fl4p/o2-probe/hw/plans/README.md

# PCB plans

- [Rev B 86 mm cable-end compaction](../docs/2026-09-12-revb-86-compaction.md) — implemented;
  3 mm shorter than the accepted 89 mm board, with all components, routing and holes retained.

- [Current Rev B schematic and process adaptation](../docs/archive/2026-09-12-pcb-plans/REVB-AISLER.md) — implemented and archived;
 83-component circuit, 20 × 89 mm outline, user trace/spacing/via overrides.

- [Rev B 89 mm power compaction](../docs/REVB-89-POWER-REVIEW.md) — implemented
  review candidate; LDO block on back, power section shortened by 4 mm.

- [Rev B 93 mm tip trim](../docs/REVB-93-TIP-REVIEW.md) — removes another 2 mm
  from the tip; component/slot locations retained.

- [Rev B 95 mm compaction](../docs/archive/2026-09-12-pcb-plans/REVB-95MM.md) — implemented review candidate;
  mechanical acceptance and physical qualification remain open.

- [Optional Rev C heated ring](REVC-HEATED-RING.md) — **deferred, not approved**.
  J5/F3 design, exact recovery revision and unresolved qualification work.
- [Archived earlier PCB plans](../docs/archive/2026-09-09-pcb-plans/README.md).
