fl4p/o2-probe/hw/fab/o2-probe-rev-b-2959d79e8b31d893/plans/README.md

# PCB plans

- [Optional Rev C heated ring](REVC-HEATED-RING.md) — **deferred, not approved**.
  J5/F3 design, exact recovery revision and unresolved qualification work.
- Earlier PCB plans: `docs/archive/2026-09-09-pcb-plans/README.md` in the source repository.
