fl4p/o2-probe/hw/routing/revb-86/evidence/workflow/README.md

# Export calibration evidence

These are byte-preserved receipts and the diagnostic used under `checks/revb-86-workflow/`. To rerun the diagnostic, copy `calibrate.py` back to that directory and invoke it with KiCad bundled Python from the project root. Its relative-path lookup intentionally matches the original execution location. Temporary mutated boards and lifecycle reports belong under ignored `checks/`, not this archived evidence directory.
