fl4p/o2-probe/hw/routing/revb-current/evidence/3v3-neck/README.md

# 3V3D neck completion

Frozen `adapter.py` SHA-256: `c0f79b11af3c90a8fcb7522718119eedc1f7a36ffe16d515e0ccfcd0e3119bbc`.

The rounded slot cap closes the apparent right-edge routing lane. The top-right back-side guard feed also blocked access to the usable neck corridor. The root authorized removal of that redundant feed after establishing the existing bottom bridge between the two front guard rails.

The exact delta removes only B.Cu guard track `1ed5e83e-bc47-4eac-ab25-4dd23013a437` and via `1f373dc5-9473-45cb-aca9-f01226c9c1eb`. All seven front guard tracks, including the original upper feed stub, remain unchanged. The bottom bridge and both bottom vias retain the right rail's connection to the driven guard.

Seven locked 0.15 mm tracks and one locked 0.4/0.2 mm via connect `/3V3D`: from the REF input branch through its open front body corridor to `(115.5,114.4)`, then on B.Cu through `(115.5,115.7)`, `(112.8,115.7)`, `(111.4,117.1)` and `(111.4,119.3)` to the existing `(111.5,119.3)` endpoint. The existing lower supply track remains unchanged. `/+12V_SW` is assigned the right B.Cu lane by the root and is outside this delta.

Full native refill/save DRC with `--all-track-errors --severity-all`: zero electrical/geometric errors and only the pending `/+12V_SW` connection open. `saved-verification.json` confirms persisted retained net names, unchanged pad net mapping, identical front guard track geometry, and one native copper-contact component containing all 29 remaining guard copper objects. The added via overlaps no SMD land. Private-directory footprint-library configuration errors and unrelated warnings are not claimed cleared. The independent reviewer owns final combined thermal/guard coverage approval.
