fl4p/o2-probe/hw/fab/o2-probe-rev-b-0c6dbe69dcaf3f52/o2-probe-drill-report.txt

Drill report for o2-probe.kicad_pcb
Created on 2026-09-09T17:15:23

Copper Layer Stackup:
    =============================================================
    L1 :  F.Cu                      front
    L2 :  B.Cu                      back

Drill file 'o2-probe-PTH.drl' contains
    plated through holes:
    =============================================================
    T1  0.150mm  0.0059"  (236 holes))
    T2  0.200mm  0.0079"  (5 holes))
    T3  0.250mm  0.0098"  (39 holes))
    T4  0.850mm  0.0335"  (6 holes))
    T5  1.320mm  0.0520"  (3 holes))

    Total plated holes count 289

Drill file 'o2-probe-NPTH.drl' contains
    unplated through holes:
    =============================================================
    T1  0.991mm  0.0390"  (3 holes))
    T2  2.200mm  0.0866"  (4 holes))
    T3  3.000mm  0.1181"  (1 hole)  (with 1 slot)

    Total unplated holes count 8
