fl4p/o2-probe/hw/fab/o2-probe-rev-a-fab/o2-probe-drill-report.txt

Drill report for o2-probe.kicad_pcb
Created on 2026-08-24T13:48:19

Copper Layer Stackup:
    =============================================================
    L1 :  F.Cu                      front
    L2 :  In1.Cu                    in1
    L3 :  In2.Cu                    in2
    L4 :  B.Cu                      back

Drill file 'o2-probe-PTH.drl' contains
    plated through holes:
    =============================================================
    T1  0.150mm  0.0059"  (152 holes))
    T2  0.200mm  0.0079"  (81 holes))
    T3  0.250mm  0.0098"  (4 holes))
    T4  0.850mm  0.0335"  (4 holes))
    T5  0.900mm  0.0354"  (3 holes))
    T6  1.000mm  0.0394"  (2 holes)  (with 2 slots, castellated)

    Total plated holes count 246

Drill file 'o2-probe-NPTH.drl' contains
    unplated through holes:
    =============================================================
    T1  0.991mm  0.0390"  (3 holes))
    T2  2.200mm  0.0866"  (4 holes))
    T3  2.410mm  0.0949"  (2 holes))
    T4  3.000mm  0.1181"  (1 hole)  (with 1 slot)

    Total unplated holes count 10
