fl4p/o2-probe/cad/CODEX-REVIEW-2026-09-05.md

## FINDINGS

1. **(c) The flattened Elegoo profile does not retain pressure advance 0.04.** The current JSON contains the Elegoo ID/vendor but no `enable_pressure_advance` or `pressure_advance`. Consequently the emitted G-code says `enable_pressure_advance = 0`; its displayed `pressure_advance = 0.02` is inactive. Orca’s official Elegoo ASA System preset explicitly supplies enable=`1`, PA=`0.04`. Thus the commit message and prompt’s “KEEPING … pressure advance 0.04” are false, and the vendor/ID guard cannot detect this omission. [filament_asa.json:114](profiles/filament_asa.json:114), [plate_1.gcode:103](print/retainer/plate_1.gcode:103), [print.sh:217](print.sh:217), [official Elegoo ASA System preset](https://github.com/OrcaSlicer/OrcaSlicer/blob/8500fcdccaa10b5099ac20d252af3a7c560046f1/resources/profiles/OrcaFilamentLibrary/filament/Elegoo/Elegoo%20ASA%20%40Syste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)

2. **(c) The guards certify a sibling G-code and later upload an unchecked archive; the wipe guard also has a mute button.** `slice` validates `plate_1.gcode`, exits, and a separate `upload` invocation sends `o2probe-*.gcode.3mf` without rerunning or binding the checks. The current loose and embedded G-code hashes match, but that is only true now; replacement or staleness between commands bypasses both new guards. In addition, `WIPE_TEMP="${WIPE_TEMP:-270}"` lets `WIPE_TEMP=250` redefine failure as success. The awk selects the first numeric `M109` anywhere in the whole block, not specifically the command before the first wipe; an unevaluable target is skipped and the later `M109 S140` is read instead. With the default 270 this still fails closed, but `WIPE_TEMP=140` turns that malformed stream green. Missing fields, ordinary wrong values, and an entirely nonnumeric block otherwise fail closed, and exact equality rejects changes in both directions. The commit records manual known-bad runs, but there is no repeatable negative fixture. [print.sh:124](print.sh:124), [print.sh:210](print.sh:210), [print.sh:229](print.sh:229), [print.sh:242](print.sh:242)

3. **(b) The spool guard assumes the declaration matches the physical spool.** That assumption happens to hold given the supplied context, and the success message honestly says “declared loaded.” But the statement that silently swapping the spool “should fail” is wrong: leaving the defaults at Elegoo/OEASAB00 while physically loading something else passes. The guard catches a wrong emitted profile against a declaration; it cannot authenticate the physical consumable. [print.sh:104](print.sh:104), [print.sh:114](print.sh:114), [print.sh:220](print.sh:220)

4. **(c) The failure explanation is a plausible hypothesis, not a supported root cause, and its provenance is wrong.** Orca’s Elegoo ASA base explicitly sets the bed to 90 °C; 80%/3 s are inherited generic ASA cooling values, while 35%/12 s/100 °C are Bambu ASA material-preset values—not “machine-side” settings selected because the P1P is enclosed. The live [Elegoo ASA specification](https://us.elegoo.com/products/asa-filament-1-75mm-colored-1kg) permits 90–100 °C, so effective 100 °C is valid for Elegoo ASA, but not for the reason recorded. The working JSON actually requests 105 °C for hot/textured plates, above both Elegoo’s range and the documented P1P limit; Orca clamps the emitted P1P stream to 100 °C. Elegoo publishes no ASA-specific maximum fan percentage; its [warping guidance](https://wiki.elegoo.com/en/troubleshooting/fdm-printer/edge-warping) only recommends disabling or reducing model/auxiliary cooling for the first 5–20 layers. Moreover, auxiliary fan speed is zero, so changing `close_additional_fan_first_x_layers` is inert. Fan and bed changes are credible remedies, but the failed prints do not isolate them from nozzle/levelling contamination, plate preparation, glue, chamber temperature, or the earlier wrong-spool-profile failure. Actual glue use and chamber temperature are unverified. [filament_asa.json:5](profiles/filament_asa.json:5), [filament_asa.json:69](profiles/filament_asa.json:69), [filament_asa.json:264](profiles/filament_asa.json:264), [filament_asa.json:338](profiles/filament_asa.json:338), [plate_1.gcode:637](print/retainer/plate_1.gcode:637)

5. **(c) The proposed “two-piece” retainer is geometrically at least three bodies and is not zero-bridge printable as described.** Making the annular groove a through-slot disconnects the Ø15.2–17.6 inner wall from the outer gland ring. Worse, the Ø26.5 membrane-seat cut removes everything under that inner wall for the first 0.24 mm, so the inner ring begins as an unsupported island rather than on the plate. The six screws are outside it and provide no registration. A separate inner ring plus outer ring plus cap might be redesigned and assembled, but that introduces another uncontrolled interface; the documented one-gland-ring/one-cap proposal does not follow from the source geometry. The acknowledged cap-interface gap is therefore not the only new error term. The roof plane itself is correctly 0.24+1.76=2.00 mm, and G-code layer 17 spans 2.00→2.12, but the prompt’s 547 count is wrong: the file has 549 linear bridge extrusions, matching the document. [GLAND-ON-THE-BED.md:90](GLAND-ON-THE-BED.md:90), [GLAND-ON-THE-BED.md:98](GLAND-ON-THE-BED.md:98), [membrane_cartridge_common.scad:645](membrane_cartridge_common.scad:645), [membrane_cartridge_common.scad:648](membrane_cartridge_common.scad:648), [membrane_cartridge_common.scad:655](membrane_cartridge_common.scad:655), [o2_probe_head_end.scad:1777](o2_probe_head_end.scad:1777)

6. **(c) The STL/source mismatch is real, and the moved parameter family is identifiable: the stale exports use the former M2.5 fastener geometry.** Assimp reproduces Ø38.70 committed versus Ø37.70 fresh, with identical face/vertex counts and Ø25.80 spigots. More decisively, rendering the current source with `pt_nominal=2.5`, `pt_pilot_d=2.1`, and `m2_clear=2.8` reproduces the committed retainer’s geometry exactly after facet-order normalization: bolt radius 15.55 and flange Ø38.70. Current M2/1.60/2.40 geometry gives bolt radius 15.25 and Ø37.70. The transition was not retained as a committed source revision—the stale STL was committed after the source had already moved—so provenance cannot reconstruct it. [GLAND-ON-THE-BED.md:151](GLAND-ON-THE-BED.md:151), [membrane_cartridge_common.scad:80](membrane_cartridge_common.scad:80), [o2_probe_head_end.scad:207](o2_probe_head_end.scad:207), [o2_probe_head_end.scad:931](o2_probe_head_end.scad:931), [o2_probe_head_end.scad:950](o2_probe_head_end.scad:950)

7. **(a) The squeeze-band arithmetic uses the wrong fitted cord and reverses the asymmetric allowances.** The model does assert 20–30% face squeeze. But Ø17.6 over Ø17.0 is 3.529% stretch, and the source’s own thinning equation gives `2.5×(1−0.035294/2)=2.45588`, not approximately 2.48. The nominal 10-point travel band is therefore 0.24559 mm. Ignoring other tolerances, nominal gap 1.82 permits about +0.1447 mm deeper or −0.1009 mm shallower—not +0.10/−0.15. With the model’s sorted-cord, ring-ID, and membrane tolerances, the actual requirement is tighter still: +0.09395/−0.05291 mm. The comment at `o2_probe_head_end.scad:2278` also reverses these values. Rejecting support remains defensible—indeed the real window is narrower—but the published derivation is wrong. [GLAND-ON-THE-BED.md:128](GLAND-ON-THE-BED.md:128), [membrane_cartridge_common.scad:432](membrane_cartridge_common.scad:432), [membrane_cartridge_common.scad:535](membrane_cartridge_common.scad:535), [membrane_cartridge_common.scad:610](membrane_cartridge_common.scad:610), [o2_probe_head_end.scad:1306](o2_probe_head_end.scad:1306), [o2_probe_head_end.scad:2278](o2_probe_head_end.scad:2278)

8. **(a) The fan formula and old algebra are correct, but the new-setting inference and S86 explanation are not.** Orca 2.4.2 first calculates slowdown, then supplies the stretched layer time to the fan interpolation. The old equation is algebraically equivalent to the source and gives `t=9.857 s`. After changing the slowdown target to 12 s, however, that old 9.857 s cannot simply be reused: the fan calculation sees post-slowdown time. Orca also rounds to an integer percentage before converting it to PWM. Its writer maps logical 34% to `M106 S86`; logical 35% maps to `S89`. Thus S86 is evidence Orca selected 34%, not quantization of a 35% ceiling. [filament_asa.json:66](profiles/filament_asa.json:66), [filament_asa.json:309](profiles/filament_asa.json:309), [plate_1.gcode:6090](print/retainer/plate_1.gcode:6090), [Orca CoolingBuffer.cpp](https://github.com/OrcaSlicer/OrcaSlicer/blob/8500fcdccaa10b5099ac20d252af3a7c560046f1/src/libslic3r/GCode/CoolingBuffer.cpp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), [Orca GCodeWriter.cpp](https://github.com/OrcaSlicer/OrcaSlicer/blob/8500fcdccaa10b5099ac20d252af3a7c560046f1/src/libslic3r/GCodeWriter.cpp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)

9. **(b) The bridge arithmetic is correct, but calling 532 versus 735 mm independent “agreement” assumes an unquantified anchor allowance.** The exact results are chord 16.4636 mm, annulus 212.882 mm², and ideal area/0.4 path 532.205 mm. Recounting the G-code gives 549 linear bridge extrusions totaling 734.77 mm and maximum move 20.1639 mm. The measured path is 38.1% longer. Anchoring and boundary paths can explain extra length, and the direct `FEATURE: Bridge` plus layer location already proves this is the roof, but 38% is qualitative consistency—not an independent quantitative corroboration until the overlap is calculated. [GLAND-ON-THE-BED.md:34](GLAND-ON-THE-BED.md:34), [GLAND-ON-THE-BED.md:39](GLAND-ON-THE-BED.md:39), [GLAND-ON-THE-BED.md:45](GLAND-ON-THE-BED.md:45), [plate_1.gcode:20784](print/retainer/plate_1.gcode:20784)

## SURVIVED

1. **Target 5:** The carrier mirror, wet-face-on-bed orientation, Ø37.70/Ø25.80 dimensions, and 5.95 mm radial overhang all follow from the source. There is no missed fifth face. Printing unmirrored with support is physically possible, but it gives a top-surface sealing face and requires support under the entire flange—the alternative already acknowledged and outside the stated bed-face constraint. [o2_probe_head_end.scad:1737](o2_probe_head_end.scad:1737), [o2_probe_head_end.scad:2251](o2_probe_head_end.scad:2251)

2. **Target 7, temperature edit itself:** `270−20=250`; obtaining a 270 °C wipe through the stock expression needs a 290 °C initial layer, above the profile’s 280 °C ceiling. The literal replaced the mouth-wipe occurrence, while the earlier shrink/shake occurrence remains formula-driven. The emitted stream contains the literal 270 at the intended point. [WIPE-TEMP.md:12](profiles/WIPE-TEMP.md:12), [WIPE-TEMP.md:40](profiles/WIPE-TEMP.md:40), [filament_asa.json:279](profiles/filament_asa.json:279), [machine_p1p.json:135](profiles/machine_p1p.json:135)

3. **Target 8:** The reported Ø38.70 committed-STL versus Ø37.70 fresh-source mismatch, identical spigot, and identical mesh counts are real. The additional review identifies the stale geometry as the former M2.5 fastener parameter set.
