fl4p/o2-probe/docs/PLAN.md

# O2 Probe PCB — SGX-OX-ROHS-Mini buried compost probe

## Context

`research/COMPOST-O2-SENSORS-BUDGET.md` in the **compostlab** repository (this
repository is a submodule of it) selected the SGX-OX-ROHS-Mini (46,20 €, −40…+60 °C,
biased 3-electrode EC cell) as the DIY scale-out cell, conditional on a heated
port: the buried probe conducts heat outward, so every surface otherwise sits
below the dew point of 100 % RH pore gas, and the cell's *continuous* rating is
only 15–90 % RH. This project builds that probe: cell + potentiostat AFE +
closed-loop ΔT heater + environment channels, as a Modbus RTU slave on the
existing farm RS485 bus. First deployment validates against the heated Apogee
reference per the report's first-experiment plan.

**Decisions locked with Fab:** LMP91000 AFE · probe-side MCU + RS485 Modbus
(4-wire farm convention: brown +12 V, white GND, green A, yellow B) · single
12 V feed (SDI-12-LB supply or PSU; design input 7–15 V) · closed-loop
membrane-ring heater (RH-primary, PWM) · one TMP117 at the warm tip with a
hardware heater-off ALERT path ·
SHT45-AD1F (**polyimide** membrane variant — not PTFE; corrected per Codex
review, matters for the NH₃ question) as a ±3–5 %RH condensation-margin
**health channel**,
not a calibrated hygrometer (datasheet: >80 %RH long-term gives ~+3 %RH
standing offset) · **no SCD41** — pore CO₂ (mean ~17.7 %, up to 75 %) pins its
4 % output cap permanently (compostlab `research/COMPOST-GAS.md:230`); replaced by an **expansion
connector** (12 V, 3.3 V, I2C, spare UART) on the sealed side for a future
SenseAir K33-ICB 0–30 % CO₂ head (51×57 mm module — needs its own housing) ·
DNP barometer footprint (BMP390).

Plan + review log live here (`farming/o2-probe/`). KiCad project target:
**`/Users/fab/dev/ee/hw/o2-probe/`** (the hw repo, beside tmp117-probe);
Phase 2 links/copies this plan there.

### Companion documents

This file is the plan of record. Where a subject grew past a bullet it moved to
its own document, and **each of these carries decisions or retractions that this
file does not repeat**:

| document | subject | why you must read it |
|---|---|---|
| [`MEMBRANE.md`](MEMBRANE.md) | membrane, seals, enclosure material | the sealing stack and the O-ring decisions |
| [`CONDENSATION-MODEL.md`](CONDENSATION-MODEL.md) | dew-margin physics | the reason the heater exists |
| [`PROTOTYPE-RESPONSE.md`](PROTOTYPE-RESPONSE.md) | response time | the gas-volume budget |
| [`HEATED-SPREADER.md`](HEATED-SPREADER.md) | the membrane heater | **§0: J5's ring is orphaned by the end-window head — the two head variants do not admit the same heater** |
| [`POTTING.md`](POTTING.md) | potting compound and process | **§1: the per-board VREF trimmer is dropped — it cannot coexist with a potted board and a swappable cell** |
| [`CONTACT-CORROSION.md`](CONTACT-CORROSION.md) | gas attack on contacts | **§3: the ENIG rationale in this project was wrong and is retracted** |
| [`reviews/`](reviews/) | adversarial reviews | the evidence behind the retractions |

Three claims in the older parts of *this* file are superseded by the documents
above and have not been rewritten in place — the AFE trimmed-VREF option
(`POTTING.md` §1), the heated-ring tip interface (`HEATED-SPREADER.md` §0), and
the sufficiency of ENIG plus selective conformal coat (`CONTACT-CORROSION.md` §3).
Treat the companion document as authoritative where they disagree.

## Architecture

**One elongated 4-layer PCB with potted and gas zones separated by an assembly
potting datum** (silkscreen "POT TO HERE" line), followed by two horizontal
6.75 × 1.5 mm thermal-break slots at absolute y=134 mm and a full-width 2 mm
zone-fill gap on every copper layer.
Two-PCB head/body was rejected: an inter-board
connector adds a leakage path exactly where sub-µA integrity matters and
doubles the sealing problem.

```
[cable]── POTTED ZONE ──────────────────────────────┬─dam─┬── GAS ZONE ─────[tip]
  pads → protection → buck/LDOs → MCU + RS485      │       │ SGX-OX cell (socketed)
  expansion + programming                             │       │ SHT45 + one TMP117
  trimmed VREF → LMP91000 → ADS1119                │       │ 2×2512 + heater FET
  driven guard around CELL_RE                         │       │ heated ring lands [tip]
```

### PCB outline (controlled layout datum)

Working KiCad design:
[`o2-probe.kicad_pcb`](/Users/fab/dev/ee/hw/o2-probe/o2-probe.kicad_pcb)
with [placement notes](/Users/fab/dev/ee/hw/o2-probe/PLACEMENT.md). The board is
schematic-linked and electrically routed; provisional mechanical interfaces are
called out in the notes. The working KiCad board is authoritative for the
bare-board first article. Freeze production geometry only after a paper print
plus a 1:1 dummy-board fit in the
actual 32 mm tube, with the cable termination, expansion connector, cell,
membrane carrier, and potting fixture installed.

Coordinate system: view from the component side, cable end at `y = 0`, probe tip
at `y = 107`, board centreline at `x = 10`. All dimensions below are mm.

```
                20.0
       x=0  ┌──────────────┐  x=20
            │ cable pads   │  y=0
            │ protection   │
            │ power / MCU  │  POTTED: y=0…82
            │ RS485 / AFE  │
            ├- - POT TO - -┤  y=82 datum
            │  dam / neck  │  TRANSITION: y=82…86
            ├──────────────┤
            │ heated tip   │
            │   ┌──────┐   │
            │   │  O2  │   │  cell centre (10,93.5)
            │   │ cell │   │  GAS: y=86…107
            │   └──────┘   │
            │ SHT45 TMP117 │
            │ring edge pads│
            └──────────────┘  y=107
                 tip
```

- **Outer `Edge.Cuts`:** 20.0 × 107.0 with nominal R2 cable-end corners and a
  square gas-side end. FR-4, 4 layers, 1.0 mm thickness; a different thickness
  is allowed only after the tube chord/assembled-height check. The 20 mm width leaves nominal 4 mm
  radial clearance per side in the ≈28 mm tube ID, but this is not a component
  height allowance: verify the complete swept envelope in section and include
  tube-ID tolerance, board bow, solder joints, coating, and potting flash.
- **No PCB mounting holes in Rev A.** The board is located by the end-cap/potting
  fixture and non-metallic tube guides. Do not add a screw beside the AFE or
  create another axial leak path merely to retain the PCB.
- **Potting datum:** `y = 82.0`, controlled on both source legend layers with
  `POT TO HERE` and an unbroken transverse line. Rev-A first articles omit
  physical legend, so the included fabrication/assembly drawing and potting
  fixture own this datum. Reserve `y = 80…86` from ordinary parts. The actual
  removable dam clamps around the PCB at this datum; its seal land and the
  cable-side meniscus must finish at or beyond `y = 82`, while every AFE
  high-impedance node remains on the potted side.
- **Thermal-break slots:** the potting boundary remains an assembly datum, not
  an `Edge.Cuts` feature. Two 6.75 × 1.5 mm horizontal slots follow at absolute
  y=134 mm, centred at x=104.125 and 115.875 mm, leaving 0.75 mm edge webs and
  a 5 mm centre neck. The accepted copper uses the 0.20 mm project copper-to-
  edge floor and the exact KiCad shove-routed corridors around both slots. A
  named rule area blocks zone fill on F.Cu, In1.Cu, In2.Cu, and B.Cu across
  y=133…135 mm.
  The In2 GND zone is therefore saved as two regions and joined only by one
  explicit 0.15 mm bridge through the left web. The gas-side B.Cu island has a
  solid `/HEATER_LOW` spreader. The SGX footprint adds a separate 3 × 6 mm NPTH
  rear-flow oblong.
- **The cell is socketed, never soldered (2026-09-01).** DS-0637 (Iss. 1 and
  Iss. 2) is silent on this, but the same-platform 4-series sheet is not:
  **DS-0317 Iss. 2, note 3 — "Do not glue or solder to the connector pins as
  this may damage the sensor and thereby invalidate the warranty, please use
  PCB sockets."** Note 8 of the same sheet adds: degrease the board before the
  sensor is fitted. This is not a footprint detail — it changes
  five things below (footprint, z-stack, pin thermal path, RE leakage surface,
  assembly order) and one thing in the firmware (§Firmware sketch: settling
  after a swap). It also *agrees* with the plan's own framing: the cell is a
  consumable replaced at service intervals (`--calibrate` audit list, risk 7),
  which soldered pins quietly contradicted. Hand-solder heat next to a 60 °C-max
  electrolytic part disappears as a risk at the same time.
- **Cell pin geometry and the selected receptacle (researched 2026-09-01).**
  DS-0637 Iss. 2's dimension drawing gives the Mini's pins as **Ø0.64 mm,
  4 mm long, three in a straight row at 2.54 mm pitch, row offset 2.50 mm from
  the body centre** (blanket tolerance ±0.15 mm; C/R/W left-to-right in bottom
  view). This is **not** the 4-series pin — DS-0317 Iss. 2 gives Ø1.50 × 4.40 on
  a Ø13.50 PCD — so the 4OX and the Mini need different sockets and the 4OX
  outline is a mechanical stand-in only, never a socket source.
  SGX's note-4 FAQ answer ("What is the recommended way to connect the
  Electrochemical sensor?") links **Cambion** socket pages for Series 4, Series 7
  and PS1 — and **nothing for the Mini-series**, so there is no vendor
  recommendation to inherit for this cell; the FAQ's Series-4 link resolves to
  Cambion 450-3326 (for Ø1.52–1.57 mm pins), which is the 4-series part.
  **Selected candidate: Cambion 450-3703-01-03-00** — same family and vendor as
  SGX's own recommendation, and the only listed member specified *at* the Mini's
  pin: "Solder mount socket, for .025 (0,64) diameter pins". Copper body and
  heat-treated beryllium-copper spring, **-03 = gold over nickel on both**
  (take -03; -04/-06 put electro-tin on the body). Geometry that the layout must
  use: **mounting hole Ø1.40 ±0.03**, barrel Ø1.35, **3.61 mm below the flange**,
  flange 0.51 mm thick × Ø1.88, overall 4.12 mm. Farnell DE 2066532, 55 in stock
  at €32.71 per 100 (ex VAT) on 2026-09-01, 7-week factory lead time; also
  DigiKey and Anglia.
  **DigiKey second source (DigiKey does not carry the Cambion at all — 0 hits
  for `450-3703`, and the old US marketplace listing is dead): TE Connectivity
  AMP 5050462-2, DigiKey A32382-ND**, €0.84 @1 / €0.667 @25, 33 800 in stock,
  MOQ 1, gold 30 µin over beryllium copper, **−65…+126 °C** (a real vendor-side
  attribute, which the Cambion lacks). Mounting hole Ø1.32, flange Ø1.77
  (1.77 at 2.54 pitch is *better* spacing than the Cambion's 1.88). Two
  caveats: its acceptance is a **band, .014″–.026″ (0,36–0,66 mm), so the 0.64
  pin sits near the top** rather than at a designed nominal; and its socket
  depth is **4.19 mm against the Cambion's 3.61**, which makes the back-face
  protrusion worse, not better. TE's customer drawing (C-5050462 rev P) settles
  the "open bottom" question: the family splits by bottom type, **-2 = open
  bottom / gold, -8 = closed bottom / gold, -7 = closed / tin**. The closed-bottom
  gold part is the one that keeps condensate from having a straight path through
  the board at CELL_RE — and it is the one DigiKey does **not** stock (0 on hand;
  33 800 of the open-bottom -2).
- **Both candidates are ordinary THT solder-mount, so the cell barely moves in
  z — but the pin may not let it seat.** Above the board the Cambion adds only
  its **0.51 mm flange** (Ø1.88), and the TE only a thin top flare (Ø1.78 max,
  thickness not dimensioned on the drawing): the can lands at ≈8.8 mm either
  way. The z that matters is downward — 2.61 mm (Cambion) or ≈3.5 mm (TE) of
  barrel out the back of a 1.0 mm board.
  **The open question is axial, not vertical.** The cell pin is 4 mm long.
  TE explicitly specifies **4.19 mm MAX PIN LENGTH** and a **2.54 mm MIN contact
  point**, so a 4 mm pin engages properly with 0.19 mm to spare. Cambion states
  no maximum pin length, and its bore is only about 3.6–4.1 mm deep behind a
  closed base — so the cell may end up **resting on its pin tips instead of on
  the three flanges**, which both raises z unpredictably and puts the cell's
  weight on the contacts. Measure seated height with a real cell in a real
  socket before the footprint is frozen; if the Cambion bottoms out, the fix is
  the open-bottom TE part or a counterbored hole, not a shorter pin.
- **Socket land, set 2026-09-01 — TE primary, Cambion borable.** The Rev-A
  footprint carried Ø1.6 lands on a **0.9 mm** drill: a bare-pin hole for the
  forbidden soldered mount. It becomes **Ø2.0 land on a 1.32 mm drill**, sized
  for TE 5050462 (its drawing asks 1.32 +0.10/−0.00 for hand insertion, a
  one-sided tolerance a fab can actually hold; Cambion's ±0.03 is tighter than
  a normal plated-hole tolerance and must be respecified one-sided if used).
  The land is deliberately larger than either flange so **the same board can be
  bored out to 1.40 and take the Cambion instead** — a build-time choice, not a
  respin. What that costs, all still inside the project rules:
  | | at Ø1.32 (TE) | bored to Ø1.40 (Cambion) | floor |
  |---|---|---|---|
  | annular ring | 0.34 | 0.30 | — |
  | copper beyond the flange | 0.11 (TE 1.78) | 0.06 (Cambion 1.88) | ≥0 |
  | land-to-land at 2.54 pitch | 0.54 | 0.54 | 0.15 |
  | drill-to-drill | 1.22 | 1.14 | 0.25 |
  | **pad-2 copper to rear-slot edge** | **0.30** | **0.30** | 0.20 |
  The last row is the one that moved: it was 0.50 with the Ø1.6 land, and
  `audit_pcb.py`'s `SENSOR_APERTURE_PAD_GAP` now asserts 0.300 instead. The
  margin over the 0.20 hole-clearance floor is halved, so **the rear slot may
  not drift gasward-negative from y=145.3 without re-deriving this number**. If
  a later revision wants the margin back, move the slot ~0.3 mm gasward — it
  still spans the cell rear axis — rather than shrinking the land.
  The land also forced the tip reroute that landed the same day: `/I2C_SCL` on
  B.Cu now threads the pin row at **x=111.345**, 0.30 mm from the CELL_WE land
  and 0.15 mm from CELL_RE — the corridor between the two lands is only 0.54 mm
  wide, and that is the whole of it. **No further copper may enter the pin row.**
  Any future widening of the land, or any second signal needing to cross there,
  has to move SCL out of the row entirely (left of CELL_CE, since `/+12V_SW`
  owns the right-hand side).
  **Rejected: Mill-Max 0305** (e.g. `0305-0-15-80-47-27-10-0`) — its stated
  acceptance is **.025″–.037″ (0,635–0,940 mm)**, so a 0.64 mm pin sits 5 µm
  above the *minimum* of the range, the low-force edge, and any negative pin
  tolerance falls out of it entirely; its shell is also brass with a matte-tin
  outer plating, the wrong pair of metals to bet on in warm NH₃-bearing
  condensate. The Mill-Max series that does fit the pin comfortably is **0327**
  (.022″–.046″ / 0,559–1,168 mm), but its **Ø1.93 mm mounting hole leaves only
  0.61 mm of board between holes at 2.54 mm pitch** against Cambion's 1.14 mm —
  keep 0327 as the second source, not the first choice.
- **Cell orientation — DECIDED 2026-09-05 (Fab): option A, standing.** The cell
  stays a normal THT part on the board, axis normal to the copper, gas face
  radial — i.e. Rev A as built, not a change to it. `cad/o2_probe_head_end.scad`
  carries it as `cell_mount = "standing"` and the end-window head was rebuilt
  around it: the Ø16.62 × 13 mm neck that option C needed is deleted, the board
  tip lands on the well floor, the head is 21.3 mm instead of 34.3, and the
  connected volume is 2.93 cm³. **What the decision does NOT close** is A's own
  two costs, both still live below: the ≈2.6 mm of socket barrel out the back of
  the board, and the three-contact thermal path to the cell. `RING-PCB.md` was
  written against option C's neck and is superseded — see its status header.
  The A/B/C discussion below is kept as the reasoning, not as an open question.

  Rev A as drawn stands the cell on the board, axis normal to
  the copper, gas face radial. Two motives argue for laying it down instead:
  it deletes the 3 × 6 mm rear-vent aperture and everything that hangs off it
  (plane splits, copper-keepout-is-not-flow, "aperture vs standoff"), because
  both cell faces then sit in free gas; and it is the only mounting that lets
  the can be **thermally bonded along its side to the heated island** instead
  of coupling through three contacts, which is the cold-spot failure mode named
  in §Firmware sketch. The three variants, with the constraint that decides
  between them:
  - **A — standing (Rev A as drawn).** With the selected Cambion receptacle the
    height above the board is only ≈ 8.3 (can) + 0.51 (flange) ≈ **8.8 mm** —
    comfortable on a 1 mm board on the tube centreline (≈13.5 mm per side in a
    28 mm ID). **The cost is on the other face:** the barrel is 3.61 mm long
    below the flange, so **≈2.6 mm of socket protrudes out the back of a 1.0 mm
    board**, at three points inside the heated tip — directly into the B.Cu
    `HEATER_LOW` spreader and next to the 3 × 6 mm rear-vent slot. Rev A must
    either keep-out and re-route that copper, or move to a thicker board (which
    is gated on the chord check above). A also keeps the rear-vent aperture and
    the weak three-contact thermal path.
  - **B — lying on the board.** Height ≈ **14.4 mm (the can diameter) plus
    cradle standoff**, so it does **not** fit a centred board. It only closes
    if the board moves onto a chord — 9.8 mm off centre for a 20 mm width,
    giving 23.8 mm on the cell side — and that chord is not free: it contradicts
    the "nominal 4 mm radial clearance per side" above and disturbs the x=0/x=20
    ring castellations that feed the membrane heater. **B is therefore a
    board-off-centre decision, not a socket decision**, and must be priced as
    one (swept envelope, ring interface, potting fixture) before it is chosen.
  - **C — past the board end, axis along the tube.** The cell sits in the tip
    gas volume, cradled by the enclosure, pins reaching back into ordinary
    vertical receptacles at the tip; both faces clear, the 5 g can carried by
    the tube rather than the contacts, and no board-height term at all. This is
    the variant to cost first if A's rear aperture or thermal path proves
    unacceptable.
  **Independently of A/B/C: do not lay a barrel receptacle flat on copper.** It
  has no land pattern and no retention, the mating force becomes shear on a
  fillet under a cylinder (line contact), and it puts the separable CELL_RE
  contact flat against the board — a low-standoff capillary crevice on the one
  node the driven guard exists to protect. If the mating axis must be parallel
  to the board, use right-angle receptacles retained in plated holes, or a 90°
  carrier tab soldered into edge castellations (the heated-ring interface
  already establishes that pattern).
  **Gate:** the socket geometry is now sourced (see the receptacle bullet) and
  A's height is no longer the open question — the back-face protrusion is.
  Confirm it, and the cell's own standoff over the flange, on a physical cell
  and socket before freeze.
- **Primary cell datum:** SGX-OX-ROHS-Mini body centre `(10.0, 93.5)`, body
  envelope **Ø14.62 measured 2026-09-04** (DS-0637 Iss. 2 nominal is Ø14.4; the
  measurement supersedes it, and `cad/o2_probe_head_end.scad` is cut to it). One
  sample, so it is a value and not a tolerance band. `cell_h` is still the
  datasheet's 8.3 and was NOT re-measured while the can was in hand. Rotate it with the three-pin row toward
  the dam/AFE. The pitch and row offset still come from the datasheet (2.54 mm
  pitch, 2.50 mm pin-row offset), but the *holes* come from the chosen
  receptacle's mounting-hole spec, not from the cell pin diameter, and the
  courtyard must clear the receptacle body (Ø ≈ 1.5–2.0 mm at 2.54 pitch is
  workable but is not free). Verify both against a physical sample — cell and
  socket — before production release.
  Keep a Ø15.0 courtyard free of unrelated parts and preserve access to the top
  gas face.
- **Rear gas path:** plated-copper-free 3 × 6 mm NPTH slot centred at
  `(10.0, 95.3)`, offset 1.8 mm gasward from the cell centre while spanning its
  rear axis. The nearest slot edge is 0.50 mm from the pad-2 copper edge —
  **re-derive this from the receptacle land, which is larger than the pin pad
  it replaces.** The
  Issue 2 datasheet does not dimension the rear port, so this is an
  explicit first-article fit/flow feature rather than an invented port diameter.
  ~~Confirm the opening against a physical sample before production release.~~
  **MEASURED 2026-09-04 (Fab), closing this item:** the rear vent is **Ø3.2 mm**,
  and its edge furthest from the pins sits **4.7 mm from the can edge** — so with
  the measured Ø14.62 can, the vent centre is **1.01 mm off the can axis, away
  from the pins**, and its near edge clears the pin row (2.50 mm offset) by
  1.91 mm. Three consequences:
  - **The 1.8 mm gasward slot offset is 0.79 mm off the real vent.** The vent
    still falls inside the 6 mm slot length, so nothing occludes lengthwise.
  - **The slot is 0.2 mm too NARROW.** 3.0 mm across against a Ø3.2 vent clips
    0.15 mm² — 1.9 % of the port, immaterial for flow but a literal violation of
    this bullet's own `DO NOT OBSTRUCT`. Widen to ~3.6 mm if the slot is kept.
  - ~~**In cell-orientation option C it is probably not needed at all.**~~
    **The escape closed on 2026-09-05: option A was chosen, the cell stands, and
    the rear vent is needed.** The end-window head no longer has a neck for the
    back face to breathe into — the board tip sits on the well floor and the can's
    rear face is against the board. So the slot stays, and the two defects above
    it (0.79 mm offset, 0.2 mm too narrow) are live items for the respin rather
    than things option C might have deleted.
  Mark the controlled drawing `DO NOT OBSTRUCT`; solder mask/copper keepouts
  alone do not satisfy this.
- **Heated-ring tip:** RH1 and RH2 sit on the back at `(5,96.5)` and
  `(15,96.5)`. U12 is at `(3.5,101.5)`, U10 at `(10,102.525)`, and the DNP BMP390
  option at `(16.5,101)`. J5 provides two 2.0 × 3.0 mm PTH pads centred on the
  left/right board edges at `(0,105.5)` and `(20,105.5)`. Their 1.0 × 2.0 mm
  plated slots are explicitly marked castellated and bisected by the finished
  side profile. Both pads are joined by wide back copper on switched
  `HEATER_LOW`; the metal ring is a thermal
  spreader, not an electrical jumper. It must remain on the insulated dry side
  of the PTFE membrane stack.
- **Warm-tip sensing:** there is one TMP117, 2.975 mm from the J5 centreline. Its
  ALERT directly clamps the heater gate off. It is not a substitute for
  membrane cold-spot thermometry: qualification must temporarily instrument
  the membrane/carrier minimum and identify its mapping from U10, heater power,
  inlet state, and orientation.
- **Short gas end:** the square end stops at `y = 107`; the SGX centre is
  13.5 mm from that end. The enclosure, ring, and membrane carrier set the
  actual cell-to-membrane distance. Verify it on a 1:1 tube coupon.
  **The socket lifts the can ~2–3 mm off the board**, so receptacle seated
  height and its tolerance enter this distance and the assembled-height/chord
  check directly, and they enter the head volume in
  `cad/RESPONSE-CANDIDATE-VOLUME.md`. Measure the seated height of the actual
  receptacle + cell pair; do not take it from a drawing.
- **Cable end:** reserve the first 8 mm (`y = 0…8`) for four staggered solder
  pads, water-blocking/strain-relief geometry, and polarity silkscreen. Copper
  and components may not project beyond the outline. Expansion-connector height
  is checked against the circular tube chord; use the documented pad-field
  fallback if the Micro-Fit swept envelope does not close.
- Put the outline, pot datum, cell centre, rear aperture, ring castellations, and
  maximum assembled-height/chord check into `DESIGN.md` as controlled dimensions.
  `audit_pcb.py` must reject an open/deformed outline, an unexpected or
  deformed board-native slot,
  moved/missing gas aperture, missing pot line, stale second-sensor copper,
  moved, deformed, or unplated ring castellations, narrow ring-heater copper, or a
  missing/unfilled continuous GND plane.

- Gas zone: selective conformal coat (apertures clear); cannot be potted.
- Potted zone: potted solid — covers LMP91000, the C/R/W traces, everything
  cable-ward. Potting is also the cable strain relief (no connectors buried).
- **LMP91000 placement:** potted side, <10 mm from cell pins. Leakage scale
  corrected per Codex (arithmetic verified): the threat is not pA — 0.1 % O₂
  ≈ 335 nA, so ~1.8 MΩ of wet contaminated surface across 600 mV already
  produces that error; a condensed pin escape is plausibly in that range.
  Error budget therefore targets **wet-board leakage into WE/RE/CE, flux
  residue, pin creepage** — controls are cleaning/bake/coat/pot process (with
  a leakage test coupon) plus a **driven guard**: guard the RE trace from a
  low-impedance replica of the RE target potential (≈0.91·VREF at the chosen
  internal zero; buffered divider). **A grounded guard is rejected** — with
  V_RE ≈ 2.275 V it maximizes the surface voltage instead of minimizing it.
  Guard potential is specified before layout, not deferred. No mask relief or
  vias on the RE trace.
  **The socket makes this harder, not easier.** A serviceable cell means the pin
  escape can never be potted and the mating interface can never be coated: the
  highest-impedance node in the design now ends in a bare separable contact
  inside a condensing volume — exactly the "condensed pin escape" that the
  ~1.8 MΩ / 335 nA arithmetic above says is enough to fake 0.1 % O₂. Therefore:
  the driven guard extends to the CELL_RE receptacle land (guard ring on the
  component side around it, not stopping at the trace); the leakage test coupon
  must be measured **with a socket fitted, after the soak**, not on a soldered
  coupon; and surface-insulation resistance across the seated contact is a
  qualification measurement, not an assumption. If it does not close, the
  fallback is a locally sealed/greased socket boot or a serviceable pigtail with
  the cell held off-board — decided from the coupon measurement, not now.
- **AFE bias verdict (Codex, to re-confirm from LMP91000 Rev. I in Phase 1):**
  the 24 % bias step exists and BIASSIGN gives V_WE−V_RE < 0, but the step
  tolerance is **±2 % of VREF = ±50 mV at 2.5 V** against the cell's ±10 mV
  window → **fixed 2.5 V VREF is rejected.** Phase 1 decides between (a)
  per-board trimmed VREF (~2.31–2.73 V trim range, test points, trim measured
  as V_WE−V_RE with the real cell connected — viable for 3 prototypes) and
  (b) the discrete potentiostat (zero-drift op-amp pair), now co-equal rather
  than fallback. Also from the review: SGX's "−600 mV" sign convention is
  unstated — the vendor confirmation is necessary, not ceremonial; CE
  compliance is unspecified by SGX → bench-measure V_CE at 0 %/air/30 % over
  temperature.
- Membrane-ring heater: ~140 Ω effective RH1/RH2 load gives approximately
  1 W ceiling at 12 V. U10 supplies warm-tip temperature and a hardware-off
  limit; SHT45 supplies chamber RH/temperature. The release target is a
  positive minimum membrane dew margin over a 0–4 K operating rise, established
  by calibration rather than a two-sensor PCB ΔT assumption.
- tmp117-probe rules carried over: **no I2C pullups on sensed islands; ADD0
  never floats.**
- Tube target: 32 mm OD (ID ≈ 28 mm) clears the 14.4 mm cell can. **Material
  decided 2026-09-02 (`MEMBRANE.md`, *Enclosure material: printed ASA*): bought
  tube for the potted body, printed ASA for the head**, released on the measured
  leak/connected-volume gate and built with no sustained strain at temperature;
  PVC-U pipe remains the body stock candidate.
  Rev-A outline = 20 × 107 mm (dimensioned above); gas window = heated
  dry-side carrier ring + **sintered-PTFE** membrane (Porex PMV15T; the vendor
  confirmed sintered, not expanded, on 2026-08-27 — see `MEMBRANE.md`) + mesh
  (enclosure work). Sintered PTFE needs no scrim backing and can be
  ultrasonically welded into a PP carrier disc, which is the preferred
  membrane-to-carrier joint. Cell faces marked DO NOT OBSTRUCT: the rear vent needs a
  **routed aperture through the PCB (or specified standoff + lateral gap)**,
  not merely a copper keepout — copper keepout provides no gas flow (Codex).
  Gas openings oriented laterally/downward with a condensate drain path; the
  membrane can be diffusion-blocked by a water film/biofilm — response time
  tested with the final mesh + membrane wetted externally.
- **Cable:** water-blocked cable or individual-conductor sealing at the pot —
  stranded conductors and jacket interfaces are capillary paths that bulk
  potting alone does not stop; soak/cross-section test in bench phase.
- **Potting process specified before assembly:** low-exotherm, low-shrink,
  low-ionic-content compound; max cure temperature; pour depth per pass;
  pre-bake/clean (WSON/DFN shrink stress and exotherm are latent-failure
  sources). **The cell goes in last, unconditionally** — it may never see
  reflow, wash, bake, or cure heat, so the sequence is: build, clean, bake,
  coat, pot, cure, electrically test with a socket shorting/dummy load, then
  insert the cell by hand. The previous "cure before mounting the EC cell where
  possible" was conditional; with a socketed, non-solderable cell it is not.
- **Deployment envelope — the cell is operated out of spec (decision
  2026-08-27):** the pile core reaches **~75 °C** in the thermophilic phase,
  above the SGX cell's +60 °C rating and outside its 15–90 %RH continuous,
  explicitly non-condensing window. We deploy there anyway; the alternative is
  no data through the hottest, most oxygen-limited phase of the process, which
  is the phase the probe exists to observe. This supersedes the 2026-08-18
  derate of the supported pile-gas ceiling to ~56–58 °C.
  Consequences carried deliberately:
  - the cell's temperature coefficient is uncharacterised above +60 °C, so
    compensation there is extrapolation, not calibration;
  - electrolyte loss and drift accelerate — the cell is a consumable, and the
    replacement interval must be set from a bench test at 70–75 °C, not from
    the datasheet life;
  - **the LMP91000, not the cell, becomes the binding hard limit** (risk 2).
  TEMP_OVER stays a **log-only** quality flag at T_gas > 60 °C and marks the
  reading as extrapolated; it no longer invalidates it. compostlab
  `research/COMPOST-O2.md` §6 treats > 60 °C as invalidating — that rule is
  deliberately overridden here.

**I2C map (conflict-checked):** 0x44 SHT45 · **0x48 LMP91000 (fixed)** ·
TMP117 at 0x49 (ADD0→V+) · ADS1119 at 0x40 (A1=A0=GND) ·
0x76 DNP BMP390 (**SDO strapped
low, CSB defined** — must not float) · 0x68 reserved for K33 on expansion.
**Bus at ≤100 kHz** (LMP91000 is standard-mode only). MENB MCU-controlled
**with defined reset state** (pullup or tied), so I2C availability is
deterministic through MCU reset.

**Expansion connector** (replaces SCD41): 8-pin — 12 V, GND, 3V3_D, SDA, SCL,
EXP_INT/GPIO, UART_TX/RX (STM32G071's second USART; degrades to GPIO if pins
run out — K33 speaks I2C anyway). On-board: Molex Micro-Fit 3.0 2×4
(−40…+105 °C) in the potted zone just above the pot line (pad-field fallback
if mated height ~10 mm doesn't clear the tube ID). Enclosure side: second
cable gland or field-sealed M12 8-pin A-coded on the end cap; blanked when
unused. K33 ICB powers from the 12 V pin (it wants 4.5–14 V — verify in
Phase 1). TVS array (TPD4E05-class) + series R on expansion signals; 3V3
expansion budget documented as a hard number (e.g. 200 mA max); I2C bus
capacitance budget for the pigtail recorded in DESIGN.md.

**ADC:** **ADS1119** (16-bit, I2C, REFP/REFN external-reference pins,
−40…+125 °C) referenced to the same 2.5 V VREF — true ratiometric. (The
originally planned ADS1115 has only an internal reference; "ratiometric
against VREF" was not implementable as written — Codex finding, verified
against the ADS1115 block diagram. ADS1114/MCP3421 share the problem.)
TIA: LMP91000 internal **7 kΩ** (internal options are 7/14 kΩ, not 10 kΩ);
full-scale headroom sized for ≥150 µA — SGX's log response with a
high-tolerance cell gives ~152 µA at 30 % O₂ (100 µA × ln(1/0.7)/ln(1/0.791)),
→ ~1.06 V excursion from the 67 % internal zero, inside 0–3.3 V. 0.1 % O₂
≈ 335 nA — comfortably resolved.

**MCU:** STM32G071CB, −40…+105 °C grade (ESP32-C3 rejected: 85 °C modules,
radio is dead weight in a buried tube). USART+DE for Modbus RTU. SWD via
TC2030 pads **plus** BOOT0 + UART header for probe-less field reflash.

**RS485:** THVD1410/SN65HVD72 class (−40…125 °C). Failsafe bias **and**
termination both DNP by default — a shared bus gets exactly one bias network
(normally at the master); per-slave bias loads the bus and can fight another
installation (Codex). **DE hardware pulldown** so the slave cannot transmit
during MCU reset; firmware Modbus rules: never transmit unsolicited, enforce
turnaround timing, survive stuck master/truncated frames.

**Power tree:** 12 V → buck 5 V (≥400 mA, fixed ≥600 kHz, shielded inductor)
→ 3.3VD (logic/RS485/sensors) and 3.3VA low-noise LDO (TPS7A20-class: VREF,
LMP91000, ADS1119). **Bias supervision (Codex — LDOs don't guarantee it):**
LMP91000 powers up in deep sleep with volatile config, and MENB only gates
I2C — a 3.3VA brownout with the MCU alive silently drops bias without a cold
boot. Firmware: periodic LMP91000 register readback, 3.3VA/brownout monitor,
and the 15-min SETTLING timer restarts on any config-mismatch or rail event,
not just power-on. **Return-path rules:** heater pulse (~86 mA) and
buck-switch loops routed to cable-entry ground away from AFE ground;
continuous plane; RC at the ADC; EMI validated with heater at 0 %,
intermediate, and 100 % duty — not only heater-off.

## Firmware sketch (register map committed to DESIGN.md)

Input regs: O2 raw (µA×100) · O2 compensated (%vol×100) · T_tip · T_chamber
(0.01 °C) · RH_margin (0.01 %) · EXP data (e.g. K33 CO₂; 0xFFFF = absent) ·
VREF/VOUT diag · pressure (0 if DNP) · heater duty · ΔT target · fault
bitfield · uptime · settle-timer · fw version.
Fault bits: SETTLING (boot, 15 min) · I2C_FAIL per device · HEATER_RUNAWAY ·
VIN_LOW · TEMP_OVER (T_gas > 60 °C, log-only) · DEW_SUSPECT ·
EXP_PRESENT/EXP_FAIL (boot-time auto-probe of reserved addresses).
Holding regs: slave addr, baud, ΔT setpoint, heater max duty, cal constants
(log-linearity K, air-point), SHT45-pulse trigger, **SETTLING restart (cell
swap)**.
**Cell swap is now a routine, in-field event** (socketed consumable), and every
extraction interrupts the bias: DS-0637 note 1 gives up to 15 minutes of
out-of-spec settling afterwards. The SETTLING flag must therefore be assertable
by the service holding register, and asserted automatically whenever the WE
current goes open/out-of-range and returns. Readings inside that window are
published as *absent*, never as low O₂ — the same rule the oxygen dashboard
already applies to missing data.
Heater control: **primary loop
regulates measured chamber RH** (SHT45, hold ~85–90 % — the actual controlled
quantity: condensation margin + the cell's 90 % continuous-RH spec). The one
TMP117 provides an independent warm-tip limit and its ALERT is a hardware-off
clamp. If SHT45 fails, firmware may run only a conservatively bounded fallback
derived from the validated membrane thermal model; otherwise safe state is
heater off and data invalid. Psychrometric screening: +2 K
gives only ~90–91 % RH on saturated gas; 85 % needs ~3.1–3.7 K at 40–65 °C —
**design the thermal path for a 0–4 K ΔT range**, not a fixed 2 K. **SHT45
placement: in the warmed cell microclimate** (same heated volume as the
cell), not at a remote unheated inlet. **Cold-spot problem:** U10 measures PCB
copper, but
the 5 g ABS cell couples via three pins and gas — the cell cap or vent can
sit at dew point while the PCB reads warm. **The socket makes that coupling
weaker still:** the receptacle lengthens and raises the resistance of the only
solid path from the heated board to the can, so the cell body runs colder
relative to U10 than a soldered part would — the wrong direction for
condensation on the can and the rear vent. The U10 → cell/membrane-minimum
mapping (`CONDENSATION-MODEL.md`, which currently reasons about "the soldered-
ring geometry") must be identified on a **socketed** coupon; a soldered thermal
mock-up would flatter the result. The ring directly heats the dry
membrane carrier; instrument the actual coldest membrane/carrier surface during
qualification. **Stuck-on safety (hardware, not firmware):** FET gate
pulldown, watchdog-bounded enable, absolute cell-temperature cutoff, heater
resistors and ring safe at 100 % duty. Use approximately 1 Hz PI, ~1 kHz PWM,
anti-windup, and a duty clamp. SHT45 heater-pulse routine (every 6–12 h + on demand): de-creep plus
dew detection — dry sensor recovers RH quickly post-pulse, wetted sensor shows
the slow-recovery signature → DEW_SUSPECT classifier; pulse + settling window
masked from the RH_margin channel; pulse duty limit per SHT4x datasheet
(exact figure verified in Phase 1).
O₂ compensation: datasheet output-vs-T curve + air-point cal; report raw AND
compensated.

## Scaffolding (reuse from tmp117-probe)

Generated schematic and deterministic PCB migration/routing, keeping the
verification discipline established by `/Users/fab/dev/ee/hw/tmp117-probe/`:

- `project_settings.py` — verbatim pattern (pcbnew `.kicad_pro` clobber guard;
  `verify()` stays a gate).
- `audit_pcb.py` + `--calibrate` inject-defect discipline — checks the RE
  guard, exact outer/thermal-slot contours, SGX NPTH, plated ring castellations, heater
  copper floor, continuous filled In2 GND plane, obsolete-sensor absence,
  cable-pads↔logic creepage, expansion-connector clearance to the potting
  line, SHT45 hand-rework accessibility (it's a maintenance consumable —
  replaced at cell-service intervals).
- Project-local footprints include the first-article SGX pattern — **a
  three-receptacle socket pattern, not solderable pin pads** — and the
  two-contact castellated heated-ring interface. `audit_pcb.py` gains a check
  that the cell footprint is the socket variant with the guard land present, so
  a regression to soldered pin pads fails the gate instead of shipping.
- TMP117 symbol/footprint from `tmp117-probe/lib/`; everything else new in
  per-project `lib/o2-probe.{kicad_sym,pretty}` (repo convention: no shared
  lib table).
- Gates: `kicad-cli sch erc --exit-code-violations`, `kicad-cli pcb drc
  --severity-all --schematic-parity --exit-code-violations`, netlist-vs-intent
  review, `project_settings.verify()`, audit pass. BOM export **without**
  `--group-by` (tmp117-probe lesson: grouping merged DNP variants).
- `DESIGN.md` skeleton: verification-status table · per-part datasheet fact
  tables with citations · partitioning rationale · AFE error budget
  (bias/VREF/TIA/leakage) · power tree · heater thermal sizing · I2C map ·
  Modbus map · mechanical/potting · risks · fab notes.

## Phases

1. **Datasheet verification (blocking).** Fetch & verify (kicad-happy:digikey
   / lcsc skills): **LMP91000** — the go/no-go: 600 mV = 24 % × 2.5 V is the
   top bias step; confirm step existence/tolerance, BIASSIGN polarity for this
   cell, 3-lead mode, VREF input range, TIA gain for 0.1 mA FS with
   log-linearity headroom (S = K·ln(1/(1−C))), internal-zero offset, 85 °C
   derating. If tolerances don't close the cell's ±10 mV bias window →
   fallback discrete potentiostat (zero-drift op-amp pair) decided HERE. Also:
   STM32G071 105 °C order code + LCSC stock, RS485 xcvr, buck, LDOs, VREF,
   ADS1119, SHT45-AD1F, BMP390, heater FET, **SGX-4OX-ROHS outline** (rear
   vent → combined footprint vs adapter), Sensirion "Handling Instructions
   SHT". **Also: the SGX-recommended socket receptacle** (DS-0317 note 4 points
   at the Gas Sensor FAQ) — part number, seated height, mounting-hole spec,
   contact plating and temperature rating at 75 °C; a gold-on-gold contact is
   the assumption to verify, since tin in a warm NH₃-bearing condensing gas is
   the wrong contact metallurgy. Send the SGX CO₂-cross-sensitivity inquiry
   (whole OX family) now, and put the socket question in the same mail.
2. **Scaffolding.** Create `o2-probe/`, copy scripts, DESIGN.md skeleton,
   `PLAN.md` (this file).
3. **Symbols/footprints.** New parts + TMP117 reuse; cell footprint.
4. **Schematic.** Blocks above; ERC gate; address/strapping asserted; AFE
   error-budget table written alongside.
5. **Layout.** **Cell orientation (§PCB outline) closes here, before freeze.**
   Zone partition, guard ring, pot datum, compact heated-ring tip; buck
   far from AFE + LC post-filter; DRC + settings verify.
6. **Audit.** Rewrite audit.py checks, `--calibrate`, record in DESIGN.md.
7. **Fab outputs.** BOM/CPL/Gerbers and capability confirmation from the
   selected fabricator; do not infer JLCPCB or any other vendor.

## Verification

- Every gate in §Scaffolding green; DESIGN.md status table complete.
- AFE error budget closes: bias within ±10 mV incl. VREF + step tolerance;
  0.1 % O₂ resolution at the ADS1119 with stated noise.
- Bench before pile (report's discriminating tests + Codex additions): 2-week
  saturated soak with condensation cycles; heater loop holds target RH/ΔT
  across the 0–4 K range; zero-check in N₂ (cell zero < 0.4 % vol spec);
  air-point cal stability; U10/ring/membrane thermal-map calibration; V_CE compliance
  measured at 0 %/air/30 % O₂ over temperature; cell orientation
  characterized (horizontal/vertical/inverted — SGX is silent; assert
  nothing untested); heater stuck-on case exercised; cable soak/capillary
  test; **socket qualification — insertion/extraction retention with the 5 g can
  unsupported, contact resistance and CELL_RE surface-insulation resistance
  measured after the saturated soak, and a full remove/refit cycle proving the
  15-min settling behaviour and the post-swap air-point**; **final calibration with the complete gas path** (membrane, window,
  chamber, heater running) — bare-cell calibration is insufficient.
- **Calibration campaign — the sequence is set by `O2-CORRECTION-MODEL-BUDGET.md`,
  not by intuition.** N₂ zero + dry air at **five temperatures spanning 10–60 °C**
  (whole probe isothermal, ≥10 min plateaus) is the load-bearing part: it is what
  turns ±1.3 %O₂ at 55 °C into ±0.05 %O₂. DS-0637 **Issue 2** publishes a
  temperature curve for the cell (≈ +0.2 %/K, not yet digitised), but it is the
  bare cell from another population — it sets the expectation, it does not
  replace a per-probe fit that also captures the AFE. The air point must be corrected to wet basis from
  logged RH and pressure; ignoring room humidity at 22 °C/50 %RH poisons the span
  by 0.28 %O₂. Blended dilution points come *after* that and are weighted by their
  reference uncertainty — they fit the zero and test the log law, and adding them
  **unweighted makes `K` up to 9× worse**, which is the one way this campaign can
  quietly fail. Two further passes have no substitute:
  a **CO₂ series** (5/10/20 % CO₂ at fixed O₂ — the 4-series figure of 0.3 % of
  signal per 1 %CO₂ is worth +0.23 %O₂ at 5 %O₂ in pile gas and is unverified on
  the Mini), and, if the fitted α turns out large, a **split-temperature pass**
  holding the AFE fixed while the cell moves — an isothermal sweep fits
  α_cell + α_AFE together, and the heater running is exactly what splits them.
- Field: probe joins the RS485 bus beside the Apogee reference per
  compostlab `research/COMPOST-O2-SENSORS-BUDGET.md` §First-experiment.

## Codex review (2026-08-18) — disposition

Adversarial review ran against the initial plan with the LMP91000/ADS1115/TMP117/
SHT4x/BMP390/K33 primary datasheets (full log:
`codex-plan-review-2026-08-18.log` beside this file).
Confirmed findings are integrated above; headline changes: fixed 2.5 V VREF
rejected (±2 % bias-step tolerance vs ±10 mV cell window) → trimmed-VREF vs
discrete potentiostat decided in Phase 1; ADS1115 → **ADS1119** (external
reference); SHT45 membrane is polyimide, not PTFE; ΔT design range 0–4 K
(psychrometrics) with SHT45 moved into the cell microclimate; grounded guard
rejected → driven guard at RE-replica potential; leakage threat re-scaled to
nA/MΩ wet-surface class; deployment ceiling derated to ~56–58 °C; RS485
bias/termination DNP + DE pulldown; bias supervision via register readback +
rail monitor; rear-vent routed aperture; potting/cable/drainage/orientation/
final-path-calibration requirements added. The later 2026-08-23 ring-tip
revision supersedes that review's two-TMP117/sensor-isolation control structure:
one TMP117 remains, the two transverse y=134 thermal-break slots remain, and
the membrane is heated directly through the manual-solder dry-side ring. The
I2C map, 3-lead LMP91000 topology/current range, 7 kΩ TIA headroom, ~1 W heater
ceiling, RH health channel, and calibrated-audit discipline remain.

## Risks / open questions

1. LMP91000 bias tolerance (±50 mV at 2.5 V vs cell ±10 mV — re-confirm from
   Rev. I in Phase 1): trimmed per-board VREF vs discrete potentiostat is the
   Phase 1 decision; fixed VREF is off the table. SGX bias sign convention
   and CE compliance unspecified → vendor question + bench measurement.
2. **LMP91000 is now the binding thermal limit.** 85 °C absolute max against
   ~75 °C pile gas plus up to ~4 K heater rise leaves ~6 K for self-heating and
   the potting ΔT (no convection). Placement away from the heated island is no
   longer sufficient on its own: compute the junction budget, and if it does
   not close, move the AFE down the tube away from the tip or go to a discrete
   potentiostat built from 105/125 °C-grade parts. Unlike the cell, this is a
   hard silicon limit, not a degradation curve.
3. SGX CO₂ cross-sensitivity answer pending — affects compensation needs.
4. ~~12 V continuity from SDI-12-LB unverified (bias must never drop); if
   switched per-poll → dedicated PSU.~~ **Closed 2026-08-31 in the dedicated-PSU
   direction.** The node actually in hand is an RS485-LS, which has no 12 V rail
   at all and gates its +5 V output with `AT+5VT` — "only powered up before each
   sampling" (`tech/dragino/DRAGINO.md`). Any per-poll rail restarts the
   15-minute settling timer every cycle, so the probe would never leave
   `SETTLING`. The probe gets its own always-on 12 V supply and shares only
   RS-485 A/B and a common ground with the node.
5. 4OX mechanical compatibility (rear vent, 20 mm can vs board width) —
   Phase 1.
6. SHT45 accelerated ageing at permanent high RH — treat as maintenance
   consumable alongside the cell; health-channel framing only.
7. Above ~56–58 °C pile gas the cell runs outside its rating. Per the
   2026-08-27 decision this is accepted rather than treated as a deployment
   constraint. Open work: bound the drift and lifetime penalty at 70–75 °C on
   the bench and set the cell replacement interval from that measurement.
8. Potting boundary quality is load-bearing for the RE leakage claim — audit
   check + assembly note. The socketed cell adds a second load-bearing surface
   the potting cannot protect (see the LMP91000-placement bullet).
9. Expansion-connector sealing: an unused mating half above the pot line is a
   condensation/creepage point — connector body in the pot with only the
   mating face proud, dielectric grease + dust cap when unused; audit check.
10. K33 form factor (51×57 mm) fits no slim tube — future CO₂ = fatter tip
    chamber or separate probe on the expansion pigtail; deferred, doesn't
    block this board. If SGX confirms CO₂ cross-sensitivity, the K33 head
    shifts from optional to required (correction input).
11. **Cell socket, opened 2026-09-01** (DS-0317 note 3 forbids soldering).
    Part selection is closed (Cambion 450-3703-01-03-00, see §PCB outline).
    Still open: the **2.6 mm barrel protrusion into the back-side heater
    copper**; whether the 5 g can needs mechanical retention against handling
    and burial loads so the three contacts never carry it; SIR across a seated
    contact after the saturated soak; and Cambion's temperature rating —
    DigiKey lists −55…+125 °C for this part but **Cambion's own TDS states no
    temperature range**, so that figure is a distributor attribute, not a
    vendor spec, and is a question for Cambion. Contact *resistance* is not the
    worry — 100 µA into a virtual ground makes even 1 Ω a 100 µV error, and RE
    carries no current; the worry is the un-pottable separable surface and the
    retention. Note also the drawing revision drift: an older archived copy of
    the 450-3703 TDS gives the mounting hole as .057 (1,45) against the current
    (19-Aug-2025) .055 (1,40) — use the current sheet and verify on a sample. Cell
    orientation (standing / lying / past the board end) rides on the same
    sample measurement — see the orientation bullet in §PCB outline.
12. SHT45 NH₃ compatibility — **resolved (2026-08-18, adverse but managed)**:
    Sensirion "Handling Instructions SHTxx" (June 2025, archived in
    `datasheets/` in the **compostlab-literature** repository, SHA `80be25d`) §1.3 lists **NH₃ among chemicals
    that can irreversibly damage the sensor**, with no concentration
    threshold; §4 puts validation burden on the user and notes low-level
    corrosives spare the element but corrode solder contacts → passivate
    contacts (conformal coat over pads, aperture clear). Mitigation stands:
    polyimide-membrane AD1F variant, replacement-interval framing, and the
    §4 reconditioning recipe (bake 100–105 °C < 5 %RH 10 h, re-hydrate
    ~75 %RH 12 h over saturated NaCl) as the service procedure for pulled
    probes. Treat NH₃ damage as a when-not-if wear item in manure-rich
    piles; the TMP117-vs-SHT45 disagreement channel is the failure detector.
    **Re-filed 2026-09-04 — this is not only an SHT45 note.** Sensirion's "low-
    level corrosives … corrode solder contacts" applies to **every joint in the
    gas zone**, and it was recorded here under the wrong heading. The gas-zone
    corrosion problem, the H₂S concentrations from `research/COMPOST-GAS.md`, and
    the retraction of this project's ENIG rationale are in
    [`CONTACT-CORROSION.md`](CONTACT-CORROSION.md). Two consequences land on
    *this* file's verification plan: the SIR coupon must be soaked in an
    **H₂S-bearing** atmosphere rather than clean humidity, and the surface finish
    is now an **open decision** rather than a settled one.
