fl4p/o2-probe/docs/HANDOFF-2026-09-05.md

# Handoff — 2026-09-05, body/print session

Written at the close of the session that printed (and lost) the first monobody.
Three Claude sessions shared this worktree today; this file covers **the body
tube, the slicing pipeline, the printer and the viewer**. The membrane bed,
the radial-ring parameterisation and `PRINTING-HEAD-END.md` belong to the other
two and are not described here except where they touch the above.

## Do this first, next session

1. ~~**Measure `cell_axial_len`.**~~ **SUPERSEDED the same evening — do not do
   this.** Fab, 2026-09-05: the cell is back to **standing on the board like a
   normal THT part** (PLAN.md cell-orientation **option A**, which is what Rev A
   was actually built as), axis normal to the copper, gas face radial. Nothing
   projects past the board tip any more, so `cell_axial_len` is not a placeholder
   waiting on a measurement — the dimension does not exist. The parameter is gone
   from `o2_probe_head_end.scad`; `cell_mount = "standing"` is the default and
   `"past-end"` keeps the old geometry for comparison only.

   What replaced it as a measured input is **`cell_seated_h`** — the can top
   above the **board plane**, real cell in a real socket, currently the computed
   placeholder 8.8 (8.3 can + 0.51 Cambion flange, PLAN.md option A). It no
   longer sets the head length; it sizes what the *tube* has to clear.

   Consequences already in the model: the Ø16.62 × 13 mm neck is deleted, the
   board tip now lands **on the well floor** (z = 16.0), the head is **21.3 mm
   long instead of 34.3**, and the connected volume is **2.93 cm³** (was 4.66) —
   59 % of the 5.0 cm³ budget.
2. **Check the carrier that printed.** It completed at 85/85 layers with
   `print_error 0` — the first successful print in the new location. Nobody has
   inspected the **wet face**, which printed against the plate and is the flat
   sealing land the clamped bed depends on.
3. **Then print the retainer** (12m 24s) and the **cable-end cap** (41m 48s).
   Both are sliced, gated and current.

## What is on the machine

- Printer **moved**: off a metal lattice in direct sun, onto the floor of a
  closed room. Full calibration (bitmask 14, bed levelling *and* vibration) run
  and completed there — ~23 min. **Do not skip re-calibration after any future
  move**; the resonance compensation is measured against the mount.
- **MicroSD replaced and reformatted FAT32.** The original failed mid-session
  (reads and writes both gone); the replacement was rejected until formatted.
- **Highest material run:** ASA, 270 °C nozzle / 100 °C bed, Textured PEI.
- The **MC-fan row in `p1p/doc/machine-state.md` is still open** and gates
  high-temperature filament in the enclosure. Unresolved all day.

## Why the monobody failed, and what changed

It came off the plate at **layer 928 of 1221** (Z 111.4 of 146.6 mm), ~3h40m
into a 4h30m print. The brim lifted **partially** — one side — which is the
signature of a directional thermal gradient, and the machine was in direct sun.
Contributing, but not the cause: it was standing on its own **219 mm²** end face
because `brim_object_gap` was Bambu's default 0.1, so 581 mm² of brim was parked
beside the part rather than attached to it.

Changed since:

- Brim settings are now **per part** (`part_process_overrides()` in `print.sh`),
  because the parts disagree: the monobody wants a fused brim inside and out;
  the carrier's z=0 **is** the membrane sealing land and any fused brim scars it.
- `print.sh` generates `print/<part>/process.json` — the settings that actually
  sliced a plate now sit next to the plate.
- It **refuses** to override `layer_height`, `initial_layer_print_height` or
  `outer_wall_line_width` per part, because the CAD quantizes seal dimensions
  against those and `tools/profile_check.py` gates them against the base profile.
- `tools/seal_check.sh` now **requires `--part`**: the correct brim values are
  opposite for the monobody and the carrier and nothing in the G-code says which
  part it is, so an unnamed part is unevaluable and fails.

## Traps that cost time today, in the order they will bite again

1. **A plate sliced before its STL was rebuilt.** Happened twice. Check the
   mtime chain `.scad → STL → plate` before trusting any plate. It looks
   perfect and slices clean.
2. **`curl` always exits 28 on a Bambu upload.** A refused write is
   indistinguishable from a good one. **Verify by listing the card.**
3. **A Bambu fault names the machine's hypothesis, not its measurement** — but
   test before dismissing it. Today `0x0500C010` "replace the MicroSD card" was
   simply correct, and an all-clear taken 4 minutes earlier was already stale.
4. **A part rendered bare may not be in the assembly frame.** `part="cap"` draws
   24.3 mm low; `part="cap-asm"` is the assembly one. Fab caught this by eye; no
   check did.
5. **`part="cap-asm"` renders EMPTY without `face_sorting="sorted"`** — it trips
   the face-seal assert at line 1027, whose message never mentions the cap. Use
   `make print-ASA`, never hand-rolled `-D`.
6. **A calibration ends in `FINISH`, not `IDLE`**, and stays there.

## Tooling added (all committed and pushed)

- `~/dev/ee/p1p/bin/p1p-camera` — chamber stills. Port 6000, open regardless of
  LAN mode. The reason Python "could not" talk to the printer is Homebrew's
  `sitecustomize` injecting `truststore` over `ssl.SSLContext`, which ignores
  `CERT_NONE`; `extract_from_ssl()` fixes it. **Scoped to port 6000 — whether
  MQTT and FTPS also come back is untested, so p1p rule 6 stands.**
- `~/dev/ee/p1p/bin/p1p-record` — timelapse plus per-frame telemetry. Never
  armed for a real print yet.
- `cad/print-archive/` — the exact `.3mf` of a plate that produced a physical
  part, with tag `print/monobody-r1` carrying the shas and settings.
- `cad/tools/view.py` — panel ordered by measured part height; server re-reads
  `scenes.json` per request. Scenes `body`, `body-print` added.

## Open, unresolved, honest

- ~~`cell_axial_len` — unmeasured.~~ **Closed, not by measuring it: the cell mount
  went back to standing (see item 1). `cell_seated_h = 8.8` is the placeholder
  that replaces it, and it no longer sets the head length.**
- **`fast_hole_h` can set `cav_board_len`, and when it does it is expensive.**
  With the neck gone, the retainer screws are the only thing left that stops the
  head getting shorter: they enter from the end face, go `fast_hole_h` deep, and
  sit on a bolt circle that overlaps the bonded socket, so the model solves
  `cav_board_len = max(2.0, fast_hole_h + 2 - cav_clear_len - spigot_len)`.
  That bore is **466 mm³/mm**, the most expensive millimetre in the probe.
  **It is not binding right now** — a parallel session moved the fastener to M2
  the same evening (`fast_hole_h = 2*pt_nominal + pt_cbore_h` = 5.0), which puts
  the solve at 1.7 and the floor of 2.0 wins. At the old M2.5 / 8.0 mm it solved
  to 4.7 and cost **1.26 cm³**. So: *any* future change to the screw, its
  counterbore or the spigot length can silently lengthen the head again.
  **`tools/interface_check.py` is what catches it** — the body model's
  `cav_board_len` and the head's `body_tube_len` are hand copies of a value that
  is now derived, and they went stale in both directions within one hour today.
  Run it after any fastener change.
- The M8 gland's seal ring (ID, OD, cord) is still provisional: `gland_seal_id
  8.6`, `gland_seal_cord 1.5`. Needs measuring.
- `cap_root_shrink = 0.9891` is borrowed from carrier prints at a different
  print prescription. Measure the groove root on the first cap.
- Whether to drop the monobody to 0.15 mm layers (saves ~50 min, stays inside
  the 0.10–0.15 sealing window) — not decided.
- A **Codex review of the body/slicing work was requested early and never run.**
