fl4p/o2-probe/docs/HEATED-SPREADER.md

# Heated membrane spreader — variant study

**Status:** design study, nothing modelled. Written 2026-09-03 from Fab's proposal
to "solder a metal ring on the tip". The instinct is right and a *ring* is the one
shape that cannot work; the reason is a single number, and the same number sizes
the shape that does.

**Read §0 first.** The heater is not an open choice; it already exists on the
board as J5, and this head geometry cannot use it.

**Nothing here should be built before the measurement in §7.** Every row below is
parameterised on `h`, the membrane's surface coefficient into the guard chamber,
and `h` has never been measured. It is the whole answer.

---

## 0. The ring already exists. This head has nowhere to put it.

**Added 2026-09-04, after the PCB tip was drawn into the exploded view.** Everything
below §1 was written as if the heater were a thing still to be chosen. It is not.
It is already on the board, and this document never checked where it lands.

`o2-probe.kicad_pcb` carries **J5**, two 2.0 x 3.0 mm castellated PTH pads on the
left and right board edges at `(0, 105.5)` and `(20, 105.5)`, bisected by the
finished side profile, joined by wide back copper on switched `HEATER_LOW`. Its
design note in the board file reads:

> "Manual-soldered dry-side metal membrane-carrier ring; duplicated lands are one
> HEATER_LOW node"

So Fab's "solder a metal ring on the tip" was not a new idea to evaluate — it is
the **existing** architecture. RH1 and RH2 (2512s at `(5, 96.5)` and `(15, 96.5)`,
~140 ohm for a ~1 W ceiling at 12 V) are the heat *source*; the ring is the
*spreader* that carries their heat forward to the membrane's dry side.
`PLAN.md` is explicit that it is "a thermal spreader, not an electrical jumper".

### Where it lands, and why that fails here

The board's gas end stops at `y = 107`, so J5 sits 1.5 mm behind the board tip.
In the **radial** head (`cad/o2_probe_head.scad`) that works: the windows are on
the tube's side walls, the board runs past them, and a ring soldered into both
edge castellations encircles the tip and can bear on the cartridge's heater shelf.

This **end-window** head is `PLAN.md` cell-orientation **option C — cell past the
board end, axis along the tube**. That choice moved the membrane off the side and
onto the end face, and it put the cell between the board and the window:

| | z (head frame) |
|---|---:|
| board tip, and therefore J5's ring | **16.0** |
| cell can, seated on its socket stand-off | 20.7 – 29.0 |
| carrier well floor | 29.0 |
| head end face | 33.6 |
| **heater shelf in the cartridge** | **34.6** |

**18.6 mm from the ring to the heater shelf, with a Ø14.4 cell filling the bore
for 8.3 mm of it.** A ring at J5 cannot reach the membrane in this geometry. To
get there it would have to become a ~19 mm sleeve around the cell — which is a
thermal shunt straight down the gas path, wrapped around the one component whose
rear vent `PLAN.md` marks DO NOT OBSTRUCT.
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
