fl4p/o2-probe/docs/PROTOTYPE-RESPONSE.md

# O₂ probe prototype response decision

Date: 2026-08-23
Status: uncalibrated sensitivity decision; geometry is not fabrication release.

> **2026-09-05 — one gate below no longer describes the built geometry.**
> The build candidate's **"cell-to-membrane path: 5–10 mm"** was written for a
> cell facing the membrane down the probe axis. Fab put the cell back on a
> **standing** THT mount (PLAN.md option A): its gas face is **radial**, and it
> sits 13.5 mm behind the board tip. The path is now 8.3 mm of axial gas column
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
