fl4p/o2-probe/cad/chamber-now.jpg

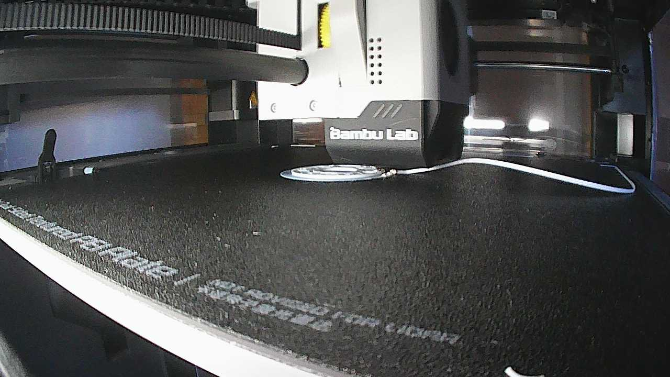
cad/chamber-now.jpg
