fl4p/o2-probe/cad/chamber.jpg

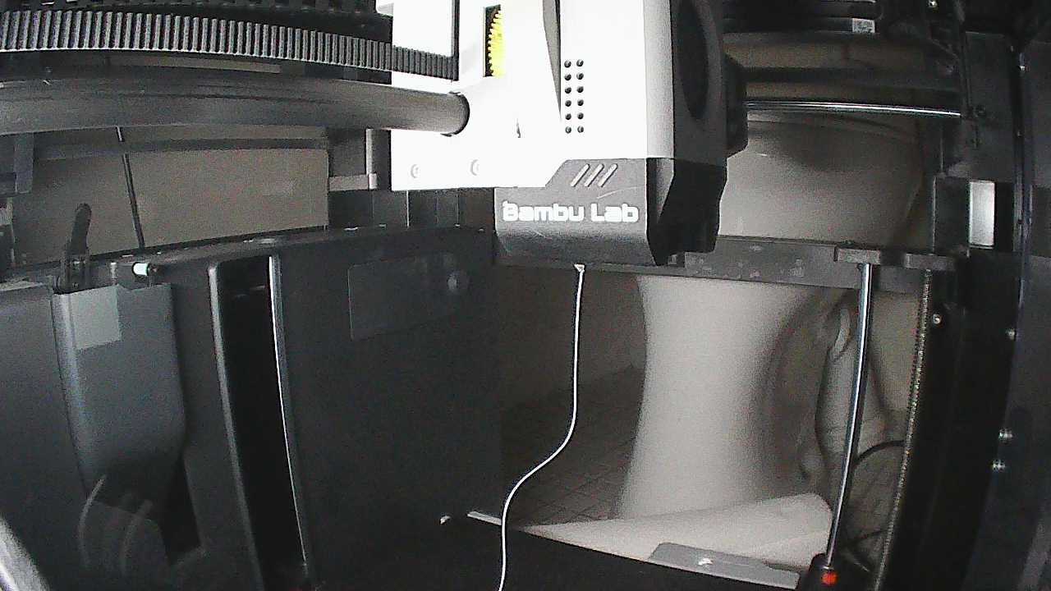
cad/chamber.jpg
