fl4p/o2-probe/cad/exports/asa-bed-section.png

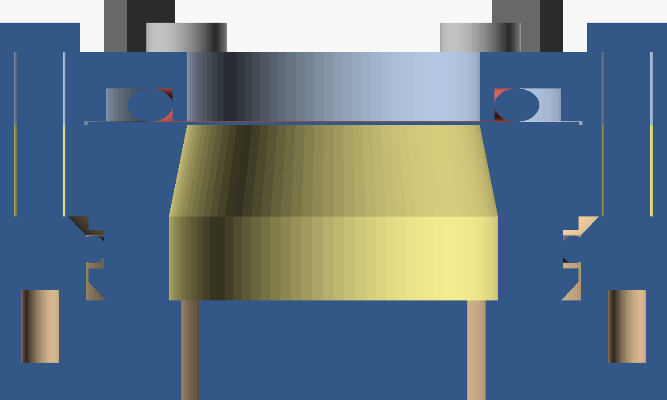
cad/exports/asa-bed-section.png
