fl4p/o2-probe/cad/exports/body-fit-coupon-preview.png

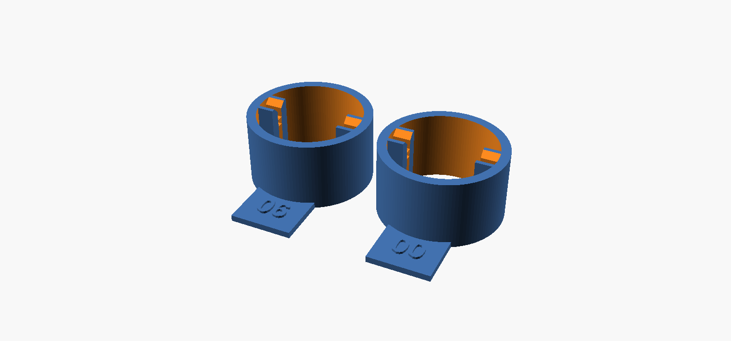
cad/exports/body-fit-coupon-preview.png
