fl4p/o2-probe/cad/exports/collar-section.png

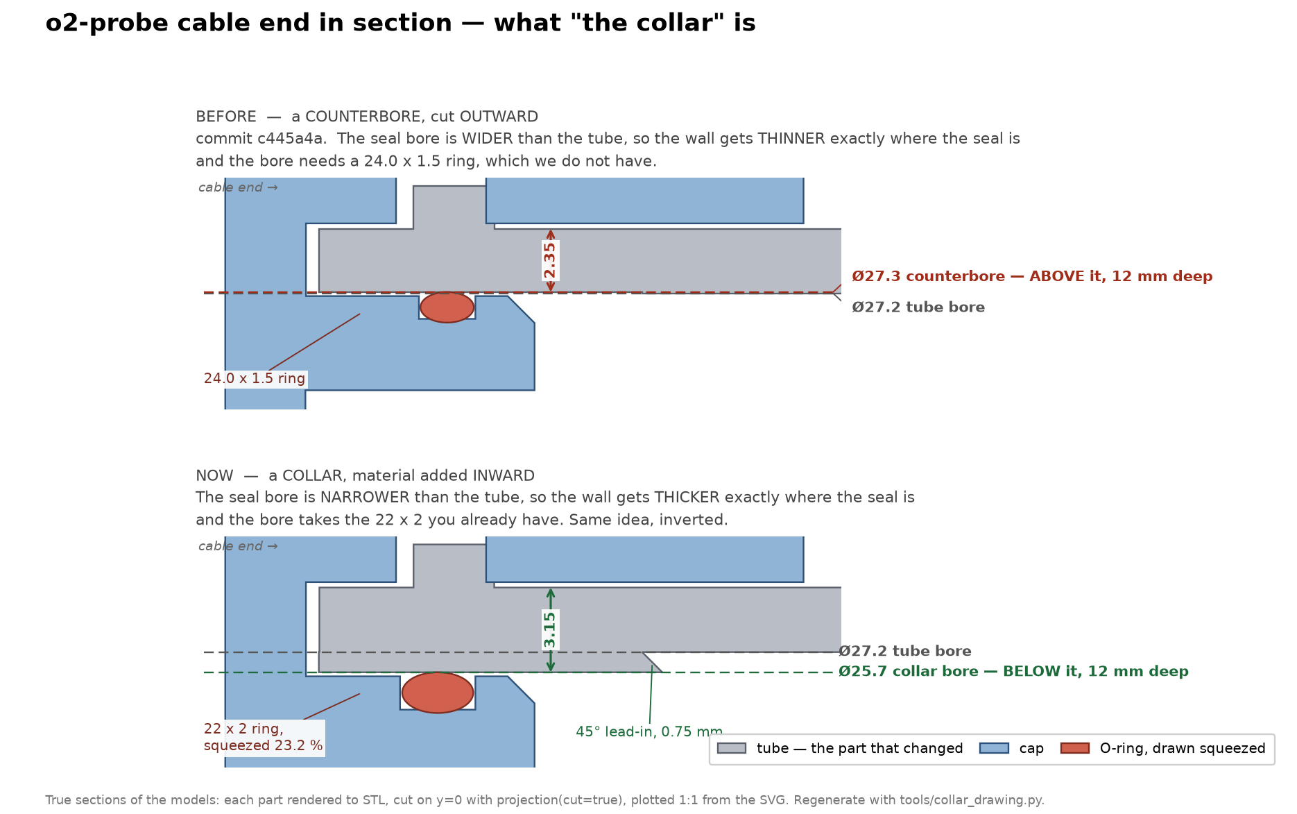
cad/exports/collar-section.png
