fl4p/o2-probe/cad/exports/exploded-preview.png

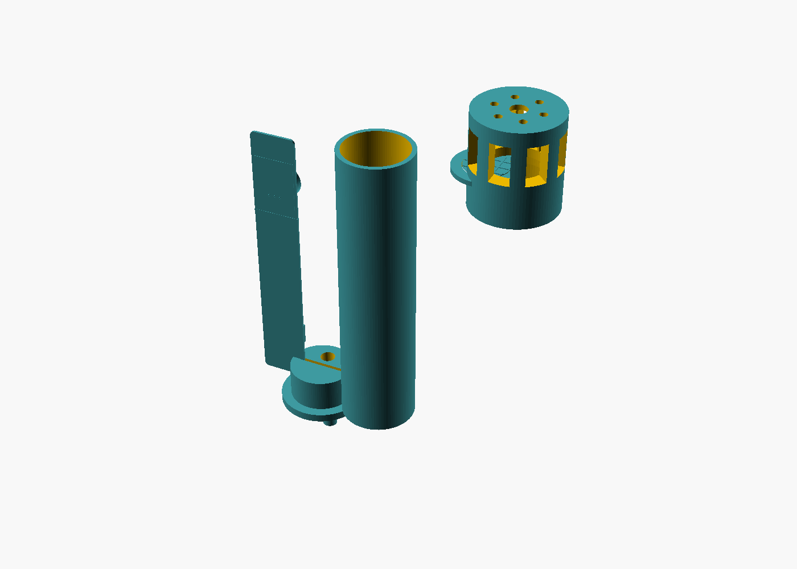
cad/exports/exploded-preview.png
