fl4p/o2-probe/cad/exports/gas-shell-section.png

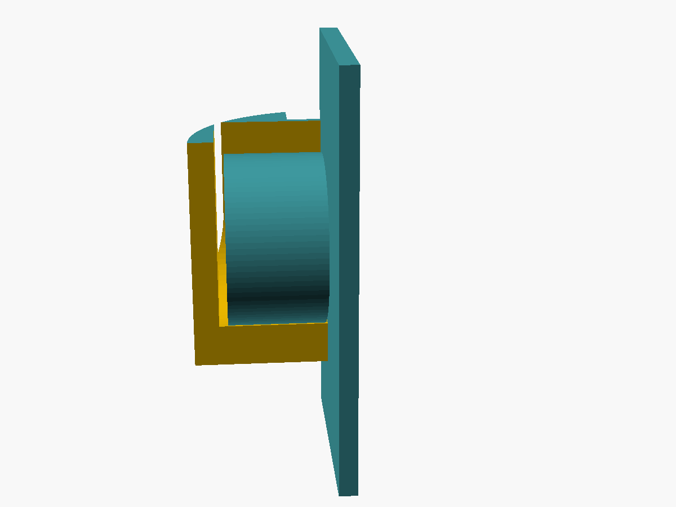
cad/exports/gas-shell-section.png
