fl4p/o2-probe/cad/exports/head-end-exploded-labelled.png

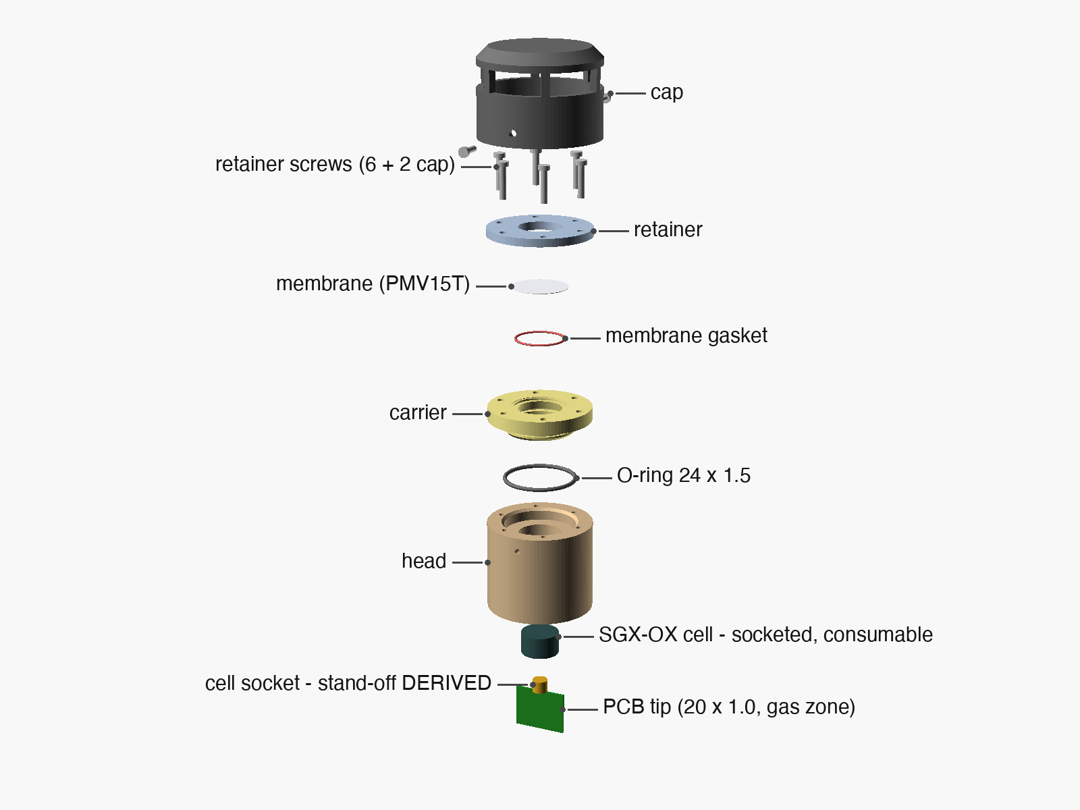
cad/exports/head-end-exploded-labelled.png
