fl4p/o2-probe/cad/exports/head-provisional-preview.png

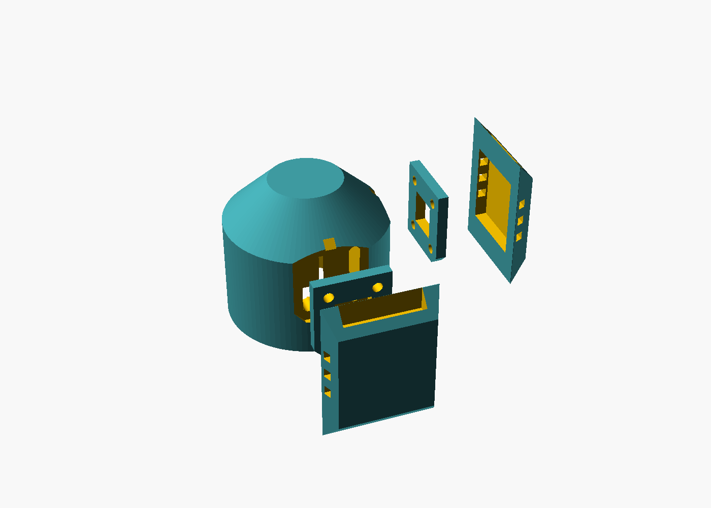
cad/exports/head-provisional-preview.png
