fl4p/o2-probe/cad/exports/prototype-exploded-labelled.png

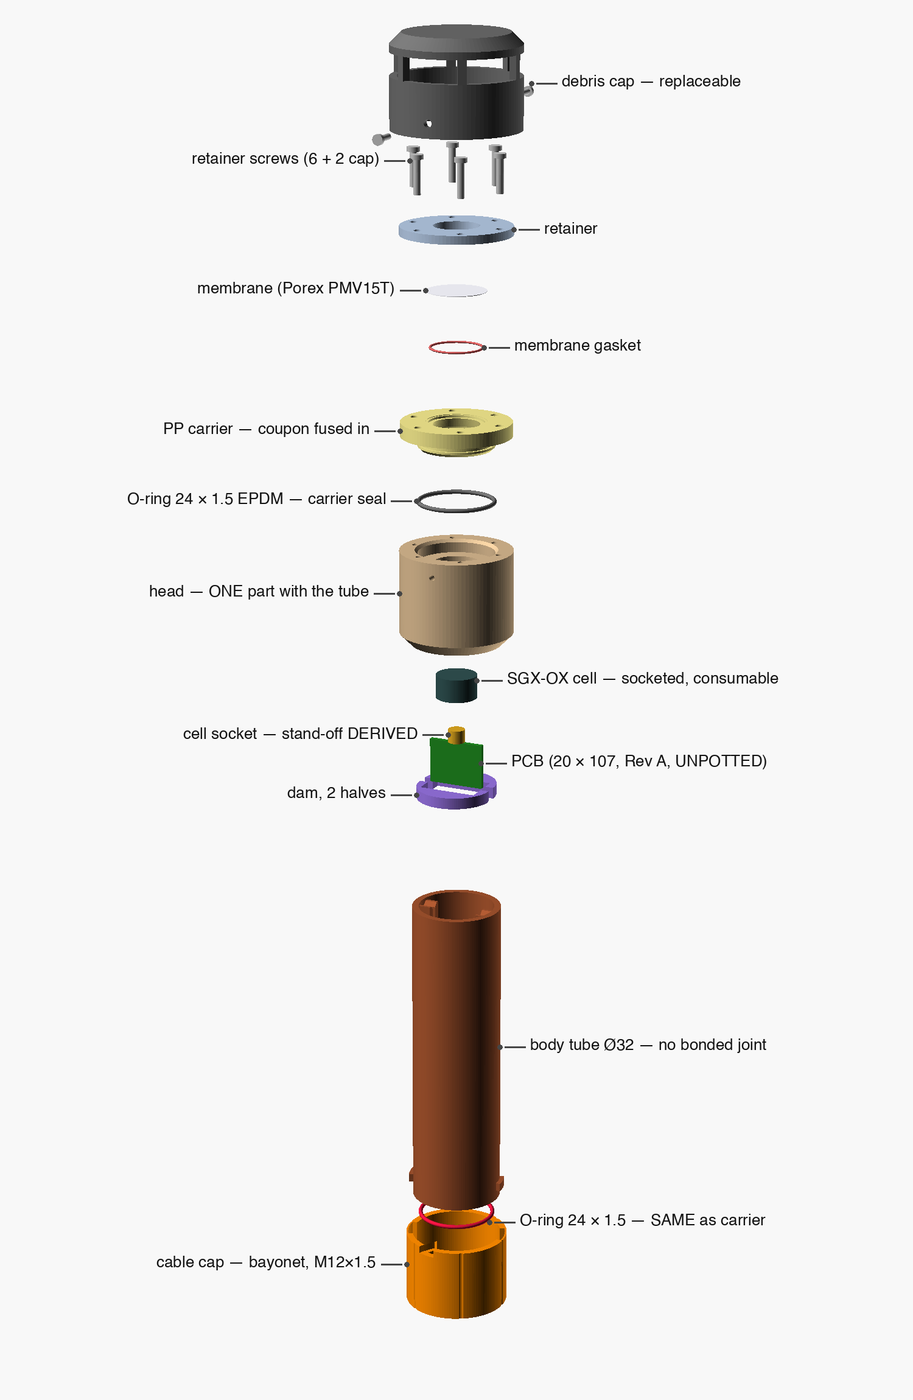
cad/exports/prototype-exploded-labelled.png
