fl4p/o2-probe/cad/fail2.jpg

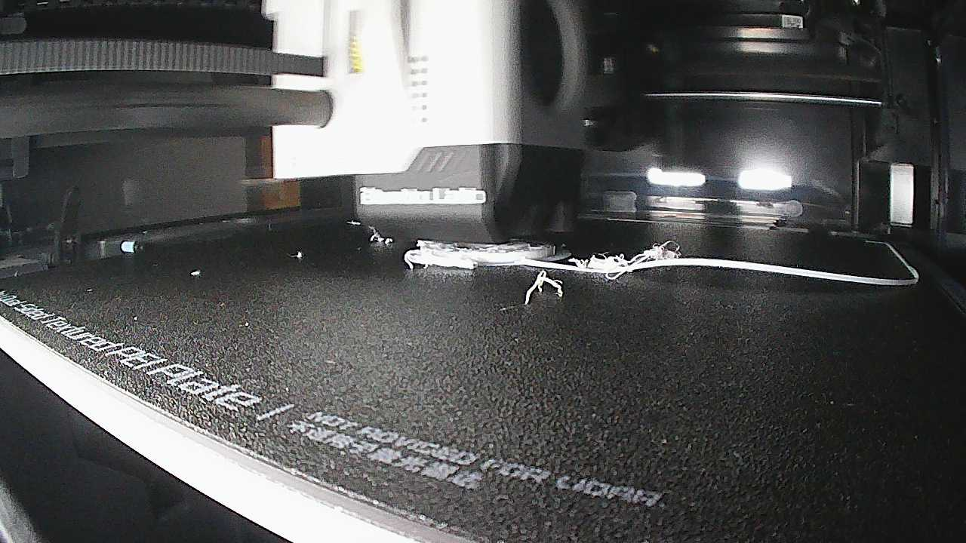
cad/fail2.jpg
