fl4p/o2-probe/cad/fail.jpg

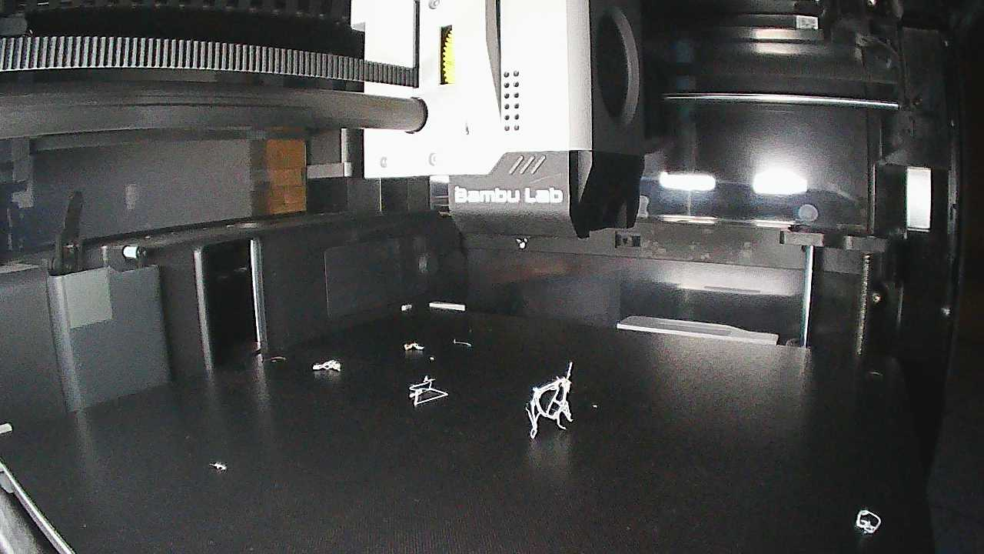
cad/fail.jpg
