fl4p/o2-probe/cad/mess.jpg

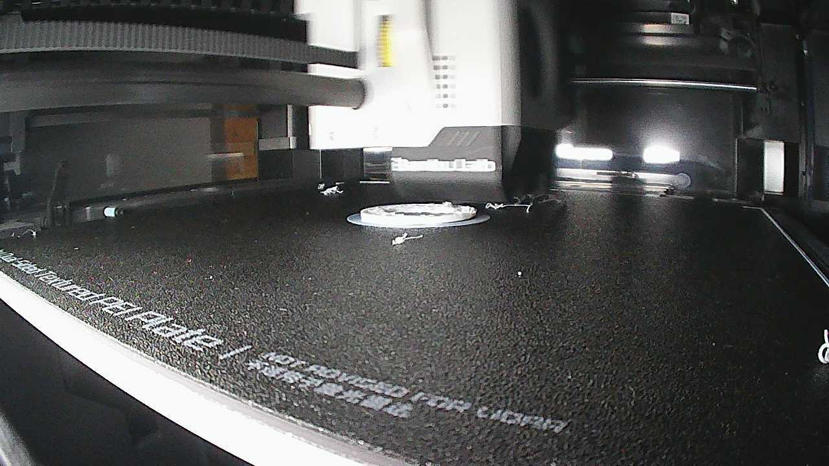
cad/mess.jpg
