fl4p/o2-probe/cad/now2.jpg

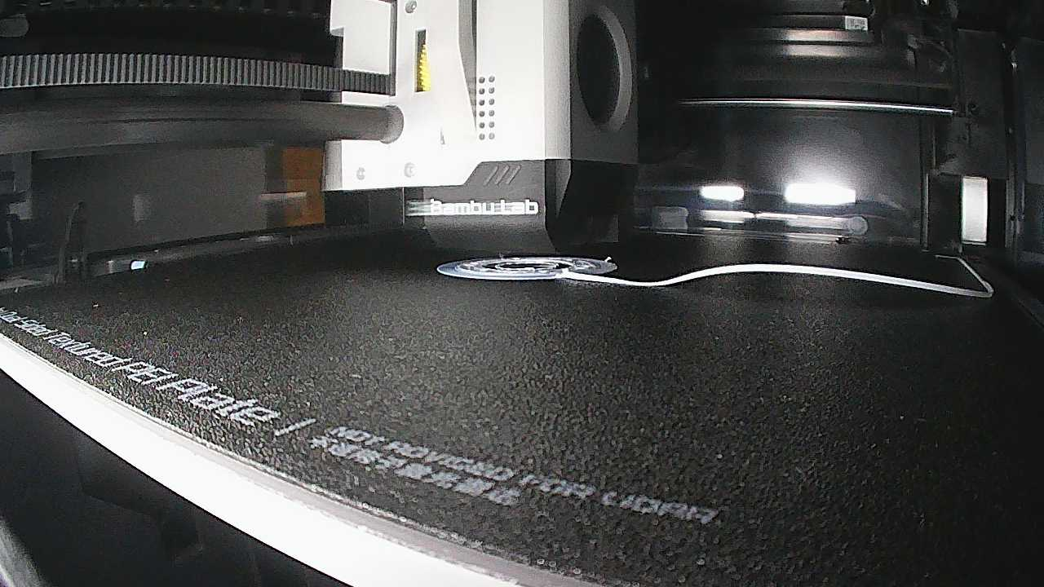
cad/now2.jpg
