fl4p/o2-probe/cad/run4.jpg

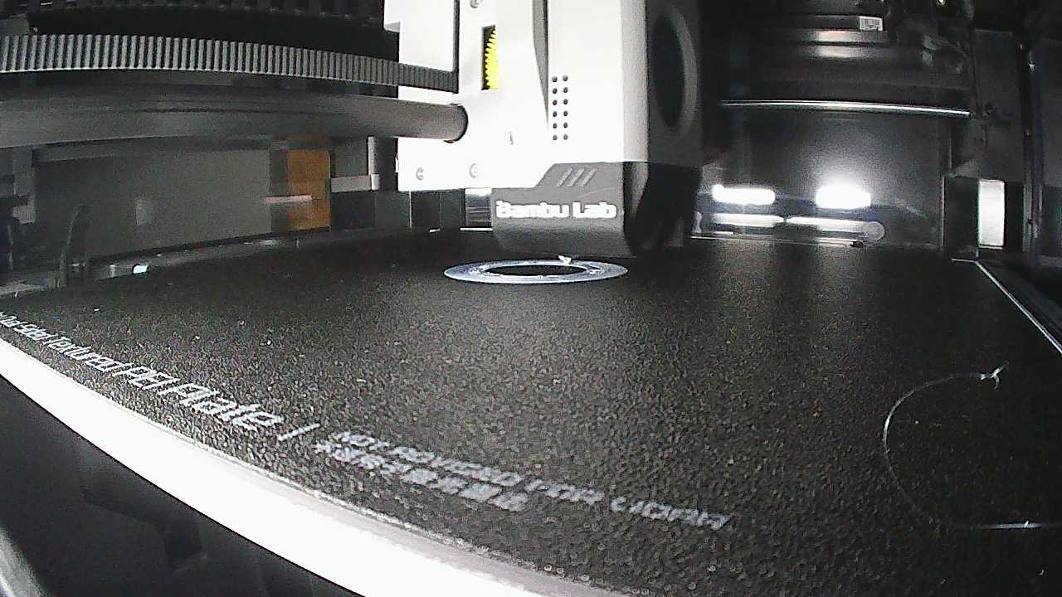
cad/run4.jpg
