fl4p/o2-probe/hw/.playwright-mcp/page-2026-09-07T15-23-56-813Z.png

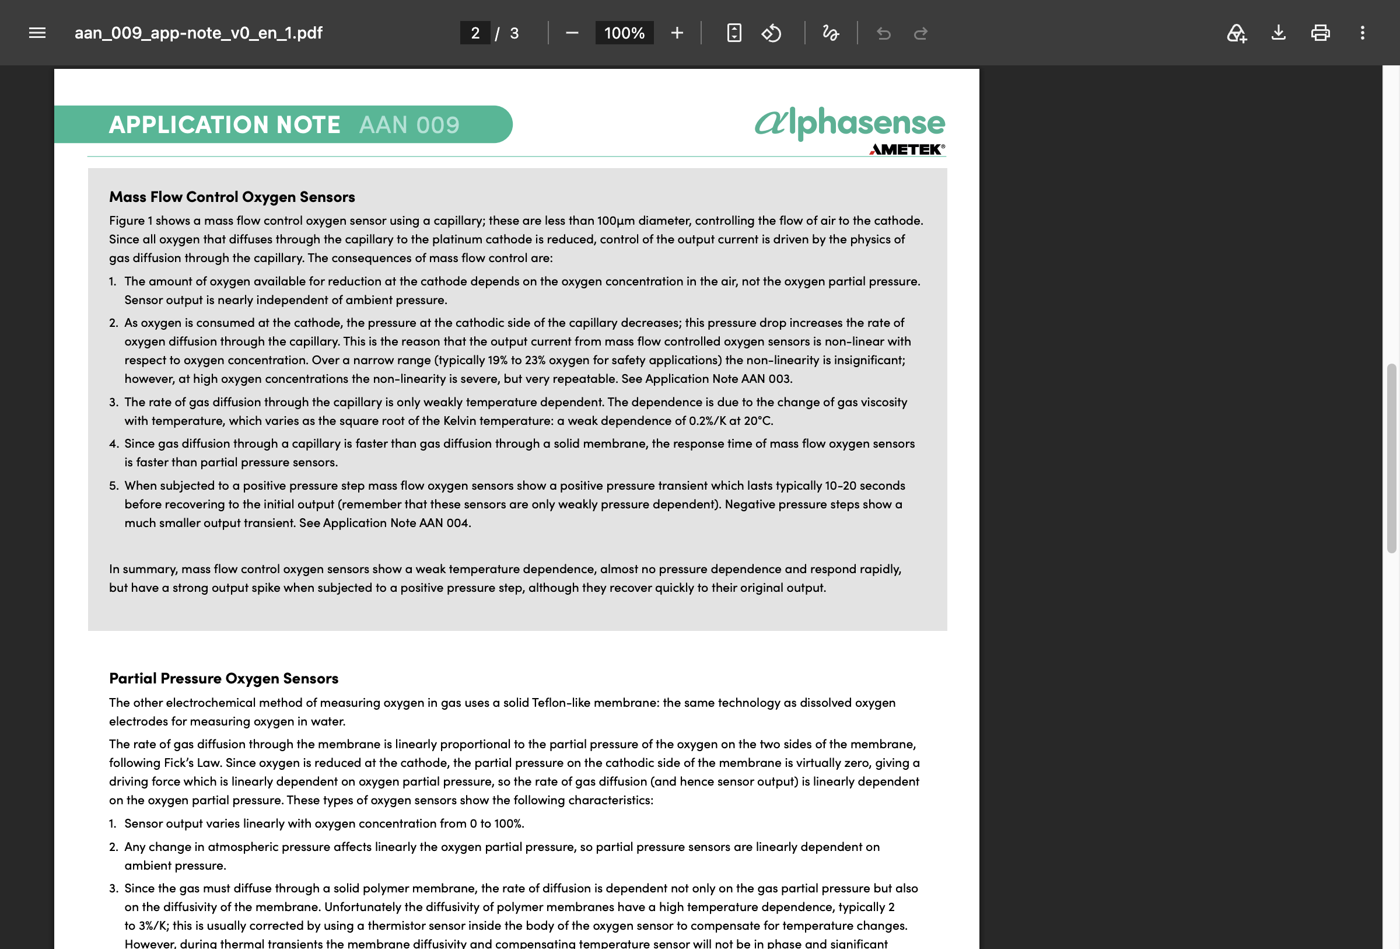
hw/.playwright-mcp/page-2026-09-07T15-23-56-813Z.png
