fl4p/o2-probe/hw/.playwright-mcp/page-2026-09-07T15-26-46-580Z.png

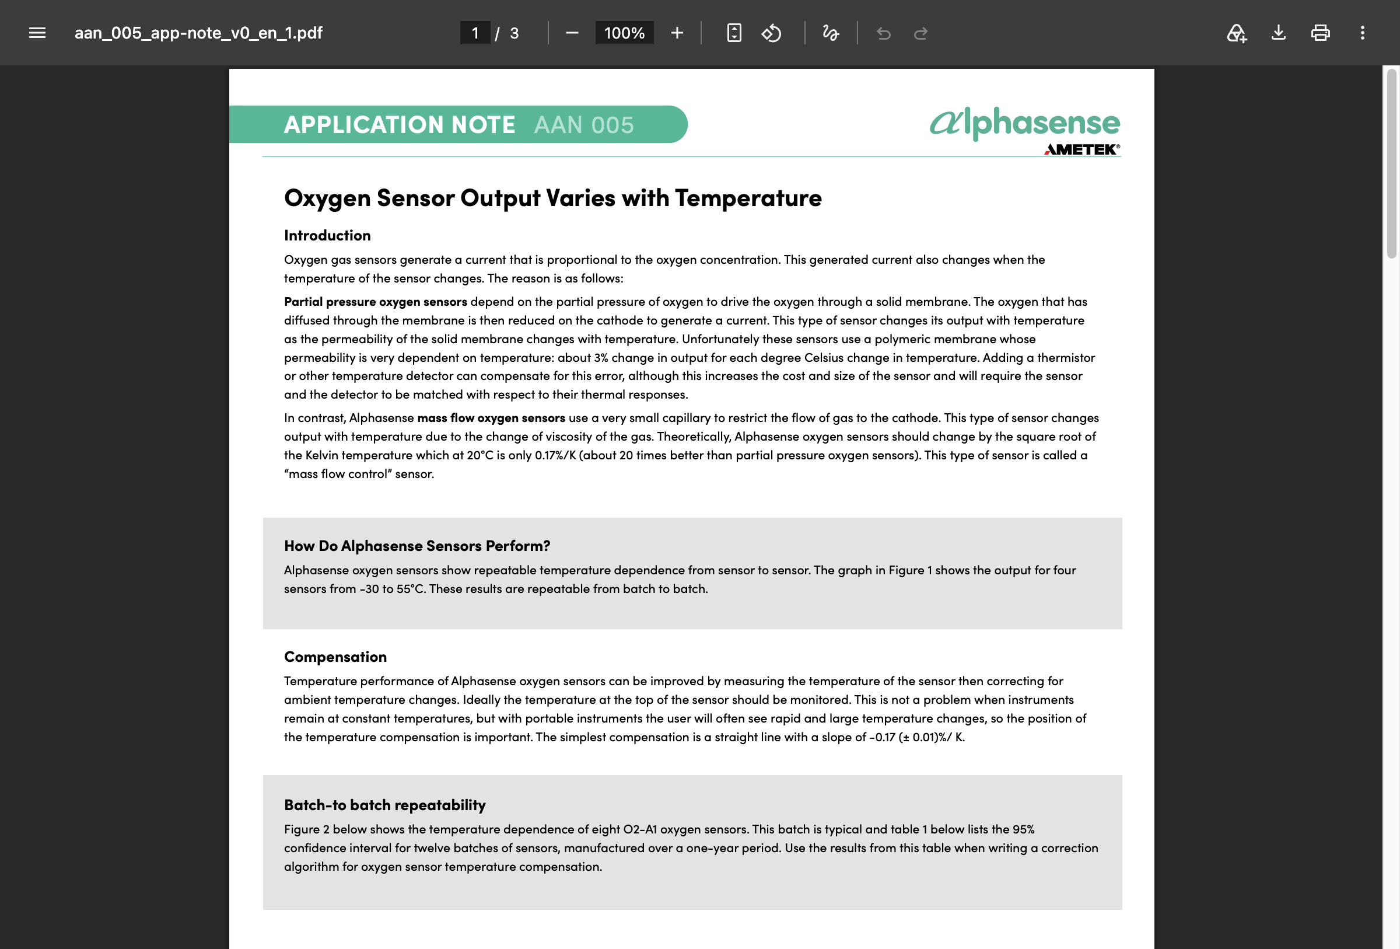
hw/.playwright-mcp/page-2026-09-07T15-26-46-580Z.png
