fl4p/o2-probe/hw/.playwright-mcp/page-2026-09-07T15-27-11-788Z.png

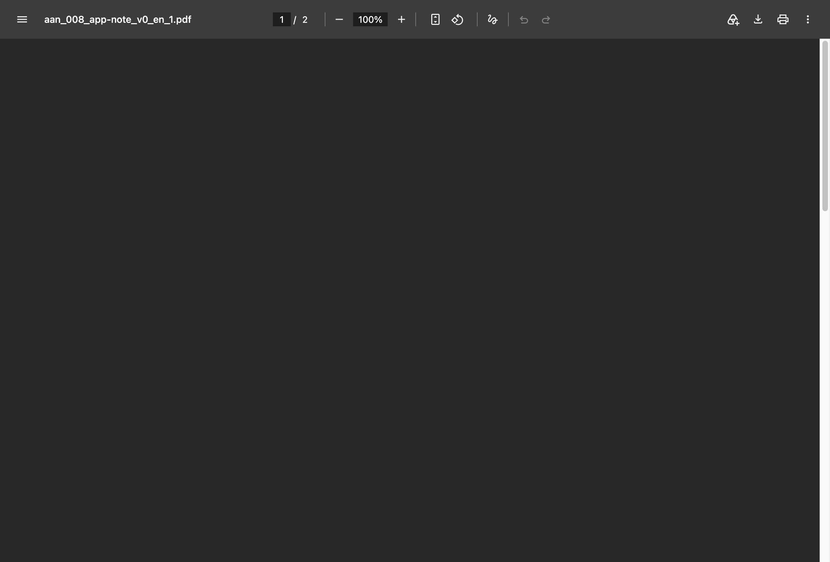
hw/.playwright-mcp/page-2026-09-07T15-27-11-788Z.png
