fl4p/o2-probe/hw/bench-logs/2026-09-13-outdoor-fit/o2-compensated.png

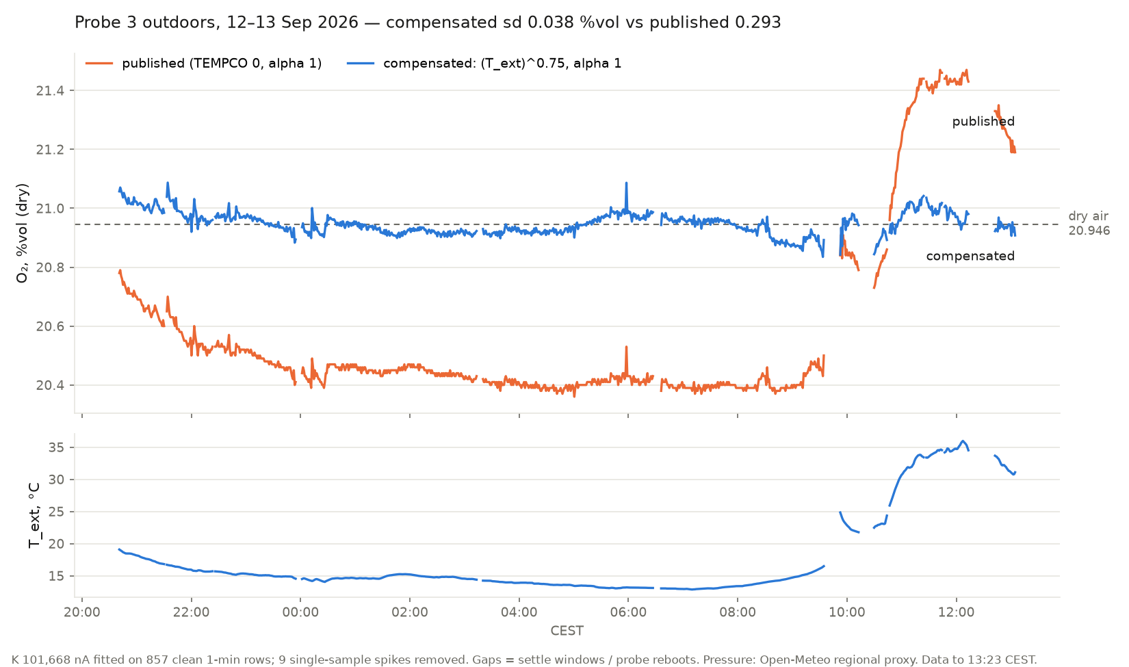
hw/bench-logs/2026-09-13-outdoor-fit/o2-compensated.png
