fl4p/o2-probe/hw/bench-logs/capture.webp

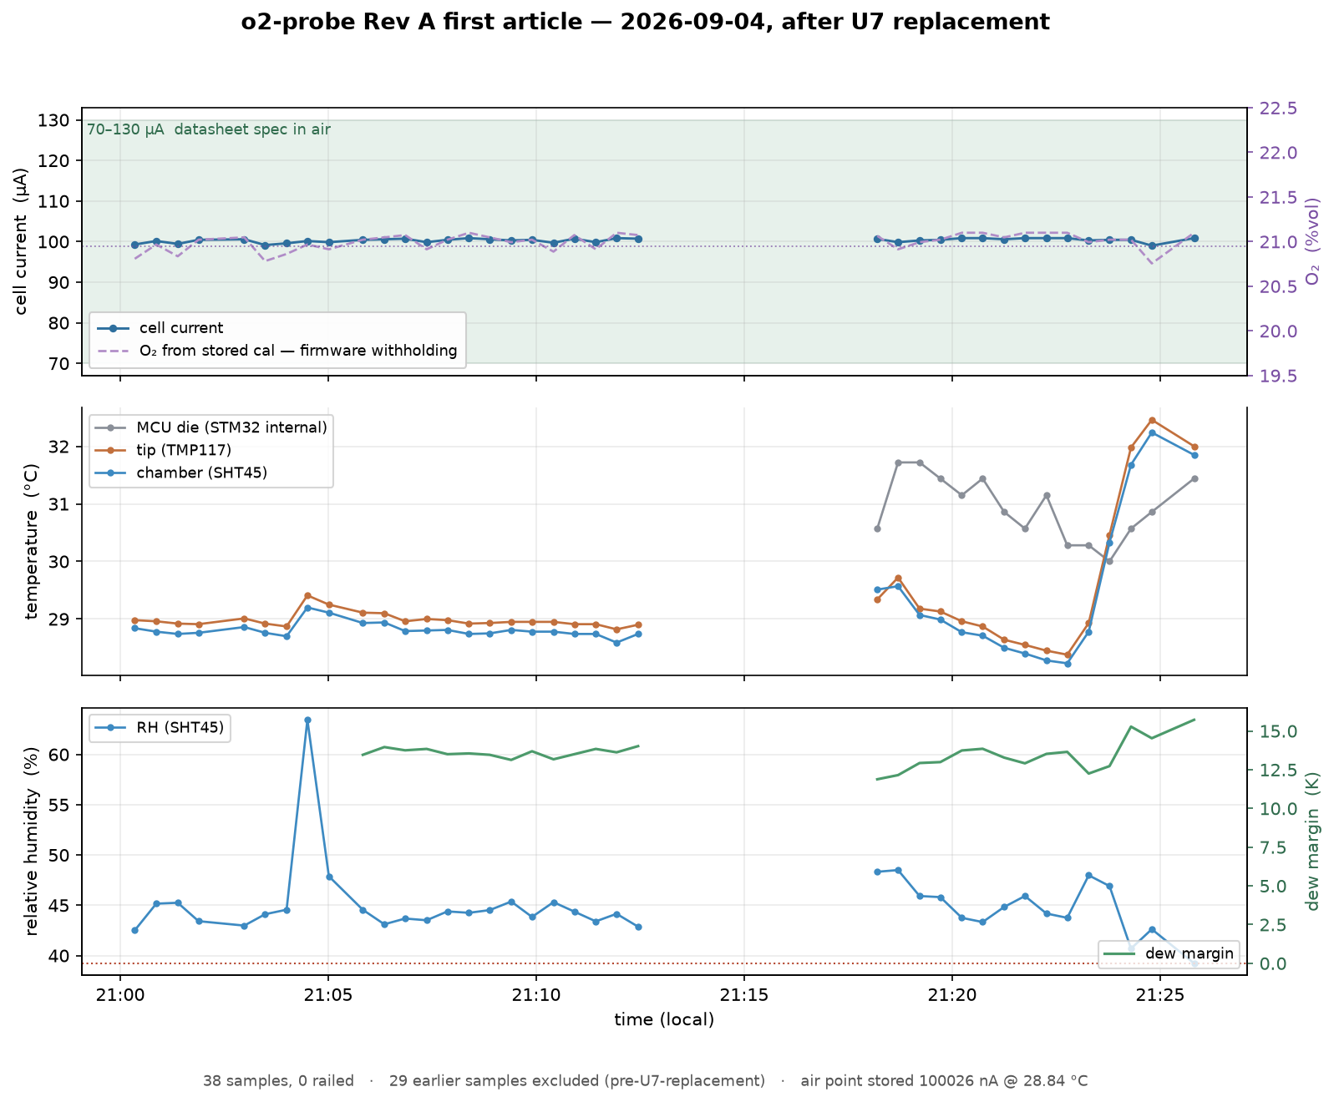
hw/bench-logs/capture.webp
