fl4p/o2-probe/hw/bench-logs/modbus-poll-2026-09-06.webp

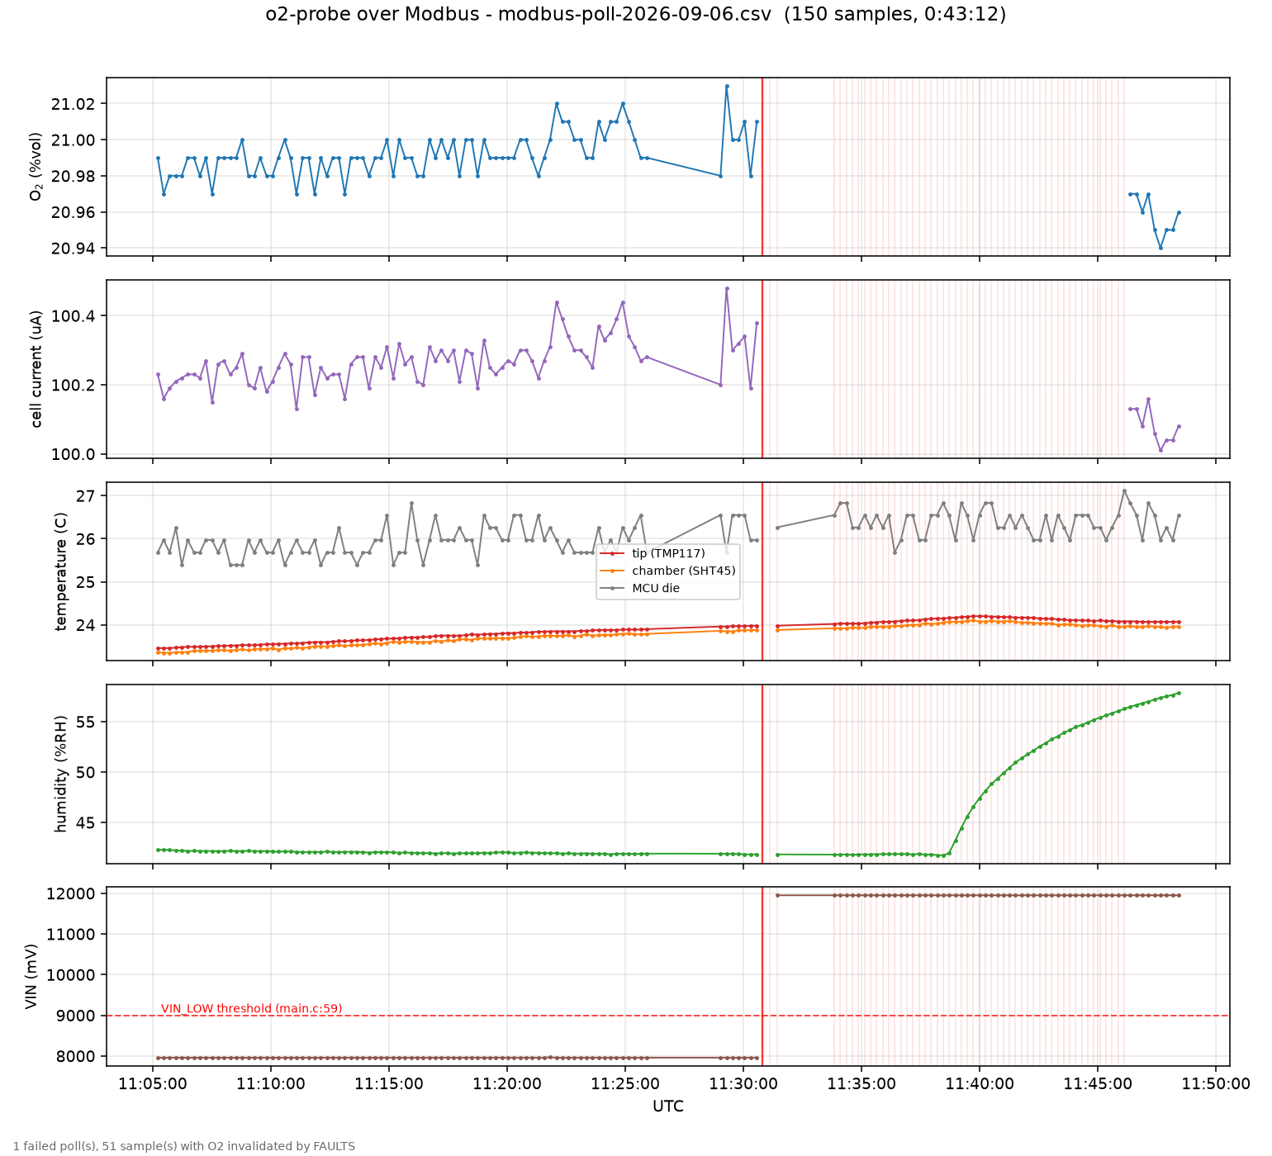
hw/bench-logs/modbus-poll-2026-09-06.webp
