fl4p/o2-probe/hw/bench-logs/o2-12h-dilution-fit-2026-09-07.png

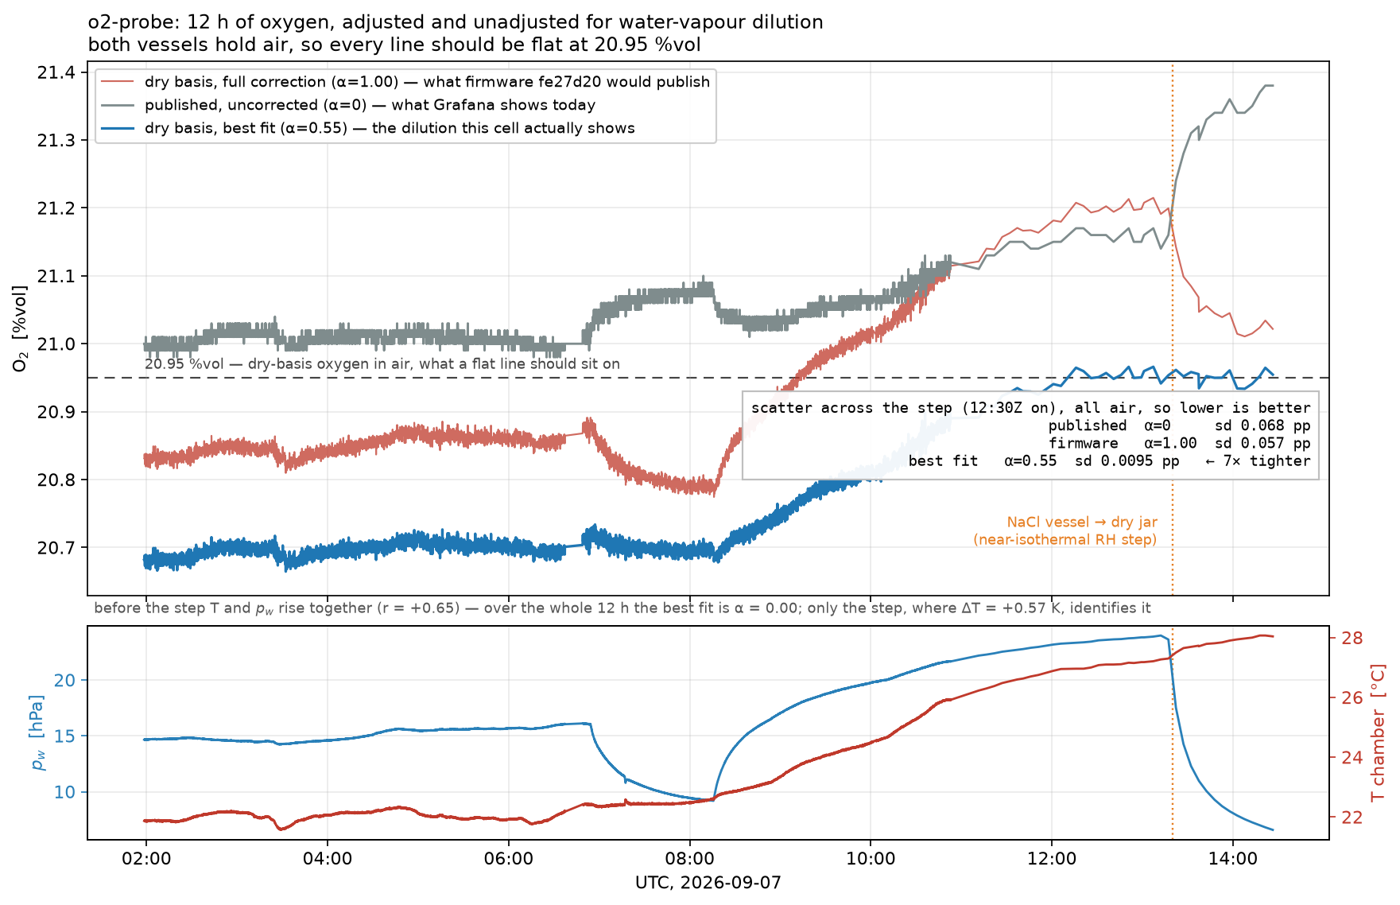
hw/bench-logs/o2-12h-dilution-fit-2026-09-07.png
