fl4p/o2-probe/hw/bench-logs/o2-12h-dilution-tempco-fit-2026-09-07.png

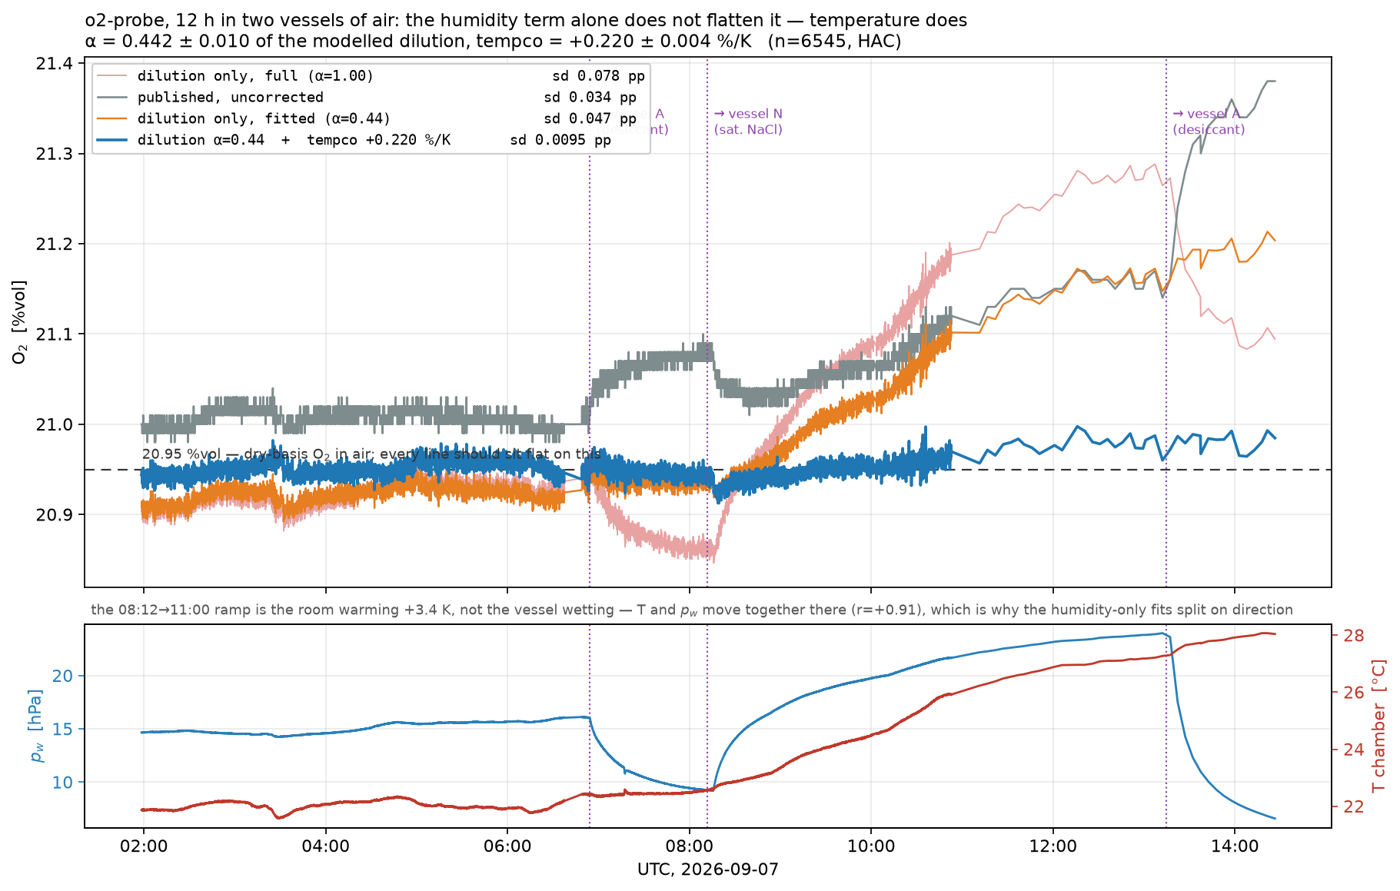
hw/bench-logs/o2-12h-dilution-tempco-fit-2026-09-07.png
