fl4p/o2-probe/hw/bench-logs/o2-model-fit-2026-09-11.png

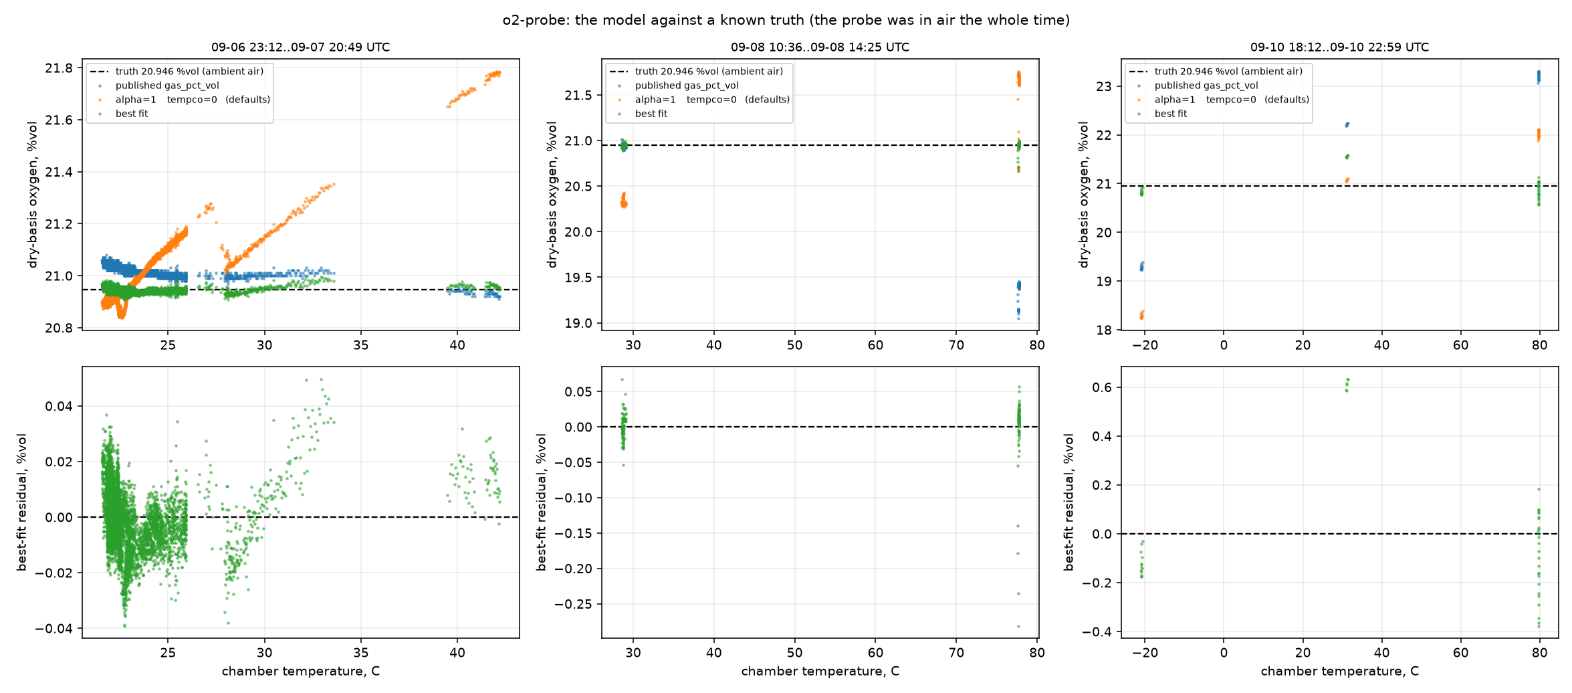
hw/bench-logs/o2-model-fit-2026-09-11.png
