fl4p/o2-probe/hw/bench-logs/o2-sweep-2026-09-07.png

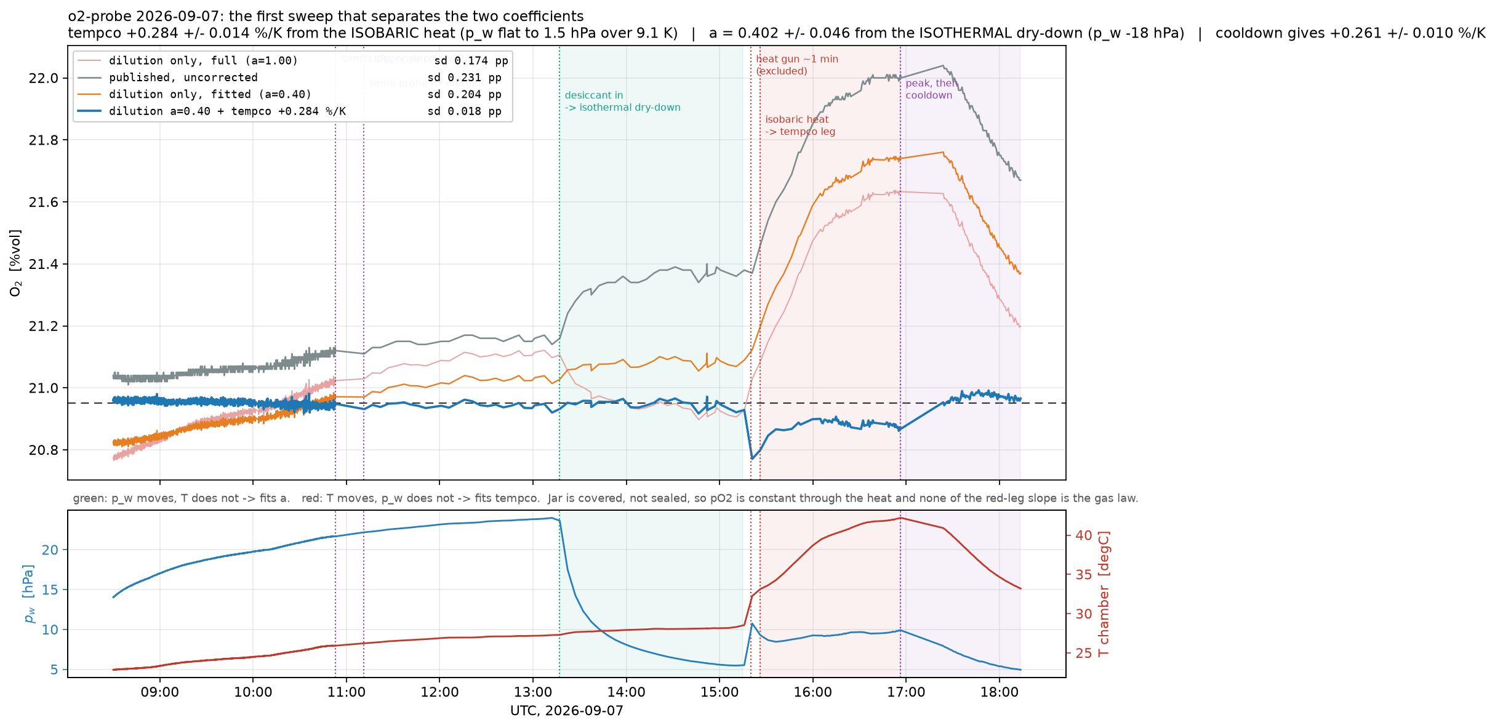
hw/bench-logs/o2-sweep-2026-09-07.png
