fl4p/o2-probe/hw/datasheets/BAT54W-G-leakage-digitized/overlay-p02-fig3.png

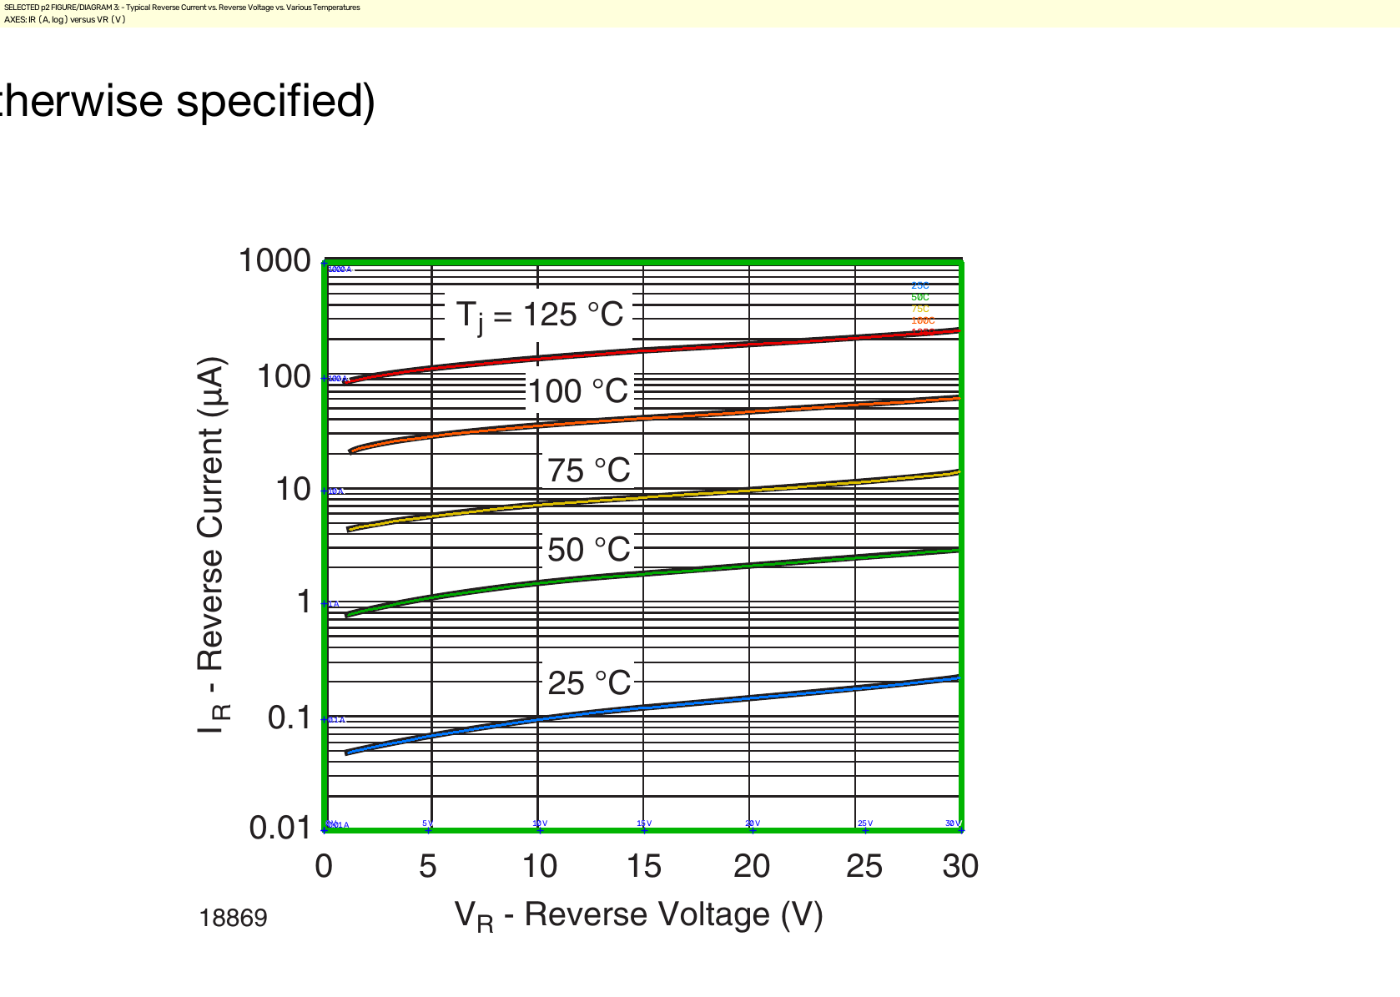
hw/datasheets/BAT54W-G-leakage-digitized/overlay-p02-fig3.png
