fl4p/o2-probe/hw/datasheets/vfg91-2025-1pct.png

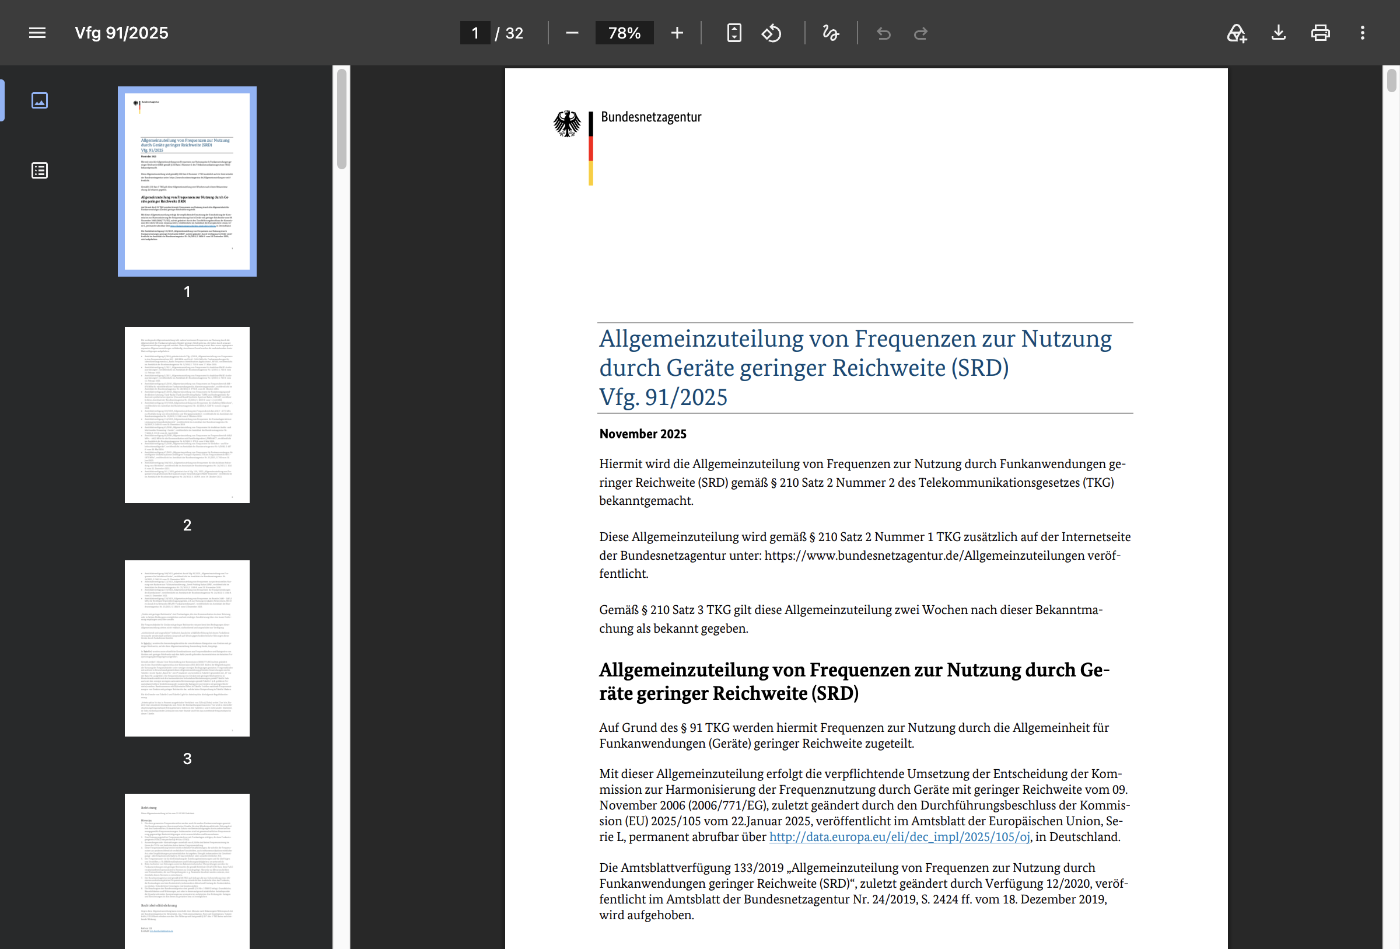
hw/datasheets/vfg91-2025-1pct.png
