fl4p/o2-probe/hw/docs/2026-09-17-pile-evidence/o2-pile-corrected.png

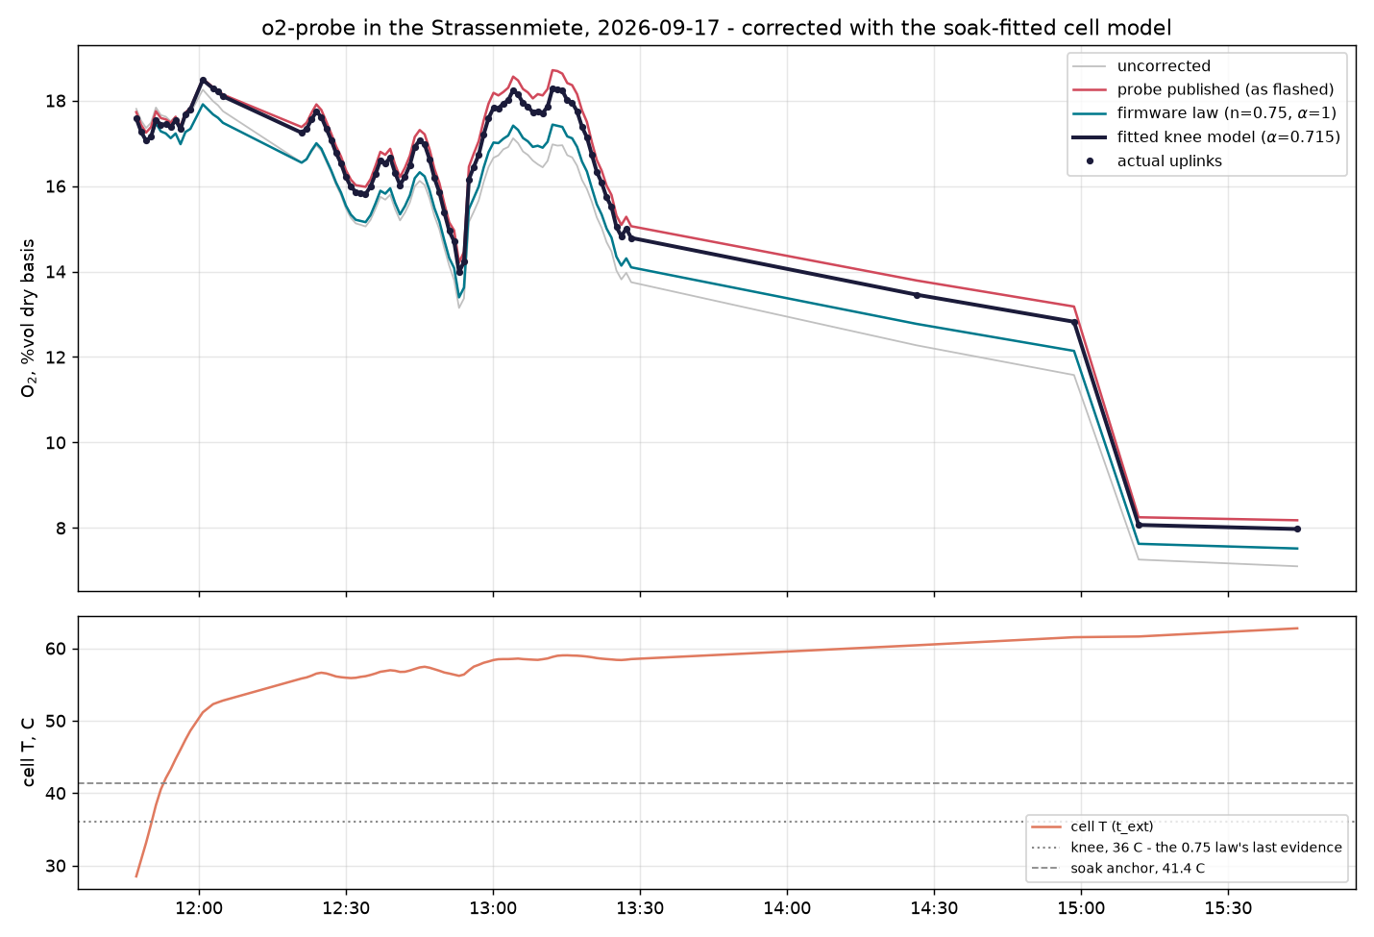
hw/docs/2026-09-17-pile-evidence/o2-pile-corrected.png
