fl4p/o2-probe/hw/docs/2026-09-19-oven-soak-evidence/o2-corrected-final.png

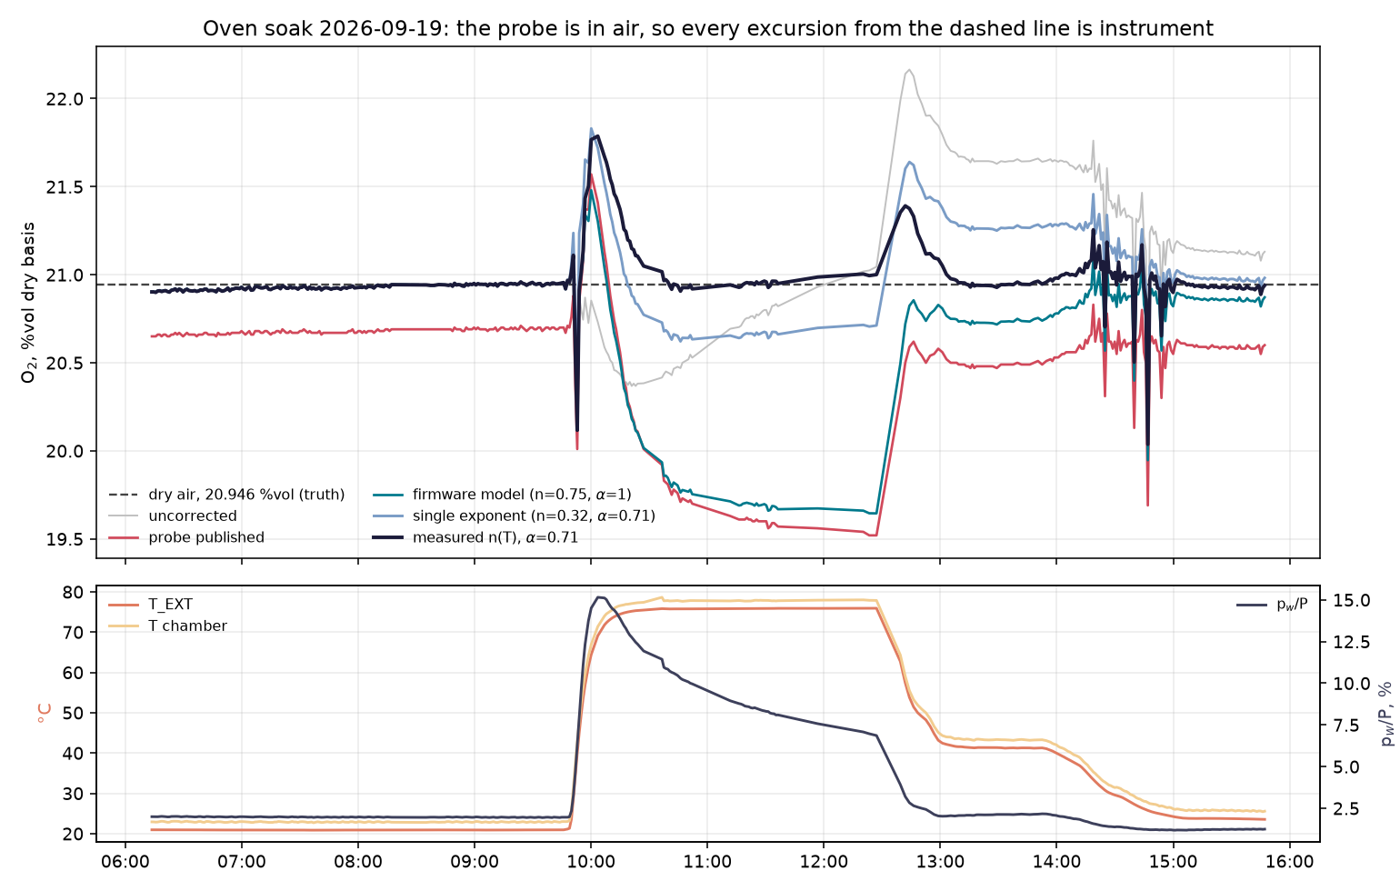
hw/docs/2026-09-19-oven-soak-evidence/o2-corrected-final.png
