fl4p/o2-probe/hw/layerplots/back.webp

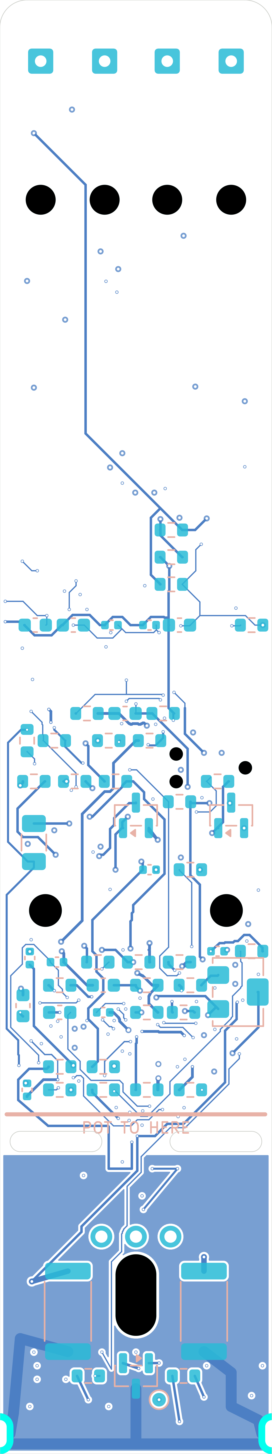
hw/layerplots/back.webp
