fl4p/o2-probe/hw/layerplots/front.webp

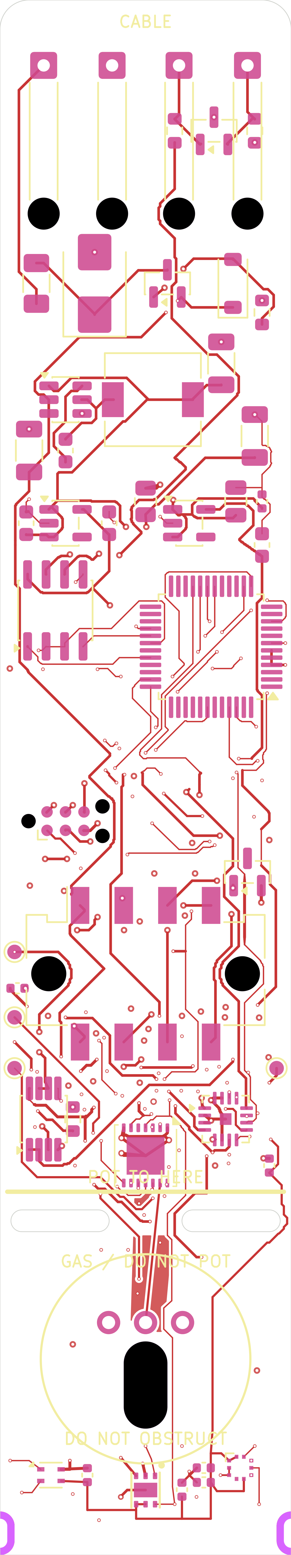
hw/layerplots/front.webp
