fl4p/o2-probe/hw/routing/revb-86/evidence/pdf/schematic.png

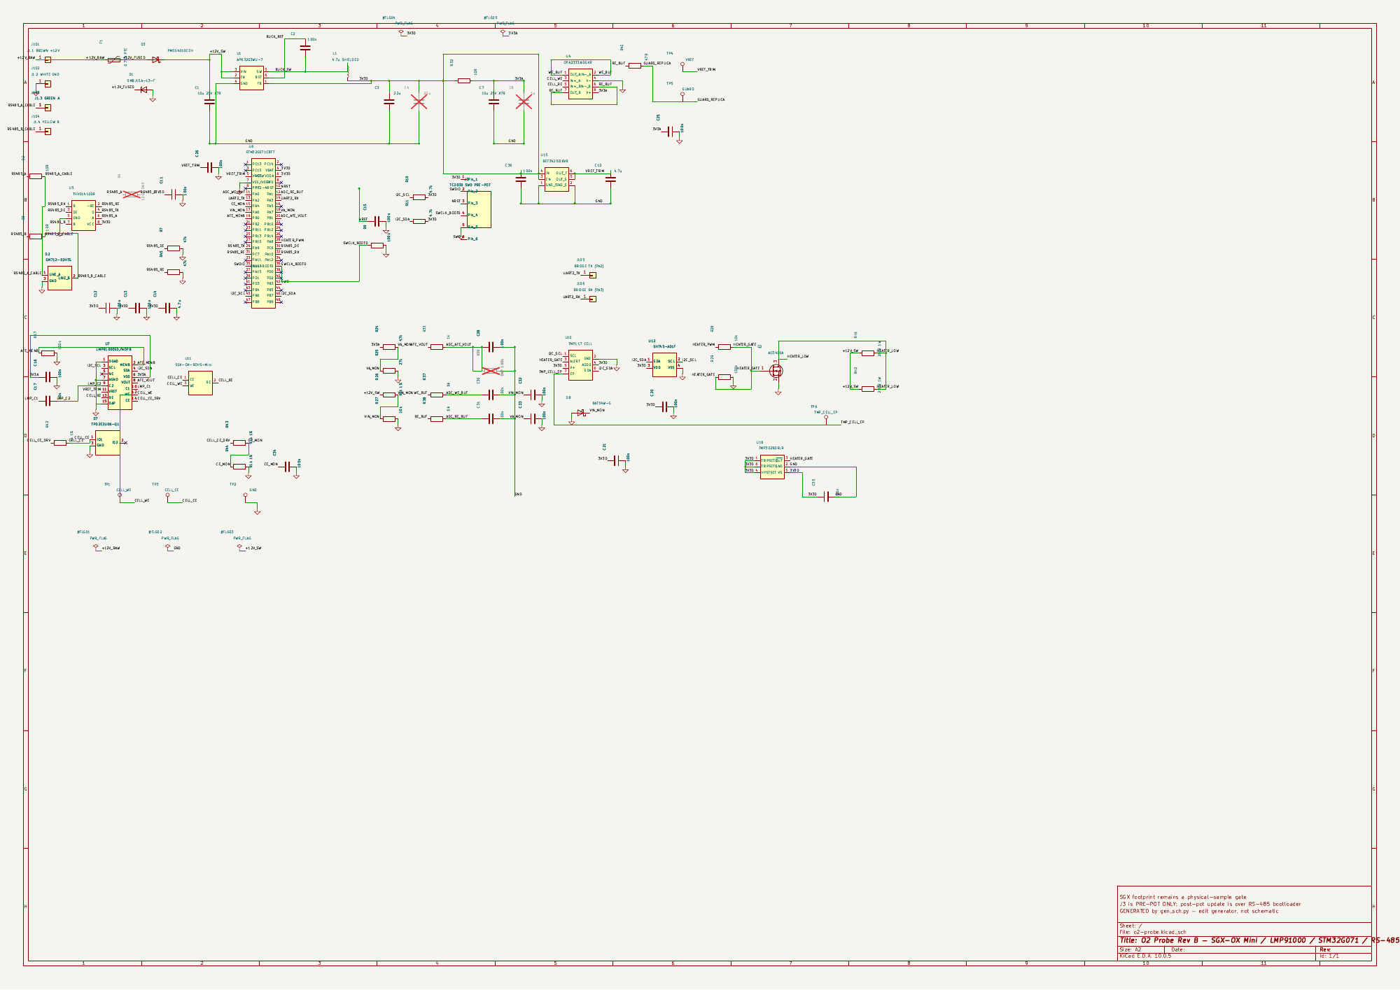
hw/routing/revb-86/evidence/pdf/schematic.png
