fl4p/o2-probe/hw/routing/revb-current/evidence/final/back.png

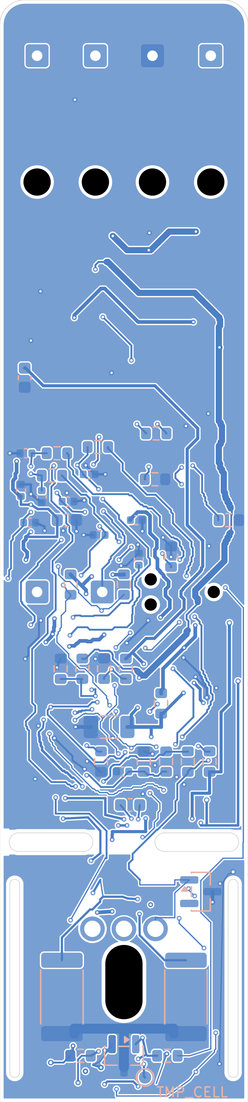
hw/routing/revb-current/evidence/final/back.png
