fl4p/o2-probe/hw/routing/revb-current/evidence/final/front.png

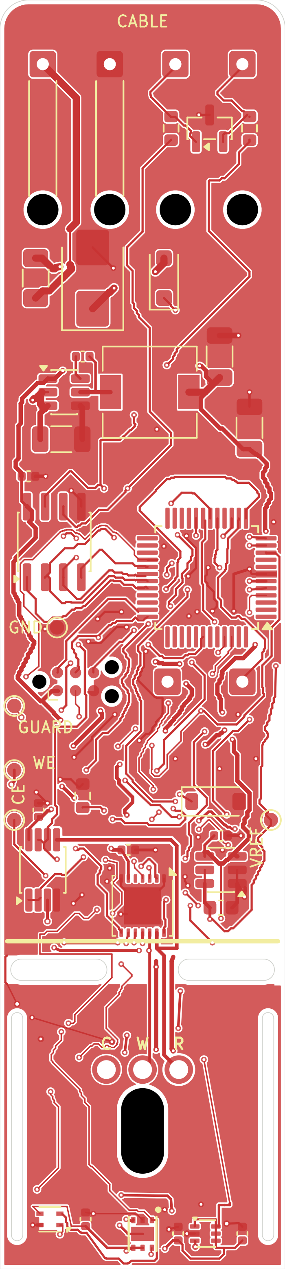
hw/routing/revb-current/evidence/final/front.png
