fl4p/o2-probe/hw/literature/bom-capacitors/DigiKey n.d. C0603C102J5GACTU.md

# DigiKey n.d. C0603C102J5GACTU

Source: [D2](https://www.digikey.com/en/products/detail/kemet/C0603C102J5GACTU/608471)

Accessed: 2026-09-09. Evidence: inspected; route: native HTML/DOM; validation: validated.

Exact product attributes agree with K1. Availability: 464623 in stock, cut-tape SKU 399-C0603C102J5GACTUCT-ND. This is distributor stock, not Fab inventory.
