fl4p/o2-probe/hw/literature/bom-capacitors/DigiKey n.d. C1206C106K3RACTU.md

# DigiKey n.d. C1206C106K3RACTU

Source: [D3](https://www.digikey.com/en/products/detail/kemet/C1206C106K3RACTU/3317476)

Accessed: 2026-09-09. Evidence: inspected; route: native HTML/DOM; validation: validated.

Exact product attributes agree with K2. Availability: 32611 in stock, cut-tape SKU 399-C1206C106K3RACTUCT-ND. This is distributor stock, not Fab inventory.
