fl4p/o2-probe/hw/o2-probe-bom.csv

mpn | value | footprint | qty_per_board | fitted | sourcing | refs
 | HEATED MEMBRANE RING | o2-probe:Heater_Ring_Solder_Lands | 1 | yes | unsourced | J5
 | 120R DNP | Resistor_SMD:R_0603_1608Metric | 0 | no | dnp | R4
 | 1u | Capacitor_SMD:C_0603_1608Metric | 0 | no | dnp | C8
 | DNP 100k | Resistor_SMD:R_0603_1608Metric | 0 | no | dnp | R39
EMK316BB7226ML-T | 22u | Capacitor_SMD:C_1206_3216Metric | 0 | no | dnp | C4
 | 100k | Resistor_SMD:R_0603_1608Metric | 3 | yes | generic-stock | R17 R29 R9
 | 100n | Capacitor_SMD:C_0402_1005Metric | 18 | yes | generic-stock | C11 C12 C13 C15 C16 C2 C20 C21 C25 C26 C28 C30 C31 C32 C33 C34 C35 C36
 | 10R | Resistor_SMD:R_0603_1608Metric | 3 | yes | generic-stock | R2 R3 R32
 | 10k | Resistor_SMD:R_0603_1608Metric | 2 | yes | generic-stock | R27 R28
 | 10n | Capacitor_SMD:C_0603_1608Metric | 1 | yes | generic-stock | C17
 | 1k | Resistor_SMD:R_0603_1608Metric | 3 | yes | generic-stock | R33 R37 R38
 | 27k | Resistor_SMD:R_0603_1608Metric | 1 | yes | generic-stock | R25
 | 4.7k | Resistor_SMD:R_0603_1608Metric | 2 | yes | generic-stock | R10 R11
 | 4.7u | Capacitor_SMD:C_0603_1608Metric | 2 | yes | generic-stock | C10 C14
 | 47R | Resistor_SMD:R_0603_1608Metric | 1 | yes | generic-stock | R40
 | 47k | Resistor_SMD:R_0603_1608Metric | 3 | yes | generic-stock | R24 R45 R7
0ZCJ0075AF2E | 0.75A PTC | o2-probe:PTC_1206_3216Metric | 1 | yes | mpn | F1
AO3400A | AO3400A | Package_TO_SOT_SMD:SOT-23 | 1 | yes | mpn | Q2
AP63203WU-7 | AP63203WU-7 | Package_TO_SOT_SMD:TSOT-23-6 | 1 | yes | mpn | U1
BAT54W-G3-08 | BAT54W-G | Diode_SMD:D_SOD-123 | 1 | yes | mpn | D8
C1206C106K3RACTU | 10u 25V X7R | Capacitor_SMD:C_1206_3216Metric | 2 | yes | mpn | C1 C7
CRCW2512280RFKEG | 280R 1W | Resistor_SMD:R_2512_6332Metric | 2 | yes | mpn | RH1 RH2
EMK316BB7226ML-T | 22u | Capacitor_SMD:C_1206_3216Metric | 1 | yes | mpn | C3
LMP91000SDX/NOPB | LMP91000SD/NOPB | Package_SON:WSON-14-1EP_4.0x4.0mm_P0.5mm_EP2.6x2.6mm | 1 | yes | mpn | U7
OPA2333AIDGKR | OPA2333AIDGKR | Package_SO:VSSOP-8_3x3mm_P0.65mm | 1 | yes | mpn | U4
PMEG4010CEH,115 | PMEG4010CEH | Diode_SMD:D_SOD-123F | 1 | yes | mpn | D3
RC0603FR-071KL | 1k 1% | Resistor_SMD:R_0603_1608Metric | 1 | yes | mpn | R42
RC0603FR-0791KL | 91k 1% | Resistor_SMD:R_0603_1608Metric | 3 | yes | mpn | R26 R43 R44
REF3425IDBVR | REF3425IDBVR | Package_TO_SOT_SMD:SOT-23-6 | 1 | yes | mpn | U15
SGX-OX-ROHS-Mini | SGX-OX-ROHS-Mini | o2-probe:SGX-OX-ROHS-Mini_ISS2 | 1 | yes | mpn | U11
SHT45-AD1F-R2 | SHT45-AD1F | Sensor_Humidity:Sensirion_DFN-4_1.5x1.5mm_P0.8mm_SHT4x_NoCentralPad | 1 | yes | mpn | U12
SM712-02HTG | SM712-02HTG | Package_TO_SOT_SMD:SOT-23 | 1 | yes | mpn | D2
SMBJ15A-13-F | SMBJ15A-13-F | Diode_SMD:D_SMB | 1 | yes | mpn | D1
SRN6028C-4R7M | 4.7u SHIELDED | Inductor_SMD:L_6.3x6.3_H3 | 1 | yes | mpn | L1
STM32G071CBT7 | STM32G071CBT7 | Package_QFP:LQFP-48_7x7mm_P0.5mm | 1 | yes | mpn | U6
THVD1410DR | THVD1410DR | Package_SO:SOIC-8_3.9x4.9mm_P1.27mm | 1 | yes | mpn | U5
TMP117AIDRVR | TMP117 CELL | tmp117-probe:TMP117_WSON-6-1EP_2x2mm_TI | 1 | yes | mpn | U10
TMP302BDRLR | TMP302BDRLR | o2-probe:TMP302_DRL6_TI | 1 | yes | mpn | U16
TPD2E2U06QDBZRQ1 | TPD2E2U06-Q1 | Package_TO_SOT_SMD:SOT-23 | 1 | yes | mpn | D7
 | BRIDGE RX (PA3) | o2-probe:SolderWireNoRelief_J106 | 1 | yes | not-purchased | J106
 | BRIDGE TX (PA2) | o2-probe:SolderWireNoRelief_J105 | 1 | yes | not-purchased | J105
 | CELL_CE | TestPoint:TestPoint_Pad_D1.0mm | 1 | yes | not-purchased | TP3
 | CELL_WE | TestPoint:TestPoint_Pad_D1.0mm | 1 | yes | not-purchased | TP1
 | GND | TestPoint:TestPoint_Pad_D1.0mm | 1 | yes | not-purchased | TP2
 | GUARD | TestPoint:TestPoint_Pad_D1.0mm | 1 | yes | not-purchased | TP5
 | J1.1 BROWN +12V | Connector_Wire:SolderWire-0.25sqmm_1x01_D0.65mm_OD1.7mm_Relief | 1 | yes | not-purchased | J101
 | J1.2 WHITE GND | Connector_Wire:SolderWire-0.25sqmm_1x01_D0.65mm_OD1.7mm_Relief | 1 | yes | not-purchased | J102
 | J1.3 GREEN A | o2-probe:SolderWire_RaisedRelief_1x01 | 1 | yes | not-purchased | J103
 | J1.4 YELLOW B | o2-probe:SolderWire_RaisedRelief_1x01 | 1 | yes | not-purchased | J104
 | TC2030 SWD PRE-POT | Connector:Tag-Connect_TC2030-IDC-NL_2x03_P1.27mm_Vertical | 1 | yes | not-purchased | J3
 | TMP_CELL_EP | TestPoint:TestPoint_Pad_D1.0mm | 1 | yes | not-purchased | TP6
 | VREF | TestPoint:TestPoint_Pad_D1.0mm | 1 | yes | not-purchased | TP4
