fl4p/o2-probe/docs/gassensoren.csv

Datenblatt | Abbildung | DK-Teilenr. | Herst.-Teilenr. | Herst. | Lieferant | Beschreibung | Lagerbestand | Preis | @ qty | Mindestmenge | Verpackung | Serie | Produktstatus | Typ | Genauigkeit | Ausgang | Betriebstemperatur | Spannung - Versorgung | Strom - Versorgung | Sauerstoffbereich | URL
https://www.renesas.com/us/en/document/dst/rrh46410-datasheet?r=25439436 | //mm.digikey.com/Volume0/opasdata/d220001/medias/images/6348/RRH46410-A3V.jpg | 800-RRH46410-A3V-ND | RRH46410-A3V | Renesas Electronics Corporation | Renesas Electronics Corporation | SENSOR AIR QUALITY I2C OUTPUT | 252 | 3.196 | 5 | 1 | Tablett | - | Obsolet | Luftqualität | ±15% | I2C | -40°C bis 65°C | 1,8V bis 3,6V | - | - | https://www.digikey.de/de/products/detail/renesas-electronics-corporation/RRH46410-A3V/22079177
https://www.renesas.com/us/en/document/dst/rrh46410-datasheet?r=25439436 | - | 800-RRH46410-A3RTR-ND,800-RRH46410-A3RCT-ND,800-RRH46410-A3RDKR-ND | RRH46410-A3R | Renesas Electronics Corporation | Renesas Electronics Corporation | SENSOR AIR QUALITY I2C OUTPUT | 9 | 3.196 | 5 | 1 | Gurt auf Rolle (Tape and Reel - TR),Gurtabschnitt (CT),Digi-Reel® | - | Obsolet | Luftqualität | ±15% | I2C | -40°C bis 65°C | 1,8V bis 3,6V | - | - | https://www.digikey.de/de/products/detail/renesas-electronics-corporation/RRH46410-A3R/22079125
https://sgxsensortech.com/uploads/f_note/DS-0670-SGX6410_1.pdf | //mm.digikey.com/Volume0/opasdata/d220001/medias/images/8948/MFG_SGX4410-Axx.jpg | 1782-SGX4410-A1V-ND | SGX4410-A1V | Amphenol SGX Sensortech | Amphenol SGX Sensortech | DIGITAL VOC SENSOR 2000PPM, 12-L | 0 | 3.506 | 5 | 1 | Tablett | SGX | Aktiv | Luftqualität | ±2% | I2C | -40°C bis 125°C | 1,7V bis 3,6V | 27mA | - | https://www.digikey.de/de/products/detail/amphenol-sgx-sensortech/SGX4410-A1V/29777726
https://www.renesas.com/us/en/document/dst/zmod4510-datasheet | //mm.digikey.com/Volume0/opasdata/d220001/medias/images/324/MFG_ZMODxxxx-Series.jpg | 800-4329-ND | ZMOD4510AI1V | Renesas Electronics Corporation | Renesas Electronics Corporation | SENSOR AIR QUALITY I2C OUTPUT | 180 | 3.812 | 5 | 1 | Tablett | - | Obsolet | Luftqualität | ±15% | I2C | -40°C bis 65°C | 1,7V bis 3,6V | 11mA | - | https://www.digikey.de/de/products/detail/renesas-electronics-corporation/ZMOD4510AI1V/10211076
https://www.renesas.com/us/en/document/dst/zmod4510-datasheet | //mm.digikey.com/Volume0/opasdata/d220001/medias/images/324/MFG_ZMODxxxx-Series.jpg | 800-4330-2-ND,800-4330-1-ND,800-4330-6-ND | ZMOD4510AI1R | Renesas Electronics Corporation | Renesas Electronics Corporation | SENSOR AIR QUALITY I2C OUTPUT | 12.376 | 3.92 | 5 | 1 | Gurt auf Rolle (Tape and Reel - TR),Gurtabschnitt (CT),Digi-Reel® | - | Obsolet | Luftqualität | - | I2C | -40°C bis 65°C | 1,7V bis 3,6V | - | - | https://www.digikey.de/de/products/detail/renesas-electronics-corporation/ZMOD4510AI1R/10211077
https://sgxsensortech.com/uploads/f_note/DS-0670-SGX6410_1.pdf | //mm.digikey.com/Volume0/opasdata/d220001/medias/images/8948/MFG_SGX4410-Axx.jpg | 1782-SGX4410-A2V-ND | SGX4410-A2V | Amphenol SGX Sensortech | Amphenol SGX Sensortech | DIGITAL VOC SENSOR 2000PPM, STIC | 0 | 3.924 | 5 | 1 | Tablett | SGX | Aktiv | Luftqualität | ±2% | I2C | -40°C bis 125°C | 1,7V bis 3,6V | 27mA | - | https://www.digikey.de/de/products/detail/amphenol-sgx-sensortech/SGX4410-A2V/29777731
https://www.renesas.com/us/en/document/dst/zmod4510-datasheet | - | 800-ZMOD4510AI2RTR-ND,800-ZMOD4510AI2RCT-ND | ZMOD4510AI2R | Renesas Electronics Corporation | Renesas Electronics Corporation | SENSOR AIR QUALITY I2C OUTPUT | 3.177 | 4.164 | 5 | 1 | Gurt auf Rolle (Tape and Reel - TR),Gurtabschnitt (CT) | - | Obsolet | Luftqualität | ±2% | I2C | -40°C bis 65°C | 1,7V bis 3,6V | 11mA | - | https://www.digikey.de/de/products/detail/renesas-electronics-corporation/ZMOD4510AI2R/15196199
https://www.renesas.com/us/en/document/dst/zmod4510-datasheet | //mm.digikey.com/Volume0/opasdata/d220001/medias/images/6348/ZMOD4510AI2V.jpg | 800-ZMOD4510AI2V-ND | ZMOD4510AI2V | Renesas Electronics Corporation | Renesas Electronics Corporation | SENSOR AIR QUALITY I2C OUTPUT | 94 | 4.164 | 5 | 1 | Tablett | - | Obsolet | Luftqualität | ±15% | I2C | -40°C bis 65°C | 1,7V bis 3,6V | 11mA | - | https://www.digikey.de/de/products/detail/renesas-electronics-corporation/ZMOD4510AI2V/14010938
https://sgxsensortech.com/uploads/f_note/DS-0670-SGX6410_1.pdf | //mm.digikey.com/Volume0/opasdata/d220001/medias/images/8948/MFG_SGX4410-Axx.jpg | 1782-SGX4410-A3V-ND | SGX4410-A3V | Amphenol SGX Sensortech | Amphenol SGX Sensortech | DIGITAL VOC SENSOR, 2000PPM, IP6 | 0 | 4.164 | 5 | 1 | Tablett | SGX | Aktiv | Luftqualität | ±2% | I2C | -40°C bis 125°C | 1,7V bis 3,6V | 27mA | - | https://www.digikey.de/de/products/detail/amphenol-sgx-sensortech/SGX4410-A3V/29777727
https://sgxsensortech.com/uploads/f_note/DS-0670-SGX6410_1.pdf | //mm.digikey.com/Volume0/opasdata/d220001/medias/images/8948/MFG_SGX4410-Axx.jpg | 1782-SGX4410-A4V-ND | SGX4410-A4V | Amphenol SGX Sensortech | Amphenol SGX Sensortech | DIGITAL VOC SENSOR 2000PPM, IP67 | 0 | 4.448 | 5 | 1 | Tablett | SGX | Aktiv | Luftqualität | ±2% | I2C | -40°C bis 125°C | 1,7V bis 3,6V | 27mA | - | https://www.digikey.de/de/products/detail/amphenol-sgx-sensortech/SGX4410-A4V/29777733
https://www.renesas.com/us/en/document/dst/zmod4510-datasheet | - | 800-ZMOD4510AI3RTR-ND,800-ZMOD4510AI3RCT-ND | ZMOD4510AI3R | Renesas Electronics Corporation | Renesas Electronics Corporation | SENSOR AIR QUALITY I2C OUTPUT | 2.798 | 4.494 | 5 | 1 | Gurt auf Rolle (Tape and Reel - TR),Gurtabschnitt (CT) | - | Obsolet | Luftqualität | ±2% | I2C | -40°C bis 65°C | 1,7V bis 3,6V | 11mA | - | https://www.digikey.de/de/products/detail/renesas-electronics-corporation/ZMOD4510AI3R/15196196
https://www.renesas.com/us/en/document/dst/zmod4510-datasheet | //mm.digikey.com/Volume0/opasdata/d220001/medias/images/4841/ZMOD4510AI3V-%28primary%29.jpg | 800-ZMOD4510AI3V-ND | ZMOD4510AI3V | Renesas Electronics Corporation | Renesas Electronics Corporation | SENSOR AIR QUALITY I2C OUTPUT | 5 | 4.494 | 5 | 1 | Tablett | - | Obsolet | Luftqualität | ±15% | I2C | -40°C bis 65°C | 1,7V bis 3,6V | 11mA | - | https://www.digikey.de/de/products/detail/renesas-electronics-corporation/ZMOD4510AI3V/14010937
https://www.sciosense.com/wp-content/uploads/2023/12/ENS160-Datasheet.pdf | //mm.digikey.com/Volume0/opasdata/d220001/medias/images/4292/MFG_ENS160-BGLx.jpg | 2618-ENS160-BGLTTR-ND,2618-ENS160-BGLTCT-ND,2618-ENS160-BGLTDKR-ND | ENS160-BGLT | ScioSense | ScioSense | SENSOR AIR QUALITY I2C OUTPUT | 902 | 4.548 | 5 | 1 | Gurt auf Rolle (Tape and Reel - TR),Gurtabschnitt (CT),Digi-Reel® | - | Aktiv | Luftqualität | - | I2C, SPI | -40°C bis 85°C | 1,71V bis 1,98V | 29mA | - | https://www.digikey.de/de/products/detail/sciosense/ENS160-BGLT/16129831
https://www.sciosense.com/wp-content/uploads/2023/12/ENS160-Datasheet.pdf | //mm.digikey.com/Volume0/opasdata/d220001/medias/images/4292/MFG_ENS160-BGLx.jpg | 2618-ENS160-BGLMTR-ND,2618-ENS160-BGLMCT-ND,2618-ENS160-BGLMDKR-ND | ENS160-BGLM | ScioSense | ScioSense | SENSOR AIR QUALITY I2C OUTPUT | 1.475 | 4.886 | 5 | 1 | Gurt auf Rolle (Tape and Reel - TR),Gurtabschnitt (CT),Digi-Reel® | - | Aktiv | Luftqualität | - | I2C, SPI | -40°C bis 85°C | 1,71V bis 1,98V | 29mA | - | https://www.digikey.de/de/products/detail/sciosense/ENS160-BGLM/16129832
https://www.sciosense.com/wp-content/uploads/2023/12/ENS161-Datasheet.pdf | //mm.digikey.com/Volume0/opasdata/d220001/medias/images/5484/MFG_ENS161-BGLM.jpg | 2618-ENS161-BLGTTR-ND,2618-ENS161-BLGTCT-ND,2618-ENS161-BLGTDKR-ND | ENS161-BLGT | ScioSense | ScioSense | SENSOR AIR QUALITY I2C OUTPUT | 2.415 | 4.888 | 5 | 1 | Gurt auf Rolle (Tape and Reel - TR),Gurtabschnitt (CT),Digi-Reel® | - | Aktiv | Luftqualität | - | I2C, SPI | -40°C bis 85°C | 1,71V bis 1,98V | 12mA | - | https://www.digikey.de/de/products/detail/sciosense/ENS161-BLGT/21278460
https://www.sciosense.com/wp-content/uploads/2023/12/ENS161-Datasheet.pdf | //mm.digikey.com/Volume0/opasdata/d220001/medias/images/5484/MFG_ENS161-BGLM.jpg | 2618-ENS161-BLGMTR-ND,2618-ENS161-BLGMCT-ND | ENS161-BLGM | ScioSense | ScioSense | SENSOR AIR QUALITY I2C OUTPUT | 0 | 8.34 | 5 | 1 | Gurt auf Rolle (Tape and Reel - TR),Gurtabschnitt (CT) | - | Bei DigiKey nicht mehr erhältlich | Luftqualität | - | I2C, SPI | -40°C bis 85°C | 1,71V bis 1,98V | 12mA | - | https://www.digikey.de/de/products/detail/sciosense/ENS161-BLGM/21278459
https://wiki.dfrobot.com/sen0375/ | //mm.digikey.com/Volume0/opasdata/d220001/medias/images/3063/MFG_SEN0375.jpg | 1738-SEN0375-ND | SEN0375 | DFRobot | DFRobot | SENSOR AIR QUALITY I2C OUTPUT | 0 | 15.65 | 5 | 1 | Lose im Beutel | - | Aktiv | Luftqualität | - | I2C, SPI | -40°C bis 85°C | 3,3V bis 5,5V | 5mA | 300 mbar ~ 1.1 bar | https://www.digikey.de/de/products/detail/dfrobot/SEN0375/13590874
https://wiki.dfrobot.com/sen0537/ | //mm.digikey.com/Volume0/opasdata/d220001/medias/images/6311/SEN0537.jpg | 1738-SEN0537-ND | SEN0537 | DFRobot | DFRobot | SENSOR AIR QUALITY I2C OUTPUT | 12 | 26.14 | 5 | 1 | Lose im Beutel | - | Aktiv | Luftqualität | - | I2C | -10°C bis 80°C | 3,3V bis 5V | 29mA | - | https://www.digikey.de/de/products/detail/dfrobot/SEN0537/18069250
https://sgx.cdistore.com/datasheets/sgx/ds-0536-az65a.pdf | - | 1782-SGX-AZ65AC-ND | SGX-AZ65AC | Amphenol SGX Sensortech | Amphenol SGX Sensortech | 3-GAS (CO+NO2+NH3) AUTOMOTIVE AI | 0 | 34.39 | 5 | 1 | Lose im Beutel | SGX | Aktiv | Luftqualität | - | - | -40°C bis 85°C | 8V bis 18V | - | - | https://www.digikey.de/de/products/detail/amphenol-sgx-sensortech/SGX-AZ65AC/26249803
//mm.digikey.com/Volume0/opasdata/d220001/medias/docus/2507/DS-0229%20%28INIR%20Datasheet%29%20V8%20October%202018.pdf | //mm.digikey.com/Volume0/opasdata/d220001/medias/images/2580/INIR-ME100%25.jpg | 1782-INIR-ME100-ND | INIR-ME100 | Amphenol SGX Sensortech | Amphenol SGX Sensortech | SENSOR AIR QUALITY VOLTAGE OUT | 16 | 185.308 | 5 | 1 | Lose im Beutel | - | Obsolet | Luftqualität | - | Spannung | -40°C bis 75°C | 3,2V bis 5,25V | 32mA | - | https://www.digikey.de/de/products/detail/amphenol-sgx-sensortech/INIR-ME100/7102282
https://www.sgxsensortech.com/content/uploads/2019/03/INIR-PR-01-INIR-Propane-Datasheet.pdf | //mm.digikey.com/Volume0/opasdata/d220001/medias/images/6446/MFG_INIR-PR2.1.jpg | 1782-INIR-PR2.1-ND | INIR-PR2.1 | Amphenol SGX Sensortech | Amphenol SGX Sensortech | SENSOR AIR QUALITY VOLTAGE OUT | 10 | 188.772 | 5 | 1 | Lose im Beutel | - | Obsolet | Luftqualität | - | Spannung | -40°C bis 75°C | 3,2V bis 5,25V | 35mA | - | https://www.digikey.de/de/products/detail/amphenol-sgx-sensortech/INIR-PR2-1/10059608
https://www.sgxsensortech.com/content/uploads/2019/10/DS-0304-INIR-RF-R290-rev2.pdf | //mm.digikey.com/Volume0/opasdata/d220001/medias/images/192/MFG_INIR-RF-R290.jpg | 1782-INIR-RF-R290-ND | INIR-RF-R290 | Amphenol SGX Sensortech | Amphenol SGX Sensortech | SENSOR AIR QUALITY VOLTAGE OUT | 5 | 204.032 | 5 | 1 | Box | - | Aktiv | Luftqualität | - | Spannung | -40°C bis 75°C | 3,2V bis 5,25V | 35mA | - | https://www.digikey.de/de/products/detail/amphenol-sgx-sensortech/INIR-RF-R290/10718842
//mm.digikey.com/Volume0/opasdata/d220001/medias/docus/2507/DS-0229%20%28INIR%20Datasheet%29%20V8%20October%202018.pdf | //mm.digikey.com/Volume0/opasdata/d220001/medias/images/2579/INIR-CD5%25.jpg | 1782-INIR-CD5-ND | INIR-CD5 | Amphenol SGX Sensortech | Amphenol SGX Sensortech | SENSOR AIR QUALITY VOLTAGE OUT | 10 | 217.176 | 5 | 1 | Lose im Beutel | - | Obsolet | Luftqualität | - | Spannung | -40°C bis 75°C | 3,2V bis 5V | 35mA | - | https://www.digikey.de/de/products/detail/amphenol-sgx-sensortech/INIR-CD5/7102283
- | //mm.digikey.com/Volume0/opasdata/d220001/medias/images/8900/MFG_O2S-FR-T4-5P.jpg | 1921-O2S-FR-T4-5P-ND | O2S-FR-T4-5P | SST Sensing Ltd. | SST Sensing Ltd. | O2S-FR-T4-5P, SENSOR | 10 | 222.814 | 5 | 1 | Box | Zirconia | Aktiv | Luftqualität | < 5 mbar | - | -100°C bis 400°C | 4,35V | 1,85A | 2 mbar ~ 3000 mbar | https://www.digikey.de/de/products/detail/sst-sensing-ltd/O2S-FR-T4-5P/26864541
- | //mm.digikey.com/Volume0/opasdata/d220001/medias/images/8900/MFG_O2S-T2.jpg | 1921-O2S-T2-ND | O2S-T2 | SST Sensing Ltd. | SST Sensing Ltd. | O2S-T2, SENSOR | 9 | 222.814 | 5 | 1 | Box | Zirconia | Aktiv | Luftqualität | < 5 mbar | - | -100°C bis 250°C | 4V | 1,7A | 2 mbar ~ 3000 mbar | https://www.digikey.de/de/products/detail/sst-sensing-ltd/O2S-T2/26864544
- | //mm.digikey.com/Volume0/opasdata/d220001/medias/images/8900/MFG_OXY-LC-485.jpg | 1921-OXY-LC-485-ND | OXY-LC-485 | SST Sensing Ltd. | SST Sensing Ltd. | SENSOR OXYGEN RS485 OUTPUT | 1 | 227.168 | 5 | 1 | Lose im Beutel | - | Aktiv | Sauerstoff (O2) | ±0,5% | RS485 | -30°C bis 70°C | 8V bis 28V | 600mA | 260 mbar ~ 1.26 bar | https://www.digikey.de/de/products/detail/sst-sensing-ltd/OXY-LC-485/16720733
- | //mm.digikey.com/Volume0/opasdata/d220001/medias/images/8900/MFG_O2S-FR-T2-18C.jpg | 1921-O2S-FR-T2-18C-ND | O2S-FR-T2-18C | SST Sensing Ltd. | SST Sensing Ltd. | O2S-FR-T2-18C, SENSOR | 0 | 235.92 | 5 | 1 | Box | Zirconia | Aktiv | Luftqualität | < 5 mbar | - | -100°C bis 250°C | 4,35V | 1,85A | 2 mbar ~ 3000 mbar | https://www.digikey.de/de/products/detail/sst-sensing-ltd/O2S-FR-T2-18C/26864547
- | //mm.digikey.com/Volume0/opasdata/d220001/medias/images/8900/MFG_OXY-LC-485.jpg | 1921-OXY-LC-V25-455-ND | OXY-LC-V25-455 | SST Sensing Ltd. | SST Sensing Ltd. | SENSOR OXYGEN 0-10V OUTPUT | 7 | 268.668 | 5 | 1 | Lose im Beutel | - | Aktiv | Sauerstoff (O2) | ±0,5% | 0V bis 10V | -30°C bis 70°C | 20V bis 28V | 600mA | - | https://www.digikey.de/de/products/detail/sst-sensing-ltd/OXY-LC-V25-455/13243971
https://www.processsensing.com/docs/datasheet/DS0055rev5_ZrO2-OxygenMeasurementSystem.pdf | //mm.digikey.com/Volume0/opasdata/d220001/medias/images/8900/MFG_O2S-FR-T2-18BM-A.jpg | 1921-O2S-FR-T2-18BM-A-ND | O2S-FR-T2-18BM-A | SST Sensing Ltd. | SST Sensing Ltd. | O2S-FR-T2-18BM-A BIOMASS SENSOR | 1 | 270.69 | 5 | 1 | Box | Zirconia | Aktiv | Luftqualität | 0,5% | - | -100°C bis 250°C | 4,35V | 1,85A | 2 mbar ~ 3000 mbar | https://www.digikey.de/de/products/detail/sst-sensing-ltd/O2S-FR-T2-18BM-A/26864540
https://www.processsensing.com/docs/datasheet/DS0055rev5_ZrO2-OxygenMeasurementSystem.pdf | //mm.digikey.com/Volume0/opasdata/d220001/medias/images/8900/MFG_O2S-FR-T2-18BM-A.jpg | 1921-O2S-FR-T2-18BM-C-ND | O2S-FR-T2-18BM-C | SST Sensing Ltd. | SST Sensing Ltd. | O2S-FR-T2-18BM-C BIOMASS SENSOR | 0 | 270.69 | 5 | 1 | Box | Zirconia | Aktiv | Luftqualität | 0,5% | 4mA bis 20mA | -100°C bis 250°C | 20V bis 28V | 600mA | 260 mbar ~ 1260 mbar | https://www.digikey.de/de/products/detail/sst-sensing-ltd/O2S-FR-T2-18BM-C/26864546
- | //mm.digikey.com/Volume0/opasdata/d220001/medias/images/8900/MFG_OXY-LC-485.jpg | 1921-OXY-LC-A100-455-ND | OXY-LC-A100-455 | SST Sensing Ltd. | SST Sensing Ltd. | SENSOR OXYGEN 4MA-20MA OUTPUT | 2 | 270.852 | 5 | 1 | Lose im Beutel | - | Aktiv | Sauerstoff (O2) | ±0,5% | 4mA bis 20mA | -30°C bis 70°C | 20V bis 28V | 600mA | 260 mbar ~ 1.26 bar | https://www.digikey.de/de/products/detail/sst-sensing-ltd/OXY-LC-A100-455/16720728
- | //mm.digikey.com/Volume0/opasdata/d220001/medias/images/8900/MFG_OXY-LC-485.jpg | 1921-OXY-LC-A25-455-ND | OXY-LC-A25-455 | SST Sensing Ltd. | SST Sensing Ltd. | SENSOR OXYGEN 4MA-20MA OUTPUT | 4 | 273.036 | 5 | 1 | Lose im Beutel | - | Aktiv | Sauerstoff (O2) | ±0,5% | 4mA bis 20mA | -30°C bis 70°C | 20V bis 28V | 600mA | 260 mbar ~ 1.26 bar | https://www.digikey.de/de/products/detail/sst-sensing-ltd/OXY-LC-A25-455/16720749
- | //mm.digikey.com/Volume0/opasdata/d220001/medias/images/8900/MFG_OXY-LC-485.jpg | 1921-OXY-LC-V100-455-ND | OXY-LC-V100-455 | SST Sensing Ltd. | SST Sensing Ltd. | SENSOR OXYGEN 0-10V OUTPUT | 0 | 275.22 | 5 | 1 | Lose im Beutel | - | Aktiv | Sauerstoff (O2) | ±0,5% | 0V bis 10V | -30°C bis 70°C | 20V bis 28V | 600mA | 260 mbar ~ 1.26 bar | https://www.digikey.de/de/products/detail/sst-sensing-ltd/OXY-LC-V100-455/16720789
- | //mm.digikey.com/Volume0/opasdata/d220001/medias/images/8900/MFG_O2S-T2.jpg | 1921-O2S-T6-SH-ND | O2S-T6-SH | SST Sensing Ltd. | SST Sensing Ltd. | O2S-T6-SH, STDTEMP 220MM LONG TU | 10 | 286.236 | 5 | 1 | Box | Zirconia | Aktiv | Luftqualität | < 5 mbar | - | -100°C bis 250°C | 4V | 1,7A | 2 mbar ~ 3000 mbar | https://www.digikey.de/de/products/detail/sst-sensing-ltd/O2S-T6-SH/26864542
- | //mm.digikey.com/Volume0/opasdata/d220001/medias/images/8900/MFG_O2S-T2.jpg | 1921-O2S-T6-ND | O2S-T6 | SST Sensing Ltd. | SST Sensing Ltd. | O2S-T6, STDTEMP 400MM LONG TUBE | 4 | 300.036 | 5 | 1 | Box | Zirconia | Aktiv | Luftqualität | < 5 mbar | - | -100°C bis 250°C | 4V | 1,7A | 2 mbar ~ 3000 mbar | https://www.digikey.de/de/products/detail/sst-sensing-ltd/O2S-T6/26864543
- | //mm.digikey.com/Volume0/opasdata/d220001/medias/images/8900/MFG_O2S-T2.jpg | 1921-O2S-T6-H-ND | O2S-T6-H | SST Sensing Ltd. | SST Sensing Ltd. | O2S-T6-H, HITEMP 400MM LONG TUBE | 10 | 400.882 | 5 | 1 | Box | Zirconia | Aktiv | Luftqualität | < 5 mbar | - | -100°C bis 250°C | 4V | 1,7A | 2 mbar ~ 3000 mbar | https://www.digikey.de/de/products/detail/sst-sensing-ltd/O2S-T6-H/26864545
- | //mm.digikey.com/Volume0/opasdata/d220001/medias/images/8900/MFG_O2S-T2.jpg | 1921-O2S-T6-SH-H-ND | O2S-T6-SH-H | SST Sensing Ltd. | SST Sensing Ltd. | O2S-T6-SH-H, 220MM LONG TUBE HT | 10 | 421.224 | 5 | 1 | Box | Zirconia | Aktiv | Luftqualität | < 5 mbar | - | -100°C bis 250°C | 4V | 1,7A | 2 mbar ~ 3000 mbar | https://www.digikey.de/de/products/detail/sst-sensing-ltd/O2S-T6-SH-H/26864548
- | //mm.digikey.com/Volume0/opasdata/d220001/medias/images/8900/MFG_XZR200-B2-C1-D0.jpg | 1921-OXY-FLEX-0-ND | OXY-FLEX-0 | SST Sensing Ltd. | SST Sensing Ltd. | SENSOR OXYGEN | 1 | 952.25 | 5 | 1 | Lose im Beutel | Zirconia | Aktiv | Sauerstoff (O2) | ±1% | 0V bis 10V, 4mA bis 20mA, RS232 | -10°C bis 85°C | 21,6V bis 26,4V | 500mA | - | https://www.digikey.de/de/products/detail/sst-sensing-ltd/OXY-FLEX-0/16720717
https://www.processsensing.com/docs/datasheet/OXY-FLEX-Series-Oxygen-Transmitter-PST-DS-1400.pdf | //mm.digikey.com/Volume0/opasdata/d220001/medias/images/8900/MFG_XZR200-B2-C1-D0.jpg | 1921-XZR200-B2-C1-D0-ND | XZR200-B2-C1-D0 | SST Sensing Ltd. | SST Sensing Ltd. | ZIRCONIA OXYGEN TRANSMITTER 220M | 7 | 1014.842 | 5 | 1 | Lose im Beutel | OXY-FLEX | Aktiv | Sauerstoff (O2) | ±1% | 0V bis 10V, 4mA bis 20mA, RS232 | -10°C bis 85°C | 21,6V bis 26,4V | 1A | - | https://www.digikey.de/de/products/detail/sst-sensing-ltd/XZR200-B2-C1-D0/25796601
- | //mm.digikey.com/Volume0/opasdata/d220001/medias/images/8900/MFG_XZR200-B2-C1-D0.jpg | 1921-OXY-FLEX-1-ND | OXY-FLEX-1 | SST Sensing Ltd. | SST Sensing Ltd. | SENSOR OXYGEN | 1 | 1022.136 | 5 | 1 | Lose im Beutel | Zirconia | Aktiv | Sauerstoff (O2) | ±1% | 0V bis 10V, 4mA bis 20mA, RS232 | -10°C bis 85°C | 21,6V bis 26,4V | 500mA | - | https://www.digikey.de/de/products/detail/sst-sensing-ltd/OXY-FLEX-1/16720779
https://www.processsensing.com/docs/datasheet/OXY-FLEX-Series-Oxygen-Transmitter-PST-DS-1400.pdf | //mm.digikey.com/Volume0/opasdata/d220001/medias/images/8900/MFG_XZR200-B2-C1-D0.jpg | 1921-XZR200-B2-C2-D0-ND | XZR200-B2-C2-D0 | SST Sensing Ltd. | SST Sensing Ltd. | ZIRCONIA OXYGEN TRANSMITTER 400M | 7 | 1139.744 | 5 | 1 | Lose im Beutel | OXY-FLEX | Aktiv | Sauerstoff (O2) | ±1% | 0V bis 10V, 4mA bis 20mA, RS232 | -10°C bis 85°C | 21,6V bis 26,4V | 1A | - | https://www.digikey.de/de/products/detail/sst-sensing-ltd/XZR200-B2-C2-D0/25796587
https://www.processsensing.com/docs/datasheet/OXY-FLEX-Series-Oxygen-Transmitter-PST-DS-1400.pdf | //mm.digikey.com/Volume0/opasdata/d220001/medias/images/8900/MFG_XZR200-B2-C1-D0.jpg | 1921-XZR200-B2-C1-D1-ND | XZR200-B2-C1-D1 | SST Sensing Ltd. | SST Sensing Ltd. | ZIRCONIA OXYGEN TRANSMITTER 220M | 4 | 1222.148 | 5 | 1 | Lose im Beutel | OXY-FLEX | Aktiv | Sauerstoff (O2) | ±1% | 0V bis 10V, 4mA bis 20mA, RS232 | -10°C bis 85°C | 21,6V bis 26,4V | 1A | - | https://www.digikey.de/de/products/detail/sst-sensing-ltd/XZR200-B2-C1-D1/25796580
https://sensore-electronic.com/wp-content/uploads/2025/09/OXY-ProXT-Datasheet-1.pdf | //mm.digikey.com/Volume0/opasdata/d220001/medias/images/8899/MFG_6431_OPXT-D0-xxx-300.jpg | 6431-OPXT-D0-010-300-ND | OPXT-D0-010-300 | Sensore Electronic GmbH | Sensore Electronic GmbH | OXYGEN TRANSMITTER DIN RAIL HOUS | 5 | 1230.21 | 5 | 1 | Lose im Beutel | OXY-ProXT | Aktiv | Sauerstoff (O2) | ±1% | 0V bis 5V, 4mA bis 20mA | 10°C bis 100°C | 21,6V bis 26,4V | 250mA | 700 mbar ~ 1300 mbar | https://www.digikey.de/de/products/detail/sensore-electronic-gmbh/OPXT-D0-010-300/29268766
https://sensore-electronic.com/wp-content/uploads/2025/09/OXY-ProXT-Datasheet-1.pdf | //mm.digikey.com/Volume0/opasdata/d220001/medias/images/8899/MFG_6431_OPXT-D0-xxx-300.jpg | 6431-OPXT-D0-001-300-ND | OPXT-D0-001-300 | Sensore Electronic GmbH | Sensore Electronic GmbH | OXYGEN TRANSMITTER DIN RAIL HOUS | 5 | 1230.21 | 5 | 1 | Lose im Beutel | OXY-ProXT | Aktiv | Sauerstoff (O2) | ±1% | 0V bis 5V, 4mA bis 20mA | 10°C bis 100°C | 21,6V bis 26,4V | 250mA | 700 mbar ~ 1300 mbar | https://www.digikey.de/de/products/detail/sensore-electronic-gmbh/OPXT-D0-001-300/29268767
https://sensore-electronic.com/wp-content/uploads/2025/09/OXY-ProXT-Datasheet-1.pdf | //mm.digikey.com/Volume0/opasdata/d220001/medias/images/7171/MFG_OPXT-D0-xxx-300.jpg | 6431-OPXT-D0-250-300-ND | OPXT-D0-250-300 | Sensore Electronic GmbH | Sensore Electronic GmbH | OXYGEN TRANSMITTER DIN RAIL HOUS | 5 | 1230.21 | 5 | 1 | Lose im Beutel | OXY-ProXT | Aktiv | Sauerstoff (O2) | ±1% | 0V bis 5V, 4mA bis 20mA | 10°C bis 100°C | 21,6V bis 26,4V | 250mA | 700 mbar ~ 1300 mbar | https://www.digikey.de/de/products/detail/sensore-electronic-gmbh/OPXT-D0-250-300/29268768
https://www.processsensing.com/docs/datasheet/OXY-FLEX-Series-Oxygen-Transmitter-PST-DS-1400.pdf | //mm.digikey.com/Volume0/opasdata/d220001/medias/images/8900/MFG_XZR200-B2-C1-D0.jpg | 1921-XZR200-B2-C2-D1-ND | XZR200-B2-C2-D1 | SST Sensing Ltd. | SST Sensing Ltd. | ZIRCONIA OXYGEN TRANSMITTER 400M | 3 | 1346.138 | 5 | 1 | Lose im Beutel | OXY-FLEX | Aktiv | Sauerstoff (O2) | ±1% | 0V bis 10V, 4mA bis 20mA, RS232 | -10°C bis 85°C | 21,6V bis 26,4V | 1A | - | https://www.digikey.de/de/products/detail/sst-sensing-ltd/XZR200-B2-C2-D1/25796574
https://www.processsensing.com/docs/datasheet/OXY-FLEX-Series-Oxygen-Transmitter-PST-DS-1400.pdf | //mm.digikey.com/Volume0/opasdata/d220001/medias/images/8900/MFG_XZR200-B2-C1-D0.jpg | 1921-XZR200-B2-C4-D1-ND | XZR200-B2-C4-D1 | SST Sensing Ltd. | SST Sensing Ltd. | ZIRCONIA OXYGEN TRANSMITTER 600M | 4 | 1519.642 | 5 | 1 | Lose im Beutel | OXY-FLEX | Aktiv | Sauerstoff (O2) | ±1% | 0V bis 10V, 4mA bis 20mA, RS232 | -10°C bis 85°C | 21,6V bis 26,4V | 1A | - | https://www.digikey.de/de/products/detail/sst-sensing-ltd/XZR200-B2-C4-D1/25796589
https://sensore-electronic.com/wp-content/uploads/2025/09/OXY-ProXT2.pdf | //mm.digikey.com/Volume0/opasdata/d220001/medias/images/8952/MFG_OPXT2-D0-B-300.jpg | 6431-OPXT2-D0-B-300-ND | OPXT2-D0-B-300 | Sensore Electronic GmbH | Sensore Electronic GmbH | DUAL CHANNEL OXYGEN TRANSMITTER | 5 | 2024.24 | 5 | 1 | Lose im Beutel | OXY-ProXT | Aktiv | Sauerstoff (O2) | ±1% | 4mA bis 20mA | 10°C bis 100°C | 22V bis 26V | - | 700 mbar ~ 1300 mbar | https://www.digikey.de/de/products/detail/sensore-electronic-gmbh/OPXT2-D0-B-300/29783682
https://www.processsensing.com/docs/datasheet/OXY-FLEX-Series-Oxygen-Transmitter-PST-DS-1400.pdf | //mm.digikey.com/Volume0/opasdata/d220001/medias/images/8900/MFG_XZR200-B2-C1-D0.jpg | 1921-XZR211-B2-C1-D1-ND | XZR211-B2-C1-D1 | SST Sensing Ltd. | SST Sensing Ltd. | ZIRCONIA OXYGEN TRANSMITTER 220M | 5 | 2213.13 | 5 | 1 | Lose im Beutel | OXY-FLEX | Aktiv | Sauerstoff (O2) | ±1% | 0V bis 10V, 4mA bis 20mA, RS232 | -10°C bis 85°C | 21,6V bis 26,4V | 1A | - | https://www.digikey.de/de/products/detail/sst-sensing-ltd/XZR211-B2-C1-D1/25796615
https://www.processsensing.com/docs/datasheet/OXY-FLEX-Series-Oxygen-Transmitter-PST-DS-1400.pdf | //mm.digikey.com/Volume0/opasdata/d220001/medias/images/8900/MFG_XZR200-B2-C1-D0.jpg | 1921-XZR211-B2-C2-D1-ND | XZR211-B2-C2-D1 | SST Sensing Ltd. | SST Sensing Ltd. | ZIRCONIA OXYGEN TRANSMITTER 400M | 5 | 2340.57 | 5 | 1 | Lose im Beutel | OXY-FLEX | Aktiv | Sauerstoff (O2) | ±1% | 0V bis 10V, 4mA bis 20mA, RS232 | -10°C bis 85°C | 21,6V bis 26,4V | 1A | - | https://www.digikey.de/de/products/detail/sst-sensing-ltd/XZR211-B2-C2-D1/25796606
https://sgxsensortech.com/uploads/f_note/DS-0670-SGX6410_1.pdf | //mm.digikey.com/Volume0/opasdata/d220001/medias/images/8948/MFG_SGX4410-Axx.jpg | 1782-SGX6410-A3RTR-ND,1782-SGX6410-A3RCT-ND,1782-SGX6410-A3RDKR-ND | SGX6410-A3R | Amphenol SGX Sensortech | Amphenol SGX Sensortech | DIGITAL VOC MODULE 2000PPM, 20-L | 0 | Aktiv | 0 | 4000 | Gurt auf Rolle (Tape and Reel - TR),Gurtabschnitt (CT),Digi-Reel® | SGX | Aktiv | Luftqualität | - | I2C, UART | -40°C bis 85°C | 1,8V bis 3,6V | 18,7mA | - | https://www.digikey.de/de/products/detail/amphenol-sgx-sensortech/SGX6410-A3R/29777728
https://sgxsensortech.com/uploads/f_note/DS-0670-SGX6410_1.pdf | //mm.digikey.com/Volume0/opasdata/d220001/medias/images/8948/MFG_SGX4410-Axx.jpg | 1782-SGX4410-A1RTR-ND,1782-SGX4410-A1RCT-ND,1782-SGX4410-A1RDKR-ND | SGX4410-A1R | Amphenol SGX Sensortech | Amphenol SGX Sensortech | DIGITAL VOC SENSOR, 2000PPM, 12- | 0 | Aktiv | 0 | 4000 | Gurt auf Rolle (Tape and Reel - TR),Gurtabschnitt (CT),Digi-Reel® | SGX | Aktiv | Luftqualität | ±2% | I2C | -40°C bis 125°C | 1,7V bis 3,6V | 27mA | - | https://www.digikey.de/de/products/detail/amphenol-sgx-sensortech/SGX4410-A1R/29777725
https://sgxsensortech.com/uploads/f_note/DS-0670-SGX6410_1.pdf | //mm.digikey.com/Volume0/opasdata/d220001/medias/images/8948/MFG_SGX4410-Axx.jpg | 1782-SGX4410-A2RTR-ND,1782-SGX4410-A2RCT-ND,1782-SGX4410-A2RDKR-ND | SGX4410-A2R | Amphenol SGX Sensortech | Amphenol SGX Sensortech | DIGITAL VOC SENSOR 2000PPM, STIC | 0 | Aktiv | 0 | 4000 | Gurt auf Rolle (Tape and Reel - TR),Gurtabschnitt (CT),Digi-Reel® | SGX | Aktiv | Luftqualität | ±2% | I2C | -40°C bis 125°C | 1,7V bis 3,6V | 27mA | - | https://www.digikey.de/de/products/detail/amphenol-sgx-sensortech/SGX4410-A2R/29777734
https://sgxsensortech.com/uploads/f_note/DS-0670-SGX6410_1.pdf | //mm.digikey.com/Volume0/opasdata/d220001/medias/images/8948/MFG_SGX4410-Axx.jpg | 1782-SGX4410-A3RTR-ND,1782-SGX4410-A3RCT-ND,1782-SGX4410-A3RDKR-ND | SGX4410-A3R | Amphenol SGX Sensortech | Amphenol SGX Sensortech | DIGITAL VOC SENSOR 2000PPM, IP67 | 0 | Aktiv | 0 | 4000 | Gurt auf Rolle (Tape and Reel - TR),Gurtabschnitt (CT),Digi-Reel® | SGX | Aktiv | Luftqualität | ±2% | I2C | -40°C bis 125°C | 1,7V bis 3,6V | 27mA | - | https://www.digikey.de/de/products/detail/amphenol-sgx-sensortech/SGX4410-A3R/29777729
https://sgxsensortech.com/uploads/f_note/DS-0670-SGX6410_1.pdf | //mm.digikey.com/Volume0/opasdata/d220001/medias/images/8948/MFG_SGX4410-Axx.jpg | 1782-SGX4410-A4RTR-ND,1782-SGX4410-A4RCT-ND,1782-SGX4410-A4RDKR-ND | SGX4410-A4R | Amphenol SGX Sensortech | Amphenol SGX Sensortech | DIGITAL VOC SENSOR 2000PPM, IP67 | 0 | Aktiv | 0 | 4000 | Gurt auf Rolle (Tape and Reel - TR),Gurtabschnitt (CT),Digi-Reel® | SGX | Aktiv | Luftqualität | ±2% | I2C | -40°C bis 125°C | 1,7V bis 3,6V | 27mA | - | https://www.digikey.de/de/products/detail/amphenol-sgx-sensortech/SGX4410-A4R/29777732
https://www.sciosense.com/wp-content/uploads/2023/12/ENS160-Datasheet.pdf | //mm.digikey.com/Volume0/opasdata/d220001/medias/images/4890/MFG_ENS160-BGLR.jpg | 2618-ENS160-BGLRTR-ND | ENS160-BGLR | ScioSense | ScioSense | SENSOR AIR QUALITY I2C OUTPUT | 0 | Bei DigiKey nicht mehr erhältlich | 0 | 5000 | Gurt auf Rolle (Tape and Reel - TR) | - | Bei DigiKey nicht mehr erhältlich | Luftqualität | - | I2C, SPI | -40°C bis 85°C | 1,71V bis 1,98V | 29mA | - | https://www.digikey.de/de/products/detail/sciosense/ENS160-BGLR/16129833
https://www.sciosense.com/wp-content/uploads/2023/12/ENS161-Datasheet.pdf | //mm.digikey.com/Volume0/opasdata/d220001/medias/images/5484/MFG_ENS161-BGLM.jpg | 2618-ENS161-BLGRTR-ND | ENS161-BLGR | ScioSense | ScioSense | SENSOR AIR QUALITY I2C OUTPUT | 0 | Bei DigiKey nicht mehr erhältlich | 0 | 5000 | Gurt auf Rolle (Tape and Reel - TR) | - | Bei DigiKey nicht mehr erhältlich | Luftqualität | - | I2C, SPI | -40°C bis 85°C | 1,71V bis 1,98V | 12mA | - | https://www.digikey.de/de/products/detail/sciosense/ENS161-BLGR/21278458
//mm.digikey.com/Volume0/opasdata/d220001/medias/docus/2578/SGP30%20Datasheet.pdf | //mm.digikey.com/Volume0/opasdata/d220001/medias/images/2247/MFG_SGP30-2.jpg | 1649-1084-2-ND,1649-1084-1-ND | SGP30-2.5K | Sensirion AG | Sensirion AG | SENSOR AIR QUALITY I2C OUTPUT | 0 | Obsolet | 0 | 2500 | Gurt auf Rolle (Tape and Reel - TR),Gurtabschnitt (CT) | - | Obsolet | Luftqualität | ±10% | I2C | -40°C bis 85°C | 1,62V bis 1,98V | 48mA | - | https://www.digikey.de/de/products/detail/sensirion-ag/SGP30-2-5K/7400966
//mm.digikey.com/Volume0/opasdata/d220001/medias/docus/2592/SGPC3%20Datasheet.pdf | //mm.digikey.com/Volume0/opasdata/d220001/medias/images/2183/MFG_SGPC3-2.5K.jpg | 1649-1095-2-ND | SGPC3-2.5K | Sensirion AG | Sensirion AG | SENSOR AIR QUALITY I2C OUTPUT | 0 | Obsolet | 0 | 2500 | Gurt auf Rolle (Tape and Reel - TR) | - | Obsolet | Luftqualität | ±15% | I2C | -40°C bis 85°C | 1,62V bis 1,98V | 65µA | - | https://www.digikey.de/de/products/detail/sensirion-ag/SGPC3-2-5K/7652832
- | //mm.digikey.com/Volume0/opasdata/d220001/medias/images/329/MFG_SVM30-J.jpg | 1649-1120-ND | SVM30-J | Sensirion AG | Sensirion AG | SENSOR AIR QUALITY I2C OUTPUT | 0 | Obsolet | 0 | 80 | Lose im Beutel | - | Obsolet | Luftqualität | 0.15 | I2C | -20°C bis 85°C | 4,5 bis 5,5V | 49mA | - | https://www.digikey.de/de/products/detail/sensirion-ag/SVM30-J/9959550
https://www.sgxsensortech.com/content/uploads/2014/07/VQ62-VQ6-Thermal-Conductivity-Pellistor-%e2%80%93-2v.pdf | //mm.digikey.com/Volume0/opasdata/d220001/medias/images/2235/MFG_VQ600.JPG | VQ6MB-ND | VQ6MB | Amphenol SGX Sensortech | Amphenol SGX Sensortech | SENSOR AIR QUALITY VOLTAGE OUT | 0 | Aktiv | 0 | 20 | Lose im Beutel | VQ6 | Aktiv | Luftqualität | - | Spannung | 0°C bis 500°C | 2V | - | - | https://www.digikey.de/de/products/detail/amphenol-sgx-sensortech/VQ6MB/7101246
https://www.sgxsensortech.com/content/uploads/2019/10/DS-0305-INIR-RF-R32-rev1.pdf | //mm.digikey.com/Volume0/opasdata/d220001/medias/images/192/MFG_INIR-RF-32.jpg | 1782-INIR-RF-R32-ND | INIR-RF-R32 | Amphenol SGX Sensortech | Amphenol SGX Sensortech | SENSOR AIR QUALITY VOLTAGE OUT | 0 | Aktiv | 0 | 0 | Box | - | Aktiv | Luftqualität | - | Spannung | -40°C bis 75°C | 3,2V bis 5,25V | 35mA | - | https://www.digikey.de/de/products/detail/amphenol-sgx-sensortech/INIR-RF-R32/10718542
- | - | 1649-SVM30-Y-ND | SVM30-Y | Sensirion AG | Sensirion AG | SENSOR AIR QUALITY I2C OUTPUT | 0 | Obsolet | 0 | 0 | Tablett | - | Obsolet | Luftqualität | 0.15 | I2C | -20°C bis 85°C | 4,5V bis 5,5V | 49mA | - | https://www.digikey.de/de/products/detail/sensirion-ag/SVM30-Y/13684013
https://www.renesas.com/us/en/document/dst/zmod4510-datasheet | //mm.digikey.com/Volume0/opasdata/d220001/medias/images/6348/ZMOD4510AI4V.jpg | 800-ZMOD4510AI4V-ND | ZMOD4510AI4V | Renesas Electronics Corporation | Renesas Electronics Corporation | SENSOR AIR QUALITY I2C OUTPUT | 0 | Obsolet | 0 | 0 | Tablett | - | Obsolet | Luftqualität | ±15% | I2C | -40°C bis 65°C | 1,7V bis 3,6V | 11mA | - | https://www.digikey.de/de/products/detail/renesas-electronics-corporation/ZMOD4510AI4V/14010941
https://www.renesas.com/us/en/document/dst/zmod4510-datasheet | //mm.digikey.com/Volume0/opasdata/d220001/medias/images/4754/800_LGG12D1__12.jpg | 800-ZMOD4510AI4RTR-ND,800-ZMOD4510AI4RCT-ND,800-ZMOD4510AI4RDKR-ND | ZMOD4510AI4R | Renesas Electronics Corporation | Renesas Electronics Corporation | SENSOR AIR QUALITY I2C OUTPUT | 0 | Obsolet | 0 | 0 | Gurt auf Rolle (Tape and Reel - TR),Gurtabschnitt (CT),Digi-Reel® | - | Obsolet | Luftqualität | ±2% | I2C | -40°C bis 65°C | 1,7V bis 3,6V | 11mA | - | https://www.digikey.de/de/products/detail/renesas-electronics-corporation/ZMOD4510AI4R/15196197
https://www.renesas.com/us/en/document/dst/zmod4410-datasheet?r=454426 | //mm.digikey.com/Volume0/opasdata/d220001/medias/images/7181/MFG_ZMOD4410AI4R.jpg | 800-ZMOD4410AI4RTR-ND | ZMOD4410AI4R | Renesas Electronics Corporation | Renesas Electronics Corporation | SENSOR AIR QUALITY I2C OUTPUT | 0 | Obsolet | 0 | 0 | Gurt auf Rolle (Tape and Reel - TR) | - | Obsolet | Luftqualität | ±15% | I2C | -40°C bis 65°C | 1,7V bis 3,6V | 7,4mA | - | https://www.digikey.de/de/products/detail/renesas-electronics-corporation/ZMOD4410AI4R/21408046
https://www.renesas.com/us/en/document/dst/zmod4410-datasheet?r=454426 | //mm.digikey.com/Volume0/opasdata/d220001/medias/images/7181/MFG_ZMOD4410AI4R.jpg | 800-ZMOD4410AI4V-ND | ZMOD4410AI4V | Renesas Electronics Corporation | Renesas Electronics Corporation | SENSOR AIR QUALITY I2C OUTPUT | 0 | Obsolet | 0 | 0 | Tablett | - | Obsolet | Luftqualität | ±15% | I2C | -40°C bis 65°C | 1,7V bis 3,6V | 7,4mA | - | https://www.digikey.de/de/products/detail/renesas-electronics-corporation/ZMOD4410AI4V/21409793
https://sgxsensortech.com/uploads/f_note/DS-0442-PID-10.6eV%2010K.pdf | //mm.digikey.com/Volume0/opasdata/d220001/medias/images/6448/MFG_PID-10.6EV-100A.jpg | 1782-PID-10.6EV-10KB-ND | PID-10.6EV-10KB | Amphenol SGX Sensortech | Amphenol SGX Sensortech | PID SENSOR 10.6EV LAMP, MDL 500P | 0 | Obsolet | 0 | 0 | Lose im Beutel | SGX | Obsolet | Luftqualität | - | Spannung | -40°C bis 65°C | 3,6V bis 10V | 32mA | 0 mbar ~ 250 bar | https://www.digikey.de/de/products/detail/amphenol-sgx-sensortech/PID-10-6EV-10KB/25324679
https://sgxsensortech.com/uploads/f_note/DS-0497-PS4-SMELL-500-MOD.pdf | //mm.digikey.com/Volume0/opasdata/d220001/medias/images/6470/MFG_PS4-AQI-10-MOD.jpg | 1782-PS4-SMELL-500-MOD-ND | PS4-SMELL-500-MOD | Amphenol SGX Sensortech | Amphenol SGX Sensortech | SMELL 500PPM | 0 | Obsolet | 0 | 0 | Lose im Beutel | PS4 | Obsolet | Luftqualität | ±5% | UART | -40°C bis 85°C | 3,3V bis 5,5V | 5mA | 0 mbar ~ 12.5 bar | https://www.digikey.de/de/products/detail/amphenol-sgx-sensortech/PS4-SMELL-500-MOD/25324688
https://sgxsensortech.com/uploads/f_note/DS-0415-PID-10.6eV%2040.pdf | //mm.digikey.com/Volume0/opasdata/d220001/medias/images/6448/MFG_PID-10.6EV-100A.jpg | 1782-PID-10.6EV-40B-ND | PID-10.6EV-40B | Amphenol SGX Sensortech | Amphenol SGX Sensortech | PID SENSOR 10.6EV LAMP, MDL 1PPB | 0 | Obsolet | 0 | 0 | Lose im Beutel | PID | Obsolet | Luftqualität | - | Spannung | -40°C bis 65°C | 3V bis 3,6V | 32mA | 0 mbar ~ 1 bar | https://www.digikey.de/de/products/detail/amphenol-sgx-sensortech/PID-10-6EV-40B/25324723
https://sgxsensortech.com/uploads/f_note/DS-0415-PID-10.6eV%2040.pdf | //mm.digikey.com/Volume0/opasdata/d220001/medias/images/6448/MFG_PID-10.6EV-100A.jpg | 1782-PID-10.6EV-40A-ND | PID-10.6EV-40A | Amphenol SGX Sensortech | Amphenol SGX Sensortech | PID SENSOR 10.6EV LAMP, MDL 1PPB | 0 | Obsolet | 0 | 0 | Lose im Beutel | SGX | Obsolet | Luftqualität | - | Spannung | -40°C bis 65°C | 3,2V bis 3,6V | 32mA | 0 mbar ~ 1 bar | https://www.digikey.de/de/products/detail/amphenol-sgx-sensortech/PID-10-6EV-40A/25324730
https://sgxsensortech.com/uploads/f_note/DS-0408-PID-10.6eV%204K.pdf | //mm.digikey.com/Volume0/opasdata/d220001/medias/images/6448/MFG_PID-10.6EV-100A.jpg | 1782-PID-10.6EV-4KB-ND | PID-10.6EV-4KB | Amphenol SGX Sensortech | Amphenol SGX Sensortech | PID SENSOR 10.6EV LAMP, MDL 100P | 0 | Obsolet | 0 | 0 | Lose im Beutel | PID | Obsolet | Luftqualität | - | Spannung | -40°C bis 65°C | 3,6V bis 10V | 32mA | 0 mbar ~ 100 bar | https://www.digikey.de/de/products/detail/amphenol-sgx-sensortech/PID-10-6EV-4KB/25324733
https://sgxsensortech.com/uploads/f_note/DS-0408-PID-10.6eV%204K.pdf | //mm.digikey.com/Volume0/opasdata/d220001/medias/images/6448/MFG_PID-10.6EV-100A.jpg | 1782-PID-10.6EV-4KA-ND | PID-10.6EV-4KA | Amphenol SGX Sensortech | Amphenol SGX Sensortech | PID SENSOR 10.6EV LAMP, MDL 100P | 0 | Obsolet | 0 | 0 | Lose im Beutel | PID | Obsolet | Luftqualität | - | Spannung | -40°C bis 65°C | 3,2V bis 3,6V | 32mA | 0 mbar ~ 100 bar | https://www.digikey.de/de/products/detail/amphenol-sgx-sensortech/PID-10-6EV-4KA/25324745
https://sgxsensortech.com/uploads/f_note/DS-0442-PID-10.6eV%2010K.pdf | //mm.digikey.com/Volume0/opasdata/d220001/medias/images/6448/MFG_PID-10.6EV-100A.jpg | 1782-PID-10.6EV-10KA-ND | PID-10.6EV-10KA | Amphenol SGX Sensortech | Amphenol SGX Sensortech | PID SENSOR 10.6EV LAMP, MDL 500P | 0 | Obsolet | 0 | 0 | Lose im Beutel | PID | Obsolet | Luftqualität | - | Spannung | -40°C bis 65°C | 3V bis 3,6V | 32mA | 0 mbar ~ 250 bar | https://www.digikey.de/de/products/detail/amphenol-sgx-sensortech/PID-10-6EV-10KA/25324750
https://sgxsensortech.com/uploads/f_note/DS-0407-PID-10.6eV-200.pdf | //mm.digikey.com/Volume0/opasdata/d220001/medias/images/6448/MFG_PID-10.6EV-100A.jpg | 1782-PID-10.6EV-200A-ND | PID-10.6EV-200A | Amphenol SGX Sensortech | Amphenol SGX Sensortech | PID SENSOR 10.6EV LAMP, MDL 20PP | 0 | Obsolet | 0 | 0 | Lose im Beutel | PID | Obsolet | Luftqualität | - | Spannung | -40°C bis 65°C | 3,2V bis 3,6V | 32mA | 0 mbar ~ 5 bar | https://www.digikey.de/de/products/detail/amphenol-sgx-sensortech/PID-10-6EV-200A/25324752
https://sgxsensortech.com/uploads/f_note/DS-0407-PID-10.6eV-200.pdf | //mm.digikey.com/Volume0/opasdata/d220001/medias/images/6448/MFG_PID-10.6EV-100A.jpg | 1782-PID-10.6EV-200B-ND | PID-10.6EV-200B | Amphenol SGX Sensortech | Amphenol SGX Sensortech | PID SENSOR 10.6EV LAMP, MDL 20PP | 0 | Obsolet | 0 | 0 | Lose im Beutel | PID | Obsolet | Luftqualität | - | Spannung | -40°C bis 65°C | 3,6V bis 10V | 32mA | 0 mbar ~ 5 bar | https://www.digikey.de/de/products/detail/amphenol-sgx-sensortech/PID-10-6EV-200B/25324779
https://sensorsandpower.angst-pfister.com/fileadmin/products/datasheets/272/1620-21914-0004-E-1023.pdf | //mm.digikey.com/Volume0/opasdata/d220001/medias/images/6605/MFG_PZA-MC25-P.jpg | 4814-PZA-MC25-P-ND | PZA-MC25-P | Angst+Pfister Sensors and Power AG | Angst+Pfister Sensors and Power AG | O2 gas sensor(0.0001- 25vol.-%) | 1 | Aktiv | 5 | 1 | Lose im Beutel | Zirconia (0.0001 - 25vol.-%O2) | Aktiv | Sauerstoff (O2) | - | 4 bis 20mA | -10°C bis 80°C | 24V | 2A | - | https://www.digikey.de/de/products/detail/angst-pfister-sensors-and-power-ag/PZA-MC25-P/26236821
