fl4p/o2-probe/model/results/prototype-study/axial_diffusion_sensitivity.csv

design | case | volume_cm3 | free_area_mm2 | axial_length_mm | sensor_distance_from_membrane_mm | effective_axial_diffusivity_m2_s | effective_axial_diffusivity_provenance | effective_axial_diffusivity_source | installed_conductance_scale | cell_tau_s | empirical_access_tau_s | t90_s | settling_time_2pct_s | steady_bias_o2_pct_wet | steady_state_reached | response_metrics_valid | passes_settling_limit | transport_model | heater_power_w | heater_convection_modeled | humidity_effect_modeled | axial_nodes
existing_rev_a_axial | central | 23.3 | 193.05 | 44.0 | 32.5 | 1e-05 | sensitivity_only | unmeasured effective axial gas-path sensitivity spanning obstruction-free to obstruction-penalized diffusion; fit from complete-path prototype steps before prediction | 1.0 | 4.343 | 0.0 | 201.7196637801954 | 331.5 | -0.004301168273208589 | True | True | False | axial_finite_volume_diffusion | 0.0 | False | False | 41
existing_rev_a_axial | central | 23.3 | 193.05 | 44.0 | 32.5 | 1.5e-05 | sensitivity_only | unmeasured effective axial gas-path sensitivity spanning obstruction-free to obstruction-penalized diffusion; fit from complete-path prototype steps before prediction | 1.0 | 4.343 | 0.0 | 137.35154471973627 | 224.5 | -0.002887335652800971 | True | True | False | axial_finite_volume_diffusion | 0.0 | False | False | 41
existing_rev_a_axial | central | 23.3 | 193.05 | 44.0 | 32.5 | 2e-05 | sensitivity_only | unmeasured effective axial gas-path sensitivity spanning obstruction-free to obstruction-penalized diffusion; fit from complete-path prototype steps before prediction | 1.0 | 4.343 | 0.0 | 105.21001442141386 | 171.25 | -0.0021803399604181095 | True | True | False | axial_finite_volume_diffusion | 0.0 | False | False | 41
existing_rev_a_axial | central | 23.3 | 193.05 | 44.0 | 32.5 | 2.5e-05 | sensitivity_only | unmeasured effective axial gas-path sensitivity spanning obstruction-free to obstruction-penalized diffusion; fit from complete-path prototype steps before prediction | 1.0 | 4.343 | 0.0 | 85.95543039794472 | 139.25 | -0.0017561200217102169 | True | True | False | axial_finite_volume_diffusion | 0.0 | False | False | 41
existing_rev_a_axial | central | 23.3 | 193.05 | 44.0 | 32.5 | 3e-05 | sensitivity_only | unmeasured effective axial gas-path sensitivity spanning obstruction-free to obstruction-penalized diffusion; fit from complete-path prototype steps before prediction | 1.0 | 4.343 | 0.0 | 73.14357451599301 | 118.0 | -0.001473298432031811 | True | True | True | axial_finite_volume_diffusion | 0.0 | False | False | 41
existing_rev_a_axial | hard_geometry_no_empirical_access_lag | 26.3 | 183.0 | 44.0 | 36.0 | 1e-05 | sensitivity_only | unmeasured effective axial gas-path sensitivity spanning obstruction-free to obstruction-penalized diffusion; fit from complete-path prototype steps before prediction | 0.05 | 10.0 | 0.0 | 309.572674568418 | 504.75 | -0.005378670644955008 | True | True | False | axial_finite_volume_diffusion | 0.0 | False | False | 41
existing_rev_a_axial | hard_geometry_no_empirical_access_lag | 26.3 | 183.0 | 44.0 | 36.0 | 1.5e-05 | sensitivity_only | unmeasured effective axial gas-path sensitivity spanning obstruction-free to obstruction-penalized diffusion; fit from complete-path prototype steps before prediction | 0.05 | 10.0 | 0.0 | 245.3066582267943 | 399.5 | -0.00400737426874187 | True | True | False | axial_finite_volume_diffusion | 0.0 | False | False | 41
existing_rev_a_axial | hard_geometry_no_empirical_access_lag | 26.3 | 183.0 | 44.0 | 36.0 | 2e-05 | sensitivity_only | unmeasured effective axial gas-path sensitivity spanning obstruction-free to obstruction-penalized diffusion; fit from complete-path prototype steps before prediction | 0.05 | 10.0 | 0.0 | 213.47999484724625 | 347.5 | -0.0033254314747992453 | True | True | False | axial_finite_volume_diffusion | 0.0 | False | False | 41
existing_rev_a_axial | hard_geometry_no_empirical_access_lag | 26.3 | 183.0 | 44.0 | 36.0 | 2.5e-05 | sensitivity_only | unmeasured effective axial gas-path sensitivity spanning obstruction-free to obstruction-penalized diffusion; fit from complete-path prototype steps before prediction | 0.05 | 10.0 | 0.0 | 194.5384564857602 | 316.75 | -0.0029202049902856686 | True | True | False | axial_finite_volume_diffusion | 0.0 | False | False | 41
existing_rev_a_axial | hard_geometry_no_empirical_access_lag | 26.3 | 183.0 | 44.0 | 36.0 | 3e-05 | sensitivity_only | unmeasured effective axial gas-path sensitivity spanning obstruction-free to obstruction-penalized diffusion; fit from complete-path prototype steps before prediction | 0.05 | 10.0 | 0.0 | 181.99676780489142 | 296.25 | -0.0026537315875181378 | True | True | False | axial_finite_volume_diffusion | 0.0 | False | False | 41
