fl4p/o2-probe/hw/literature/bom-capacitors/DigiKey n.d. GRM31CR71E106KA12L.md

# DigiKey n.d. GRM31CR71E106KA12L

Source: [D1](https://www.digikey.com/en/products/detail/murata-electronics/GRM31CR71E106KA12L/2345330)

Accessed: 2026-09-09. Evidence: inspected; route: native HTML/DOM; validation: validated.

Exact product attributes agree with M1. Availability: 0 in stock; 2000 expected 23 September 2026. Cut-tape SKU 490-6518-1-ND. The 32611-stock substitute row is KEMET, not the Murata part.
