fl4p/o2-probe/hw/literature/bom-capacitors/INDEX.md

# BOM capacitor sources

Manufacturer specifications and exact distributor listings inspected on 9 September 2026. Stock is a dated observation.

| ID | Source | SHA-256 prefix | Evidence |
|---|---|---|---|
| M1 | [Murata n.d. GRM31CR71E106KA12L](<Murata n.d. GRM31CR71E106KA12L.md>) ([original](https://pim.murata.com/en-us/pim/details/?partNum=GRM31CR71E106KA12L)) | f033183 | Appearance & Shape, Specifications and References: exact L suffix is 10 µF ±10%, 25 VDC, X7R, 1206. Inspected native browser DOM after initial application shell completed rendering; no graph values extracted. |
| K1 | [KEMET 2026 C0603C102J5GACTU](<KEMET 2026 C0603C102J5GACTU.pdf>) ([original](https://yageogroup.com/download/specsheet/C0603C102J5GACTU)) | a5bba4e | Generated 09/09/2026, page 1 Specifications and Dimensions: 1000 pF ±5%, 50 VDC, C0G, 0603, −55…125 °C. Nominal measurement at 1 MHz, 1 Vrms. Raw PDF text validated against rendered page 1. |
| K2 | [KEMET 2026 C1206C106K3RACTU](<KEMET 2026 C1206C106K3RACTU.pdf>) ([original](https://yageogroup.com/component-documentation/download/specsheet/C1206C106K3RACTU?lang=en)) | a2c5163 | Generated 09/09/2026, page 1 Specifications and Dimensions: 10 µF ±10%, 25 VDC, X7R, 1206, −55…125 °C. Nominal measurement at 1 kHz, 1 Vrms. Raw PDF text validated against rendered page 1. |
| D1 | [DigiKey n.d. GRM31CR71E106KA12L](<DigiKey n.d. GRM31CR71E106KA12L.md>) ([original](https://www.digikey.com/en/products/detail/murata-electronics/GRM31CR71E106KA12L/2345330)) | c452564 | Exact product attributes agree with M1. Availability: 0 in stock; 2000 expected 23 September 2026. Cut-tape SKU 490-6518-1-ND. The 32611-stock substitute row is KEMET, not the Murata part. |
| D2 | [DigiKey n.d. C0603C102J5GACTU](<DigiKey n.d. C0603C102J5GACTU.md>) ([original](https://www.digikey.com/en/products/detail/kemet/C0603C102J5GACTU/608471)) | 833817b | Exact product attributes agree with K1. Availability: 464623 in stock, cut-tape SKU 399-C0603C102J5GACTUCT-ND. This is distributor stock, not Fab inventory. |
| D3 | [DigiKey n.d. C1206C106K3RACTU](<DigiKey n.d. C1206C106K3RACTU.md>) ([original](https://www.digikey.com/en/products/detail/kemet/C1206C106K3RACTU/3317476)) | 0a616f5 | Exact product attributes agree with K2. Availability: 32611 in stock, cut-tape SKU 399-C1206C106K3RACTUCT-ND. This is distributor stock, not Fab inventory. |
