fl4p/o2-probe/hw/literature/bom-capacitors/Murata n.d. GRM31CR71E106KA12L.md

# Murata n.d. GRM31CR71E106KA12L

Source: [M1](https://pim.murata.com/en-us/pim/details/?partNum=GRM31CR71E106KA12L)

Accessed: 2026-09-09. Evidence: inspected; route: native HTML/DOM; validation: validated.

Appearance & Shape, Specifications and References: exact L suffix is 10 µF ±10%, 25 VDC, X7R, 1206. Inspected native browser DOM after initial application shell completed rendering; no graph values extracted.
