fl4p/o2-probe/hw/routing/2layer-bom39/copper-bottom.png

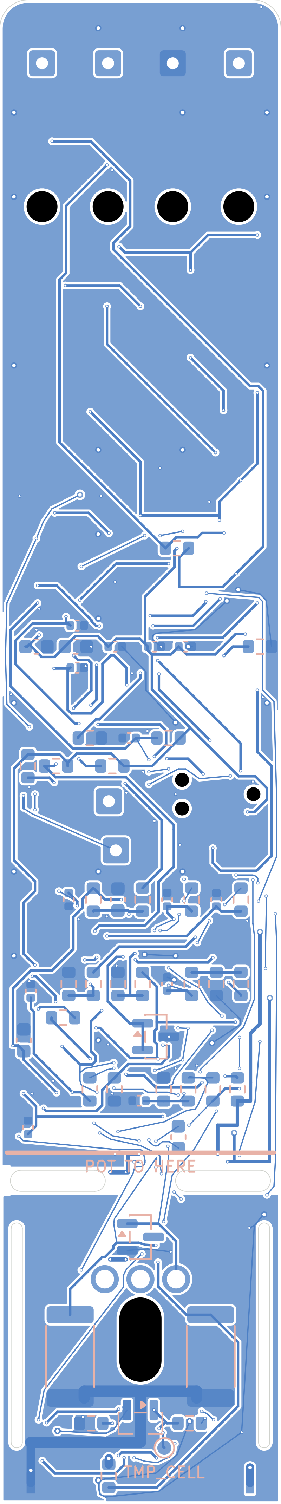
hw/routing/2layer-bom39/copper-bottom.png
