fl4p/o2-probe/hw/routing/2layer-bom39/copper-top.png

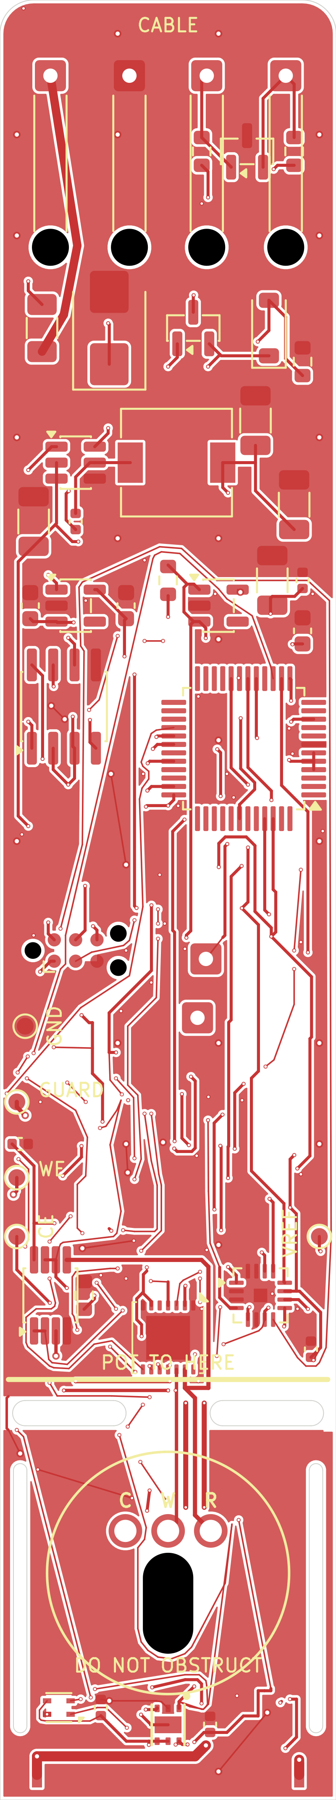
hw/routing/2layer-bom39/copper-top.png
