fl4p/o2-probe/cad/exports/o2_probe_assembly.3mf

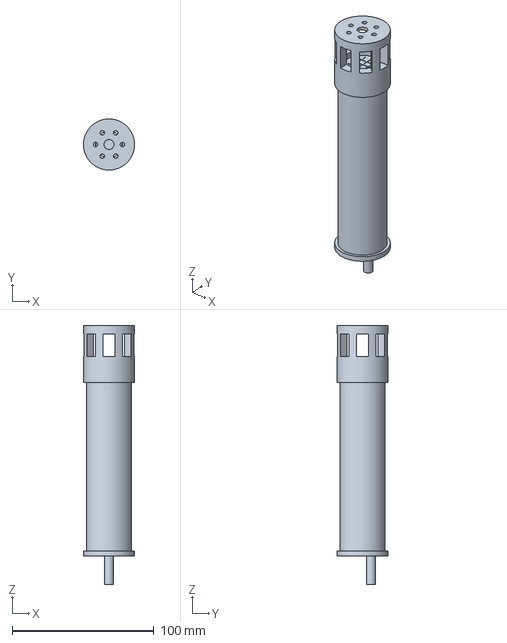
[picture p47: CAD file, 2026-08-23]
cad/exports/o2_probe_assembly.3mf
36.0 x 36.0 x 182.5 mm
