fl4p/o2-probe/cad/exports/body-cap.stl

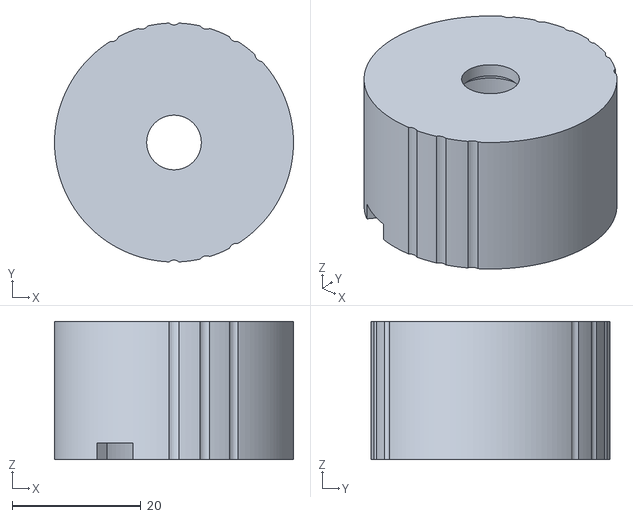
[picture p48: CAD file, 2026-11-02]
cad/exports/body-cap.stl
37.2 x 37.2 x 21.5
