fl4p/o2-probe/cad/exports/body-monobody.stl

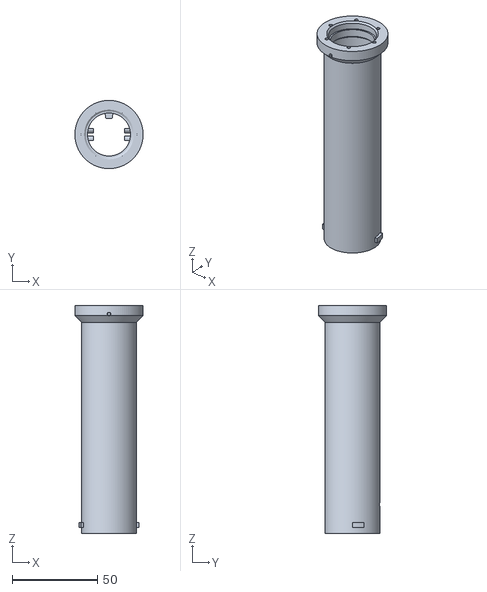
[picture p49: CAD file, 2026-11-02]
cad/exports/body-monobody.stl
40.0 x 40.0 x 133.6
