fl4p/o2-probe/cad/exports/body-dam.stl

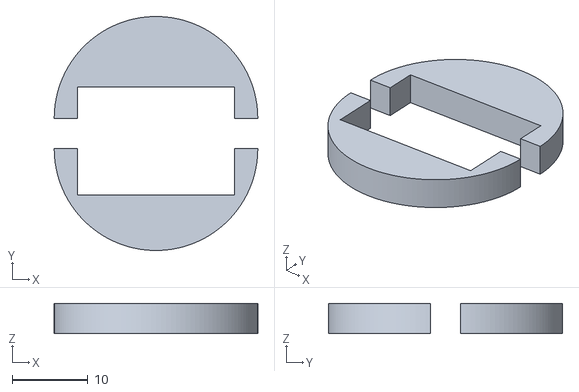
[picture p50: CAD file, 2026-11-02]
cad/exports/body-dam.stl
26.8 x 30.8 x 4.00
