fl4p/o2-probe/cad/exports/body-tube.stl

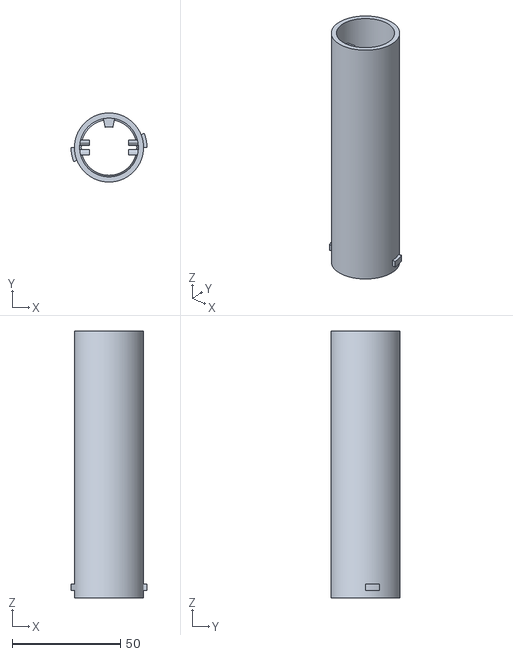
[picture p51: CAD file, 2026-11-02]
cad/exports/body-tube.stl
35.2 x 32.0 x 123.6
