fl4p/o2-probe/cad/exports/asa-retainer-print.stl

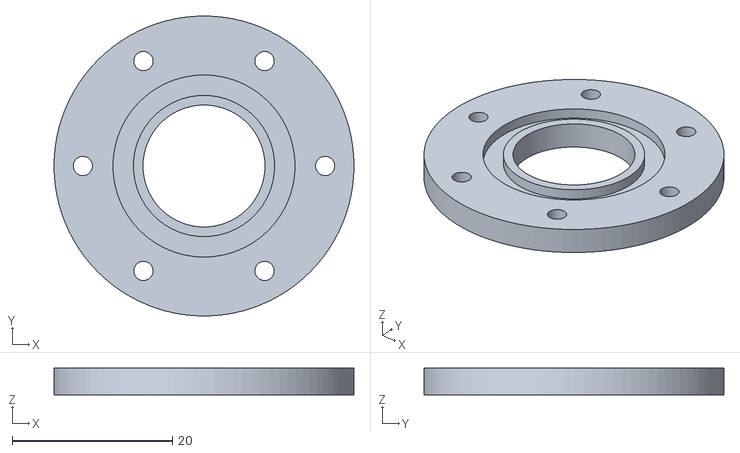
[picture p52: CAD file, 2026-09-30]
cad/exports/asa-retainer-print.stl
37.4 x 37.4 x 3.32
