fl4p/o2-probe/cad/exports/asa-carrier-print.stl

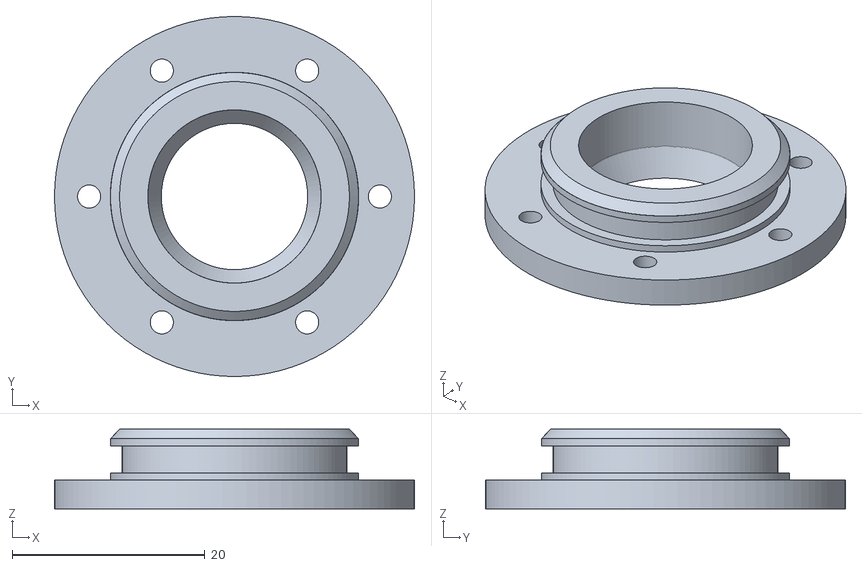
[picture p53: CAD file, 2026-09-30]
cad/exports/asa-carrier-print.stl
37.4 x 37.4 x 8.30
