fl4p/o2-probe/cad/exports/shell-half-back.stl

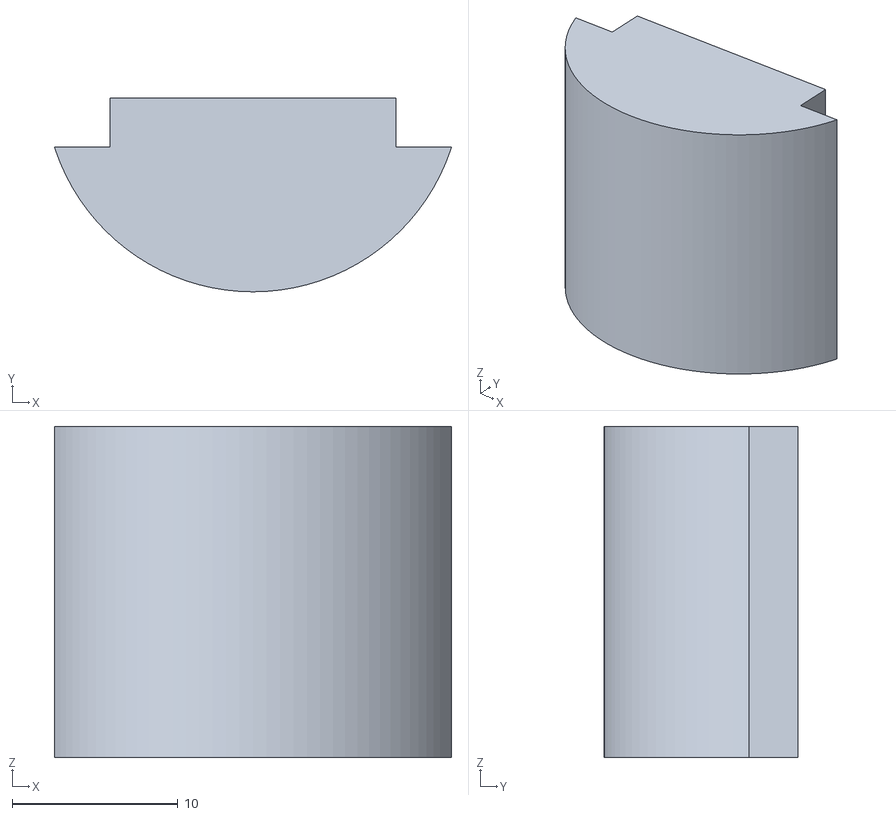
[picture p54: CAD file, 2026-09-06]
cad/exports/shell-half-back.stl
24.0 x 11.7 x 20.0
