fl4p/o2-probe/cad/exports/shell-half-front.stl

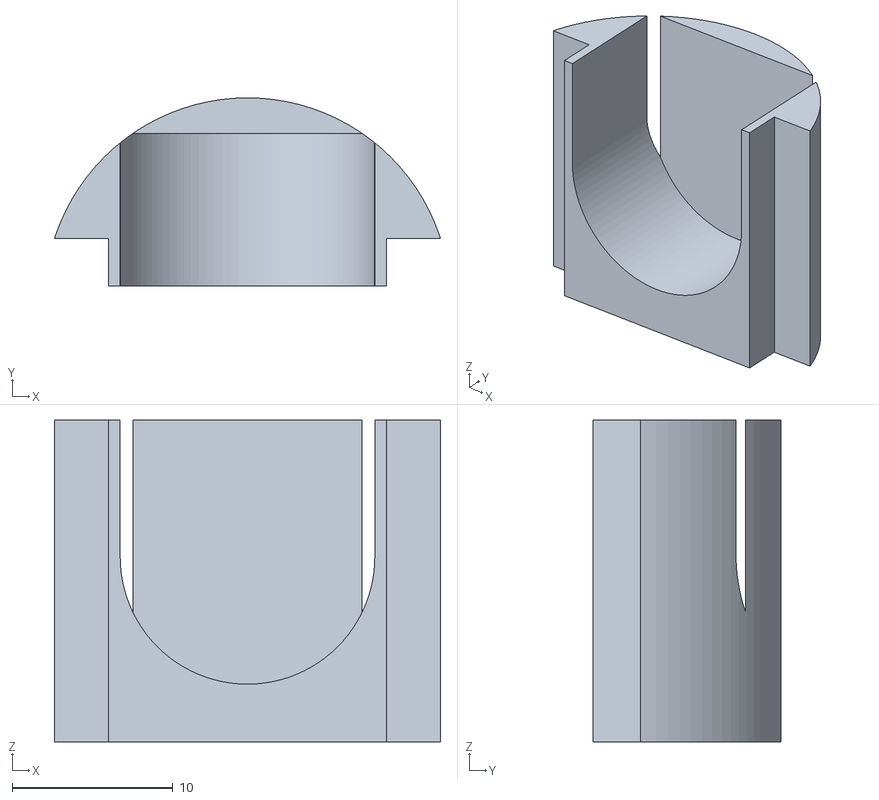
[picture p55: CAD file, 2026-09-06]
cad/exports/shell-half-front.stl
24.0 x 11.7 x 20.0
