fl4p/o2-probe/cad/exports/body-fit-coupon.stl

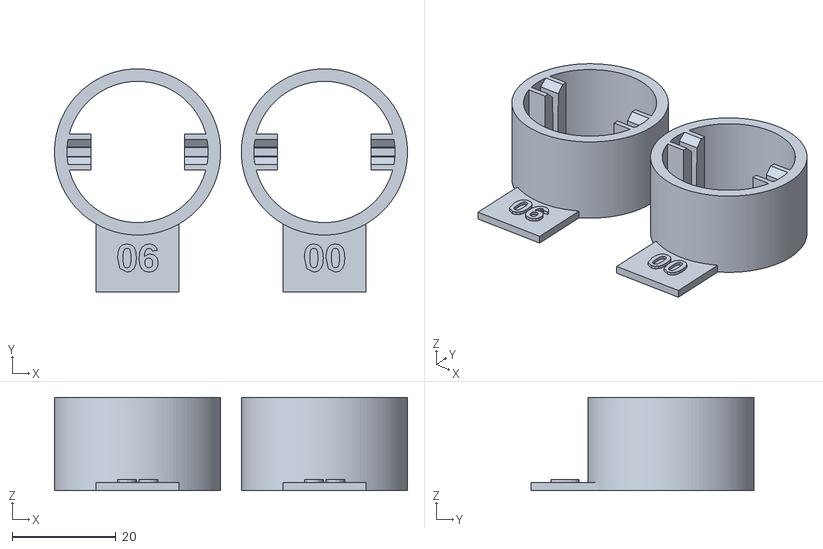
[picture p56: CAD file, 2026-09-05]
cad/exports/body-fit-coupon.stl
68.0 x 43.0 x 18.0
