fl4p/o2-probe/cad/exports/fastener-coupon.stl

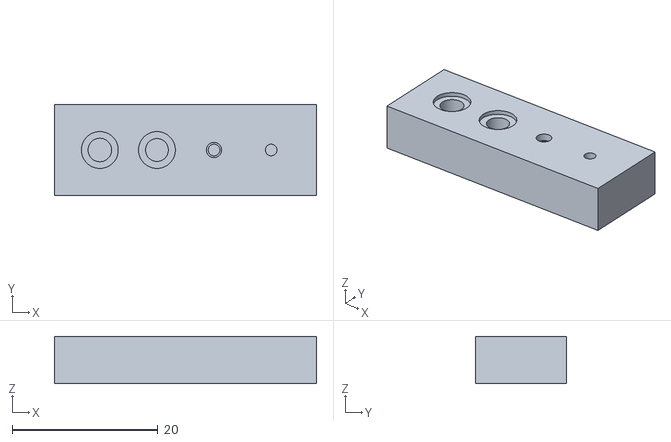
[picture p57: CAD file, 2026-09-05]
cad/exports/fastener-coupon.stl
35.9 x 12.4 x 6.50
