fl4p/o2-probe/cad/exports/o2-probe-board-tip-30mm.stl

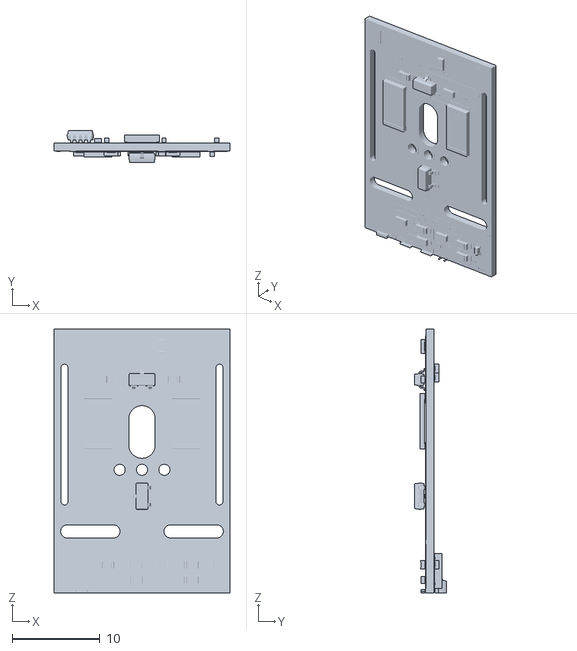
[picture p58: CAD file, 2026-09-05]
cad/exports/o2-probe-board-tip-30mm.stl
20.0 x 3.63 x 30.0
