fl4p/o2-probe/cad/exports/head-end-carrier.stl

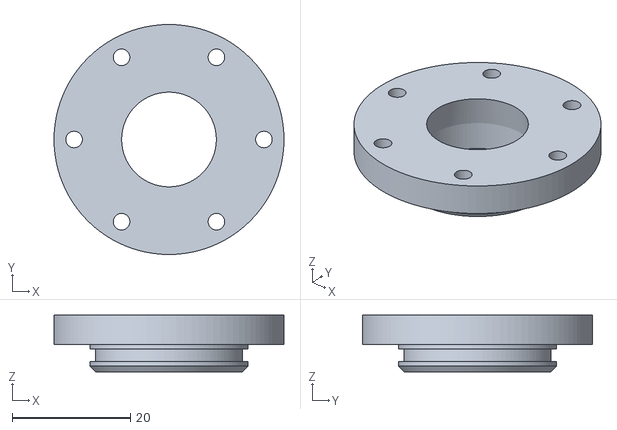
[picture p59: CAD file, 2026-09-05]
cad/exports/head-end-carrier.stl
38.9 x 38.9 x 9.60
