fl4p/o2-probe/cad/exports/head-end-retainer-print.stl

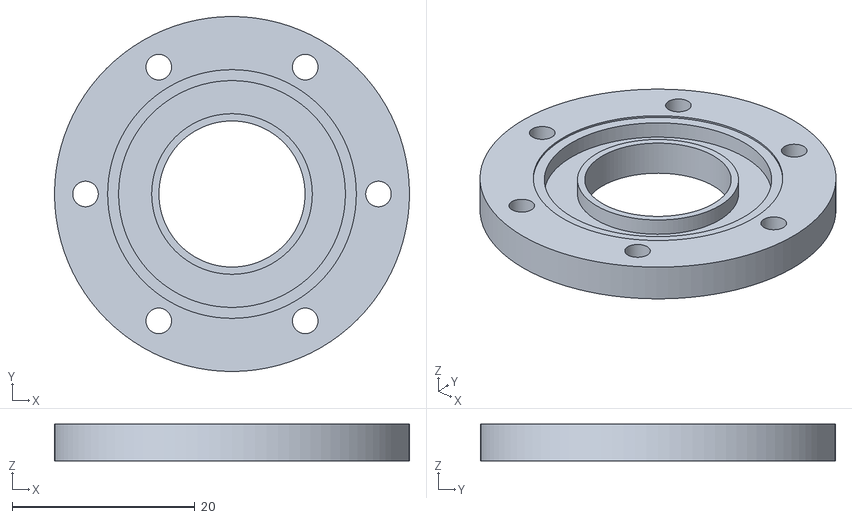
[picture p60: CAD file, 2026-09-05]
cad/exports/head-end-retainer-print.stl
38.9 x 38.9 x 4.00
