fl4p/o2-probe/cad/exports/head-end-plate.3mf

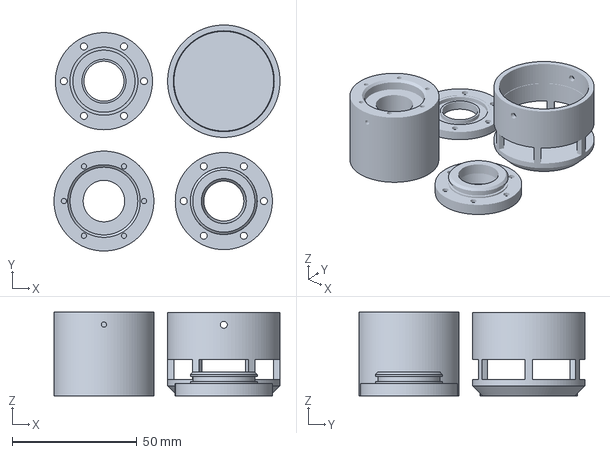
[picture p61: CAD file, 2026-09-05]
cad/exports/head-end-plate.3mf
90.5 x 90.5 x 33.6 mm
