fl4p/o2-probe/cad/exports/head-end-cap-print.stl

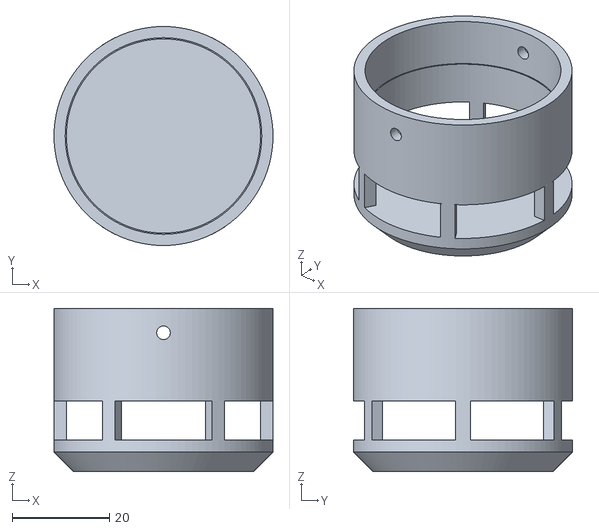
[picture p62: CAD file, 2026-09-05]
cad/exports/head-end-cap-print.stl
45.0 x 45.0 x 33.5
