fl4p/o2-probe/cad/exports/head-end-cavity.stl

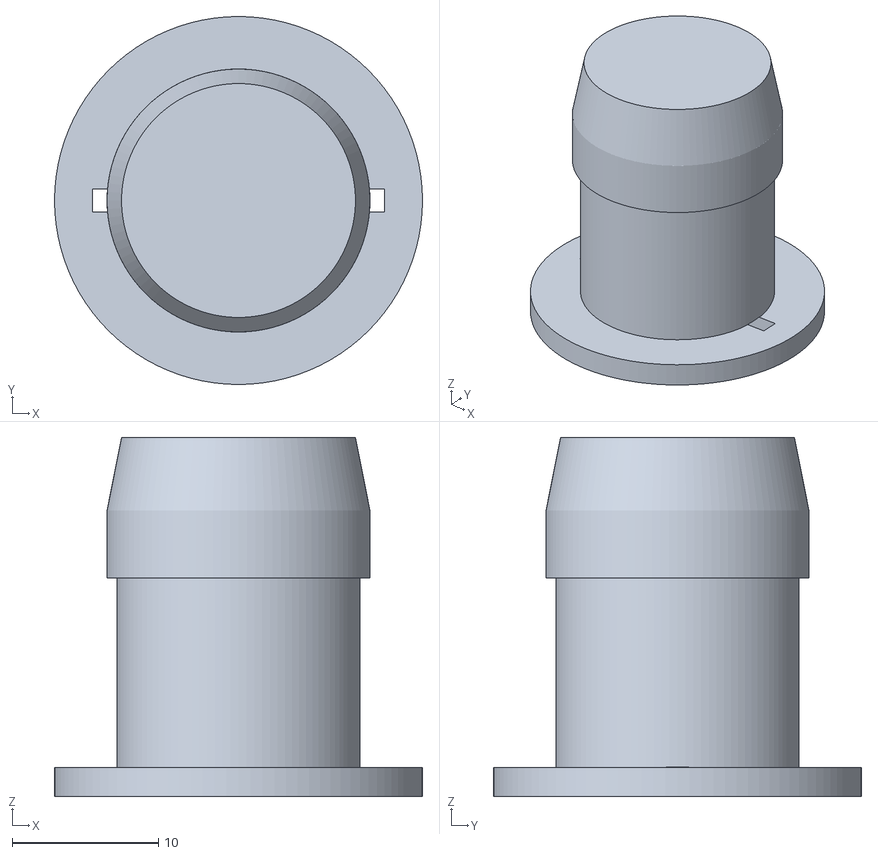
[picture p63: CAD file, 2026-09-05]
cad/exports/head-end-cavity.stl
25.2 x 25.2 x 24.6
