fl4p/o2-probe/cad/exports/head-end-head.stl

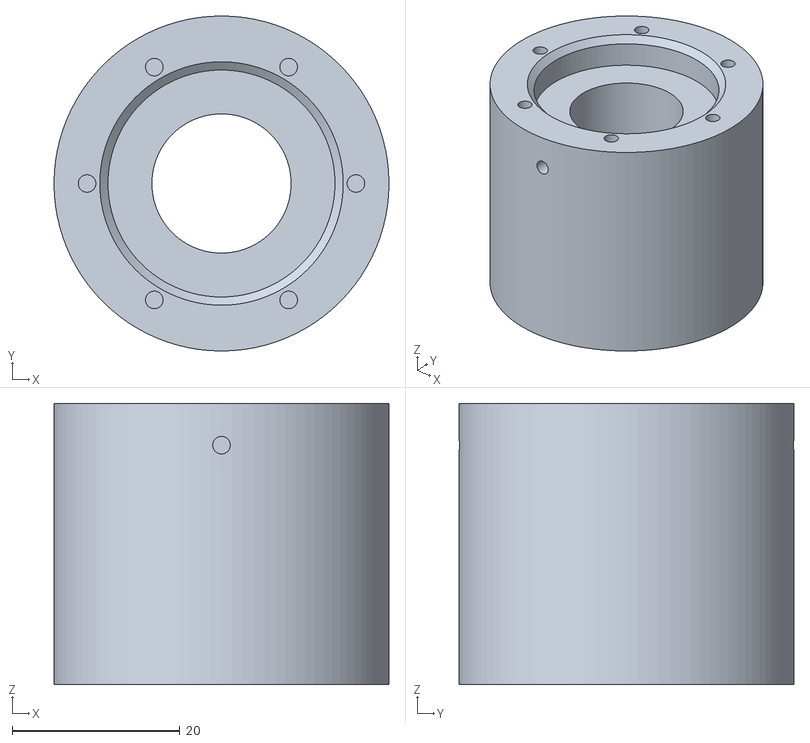
[picture p64: CAD file, 2026-09-05]
cad/exports/head-end-head.stl
40.0 x 40.0 x 33.6
