fl4p/o2-probe/cad/exports/body-monobody-section.stl

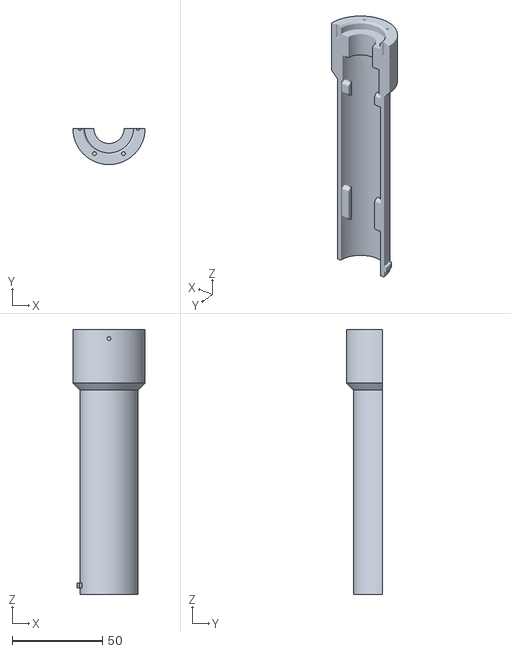
[picture p65: CAD file, 2026-09-05]
cad/exports/body-monobody-section.stl
40.0 x 20.0 x 146.6
