fl4p/o2-probe/cad/exports/carrier-only.3mf

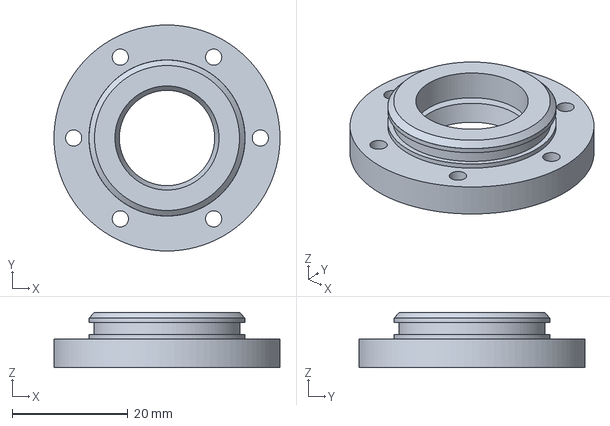
[picture p66: CAD file, 2026-09-03]
cad/exports/carrier-only.3mf
39.1 x 39.1 x 9.60 mm
