fl4p/o2-probe/cad/exports/retainer-only.3mf

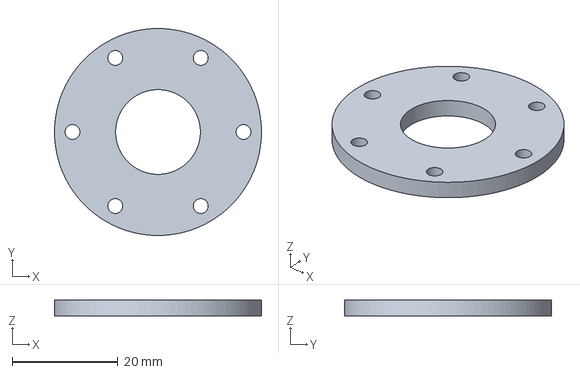
[picture p67: CAD file, 2026-09-03]
cad/exports/retainer-only.3mf
39.1 x 39.1 x 3.00 mm
