fl4p/o2-probe/cad/exports/void-coupon.3mf

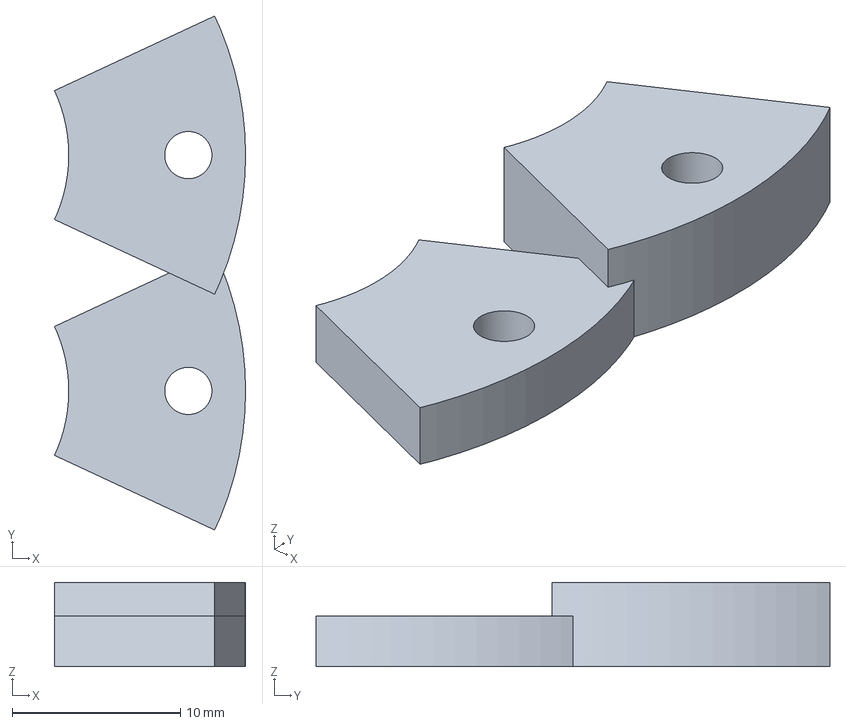
[picture p68: CAD file, 2026-09-03]
cad/exports/void-coupon.3mf
11.4 x 30.5 x 5.00 mm
