fl4p/o2-probe/cad/exports/head-end-plate-pair.3mf

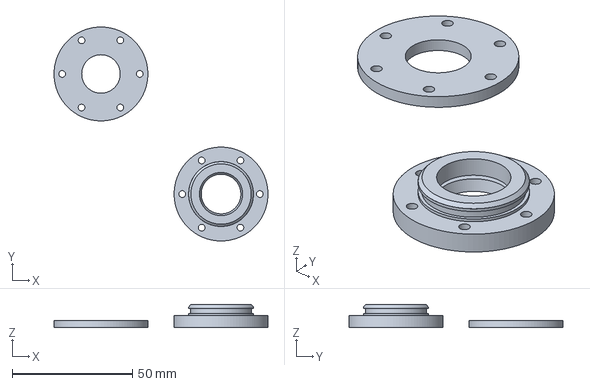
[picture p69: CAD file, 2026-09-03]
cad/exports/head-end-plate-pair.3mf
89.1 x 89.1 x 9.60 mm
