fl4p/o2-probe/cad/exports/head-end-plate-ready.3mf

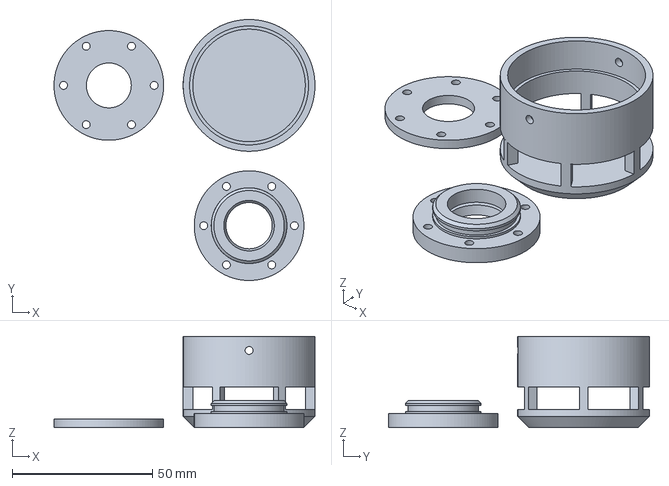
[picture p70: CAD file, 2026-09-03]
cad/exports/head-end-plate-ready.3mf
93.0 x 93.0 x 32.5 mm
