fl4p/o2-probe/cad/exports/head.stl

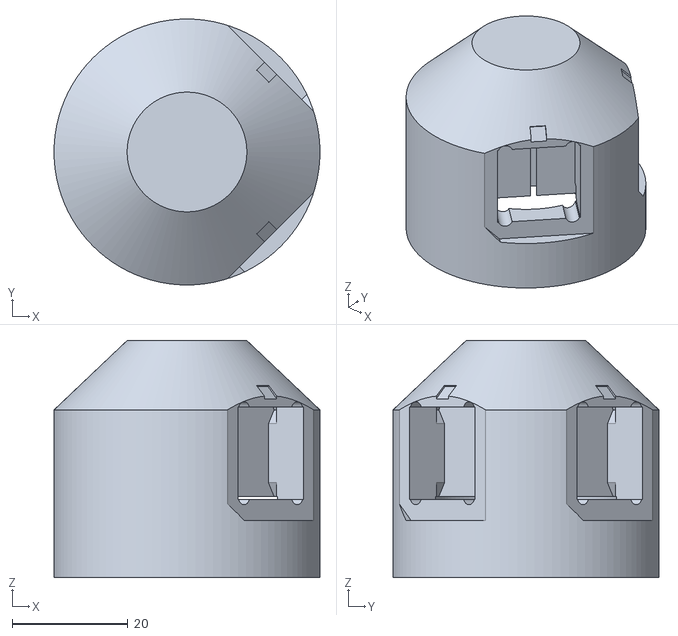
[picture p71: CAD file, 2026-09-02]
cad/exports/head.stl
46.0 x 46.0 x 41.0
