fl4p/o2-probe/cad/exports/head-cavity.stl

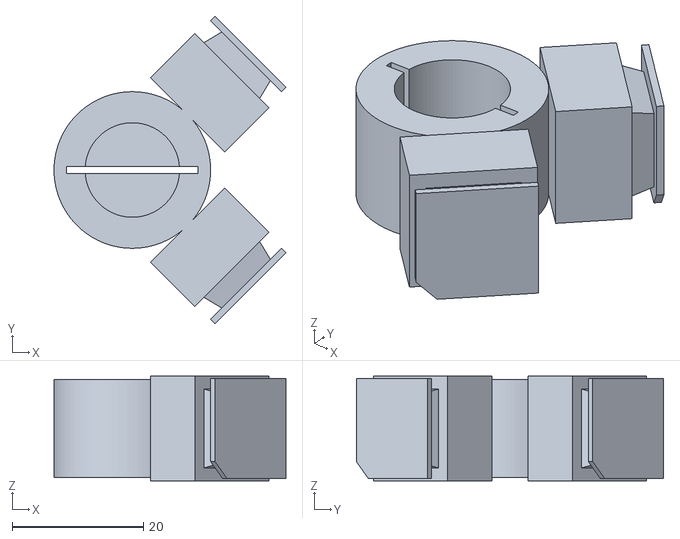
[picture p72: CAD file, 2026-09-02]
cad/exports/head-cavity.stl
35.4 x 46.9 x 16.0
