fl4p/o2-probe/cad/exports/head-guard.stl

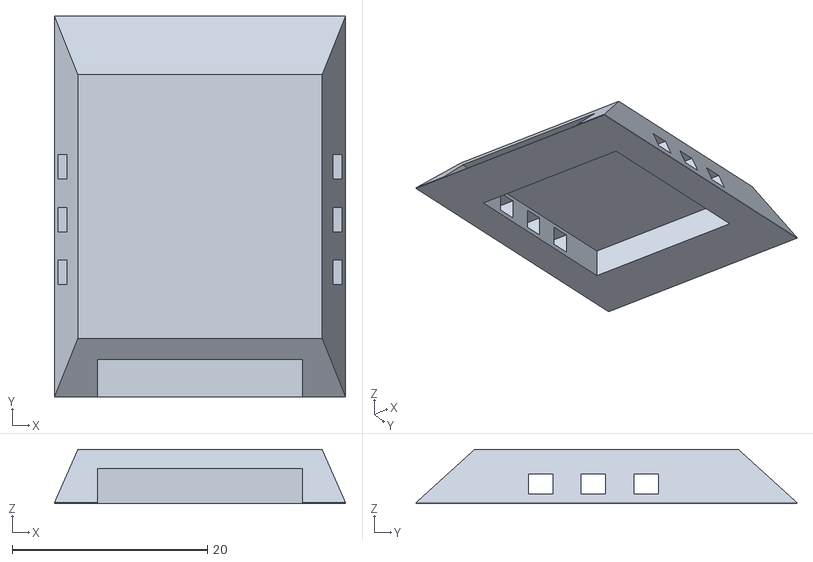
[picture p73: CAD file, 2026-09-02]
cad/exports/head-guard.stl
29.8 x 39.0 x 5.55
