fl4p/o2-probe/cad/exports/head-retainer.stl

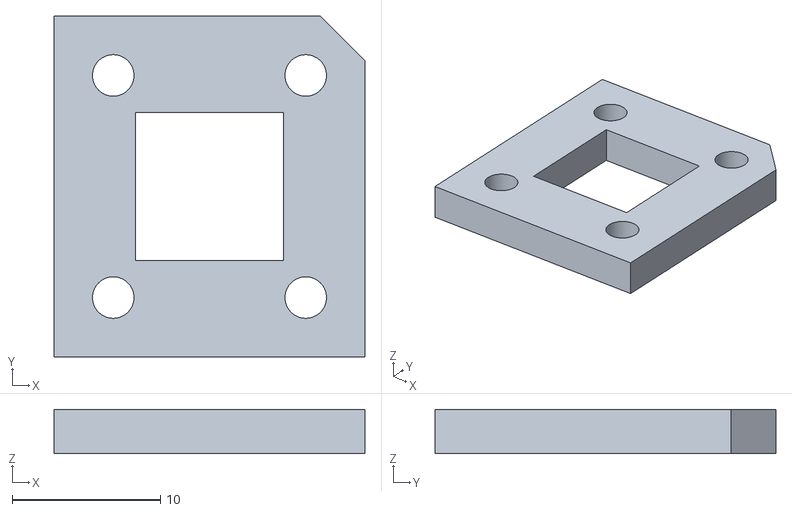
[picture p74: CAD file, 2026-09-02]
cad/exports/head-retainer.stl
21.0 x 23.0 x 3.00
