fl4p/o2-probe/cad/exports/fixture-cavity.stl

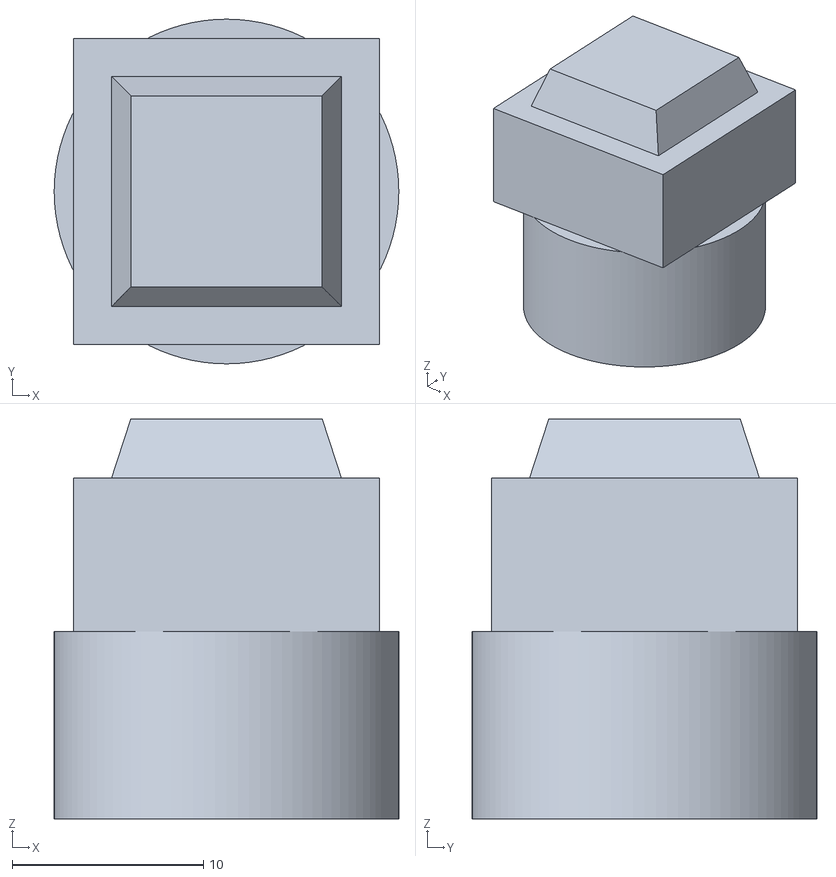
[picture p75: CAD file, 2026-09-02]
cad/exports/fixture-cavity.stl
18.0 x 18.0 x 20.9
