fl4p/o2-probe/cad/exports/fixture-retainer.stl

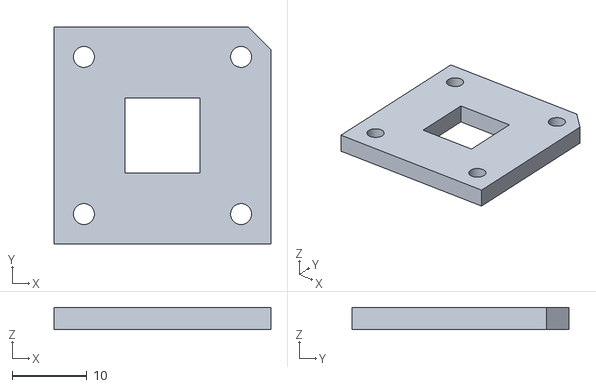
[picture p76: CAD file, 2026-09-02]
cad/exports/fixture-retainer.stl
29.0 x 29.0 x 3.00
