fl4p/o2-probe/cad/exports/fixture-plug.stl

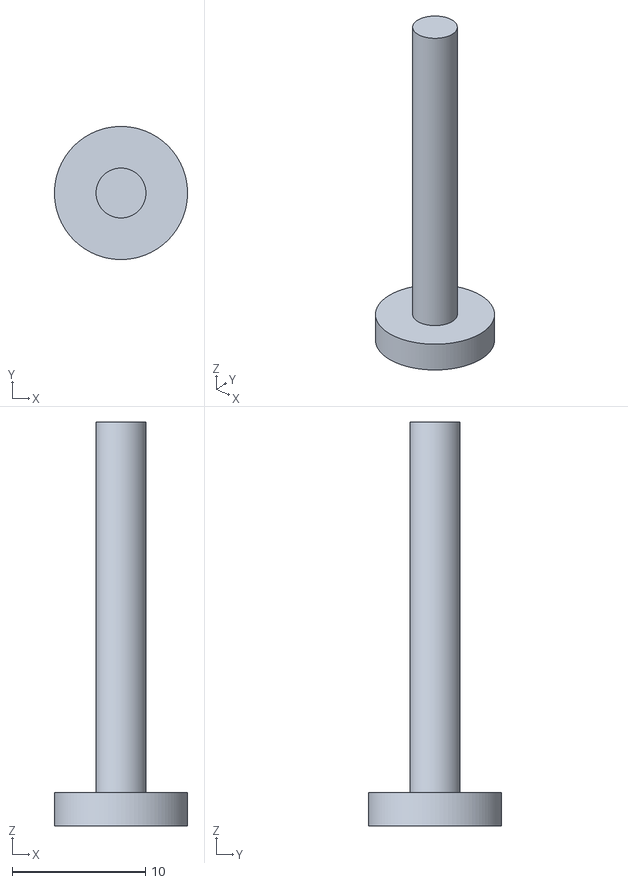
[picture p77: CAD file, 2026-09-02]
cad/exports/fixture-plug.stl
10.0 x 10.0 x 30.3
