fl4p/o2-probe/cad/exports/fixture-chamber.stl

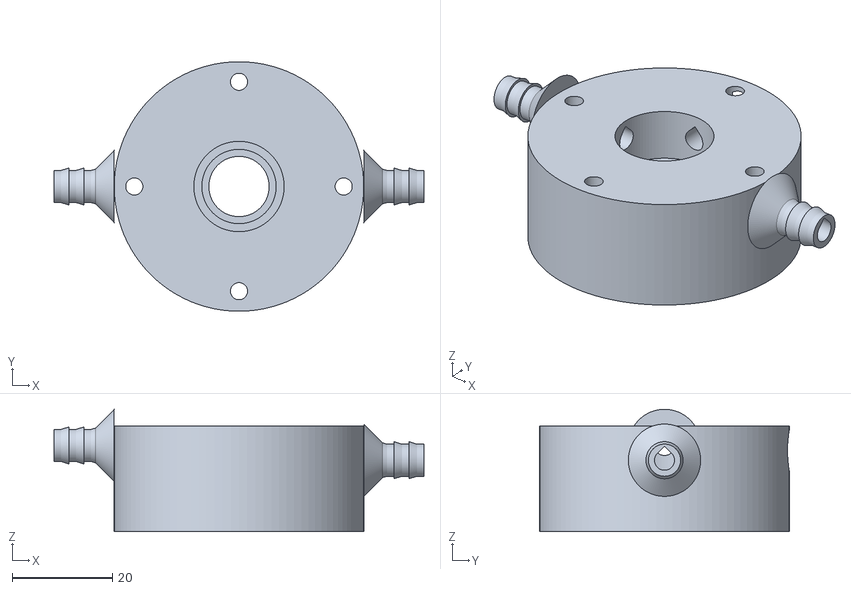
[picture p78: CAD file, 2026-09-02]
cad/exports/fixture-chamber.stl
73.7 x 49.7 x 24.4
