fl4p/o2-probe/cad/exports/fixture-die.stl

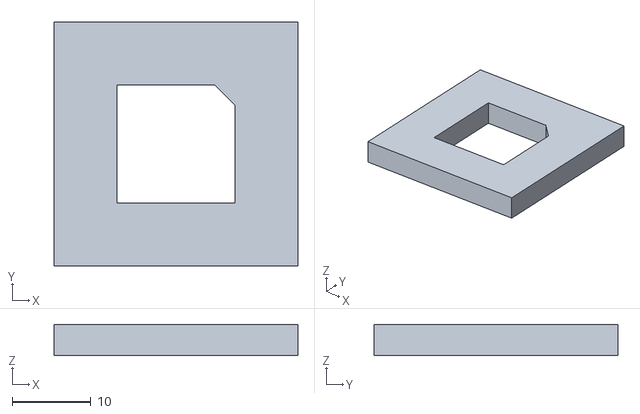
[picture p79: CAD file, 2026-09-02]
cad/exports/fixture-die.stl
31.0 x 31.0 x 4.00
