fl4p/o2-probe/cad/exports/fixture-lid.stl

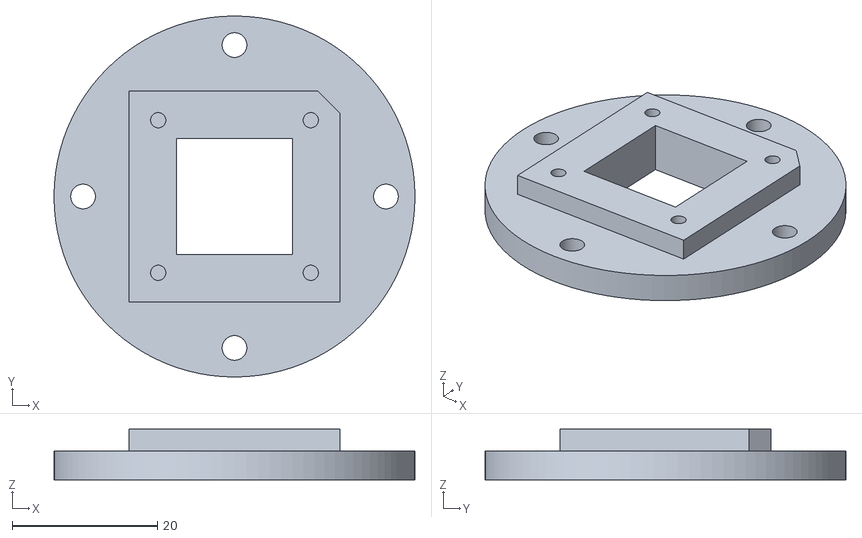
[picture p80: CAD file, 2026-09-02]
cad/exports/fixture-lid.stl
49.7 x 49.7 x 7.00
