fl4p/o2-probe/cad/exports/fixture-cartridge-bypass.stl

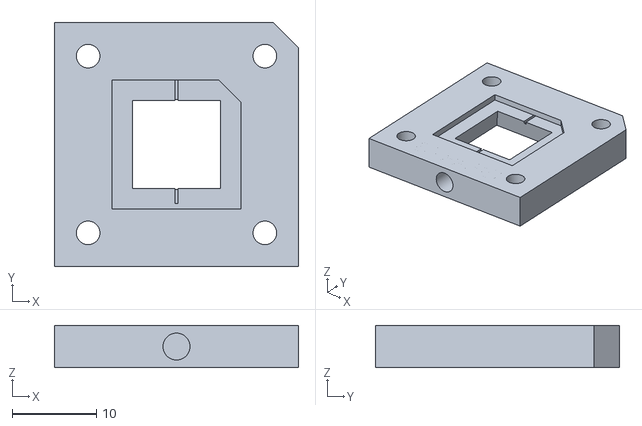
[picture p82: CAD file, 2026-09-02]
cad/exports/fixture-cartridge-bypass.stl
29.0 x 29.0 x 5.01
