fl4p/o2-probe/cad/exports/fixture-plenum.stl

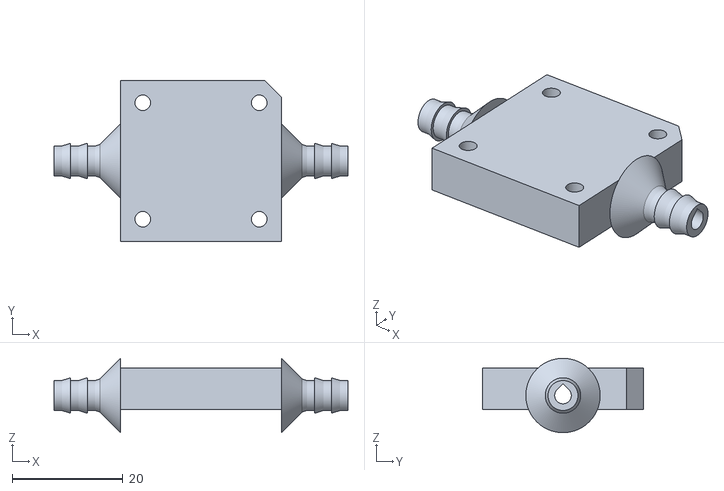
[picture p83: CAD file, 2026-09-02]
cad/exports/fixture-plenum.stl
53.0 x 29.0 x 13.4
