fl4p/o2-probe/cad/exports/enclosure.stl

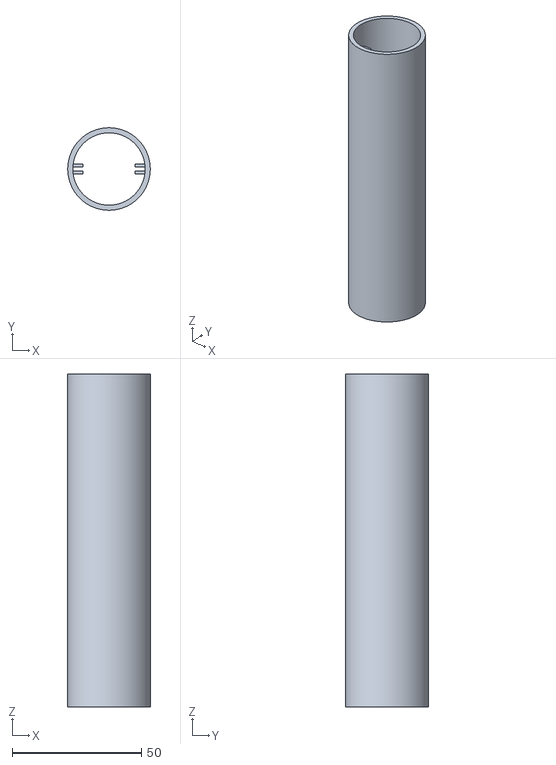
[picture p84: CAD file, 2026-08-23]
cad/exports/enclosure.stl
32.0 x 32.0 x 129.0
