fl4p/o2-probe/cad/exports/probe_mockup.stl

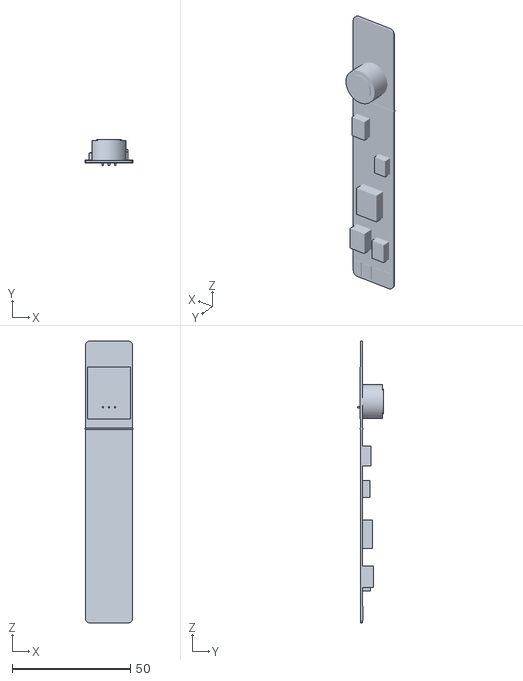
[picture p85: CAD file, 2026-08-23]
cad/exports/probe_mockup.stl
20.4 x 10.8 x 119.0
