fl4p/o2-probe/cad/exports/diffusion_head.stl

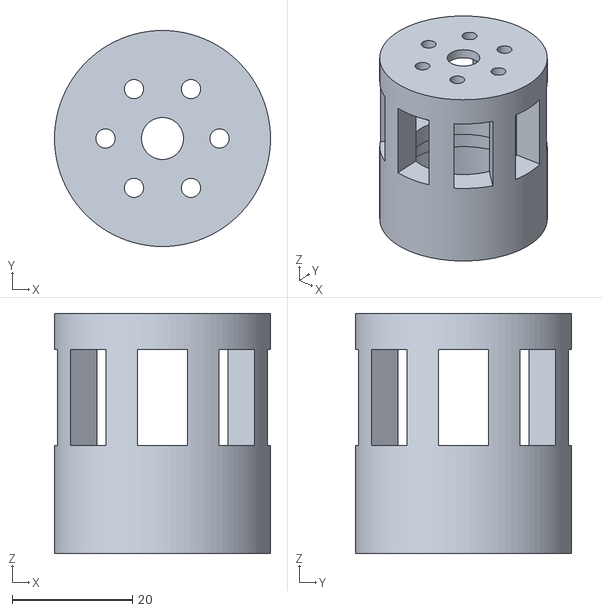
[picture p86: CAD file, 2026-08-23]
cad/exports/diffusion_head.stl
36.0 x 36.0 x 40.0
