fl4p/o2-probe/cad/exports/membrane_cartridge.stl

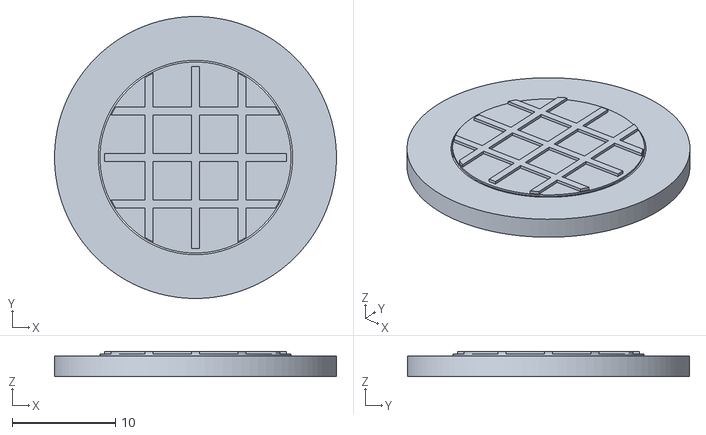
[picture p87: CAD file, 2026-08-23]
cad/exports/membrane_cartridge.stl
27.3 x 27.3 x 2.46
