fl4p/o2-probe/cad/exports/cable_cap.stl

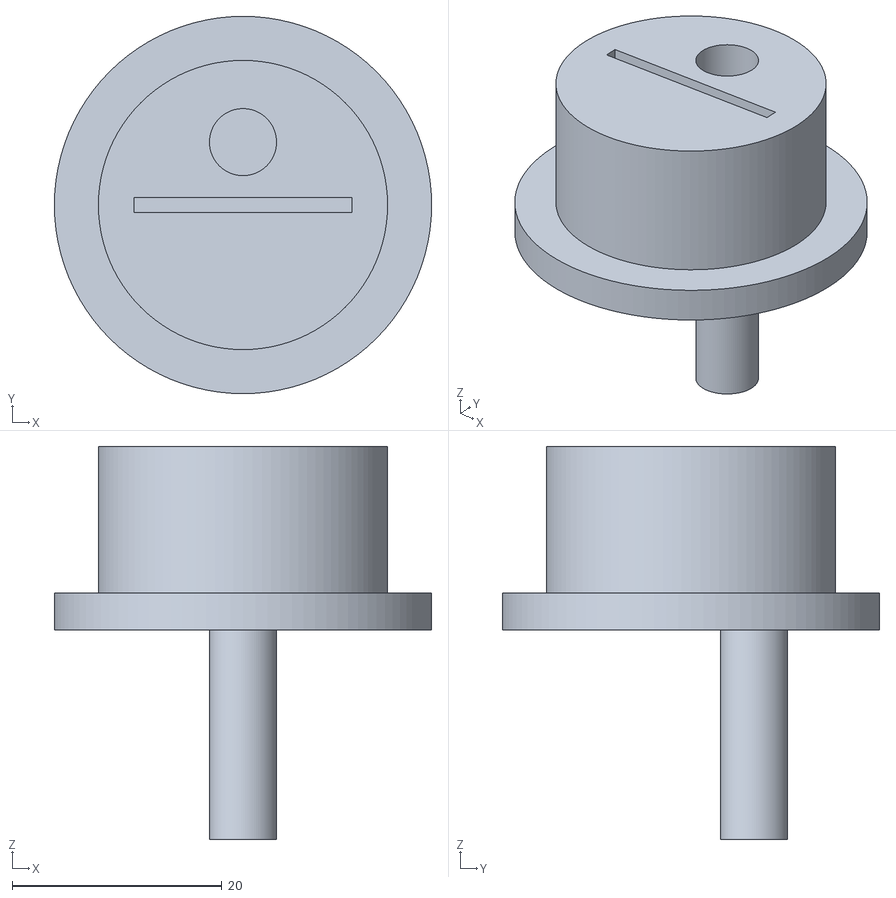
[picture p88: CAD file, 2026-08-23]
cad/exports/cable_cap.stl
36.0 x 36.0 x 37.5
