fl4p/o2-probe/cad/exports/response-candidate.3mf

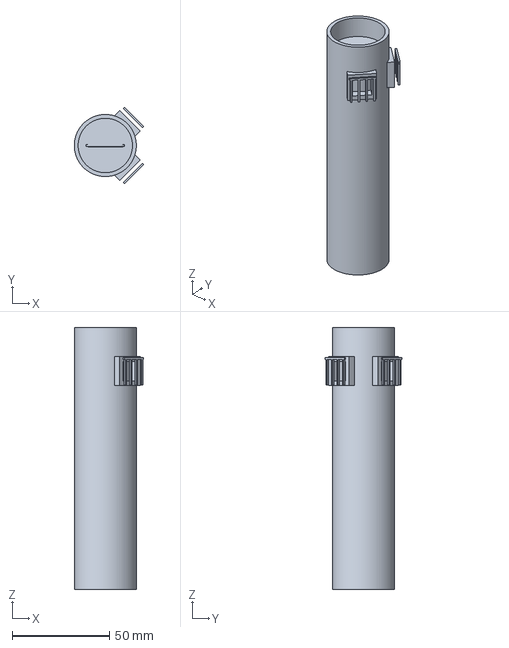
[picture p89: CAD file, 2026-08-23]
cad/exports/response-candidate.3mf
35.8 x 39.6 x 135.0 mm
