fl4p/o2-probe/cad/o2_probe_body_tube.scad

/*
 * O2 probe — PRINTED ASA BODY TUBE, prototype 1 (buried)
 * Units: millimetres. Z runs from the CABLE end toward the head.
 *
 * MEMBRANE.md, "Enclosure material: printed ASA" (2026-09-02) decided a BOUGHT
 * tube for the potted body and a printed head, and in the same breath allowed
 * this: "A fully printed body is permitted for prototypes." This is that part.
 * It exists so the Rev-A board -- the revision already at the fab, unmodified,
 * with no heater RING and NOT POTTED -- can be buried and can start returning
 * numbers, months before the bought-tube/potting route is qualified.
 *
 * No heater ring is NOT no heater. The board carries RH1/RH2 (CRCW2512280RFKEG,
 * 280 R 1 W, two on the back at (5, 96.5)) = 140 ohm, ~1.03 W at 12 V, the whole
 * budget PLAN.md sizes. What is missing is J5's ring, which was to carry that
 * heat to the membrane; HEATED-SPREADER.md section 0 records it as orphaned by
 * the end-window head. So this build puts a watt into the head cavity with
 * nothing to aim it: it warms gas, board and cell, not the membrane face.
 *
 * WHAT IT IS NOT. It is not the production body and it must not be released as
 * one. An unpotted board in an open tube gives up two things the production
 * design is built around, and both are quantified in the echoes below:
 *
 *   1. GAS VOLUME. The head's cavity is held to <= 5.0 cm3 because that budget
 *      is what makes the response time meaningful (PROTOTYPE-RESPONSE.md). An
 *      unpotted tube adds its whole bore to that cavity through the board bore
 *      in the head, which is roughly 60 cm3 -- an order of magnitude over. The
 *      optional `dam` part below cuts most of it back; nothing here can remove
 *      it, and if the dam is not fitted the prototype's step response is a
 *      TUBE measurement, not a membrane measurement. Read the echo.
 *   2. SURFACE LEAKAGE. Potting is what keeps the sub-uA AFE nodes out of
 *      condensate. Buried, unpotted, in 100 %RH pore gas, they are not. Expect
 *      offset drift on CELL_RE and treat a plausible-looking low reading as
 *      suspect until the desiccant charge is checked on recovery.
 *
 * The three things it DOES buy: the tube's own OD becomes a MEASURED number
 * that closes `tube_od_meas` in o2_probe_head_end.scad; the printed wall gets a
 * real burial-season exposure against MEMBRANE.md's two named risks (bead-void
 * permeability, ESC in NH3 condensate); and the board comes back out, because
 * the cable end is a bayonet cap and nothing is bonded to the board.
 *
 * ORIENTATION FOR PRINTING: upright, CABLE END DOWN on the plate.  Every
 * internal feature here (guide slots, bayonet lugs, the seal land) is then a
 * vertical extrusion with no overhang and no support. The wall is FOUR 0.60 mm
 * loops and nothing else -- there is no infill anywhere in it, by construction
 * (see `wall`). Do not reduce the loop count to save time and do not let the
 * slicer pick its own line width: bead-to-bead voids are the leak path
 * MEMBRANE.md names, and 0.40 mm lines leaked in every study in
 * ~/dev/ee/p1p/doc/gastight-and-watertight.md.
 *
 * AND EVEN THEN THE WALL IS NOT GASTIGHT. That document's bottom line is that no
 * FDM part in the literature reaches the "tight" leak class -- not at 6 mm
 * walls, not at 0.09 mm layers, not with epoxy infusion. For a probe whose whole
 * output is a gas concentration, that is a MEASUREMENT path, not just a water
 * risk: whatever the wall passes is air, and air reads as 20.9 % O2. Treat this
 * prototype's absolute reading as biased high by an unknown amount, and take its
 * value from CHANGES over time rather than from the number itself.
 *
 * Preview: make body-tube
 */

$fn = 128;
e = 0.02;

part = "tube";       // tube, fit-coupon, cap, cap-print, dam, assembly
exploded = false;

// ------------------------------------------------- the interfaces

// Head. These three MUST track o2_probe_head_end.scad or the board lands in the
// wrong place: `socket_len` is how far the head swallows this tube, and
// `cav_board_len` is how far the board's tip stands proud of the tube end face
// inside the cavity. They are duplicated rather than included because that file
// asserts on four unmeasured inputs and refuses to load without them.
// 3.0, tracking o2_probe_head_end.scad's socket_len, which is now
// `monolithic ? 3.0 : 14.0`. THIS IS NOT COSMETIC: tube_len subtracts it, so
// leaving it at 14 would have ended the tube 11 mm short of the head and put
// the board's tip 11 mm past the cavity. The overall probe length does not
// change -- 11 mm of Ø40 head simply becomes 11 mm of Ø32 tube.
head_socket_len = 3.0;      // o2_probe_head_end.scad, socket_len (monolithic)
// STILL 2.0, but it is no longer a number anyone chose -- IT IS SOLVED IN THE
// HEAD and this is a copy that has to be re-read whenever the head moves.
// Deleting the axial cell's neck put the retainer screws in charge of the head's
// length: cav_board_len = max(2.0, fast_hole_h + 2 - cav_clear_len - spigot_len).
// It went to 4.7 on 2026-09-05 while fast_hole_h was 8.0, and came back to the
// 2.0 floor the same evening when the fastener moved to M2 (fast_hole_h 5.0), so
// this line has already been wrong once today in each direction.
// tools/interface_check.py reads the head's value out of a render (the INTERFACE
// echo) rather than by regex on the source, because a max() is not regex-readable
// -- and it is the thing that caught this copy stale both times. Run it.
// IT IS KEYED ON THE RADIAL RING, and until 2026-09-09 it was a single 2.0 for
// every ring. That is what made the monobody unbuildable under ors116787:
// spigot_len is set by the ring's cord, the Ø24 x 1.5 takes it 5.3 -> 4.6, and
// the max() above then lifts cav_board_len to 2.4 so the retainer screws still
// have fast_hole_h + 2 of material behind the end face.
//
// Read 2.4 into the old single constant and the tube shortens 124 -> 123.6 --
// which is CORRECT, and was reverted on 2026-09-08 as if it were the bug,
// because the head was still holding 124.0 as a literal and the union opened a
// 0.4 mm gap ("3 volumes, expected 2"). The head now derives that length from
// its own cav_board_len, so the two agree at 123.6 and the joint closes. The
// finding recorded here as "a REAL CONFLICT between the two models" was really
// one identity written down twice, once as arithmetic and once as an answer.
//
// A single value could only ever be right for ONE ring, so interface_check.py
// could only ever pass for one -- the default. Keyed, it is checked under
// whatever RING the Makefile is building, which is the point of the check.
//
// THESE ARE COPIES OF A SOLVED VALUE, not choices. To add a ring: build the head
// with it and read cav_board_len off the INTERFACE echo.
radial_ring = "onhand-22x2";        // o2_probe_head_end.scad, radial_ring
cav_board_len_by_ring = [
//   ring             cav_board_len   why
    ["onhand-22x2",   2.0],  // spigot_len 5.3 -> the 2.0 floor binds, not the screws
    ["onhand-20x2",   2.0],  // same cord; the head REFUSES to render on this ring
                             // anyway (groove root under the 1.2 mm floor), so the
                             // entry is here for completeness, not for use
    ["ors116787",     2.4],  // spigot_len 4.6 -> the retainer screws bind
];
cav_board_len = let (m = [for (r = cav_board_len_by_ring) if (r[0] == radial_ring) r[1]])
    len(m) == 1 ? m[0]
    : assert(false, str("no cav_board_len for radial_ring '", radial_ring,
                        "'. It is SOLVED in o2_probe_head_end.scad; build the ",
                        "head with this ring and read it off the INTERFACE echo, ",
                        "do not guess -- tube_len depends on it and a wrong value ",
                        "opens a gap at the monobody joint. Known: ",
                        [for (r = cav_board_len_by_ring) r[0]])) 0;

// HOW THE HEAD JOINS.
//   "bonded"      the production joint: this tube slides 14 mm into the head's
//                 socket on a 0.2 mm radial adhesive gap. Two parts.
//   "monolithic"  the prototype joint: there ISN'T one. The head is printed in
//                 the same piece, so the tube stops where the head begins and
//                 o2_probe_head_end.scad's part="monobody" unions the two.
//
// Monolithic is the default for prototype 1 and the reason is sourcing, not
// elegance: the bonded joint is structural AND sealing, on the wet side, at
// ~75 C in ammoniacal condensate -- and MEMBRANE.md forbids a load-bearing
// adhesive there until a named one has passed hot-condensate ageing. No such
// adhesive is sourced. Printing through the joint deletes the requirement
// instead of guessing at it.
//
// What it costs: a failed print loses the whole body, and any change to the
// head reprints 147 mm of tube with it.
joint = "monolithic";       // "monolithic" or "bonded"
assert(joint == "monolithic" || joint == "bonded",
       str("unknown joint '", joint, "'"));

// Board. Controlled by KiCad Edge.Cuts (PLACEMENT.md).
board_w   = 20.0;
// CONFIRMED 2026-09-05 (Fab): "board_t = 1.6 is correct for Rev A". PLACEMENT.md
// still specifies "20.0 x 107.0 mm ... 1.0 mm, 4 layers" and o2-probe.kicad_pcb's
// stackup is a 0.910 mm dielectric; both are stale against the built board and
// are the files that have to move, not this one.
// PLAN.md gates a thickness change on "the tube chord/assembled-height check" --
// done here: the swept diagonal goes 21.93 -> 22.19 against a 27.2 bore and the
// head's 25.19, so it clears both. The slot heights and the dam reliefs follow
// automatically.
board_t   = 1.6;            // Rev A, confirmed
board_len = 107.0;

// Component envelope. DECLARED, NOT MEASURED -- and the distinction matters,
// because the head's own model refuses to run without these measured.
//
// WHICH FACE: checked in o2-probe.kicad_pcb, not assumed. RV1 -- the 5 mm
// trimmer Fab named -- is a Bourns 3224W on **B.Cu**, i.e. the BACK, at board
// (2.5, 73.0) with pads spanning x 0.25..4.75. This file had it on the front
// until 2026-09-04; nothing broke, because the tube is round and has room on
// both faces, but the number was against the wrong surface.
//   front  3.0  L1, SRN6028C-4R7M, footprint L_6.3x6.3_H3. The tallest thing
//               on F.Cu: J3 is a Tag-Connect pogo land with no part fitted and
//               J2 is DNP.
//   back   5.0  RV1, the VREF trimmer. Fab, 2026-09-04: "mind the trimmer: its
//               5mm high". Also on this face, further gasward, is the cell
//               socket barrel -- PLAN.md "cell-orientation option A": "~2.6 mm
//               of socket protrudes out the back of a 1.0 mm board" -- so the
//               trimmer governs.
// Neither is a caliper reading on a populated assembly. They are used here only
// for CLEARANCE. Do NOT copy them into the head file, where the same numbers set
// a bore that a real assembly has to pass through.
board_env_front = 3.0;
board_env_back  = 5.0;

// Tube stock the printed part is imitating: PLAN.md's 32 OD / 28 ID target.
// Keeping the printed prototype ON that section is the whole point -- the head,
// its bore, its socket and the volume gate were all sized for it, so the
// prototype and the production body are dimensionally the same part.
tube_od = 32.0;
// 2.4, not the 2.0 that 32/28 implies, and the reason is the slicer rather than
// strength. ~/dev/ee/p1p/doc/gastight-and-watertight.md: 0.40 mm extrusion width
// leaked in every test, 0.64 mm sealed, so the wall is printed at 0.60 mm width
// -- and 2.0 mm is 3.33 of those, which fills the remaining third with gap-fill,
// a discontinuous bead and exactly the defect the wide line was chosen to avoid.
// 2.4 is FOUR whole 0.60 loops, no gap fill, no infill anywhere in the wall.
// The 0.8 mm of bore it costs is free: the board's swept diagonal is 21.8 mm.
wall    = 2.4;
tube_id = tube_od - 2*wall;
wall_line_w = 0.60;         // what the wall count above assumes
wall_loops = wall / wall_line_w;

// ------------------------------------------------- cable end

// CABLE GLAND -- TWO PARTS, and which one is fitted is a variant, not a
// preference. Fab, 2026-09-05: M8 brass for prototype 1's bench work and first
// fit, 316L for anything that goes in the ground.
//
//   "m8_brass"  Lumonic M8 x 1.0, nickel-plated brass, NBR seal, clamp 2-5 mm,
//               -40..+100 C, max panel 3 mm, hex nut supplied. IN HAND.
//   "m12_inox"  LAPP SKINTOP INOX-R M12x1,5, art. 53806749: 316L body, silicone
//               seal and O-ring, clamp 3,0-5,0 mm, thread 6,5 mm, SW16.
//               Specified in CABLE-SOURCING.md / POTTING.md, commit bb29a1d.
//
// WHY THERE ARE TWO, and it is not fit -- both clamp the ordered cable's 3,80 mm
// (UNITRONIC SENSOR FD Li9Y11Y 4x0,25, art. 7038890) comfortably. It is
// chemistry. Ammonia is the classic stress-corrosion-cracking agent for brass,
// worse in vapour than in liquid, and the canonical example in the literature is
// ammonia vapour from decaying organic matter. A gland is a PRE-STRESSED brass
// part and a windrow is an ammonia vapour generator: that is the whole SCC triad
// with nothing missing. So nothing brass goes in the pile. On the bench, where
// prototype 1 is fitted and handled first, it is fine and it is the part we have.
gland = "m8_brass";         // "m8_brass" (bench) or "m12_inox" (burial)
assert(gland == "m8_brass" || gland == "m12_inox",
       str("unknown gland '", gland, "'"));

// NOT TAPPED. This was tapped M8 x 1.0 into the ASA until POTTING.md's sourcing
// pass pointed out what it is: "Do not tap the gland thread directly into the
// plastic cap. MEMBRANE.md's rule against sustained strain in plastic at 75 C
// applies exactly here: the cap would creep and the seal relax." That is the
// same rule this file already cites against a preloaded printed thread on the
// bayonet -- and the gland thread was breaking it three lines away from the
// argument. A clearance hole and the gland's own nut put the load path
// metal-to-metal and the plastic merely between two steel faces.
gland_thread_d = (gland == "m8_brass") ? 8.0 : 12.0;
gland_hole_d   = (gland == "m8_brass") ? 8.5 : 12.5;   // clearance, not tap drill
// Each part's own limit on how much plastic can sit between flange and nut.
// m8: the vendor's rated 3 mm panel. m12: 6,5 mm of thread less a 2,8 mm
// stainless locknut = 3,7 mm, the arithmetic POTTING.md worked out and asked
// whoever edits this file to respect.
gland_wall_max = (gland == "m8_brass") ? 3.0 : 3.7;
cap_end_t    = 3.0;         // fits both; see the assert below

// THE GLAND'S OWN SEAL, and where it sits. An annular NOTCH in the cap's OUTER
// face, concentric with the hole, so the gland's ring drops into it instead of
// being squeezed out sideways on a flat face.
//
// WHY A GROOVE AND NOT A COUNTERBORE: a counterbore would sink the whole hole
// mouth and spend its depth out of the wall the gland clamps, on a wall that is
// only 3 mm to begin with. An annulus that starts OUTSIDE the thread's clearance
// hole takes its depth out of material the gland does not bear on, so the
// clamped thickness stays the full cap_end_t. gland_notch_id is asserted clear
// of the hole below.
//
// MEASURE THESE. They are the dimensions of a real ring on a real part and the
// project's rule is not to guess those. The values are provisional, and they
// only LOCATE the seal -- the sealing force comes from the gland's flange.
// Reference edges: the free ring off the gland, ID and OD across the ring, cord
// by micrometer.
// These provisionals are not free choices: the ring sits AROUND the clearance
// hole, so its ID is necessarily larger than the hole, and the notch that holds
// it has to start outside the hole too. 8.0 was the first value here and the
// assert below rejected it -- an 8.0 ID ring cannot surround an 8.5 hole. The
// numbers are the smallest physically coherent ones, which is the right place
// for a provisional to sit until the real ring is measured.
gland_seal_id   = (gland == "m8_brass") ? 8.6 : 12.6;   // MEASURE: free ring ID
gland_seal_cord = 1.5;      // MEASURE: cord diameter
gland_seal_squeeze = 0.25;  // design point; the flange sets the real value  // design point; the flange sets the real value
cap_wall     = 2.4;         // four 0.60 loops, same reason as the tube wall
cap_fit      = 0.4;         // diametral, cap bore over tube OD

// Cable tail inside the tube, measured from the board's cable end to the cap's
// inner face. Holds the four soldered wires, their service loop and a silica
// sachet. The cap adds its own depth on top of this.
tail_len = 22.0;

// CABLE-END SEAL -- RADIAL, on a spigot the cap carries into the tube's bore.
// It was a 28 x 2 FACE seal squeezed by the cap, and that was the wrong joint
// twice over. It needed a second ring size, and -- the part that actually
// decided it -- its squeeze was set by the bayonet's detent depth, a printed
// feature whose tolerance was never budgeted. Radial squeeze is set by a bore
// and a groove root, which is the one seal geometry this project has a
// validated tolerance model for (o2_probe_head_end.scad, the carrier ring).
//
// NO LONGER THE CARRIER'S RING, and that is a deliberate trade -- see the
// collar note under cable_bore_d. It was a 24 x 1.5, chosen so the whole probe
// ran on one size, one compound, one micrometer-sorting pass. That property is
// gone; what was bought with it:
//
//   * The 24 x 1.5 needed a Ø27.3 counterbore, which only exists because it is
//     LARGER than the Ø27.2 tube bore. The 22 x 2 seals a bore the collar
//     makes SMALLER, so nothing has to be cut into the tube wall.
//   * A fatter cord is a wider tolerance target. On the same reamed bore and
//     the same printed root, the 24 x 1.5 spent over 15 of the 15 available
//     squeeze points on tolerance alone and needed rings sorted to +/-0.01;
//     the 22 x 2 spends about 11 on ORDINARY CATALOGUE cord. The sorting pass
//     the old ring needed is what paid for the second size.
//   * Install stretch drops from 4.27% to about 2%, off the 5% rule's edge.
//
// WHAT IS ACTUALLY KNOWN ABOUT THIS RING, which is less than an earlier
// version of this comment claimed. It said "EPDM 70 Shore A peroxide-cured,
// 22.0 x 2.0 DIN 3771 -- same compound and same supplier class as the
// carrier's ORS116787". The head's own inventory record says otherwise, and it
// is the record that is right (o2_probe_head_end.scad, "onhand-22x2"):
//
//     22 x 2, on hand, UNCATALOGUED -- material, cure system and cord
//     tolerance all assumed. TEMPORARY, for a squeeze and leak test on a
//     part that can be printed today.
//
// So: no part number, no lot, no compound test report, and no supplier
// tolerance. Stating those as fact was prose stronger than its source, and it
// then carried a tolerance SPECIFICATION -- oring_sorting = "catalogue" -- on
// a ring with no catalogue entry to specify it.
//
// It also quietly made a bench substitute into the design of record. The
// design of record is still ORS116787, 24 x 1.5, which has the compound test
// report the ammonia argument rests on. THIS IS THE RING FOR A SQUEEZE AND
// LEAK TEST ON A PART THAT CAN BE BUILT TODAY. Anything buried for a season
// needs either measurements (seal_id_tol_meas / seal_cord_tol_meas above) or
// a sourced part number.
//
// EPDM is the one part that is established, and it is not negotiable: ammonia
// attacks fluoroelastomers.
// TRIED AND REFUSED 2026-09-09: the ors116787 24 x 1.5 cannot seal this end.
// Fab asked for one ring across the whole probe and this was built for it, at
// every bore the rules allow. It fails TWICE, on independent grounds, and
// neither is the collar the note above argues:
//
//   1. INSTALL STRETCH. A 24.0 ring carries a +/-0.25 ID band of its own. Any
//      root that reaches 15% squeeze in a bore above O27.2 stretches the low-ID
//      corner past the 5% rule -- 5.77% at 7fd21c0's O27.3 root of 25.0299 --
//      and the rules still do not overlap at the BEST root there (-0.33 points)
//      or at O27.25 (-0.14). Only O27.2 overlaps, by +0.06 points printed.
//   2. THE MOUTH WALL, at that one surviving bore. The O-ring lead-in is sized
//      on the ring's worst corner (measured on the bench; a cone sized on the
//      DRAWN bore was still 0.05 mm short), and a 24 x 1.5 on a 24.80 root
//      reaches O27.83. The relief opens the mouth to O28.53 in a O32 tube and
//      leaves 1.73 mm of wall where the cap is pushed on and twisted by hand,
//      under the 1.80 floor of three whole 0.60 extrusion loops. EVERY root in
//      the feasible window fails it: 1.7327 best-margin, 1.7379 lowest, 1.6995
//      printed. Short by 0.06 mm, with no root anywhere that recovers it.
//
// So the one-ring probe is not available at O32 OD. Not a sourcing decision and
// not a preference: the ring is too fat for the tube once the lead-in it needs
// is cut for it. One ring at this end would need a WIDER TUBE -- a different
// probe, and the head end would have to move with it.
//
// The 22 x 2 stands. Its worst-corner ring reaches O26.892, the mouth opens to
// O27.592, and 2.20 mm of wall is left, comfortably over the floor.
seal_id   = 22.0;
seal_cord = 2.0;
// THESE STAY undef. MEASURING THE RING IS NOT AN AVAILABLE MOVE -- Fab ruled it
// out and gave the reason, and it is a good one: a free O-ring deforms under
// calipers, so the reading is a function of how hard you squeezed. It was tried
// once and produced ID 22.3 / cord 2.05, which would have put nominal stretch at
// 0.437% and demanded a O26.0 bore -- a reading that, taken seriously, would
// have redesigned the joint around an artefact of the measurement. He judged it
// unreliable and instructed that NOMINAL dimensions be assumed. Restated
// 2026-09-07: "i will not measure rings, i told you before why."
//
// SO DO NOT PROPOSE IT AS THE FIX. Every corner these bands drive must be closed
// with GEOMETRY -- bore diameter, groove root, mouth clearance -- or accepted
// explicitly and recorded. An earlier version of this file, and a whole evening
// of my recommendations on 2026-09-06, kept pointing at "measure the ring" as
// the discharge for the open corners. That path was already closed and I had
// been told so.
//
// If a properly-conditioned measurement ever does appear -- a ring supported in
// a bore or on a pin, not compressed between caliper jaws, several readings --
// these are where it goes, as half the spread. Nothing else changes.
seal_id_tol_meas   = undef;   // ruled out: see above. Catalogue band applies.
seal_cord_tol_meas = undef;   // ruled out: see above. Catalogue band applies.

// NO WAIVER. There was one here -- the low-stretch corner, 0.7345% against a
// 1% minimum, waived on the nominal-dimensions assumption. It is gone because
// the DESIGN was fixed (cable_bore_d 25.5 -> 25.7), not because the guard was
// made quieter. That is the only acceptable way for a waiver to disappear.
seal_stretch_corner_waived = false;

// WAIVERS FOR ONE BESPOKE CAP -- and only ever via -D.
//
// They stay false in the file. Setting them here would change the design of
// record; they exist so a fit-to-suit cap for ONE measured tube can be built
// with -D without editing anything.
//
// Fab, 2026-09-06, MONO-R2: the printed tube's cable bore measures 25.30-25.40,
// and there is no reamer on the bench. At seal_squeeze 0.238 that leaves TWO
// gates unmet, and both are narrow -- swept, not assumed:
//
//   * install stretch, worst corner 0.72% against the 1% floor. Driven entirely
//     by the ring's +/-0.22 ID band.
//   * squeeze, worst corner 30.16% against the 30% ceiling -- 0.16 points over.
//     Squeeze cannot be lowered to fix it: below 0.2375 the wall under the
//     groove root drops through its 2.4 mm structural minimum (spigot_id 17.5).
//     The two limits cross, so the window is EMPTY -- by hundredths.
//
// The feasibility band itself is fine: 14.45 of 15 points. An earlier version of
// this comment blamed the band and was wrong.
//
// Both remaining gates are dominated by the RING's assumed +/-0.22 ID and
// +/-0.09 cord -- CATALOGUE bands applied to a ring the head's record calls
// UNCATALOGUED. The check is failing on an assumption about the one part nobody
// has measured. Told this, Fab chose to print at nominal and verify by fit:
// "just re-print the cap" / "then get ready 4 print".
//
// THAT IS WHAT THESE FLAGS MEAN AND NOTHING MORE. They do not make the cap
// correct; they record that the checks could not be evaluated on real numbers
// and that a person decided to proceed. These are NOT discharged by measuring
// the ring -- that is ruled out, with reason, at seal_id_tol_meas. They are
// discharged by geometry: the mouth relief opened the lead-in past tube_id and
// closed the corner it was blocking. What remains under these flags is the
// bespoke cap's own squeeze/stretch corners against ONE measured tube.
seal_band_waived = false;
// The same 0.2433 the head uses, and for the same reason: it is where the
// tolerance band sits squarest, not a handbook preference.
seal_squeeze = 0.2433;
carrier_fit = 0.3;          // spigot to bore, diametral

// A COLLAR, NOT A COUNTERBORE, and that inversion is the whole reason a ring
// Fab actually has on the bench can seal this joint.
//
// The seal bore used to be cut INTO the Ø27.2 tube bore, so it had to be
// LARGER than 27.2 -- Ø27.3 -- and a bore that size needs a 24 ID ring. The
// constraint everyone reached for was the board: board_diag is 22.18, so the
// bore has to clear 22.68. That was never the binding one. A 22 x 2 seals
// anything from Ø25.01 to Ø26.41; the whole of that band clears the board.
// The ONLY thing keeping it out was the counterbore's "bigger than 27.2".
//
// So invert it. Add material INWARD at the cable end -- a collar of
// (tube_id - cable_bore_d)/2 on radius, cable_bore_len long -- and ream THAT.
// The Ø27.2 bore is never exceeded, the tube wall is never thinned (the collar
// makes the wall THICKER here, 3.25 mm against the tube's own 2.4), and the
// reamer, the setup and the H7 call-out are unchanged in kind.
//
// PRINTS WITHOUT SUPPORT, and NOT because of the lead cone -- an earlier
// version of this comment claimed the cone was load-bearing and it was wrong.
// The monobody prints CABLE-END DOWN: body-monobody.stl spans model z
// -124.02..+10.30 and slices to 134.36 mm, so Orca lays the cable end (model
// z -124) on the bed. Measured in the sliced g-code, the collar's Ø25.5 bore
// is the FIRST 12 mm off the plate (toolpath r 13.015 from print z 0.30 to
// 12.30, stepping to 13.865 above it).
//
// So the collar is printed straight onto the bed and is supported for its
// whole length, and going UP the bore WIDENS 25.5 -> 27.2, which makes the
// step a TOP-facing surface with material below it. There is no overhang here
// in either orientation.
//
// collar_lead is kept for two reasons that remain true: it is the board's
// lead-in past the collar step, and it avoids a sharp internal corner at the
// root of a sealing land. It is not preventing a defect.
//
// (The head's bore entry IS a real overhang and was fixed this morning: with
// the cable end down the bore NARROWS 27.2 -> 25.18 going up, so that ledge
// faces downward. Same part, opposite sense -- which is exactly why this is
// worth stating from the measured g-code rather than from memory.)
//
// Reamed for the same reason as before: as-printed the bore's +/-0.20 spends
// 19.75 of the 15 available squeeze points on its own; reamed it spends 0.72.
// Drawn at the finished size, so the printed collar comes out UNDER and the
// reamer has stock without a separate pre-ream diameter in the model.
cable_bore_finish = "reamed";
// O25.7, NOT O25.5, AND THE 0.2 IS THE WHOLE POINT. At 25.5 this joint could
// not be built from catalogue rings: enumerate the corners on a printed cap
// root and there is NO groove root that satisfies all four rules at once. The
// moment install stretch clears its 1% minimum (root 22.5322) squeeze reaches
// 30.52% and busts the 30% ceiling. The two rules cross without overlapping.
//
// 25.5 was only ever "the middle of the band a 22 x 2 can seal", picked at
// nominal. Nominal was never the question -- the ring's own +/-0.22 ID band is,
// and it is large next to the stretch the rule needs.
//
// Feasible root windows, all corners, catalogue rings, nominal 22 x 2:
//     bore   printed root +/-0.09     machined root +/-0.05
//     25.5   -- NONE --               22.4925..22.5485  (0.056 wide)
//     25.6   22.5325..22.6155 (0.083) 22.4925..22.6555  (0.163)
//     25.7   22.6200..22.7230 (0.103) 22.5800..22.7630  (0.183)  <-- widest
//     25.8   22.7280..22.7790 (0.051) 22.6880..22.8190  (0.131)
//     25.9   -- NONE --               22.7965..22.8190  (0.023)
//     26.0   -- NONE --               -- NONE --
//
// 25.7 is the widest window there is on a PRINTED cap root, which is the one
// that has to hold -- machining the groove is a second setup this joint should
// not need. seal_squeeze does not change; the root follows the bore to 22.6732
// and lands mid-window.
//
// WHY THIS IS THE RIGHT SHAPE OF FIX, in Fab's words 2026-09-06: "we cannot
// measure every o-ring and print individual parts around it". A design that
// needs each ring measured and a part fitted to it is not a design. The
// tolerance has to be absorbed by the geometry, which is what moving 0.2 mm
// buys -- and it deletes the low-stretch waiver rather than carrying it.
//
// THE TUBE PRINTED 2026-09-06 IS DRAWN O25.5. Ream it to 25.7 anyway: that is
// 0.2 mm more stock on diameter, a normal ream allowance, and more stock gives
// a cleaner reamed surface, not a worse one. Later prints carry 25.7 as drawn.
// STILL O25.7, and the collar with it -- see the refusal recorded at seal_id.
// A one-ring cable end was built at O27.2 on 2026-09-09 and does not close.
//
// One thing that attempt DID settle, and it corrects the note below: the
// collar / counterbore / plain-bore distinction is about what is DRAWN, not
// about whether the reamer finds stock. A printed bore comes out undersize --
// 0.2 mm on radius, measured on MONO-R2's O25.7 collar -- so a reamer cutting a
// nominally equal printed hole removes ~0.2 mm of radius everywhere, exactly as
// it would in a collar or a counterbore. The three shapes are drawing decisions
// about wall thickness and printability, and the asserts below now say so.
cable_bore_d   = 25.7;      // H7, +0.021/0, ISO 286-2 18-30 band
cable_bore_len = 12.0;      // reamed depth = collar length
// 45 degrees, so it is self-supporting whichever way the tube is laid on the
// plate, and it doubles as the board's lead-in past the collar step.
collar_lead    = (tube_id - cable_bore_d)/2;
spigot_len = 8.5;
// Cable passage. NOT a cable requirement -- the M8 gland needs 8.5 -- this is
// derived from the wall left under the groove root, and the collar's smaller
// root is what pulled it down from 20.0. The groove_wall assert is the real
// constraint; this number just has to satisfy it.
spigot_id  = 17.5;

// HOW THE CAP'S GROOVE IS MADE, and it is the second sealing surface -- the
// bore is reamed and this one is not, so it is now the loose end of the chain.
//   "printed"   as it comes off the printer, +/-0.09 (seven readings on printed
//               ASA carriers, o2_probe_head_end.scad carrier_tol)
//   "machined"  turned to size, +/-0.05
// PRINTED. Briefly set to "machined" on 2026-09-09 while a 24 x 1.5 cable end
// was being tried, because that ring needed the tighter root band to have any
// margin at all. The 22 x 2 does not -- it holds +/-0.09 with a 0.103 mm root
// window -- so the lathe operation buys nothing here and is not taken.
cap_fab = "printed";
// "CATALOGUE" IS A CLAIM THIS RING HAS NOT EARNED -- see the provenance note
// above. It is left here because it is the least-flattering assumption
// available for an uncatalogued ring (the DIN ISO 3601 band is wider than any
// sorted stock would be), NOT because the ring is known to meet it. Measure it
// and the bands above take over.
//
// The 2 mm cord genuinely does buy tolerance margin, and that part stands.
// The 24 x 1.5 could not close the chain on catalogue rings -- over 15 of the
// 15 available squeeze points went to tolerance alone, which the 2026-09-05
// Codex review found and this file's prose had wrong at 12.18 -- so it carried
// oring_sorting = "sorted" and a micrometer pass. The same +/-0.08 DIN ISO
// 3601 cord tolerance is a SMALLER FRACTION of a fatter cord, and the band
// assert below now passes at about 11 points with no sorting. The head's
// carrier still needs its own pass; this joint no longer does.
oring_sorting = "catalogue"; // "sorted" or "catalogue"

// SHRINK COMPENSATION ON THE PRINTED ROOT. The head records three readings of a
// root cut oversize and measured after printing -- factors 0.99040, 0.98801 and
// 0.98880, mean 0.9891 -- and the cap emitted its root with no correction at
// all, so a printed root would land near 24.77 against a 25.03 target and take
// nominal squeeze down to about 14 %. Drawn oversize by 1/factor so the PRINTED
// root lands on target.
//
// PROVENANCE IS NOT AIRTIGHT: those readings are on the carrier, and the print
// prescription here is different (1.00-1.02 flow, 0.10-0.15 layers, 0.60 lines
// against 0.95 / 0.20 / 0.45). MEASURE THE ROOT ON THE FIRST CAP before trusting
// the seal, and correct this factor from that measurement.
cap_root_shrink = (cap_fab == "printed") ? 0.9891 : 1.0;

// Bayonet. Chosen over a thread or screws because MEMBRANE.md's rule for this
// enclosure is "no part of the enclosure may carry sustained strain at
// temperature ... retention is by positive features plus a compliant elastomer
// seal that supplies the sealing force". A bayonet lug is a positive feature
// and the O-ring is the spring; a printed thread preloaded at 75 C is the
// creeping-polymer case that rule exists to forbid.
lug_n      = 2;
lug_h      = 3.0;           // axial
lug_r      = 1.6;           // radial projection
lug_arc    = 22;            // degrees
lug_z      = 5.0;           // centre, from the tube's cable end face
slot_slack = 0.35;
// Angular slack at the ENTRY, in degrees. It is the window you have to find by
// feel with the tube in one hand: 3 deg was correct and unusable, 10 deg is a
// tenth of a turn of hunting. It costs nothing but arc.
entry_slack = 10;
twist_deg  = 30;            // lock rotation
// Back-lock depth, so vibration cannot walk the cap open. It is NOT free: to
// enter the pocket the lug must first be pushed PAST it, which compresses the
// O-ring by this much again. At 0.3 the transient squeeze is 40 % against a
// 25 % locked squeeze, which an EPDM cord takes; at the 0.7 first tried, the
// locked gap exceeded the cord and there was no seal at all.
detent     = 0.3;
// 18, not the 12 the face seal needed. The lock screw has to reach its pilot
// THROUGH the skirt, and the pilot has to sit clear of the reamer that cuts the
// sealing bore -- so the boss moved past cable_bore_len, and the skirt had to
// grow to still cover it. Asserted below rather than left to be noticed.
cap_engage = 18.0;          // tube end face depth in the cap AT LOCK
// The pocket runs PAST the end of the twist, not back toward the entry. A hand
// twist overshoots, and a pocket only as wide as the lug would mean feeling for
// an exact stop. Extending it the OTHER way would be worse than useless: it
// would reach back toward the entry slot and let the lug drop into the pocket
// without ever being twisted, which is a cap that falls off.
//
// THE WEDGE RAMP. The pocket used to be a flat slot 0.65 mm taller than the lug,
// so once the lug dropped in it rattled over that 0.65 and turning further did
// nothing. Now the pocket's DEEP wall closes on the lug over the last stretch of
// travel: keep turning and the cap wedges tight.
//
// WHAT THIS IS NOT. It does not tighten the SEAL. The cable seal is radial --
// squeeze is set by the bore and the groove root -- so no amount of twist
// changes it, and that is the point rather than a limitation. A ramp that
// compressed a FACE seal would be sizing an elastomer by hand torque, i.e. a
// sustained strain on ASA at pile temperature, which is what MEMBRANE.md's rule
// forbids. This ramp loads a plastic-on-plastic wedge and nothing else.
//
// WHICH WALL, and it matters for printing: the cap prints MOUTH UP, so the
// pocket's deep wall is an UPWARD-facing surface. Ramping it costs nothing in
// overhang. The mouth-side wall -- the one that carries pull-out load -- is the
// printed roof and is left flat and at pocket_z, so the retention face is
// unchanged from the version that was checked.
ramp = true;
ramp_free = 6;              // deg of pocket the lug drops into before it bites
ramp_deg  = 16;             // deg over which the deep wall closes
// HOW MUCH CLEARANCE IS LEFT AT THE FAR WALL, and this number is the whole
// difference between a wedge that works and one that fights the lock screw.
//
// The first version closed PAST the lug -- 0.15 mm of designed interference, a
// friction wedge, self-locking at 9.6 deg. It measured beautifully and it was
// wrong, and the mesh check is what said so. A friction wedge has no defined
// stop: it stops where hand force balances elastic deformation. The check drove
// the cap to 30 deg (0.2 mm3 of interference) while the model declared its lock
// at 27, and the lock screw cannot live with that. The tube pilot is a 2.5 mm
// hole at r=14, so ONE degree of scatter is 0.24 mm of lateral offset and three
// degrees is 0.73 mm -- the screw simply misses.
//
// So the far wall is the stop, positively, and the ramp only takes up the play
// on the way to it. 0.20 mm is left at the wall: the pocket still converges 0.45
// of its 0.65 mm of rattle, a 3.3x improvement, while a pocket that prints
// 0.1 mm short still REACHES the wall instead of binding 4 deg early and putting
// the pilot out of the screw's reach.
//
// WHAT WAS TRADED AWAY, plainly: there is no interference fit any more and so no
// friction hold. Retention was already the M3 screw -- the assert below has
// refused to build without it since the seal went radial -- so nothing
// load-bearing has been given up. What is gained is a lock angle the screw can
// find.
ramp_clear = 0.20;
// A staircase, because rotate_extrude sweeps a CONSTANT profile and cannot vary
// z with angle. 16 steps puts each riser at 0.05 mm, a quarter of a layer, so
// the slicer cannot resolve them and the printed surface is the ramp.
ramp_steps = 16;
pocket_extra = ramp ? ramp_free + ramp_deg : 8;

// LOCK SCREW. The bayonet's own retention is a 0.3 mm detent plus the wedge
// ramp above -- a friction hold, and friction is not something to bury for a
// season: the ramp's grip depends on a coefficient nobody here has measured, on
// ASA that creeps at pile temperature, and the gland clamps the cable to the
// CAP, so every tug on the cable runs cable -> gland -> cap -> bayonet -> tube.
// One screw makes the lock positive and leaves the wedge doing only what it is
// good at, which is taking the rattle out.
//
// (This paragraph used to credit "the O-ring's preload" for holding the detent.
// That was the 28 x 2 FACE seal, gone since 7fd21c0. A radial seal pushes
// outward, not along the axis, and supplies no preload at all -- which is why
// the assert further down refuses to build without this screw.)
//
// IT MUST NOT REACH THE BORE. A hole through the tube wall at this height opens
// the sealed volume to the outside, below the seal plane -- so the wall is
// thickened locally on the INSIDE, where at z=6 there is nothing but cable, and
// the pilot is blind with 1.0 mm left.
lock_screw = true;
lock_a_tube = 90;           // degrees in the TUBE frame, between the lugs
lock_pilot_d = 2.5;         // M3 thread-forming in ASA
lock_z = 17.0;              // clear of the reamed bore, still under the skirt
lock_boss_r = 9.5;          // inner face of the local wall thickening
lock_boss_arc = 22;         // degrees, centred on lock_a_tube
lock_boss_h = 6.0;
lock_pilot_floor = 12.5;    // radius the pilot bottoms at -> 1.75 mm of boss left
lock_slot_arc = 10;         // half-width of the cap's clearance slot, degrees

// ------------------------------------------------- board guides

// TWO STATIONS, and their positions are not free. The guide has to trap the
// board's EDGES, so it sits on top of whatever copper and parts are there --
// and this board has pads 0.25 mm from the edge (RV1 at y=73, R7 at y=46,
// R38 at y=70). Measured off o2-probe.kicad_pcb on 2026-09-04, the bands where
// BOTH edges are clear by >= 1.5 mm over a run of 5 mm or more are:
//
//     board y   0.0 .. 28.6      cable lands, protection, power
//              47.8 .. 55.7
//              58.3 .. 64.6
//              81.3 .. 103.6     gasward of the pot line
//
// The two long ones are used, which also puts the stations as far apart as the
// board allows. Engagement is 1.0 mm of board width per side against a 1.5 mm
// clear band, so there is 0.5 mm in hand -- and that margin is for PAD
// clearance only. Pads were what could be measured from the board file; a
// component BODY overhanging its own pads is not covered. Look along the edge
// of the populated board before the first insertion.
//
// IF THE BOARD REVISION CHANGES, RE-RUN THAT SCAN. These four numbers are the
// only thing tying this part to that board.
guide_engage = 1.0;
guide_slack  = 0.3;         // on board thickness
guide_body   = 7.0;         // rail width across the board plane
guide_r_max  = 14.8;        // how far the rail buries itself in the wall (bore is 13.6)
station_a = [ 4.0, 24.0];   // board y
// Station B is SHORTER in the monolithic joint, and not by choice. Bonded, the
// tube runs to board y=105 and the rail can use the whole 81.3..103.6 clear
// band. Monolithic, the tube stops where the head begins -- board y=91 -- so
// the rail has to end there, and only 81.3..91 of that band is on this part.
// Nothing carries the board over the last 16 mm in that case except the head's
// own bore, which is 24.93 against a 21.93 mm swept diagonal: it locates the
// board loosely, and it is the only thing that does.
station_b = (joint == "monolithic") ? [82.0, 90.0] : [86.0, 102.0];

// ------------------------------------------------- the wire-end grip band
//
// FAB, 2026-09-05: the cable-end guides should hold the board by FRICTION, not
// just locate it. `guide_slack` = 0.3 does not: on a 1.6 mm board it is a
// 1.9 mm slot, and a printed slot comes out 0.1-0.2 mm under nominal in XY, so
// the board still rattles by something like a tenth. What follows makes ONE
// SHORT BAND of station A tight and leaves the rest of both stations at the
// old clearance.
//
// WHY A BAND AND NOT THE WHOLE RAIL. The board goes in tip-first from the cable
// end, so EVERY millimetre of its 107 mm edge is dragged through station A --
// there is no way to put a tight feature at the cable end that the whole board
// does not have to pass. That is not fatal (the FR4 edge is far harder than the
// ASA, so the slot yields, not the board) but it sets two rules:
//
//   * keep the interference SHORT, so the drag force is a band's worth and not
//     20 mm of it, and so each insertion shaves as little as it can;
//   * ramp INTO it, so the board wedges rather than butts against a step.
//
// It is also why this is a prototype-grade hold and nothing more. Friction in
// printed ASA is not a retention feature that survives a season at pile
// temperature -- the same objection the header raises against the bayonet's
// friction wedge, and it applies here unchanged. The board is retained by being
// captive between the cap and the head cavity; the grip stops it rattling and
// stops it falling out while the probe is being assembled upside down.
//
// GEOMETRY. The band sits at the HEAD-SIDE end of station A, `grip_end_gap`
// short of the rail's end so the existing end lead-in taper stays clear of it.
// With station A at board y 4..24 that puts the grip on board y 14..20 and the
// ramps on 12..14 and 20..22 -- all inside the measured 0.0..28.6 clear band.
guide_lead    = 1.5;        // end lead-in taper on every rail
grip_len      = 6.0;        // axial length of the interference band
grip_ramp     = 2.0;        // clearance -> grip transition at each end
// >= guide_lead + grip_ramp, or the end taper reopens the band (asserted).
grip_end_gap  = 4.0;        // from the head-side end of station A

// THE ONE NUMBER THE PRINTER DECIDES. `grip_slack` is nominal slot height minus
// board thickness at the band: 0.30 is the old clearance, 0.00 is a slot drawn
// exactly the board's thickness (which, printed, is already an interference),
// negative is drawn interference on top of that. It cannot be derived -- it is
// the sum of this printer's XY undersize, the ASA's shrink, the board's real
// thickness including soldermask, and how hard a "firm push" is.
//
// THE BAND IS OFF, AND THAT IS THE DECISION -- not an unfinished experiment.
//
// FAB, 2026-09-05, after the ladder was read: "we will restore the grips as
// printed before. the problem is the board has footprints very close the edge
// and we need the grips to be loose."
//
// So station A goes back to the plain `guide_slack` = 0.3 clearance it had on
// the monobody printed 2026-09-05, and the grip machinery below stays in the
// file, switched off, with the number it measured.
//
// WHY LOOSE WINS HERE, because it is the opposite of what a friction fit is for.
// The rail traps the board's EDGES, and this board has pads 0.25 mm from the
// edge (RV1 at y=73, R7 at y=46, R38 at y=70) -- the guide sits on top of
// whatever copper and parts are there, with 0.5 mm in hand against the measured
// clear band and NOTHING measured about component bodies overhanging their own
// pads. A clearance slot lets the board pass through that; an interference slot
// presses the rail onto it, and does so for the whole 107 mm of edge that has
// to be dragged through station A on every insertion. The failure mode is not
// a loose board, it is a scraped edge footprint on a board that is already at
// the fab and cannot be re-spun for this.
//
// Rattle is the cheaper problem, and it is not unbounded: the board is captive
// between the cap and the head cavity either way.
//
// Set `grip_band = true` to bring it back -- for a board revision that keeps its
// edges clear, which is the condition that would make it safe. `grip_slack`
// below is already measured, so that switch is the only thing needed.
grip_band     = false;

// CLOSED 2026-09-05 (Fab): "00 is the one". Measured on the printed fit-coupon
// ladder -- rungs 06 and 00 in Elegoo ASA at the body-tube process -- so this is
// a 1.60 mm slot drawn on a 1.6 mm board, which printed is an interference.
//
// The coupon print it was read off ABORTED at layer 142 of 149 with poor bed
// adhesion (a separate problem, under investigation elsewhere). That does not
// weaken this number: the bands sit at z 6..12 mm, layers ~50..100, and the
// plain 1.90 reference sections at z 0..4 and 12..16. Everything read was on
// the part long before it stopped; only the top ~0.8 mm never printed, and
// nothing is measured there.
//
// STILL TO CONFIRM ON A TOWER. The coupon is 16 mm of ring; the tube is a 124 mm
// tower printed one-up, with this band ~36 mm up it. Layer times differ, so the
// undersize may. Check the fit on the first printed tube before anything is
// buried. See PRINTING-BODY-TUBE.md, "Setting the wire-end grip".
grip_slack    = 0.00;       // MEASURED 2026-09-05, fit-coupon rung 00
grip_measured = true;       // ... and not currently used: grip_band is false

// What station A actually gets. With the band off this collapses to the plain
// clearance, and `guide()` then cuts one uniform slot -- the ramps degenerate to
// scale 1.0 and the three cuts merge. Everything downstream reads THIS, so the
// echo, the mesh check and the part cannot disagree about which is in force.
grip_slack_eff = grip_band ? grip_slack : guide_slack;

// The ladder the coupon prints, loosest first.
//
// FAB, 2026-09-05: cut to 06 and 00. The wider sweep (0.30, 0.20, 0.12, 0.06,
// 0.00) is what the ladder table in PRINTING-BODY-TUBE.md is drawn against, and
// it brackets the printer's undersize for any delta from 0.05 to 0.20 -- but the
// two rungs kept are the pair that straddle zero interference across most of
// that range, and they are the only ones a hand can tell apart. The looser three
// are all clearance fits and would only have confirmed that clearance is loose.
//
// DROPPING 0.30 COSTS NOTHING, and that is worth saying because it looks like it
// should. 0.30 was in the list as the reference rung -- the old clearance, the
// same 1.90 mm slot as station A on the tube printed 2026-09-05, so that the
// coupon could be tied back to a part already in hand. That tie survives: EVERY
// rung carries `coupon_pad` = 4 mm of plain 1.90 slot above and below its band,
// so the reference is measurable on both remaining rings. It was redundant.
coupon_slacks = [0.06, 0.00];
coupon_pitch  = tube_od + 4;
coupon_pad    = 4.0;        // plain rail above and below the band's ramps
coupon_h      = grip_len + 2*grip_ramp + 2*coupon_pad;
coupon_flange_w = 16.0;
coupon_flange_d = 13.0;
coupon_flange_t = 1.6;

// Optional dam, see the header. Sits just gasward of the pot line, in the same
// clear band as station B.
dam_y = 81.0;               // board y of its cable-side face
dam_t = 4.0;
dam_fit = 0.4;              // diametral, in the bore

// ------------------------------------------------- derived

board_in_tube = board_len - cav_board_len;      // 105.0
// Bonded, this part runs to where the board's tip section starts (board y=105)
// and its top 14 mm live inside the head's socket. Monolithic, the head's own
// z=0 face IS that plane minus the socket, so the tube ends there instead and
// the head carries on from it.
tube_len = board_in_tube + tail_len
         - ((joint == "monolithic") ? head_socket_len : 0);
board_y0_z = tail_len;                          // board y=0 sits here
function zy(y) = board_y0_z + y;                // board y -> tube z

// The grip band, in tube z. Station A only -- station B stays plain clearance,
// because it is the far station and the board has to be free to find the head's
// bore over the last 16 mm (see the station B note above).
grip_a1 = zy(station_a[1]) - grip_end_gap;
grip_a0 = grip_a1 - grip_len;

// THE LOCK ROTATION, derived rather than measured off the checker.
// Work it in the LAB frame, where the tube stands +z up and the cap arrives
// from below. Placing the cap is rotate([180,0,0]), which maps (x,y,z) to
// (x,-y,-z) -- so a cap-frame angle phi appears at lab angle -phi, and the
// handedness of every cap angle flips. That flip is the single thing that made
// the first three attempts at this disagree with each other.
//   entry slot, cap [0, entry_arc]          -> lab [-entry_arc, 0]
//   pocket,     cap [pocket_a0, pocket_a1]  -> lab [-pocket_a1, -pocket_a0]
// A lug is modelled at tube angle [0, lug_arc] and the tube is turned by psi,
// so the lug sits at lab [psi, psi + lug_arc] and has to fit inside those.
entry_arc  = lug_arc + entry_slack;
pocket_arc = lug_arc + pocket_extra;
pocket_a0  = -twist_deg - pocket_extra;
pocket_a1  = pocket_a0 + pocket_arc;
psi_entry  = (-entry_arc + (-lug_arc))/2;               // -27
// The lug travels toward DECREASING cap angle, so it enters the pocket at the
// pocket_a1 end and runs out toward pocket_a0. In psi that is +8 (just dropped
// in) to +30 (leading edge on the far wall).
psi_seated = -pocket_a1;                    // +8, the moment it drops in
psi_hard   = -pocket_a0 - lug_arc;          // +30, leading edge on the far wall
// The ramp starts once the LEADING edge passes ramp_a, and closes linearly to
// the far wall. The lug stops where the closure equals the interference, which
// is ramp_interf short of the hard end -- so the lock angle is derived from the
// ramp, not from the middle of a slot.
ramp_a     = pocket_a0 + ramp_deg;                      // cap angle, -36
ramp_close = detent + slot_slack - ramp_clear;          // 0.45 mm of closure
// Guarded: the bayonet check's known-bad control builds this same cap with
// -D ramp_close=0, and an unguarded divide made that control render as nothing
// at all -- a calibration that fails to build is not a calibration.
// The stop is the FAR WALL, so the lock angle is psi_hard and nothing is derived
// from how hard the cap happened to be turned.
psi_lock   = ramp ? psi_hard                            // +30
                  : (-pocket_a1 + (-pocket_a0 - lug_arc))/2;
// SELF-LOCKING, which is the whole reason the ramp is shallow and long rather
// than short and steep. A wedge holds only while its slope is under the
// coefficient of friction; above that it springs back out as soon as the hand
// comes off. ASA on ASA is ~0.35-0.45 dry, so 0.20 is the limit with margin for
// a wet, warm, ammoniacal joint.
ramp_r    = tube_od/2 + (lug_r + slot_slack)/2;         // mean contact radius
ramp_run  = ramp_r * ramp_deg * PI/180;
ramp_slope = ramp_close/ramp_run;
// The ramp must not close past the lug, or the lug stops on the RAMP instead of
// on the wall and the lock angle becomes force- and tolerance-dependent -- which
// is the defect this parameterisation exists to prevent, so it is asserted and
// not merely commented.
assert(!ramp || ramp_clear > 0,
       "the ramp closes onto the lug: the cap would stop on the ramp rather than on the far wall, and the lock screw pilot moves with however hard it was turned");
// Shallow enough that the lug is guided rather than jammed. This is no longer a
// self-locking criterion -- there is no interference to lock -- but a steep ramp
// on a printed staircase would be a step the lug climbs, not a surface it slides on.
assert(!ramp || ramp_slope <= 0.20,
       str("ramp slope ", ramp_slope, " (", atan(ramp_slope),
           " deg) is too steep for the lug to slide up. Lengthen ramp_deg."));
// The lug has to be able to DROP INTO the pocket before the ramp touches it,
// otherwise there is no seated state and the cap jams on the way in.
assert(!ramp || ramp_free >= 2,
       "no free pocket before the ramp: the lug would meet the closing wall before it has dropped off the detent step");
// The pilot is at lock_a_tube in the TUBE, so at lock it stands at this lab
// angle, and the cap's clearance slot has to be at MINUS that in its own frame.
lock_a_lab = lock_a_tube + psi_lock;
lock_a_cap = -lock_a_lab;

// ------------------------------------------------- grip scallops, PHASED
//
// FAB, 2026-09-06, off the Orca preview: "this grip-groove causes the whole
// wall to collapse and it becomes a slot ... set the outer grip grooves so they
// are not where the inner lock-grooves are."
//
// The scallops were a fixed `for (i = [0:5]) rotate([0, 0, i*60])`, and the
// bayonet slots are at i*360/lug_n -- 0 and 180. Six scallops on a 60 deg pitch
// put TWO of them exactly on a slot, every time, BY CONSTRUCTION. What is left
// between them:
//
//   cap OD               r 18.60
//   skirt bore           r 16.20    plain wall             2.40 mm
//   bayonet slot floor   r 17.95    wall over the slot     0.65 mm
//   scallop reaches      r 18.30    the scallop cuts       0.30 mm
//   both at the same angle          what survives          0.35 mm
//
// 0.35 mm is half an extrusion. It does not print as a thin wall, it prints as
// a hole, which is what the preview showed.
//
// THE ANGLES ARE DERIVED NOW, NOT LISTED. A fixed list is exactly what went
// stale when the bayonet moved; this builds a keep-out from the features that
// actually cut the skirt and keeps the candidates that clear it. Move the lugs,
// change lug_n, move the lock slot -- the scallops follow.
scallop_d        = 2.4;
scallop_r_c      = tube_od/2 + cap_fit/2 + cap_wall + 0.9;
cap_r_out        = (tube_od + cap_fit + 2*cap_wall)/2;
scallop_cut      = cap_r_out - (scallop_r_c - scallop_d/2);
// Half-angle of the scallop where it actually breaks the OD -- not the half
// angle of the whole cutter, which never touches the part.
scallop_half     = asin(sqrt(pow(scallop_d/2, 2)
                            - pow(scallop_r_c - cap_r_out, 2)) / cap_r_out);
scallop_clear    = 4.0;      // degrees of keep-out either side of that
scallop_wall_min = 0.60;     // one extrusion; under it the wall IS a hole

// Everything that cuts the skirt from the INSIDE, in the cap's own frame: each
// bayonet slot runs from its pocket's far wall to the end of its entry window.
skirt_keepout = concat(
    [ for (i = [0:lug_n-1]) [pocket_a0 + i*360/lug_n, entry_arc + i*360/lug_n] ],
    [ [lock_a_cap - lock_slot_arc, lock_a_cap + lock_slot_arc] ]);

function _ovl(a0, a1, b0, b1) = (a0 < b1) && (b0 < a1);
// +/-360 because a keep-out arc may straddle the wrap and a scallop at 350 has
// to see an arc written as -20..20.
function _scallop_clash(a) =
    len([ for (K = skirt_keepout) for (m = [-360, 0, 360])
          if (_ovl(a - scallop_half - scallop_clear,
                   a + scallop_half + scallop_clear, K[0] + m, K[1] + m)) 1 ]) > 0;

scallop_step = 15;
scallop_a = [ for (i = [0 : round(360/scallop_step) - 1])
                let (a = i*scallop_step) if (!_scallop_clash(a)) a ];

// A cap you cannot grip is not a fix. If the keep-out swallows the skirt, that
// is a bayonet problem to solve, not a reason to put scallops back on the slots.
assert(len(scallop_a) >= 4,
       str("only ", len(scallop_a), " grip scallops clear the skirt's internal ",
           "slots (keep-out ", skirt_keepout, "). The cap cannot be twisted by ",
           "hand. Widen the skirt, drop to lug_n=1, or shorten the pocket -- do ",
           "NOT put a scallop back over a slot: that is the 0.35 mm wall."));
// And the wall over the slot on its own, which the scallop was only finishing
// off. 0.65 mm is ONE extrusion: it prints, but it is the thinnest thing on
// this part and it is worth widening the skirt when the cap is next revised.
skirt_slot_wall = cap_r_out - (tube_od/2 + lug_r + slot_slack);
assert(skirt_slot_wall >= scallop_wall_min,
       str("the skirt is only ", skirt_slot_wall, " mm thick over the bayonet ",
           "slot, under the ", scallop_wall_min, " mm one-extrusion floor"));
echo(str("GRIP SCALLOPS: ", len(scallop_a), " of ", round(360/scallop_step),
         " candidates clear the skirt slots -> ", scallop_a,
         " deg. Each cuts ", scallop_cut, " mm deep and spans +/-", scallop_half,
         " deg; keep-out ", skirt_keepout, " widened by ", scallop_clear,
         " deg. Wall over a bayonet slot ", skirt_slot_wall,
         " mm (ONE extrusion -- widen the skirt at the next cap revision)."));


// Bayonet angles, in the CAP's frame. The entry slot starts at 0 and the pocket
// sits `twist_deg` back from it; `pocket_a1 < 0` below is what guarantees the
// two never touch, i.e. that the cap cannot be pushed straight into its locked
// position without being twisted.
// Bayonet, in the CAP's frame (z from the cap mouth inward).
face_clear = 0.5;                               // tube end face to cap inner face
cap_bore_depth = cap_engage + face_clear;       // mouth to the cap's inner face
pocket_z  = cap_engage - lug_z - lug_h/2;       // pocket floor = the lock stop
chan_top  = pocket_z + detent + lug_h + slot_slack;
cap_h     = cap_bore_depth + cap_end_t;

// THE GLAND'S SEAL NOTCH, derived. Mean diameter on the ring's own centreline,
// width 1.2x cord so the ring can spread as it is squeezed, depth cord minus
// the squeeze so the gland's flange still lands on the face and does the
// compressing -- a groove deeper than the cord would hold the flange off and
// seal nothing.
gland_notch_mean  = gland_seal_id + gland_seal_cord;
gland_notch_w     = 1.20 * gland_seal_cord;
gland_notch_id    = gland_notch_mean - gland_notch_w/2;
gland_notch_od    = gland_notch_mean + gland_notch_w/2;
gland_notch_depth = gland_seal_cord * (1 - gland_seal_squeeze);

// The notch must not eat the thread. This is the assert that makes the 3 mm
// wall work at all: if the groove's inner wall fell inside the thread's major
// diameter it would take its depth out of the tapped length, and 3 mm is
// already only 3 turns of M8 x 1.0.
// THIS ASSERT USED TO DEMAND 0.4 mm ON DIAMETER -- 0.2 mm on radius -- between
// the clearance hole and the notch, which is a THIRD of one extrusion width. It
// passed at 9.20 against 8.90 while the feature it guarded could not be built at
// all. A printability limit written below the printer's resolution is not a
// guard; it is a number that always says yes.
//
// The pocket is a counterbore now, so there is no lip to be too thin and the
// old assert has nothing left to check. What replaces it is the constraint that
// actually binds: the pocket must not eat the thread's clearance hole edge-on,
// and it must leave a real floor.
assert(gland_notch_od > gland_hole_d + 2*wall_line_w,
       str("the gland seal pocket is only ", (gland_notch_od - gland_hole_d)/2,
           " mm wider than the clearance hole on radius; under one extrusion ",
           "(", wall_line_w, ") there is no pocket wall to retain the ring"));
// And it must leave a floor. 1.5 mm is two 0.6 mm walls plus a skin, on a face
// that carries the whole cable pull through the gland's flange.
assert(cap_end_t - gland_notch_depth >= 1.5,
       str("only ", cap_end_t - gland_notch_depth,
           " mm of cap end left under the seal pocket"));
// The pocket is in the INNER face now, so it takes its depth out of the length
// the gland clamps -- which the outer-face annulus deliberately did not. Say so
// in an assert rather than in prose: what the nut and flange squeeze between
// them is the remaining land, and it is still the whole strain relief.
assert(cap_end_t - gland_notch_depth <= gland_wall_max + 1e-9,
       str("clamped land is ", cap_end_t - gland_notch_depth,
           " mm, past the ", gland_wall_max, " mm this gland can close on"));
assert(gland_notch_od + 2*cap_wall <= tube_od + cap_fit + 2*cap_wall,
       "the gland seal notch runs out past the cap's rim");
// The plastic sits between the gland's flange and its nut, so the wall cannot
// exceed what the thread has left after the nut takes its share.
assert(cap_end_t <= gland_wall_max + 1e-9,
       str("cap end ", cap_end_t, " mm exceeds the ", gland_wall_max,
           " mm this gland can clamp; the nut would run out of thread before it seated"));

// The radial gland, mirroring o2_probe_head_end.scad's carrier seal exactly --
// including the parts this file used to skip.
// THE BORE THIS CAP IS CUT TO MATE WITH -- normally the one this same file
// draws, and that is the default. It is separable for one reason: a printed
// tube whose bore is NOT going to be reamed.
//
// Fab, 2026-09-06: no reamer on the bench. Reaming exists to make the bore
// PREDICTABLE -- PRINTING-BODY-TUBE.md's "as-printed, +/-0.20 spends 10.11 of
// the 15" squeeze points is a statement about not knowing the bore, not about
// the bore being wrong. Measure one specific tube and that uncertainty is gone
// without cutting anything: the cap is then cut to THAT tube.
//
// So set mate_bore to the measured bore and print a cap. The tube geometry
// above does not move -- cable_bore_d stays what the tube was drawn at -- so
// this cannot silently produce a tube nobody meant to print.
//
// A cap cut this way is BESPOKE TO ONE TUBE. Mark both, or they will be mixed
// up: they are visually identical and 0.3 mm apart.
mate_bore = undef;                       // undef => mate with this file's own bore
mate_bore_tol = 0.05;                    // half-spread of YOUR readings, not a guess
seal_bore = is_undef(mate_bore) ? cable_bore_d : mate_bore;
// THE BOUND USED TO BE `seal_bore < tube_id`, which encoded the COLLAR and
// nothing else: it was added with 56407da, and it would have refused 7fd21c0's
// own O27.3 counterbore as implausible. What this assert is actually for is a
// MEASURED number -- mate_bore, read off a finished tube with a bore gauge --
// so the real question is whether the reading is near the bore the tube was
// drawn at. Half a millimetre away is a mis-measurement or the wrong tube, in
// either direction, and that is what it now says.
assert(seal_bore > 22.5 && abs(seal_bore - cable_bore_d) <= 0.5,
       str("mate_bore ", seal_bore, " is not a plausible cable-end bore: the ",
           "tube is drawn ", cable_bore_d, ", and a reading ",
           abs(seal_bore - cable_bore_d),
           " mm from that is a mis-measurement or a different tube"));

spigot_od   = seal_bore - carrier_fit;
// seal_squeeze is the SIZING BASIS, not the achieved squeeze. It sets the root;
// what the ring then delivers is seal_squeeze_real below, and they are not the
// same number because stretching the ring thins its cord.
groove_root = seal_bore - 2*seal_cord*(1 - seal_squeeze);
groove_root_drawn = groove_root / cap_root_shrink;   // what the model cuts
groove_w    = 1.40 * seal_cord;                 // 1.40: the head's fill gate
seal_stretch = (groove_root - seal_id)/seal_id;
groove_wall = (groove_root - spigot_id)/2;      // material under the groove root
lead_chamfer = 1.0;

// THE BORE'S OWN LEAD-IN, and it was missing entirely until 2026-09-06.
//
// collar_lead is at the collar's INNER end and its comment says what it is for:
// "the board's lead-in past the collar". Nothing led the O-RING in. The ring
// arrives at the cable-end face, which was a square 90 deg edge into the full
// Ø25.7 bore, standing seal_lead_r proud of it on radius -- and lead_chamfer on
// the spigot does not help, because the ring sits 1.2 mm BEHIND that chamfer, so
// the spigot is already inside before the ring reaches the edge.
//
// An O-ring driven at a square edge shaves, rolls out of its groove, or simply
// stops. Standard practice is a 15-20 deg lead-in at least as deep on radius as
// the ring stands proud, and that is what this is. 20 deg, sized FROM the ring
// rather than picked: it follows cord, stretch and bore automatically, so it
// cannot go stale the way collar_lead's rationale did.
bore_lead_ang = 20;         // degrees, included half-angle from the bore axis
bore_lead_margin = 0.15;    // extra radial clearance over the ring's own stand-off

// AND IT HAS TO CLEAR THE RING IN THE BORE THAT ACTUALLY PRINTS, NOT THE DRAWN
// ONE. The first version of this lead-in sized itself off cable_bore_d = 25.7
// and was still not enough, because a printed bore comes out undersize: the
// inner perimeter lands inside the intended wall by roughly one nozzle's worth
// of squish, and the cone mouth shrinks by the same amount as the bore it opens.
//
// MEASURED, MONO-R2, Fab's calipers 2026-09-06: drawn 25.70, printed 25.30-25.40
// -- 0.15 to 0.20 mm on radius.
//
// WHAT IS MEASURED AND WHAT IS NOT, because the difference matters and an
// earlier version of this comment blurred it. MEASURED: the radial undersize of
// a O25.7 CYLINDRICAL collar bore on one tube. EXTRAPOLATED: that the same
// radial offset applies to the mouth this cone opens -- a different feature at a
// different diameter, and where the cone is not capped, a sloped layered surface
// rather than a vertical wall. Layer sampling and slicer contour placement can
// move a sloped profile either side of a constant-offset model.
//
// In the DEFAULT geometry the cone is capped at tube_id, so the mouth really is
// a vertical wall and the offset model is dimensionally sound there. It is still
// an estimate. Every derived mouth number below is ESTIMATED, and the echo says
// so -- do not quote them as measurements.
//
// The worst of the range is used, because the cost of
// a lead-in that is too big is a fraction of a millimetre of sealing land, and
// the cost of one that is too small is a probe that cannot be assembled. That
// is not a symmetric trade and it should not get a symmetric allowance.
//
// This is ONE tube measured by ONE person on ONE printer. It is the best number
// available and it is not a constant of nature -- re-measure the bore on each
// new tube, and if a printer or a material changes, this is the first thing that
// goes stale. It is deliberately NOT folded into cable_bore_d: the bore stays
// the dimension we intend to hold, and this is the allowance for missing it.
//
// WHAT THIS DOES NOT FIX: the same 0.35 mm is missing from the SEALING bore, so
// the printed joint squeezes the ring harder than the design of record says.
// That is handled today by cutting a bespoke cap to a measured tube (mate_bore),
// not by compensating the tube. Doing it properly is a separate change.
bore_print_undersize_r = 0.20;   // radial, worst of the measured 0.15-0.20

// SQUEEZE AFTER STRETCH-THINNING. Stretching a cord onto a groove root makes it
// thinner, and that eats squeeze -- the head has always done this and this file
// reported the unthinned number, overstating squeeze by about 1.7 points.
// Linear thinning (1 - stretch/2), the head's convention; constant volume
// (1/sqrt(1+stretch)) differs by 0.001 mm here and is not worth the divergence.
seal_gland      = (seal_bore - groove_root)/2;
seal_cord_thin  = 1 - seal_stretch/2;
seal_cord_fit   = seal_cord * seal_cord_thin;
seal_squeeze_real = (seal_cord_fit - seal_gland)/seal_cord_fit;

// How far the ring stands proud of the bore, on radius: its OD seated on the
// groove, less the bore. This IS the interference the lead-in has to take up.
seal_ring_od  = groove_root + 2*seal_cord_fit;

// THE RING'S TOLERANCE BANDS, needed HERE because the lead-in is sized off the
// ring's worst corner. The corner enumeration further down uses the same three.
root_tol  = (cap_fab == "machined") ? 0.05 : 0.09;
// d2 row by cord, not by habit. Sorting is a bench operation on cord only.
cord_tol  = !is_undef(seal_cord_tol_meas) ? seal_cord_tol_meas
          : (oring_sorting == "sorted") ? 0.01
          : (seal_cord <= 1.80) ? 0.08 : 0.09;                // DIN ISO 3601
// d1 row by ID. UNMEASURED RING: this is the catalogue band, and for the
// on-hand 22 x 2 even that is an assumption (see the provenance note above).
seal_id_tol = !is_undef(seal_id_tol_meas) ? seal_id_tol_meas
            : (seal_id >= 23.0) ? 0.25 : 0.22;

// THE FATTEST RING THE BANDS ALLOW -- and this, not the nominal one, is what
// the mouth has to swallow. A lead-in sized on the nominal ring is a lead-in
// that works for half the rings in the bag. Cord runs +/-0.09 on its own, so
// the worst OD is 0.28 over nominal here: bigger than the whole margin the
// first version of this cone was given.
seal_ring_od_max = max([ for (R = [groove_root - root_tol, groove_root + root_tol])
                         for (C = [seal_cord - cord_tol, seal_cord + cord_tol])
                         for (I = [seal_id - seal_id_tol, seal_id + seal_id_tol])
                           let (st = (R - I)/I) R + 2*C*(1 - st/2) ]);

// The interference the lead-in has to take up is measured against the bore that
// PRINTS, so the undersize allowance is part of the rise, not an afterthought.
seal_lead_r   = (seal_ring_od_max - cable_bore_d)/2 + bore_lead_margin
                                                    + bore_print_undersize_r;
bore_lead_h   = seal_lead_r / tan(bore_lead_ang);
// THE CONE USED TO BE CAPPED AT tube_id AND IS NOT ANY MORE. It was cut inside
// the collar's own difference(), whose outer surface IS tube_id, so it stopped
// at O27.2 no matter what it asked for -- and the mesh, not the model, is what
// said so. The cut now happens in tube()'s outer difference() and passes into
// the tube wall, so the mouth is the full cut diameter.
//
// The cap was not a nuisance, it was the binding constraint: at O27.2 the mouth
// printed to 26.80 and the worst in-band ring (26.892) did not fit through it,
// with no groove root anywhere in the feasible squeeze window able to fix it.
bore_mouth_drawn   = cable_bore_d + 2*seal_lead_r;
bore_mouth_printed = bore_mouth_drawn - 2*bore_print_undersize_r;

// WHAT THE RELIEF COSTS: tube wall at the mouth, at its thinnest, before the
// cone tapers back to full section within bore_lead_h. Three 0.60 mm lines is
// the floor -- under that the mouth is a rim, not a wall, and the cable end is
// exactly where the cap is pushed on and twisted by hand.
mouth_wall      = (tube_od - bore_mouth_drawn)/2;
mouth_wall_min  = 1.80;
assert(mouth_wall >= mouth_wall_min,
       str("the mouth relief opens to ", bore_mouth_drawn, " and leaves only ",
           mouth_wall, " mm of tube wall at the cable end, under the ",
           mouth_wall_min, " mm floor. The relief is driven by the ring's worst ",
           "corner and the printed undersize -- reduce the CORD or the groove ",
           "root, do not thin the wall further."));

// HOW MUCH ROOM THE RING ACTUALLY HAS AT THE MOUTH. Once tube_id caps the cone
// this stops being a derived identity and becomes a real measurement of the
// design, because the two sides now come from different places: the ring from
// its tolerance bands, the mouth from the tube's inner diameter.
bore_mouth_clear     = bore_mouth_printed - seal_ring_od;      // nominal ring
bore_mouth_clear_max = bore_mouth_printed - seal_ring_od_max;  // worst corner

// The nominal ring MUST pass. If it does not, the joint cannot be assembled at
// all and no amount of chamfer angle will change it -- the cone is already as
// wide as the tube.
//
// THIS IS A REAL GUARD ONLY WHERE THE CONE IS CAPPED, which is the default and
// the bespoke mate_bore paths -- there the mouth comes from tube_id and the ring
// from its bands, two independent places, and it fires: mate_bore = 26.0 was
// tried and it failed as it should. Where the cone is NOT capped the mouth is
// built from seal_ring_od_max + margin and this reduces to an identity again.
// Recorded rather than hidden; the capped branch is the one that ships.
assert(bore_mouth_clear > 0,
       str("the mouth opens to ", bore_mouth_printed, " once printed and the ",
           "nominal ring is ", seal_ring_od, " across: it cannot enter. The cone ",
           "is already capped at tube_id (", tube_id, "), so this is NOT fixable ",
           "with bore_lead_ang -- it needs a thinner cord, a bigger tube_id, or ",
           "a counterbore at the mouth."));

// THE WORST CORNER, REPORTED EITHER WAY. It used to fail here, and the fix was
// geometric: the mouth relief cuts past tube_id, so the fattest in-band ring now
// clears with the full bore_lead_margin. This echo stays because the corner is
// the thing that actually gates assembly, and it must be visible when a cord,
// a bore or an undersize figure changes and eats the margin again.
//
// DO NOT silence a future failure here by widening bore_lead_ang -- the angle
// changes how DEEP the cut is, not how wide -- and do not reach for measuring
// the ring, which is ruled out at seal_id_tol_meas. The levers are the mouth
// relief (bounded by mouth_wall_min), the groove root, and the cord.
echo(bore_mouth_clear_max > 0
     ? str("MOUTH CLEARANCE: ", bore_mouth_clear_max,
           " mm even at the ring's worst corner -- the lead-in is sufficient.")
     : str("MOUTH CLEARANCE: the nominal ring clears by ", bore_mouth_clear,
           " mm but the WORST-CORNER ring (", seal_ring_od_max, ") is ",
           -bore_mouth_clear_max, " mm too big for the ", bore_mouth_printed,
           " printed mouth. The cone is capped at tube_id and cannot open ",
           "further without cutting into the tube wall past mouth_wall_min. ",
           "Open the mouth relief, drop the groove root, or go to a thinner ",
           "cord -- NOT to a micrometer: measuring the ring is ruled out. A fat ",
           "ring from the bag would refuse to enter, which is exactly the ",
           "2026-09-06 bench failure."));
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
