fl4p/o2-probe/cad/o2_probe_head_end.scad

/*
 * O2 probe — buried head, END-WINDOW variant (printed ASA)
 * Units: millimetres. Z runs from the tube joint toward the tip.
 *
 * The alternative to o2_probe_head.scad, built so the two can be compared on
 * numbers instead of argument. The gas window is on the END face, so nothing has
 * to be found in the radial budget -- which is what forces the radial variant to
 * 46 mm and 11.2 cm3.
 *
 * IT NO LONGER COMMITS A CELL ORIENTATION, and that changed on 2026-09-05. This
 * file was built around PLAN.md's option C -- cell past the board end, axis along
 * the tube, sitting in a necked bore -- and Fab returned the design to option A,
 * the cell STANDING on the board like any other THT part, gas face radial. The
 * end window is orthogonal to that choice: see cell_mount, which defaults to
 * "standing" and keeps "past-end" so the two can still be compared.
 *
 * THE SEALING STACK, compost inward (MEMBRANE.md, decision 2026-09-02):
 *
 *     debris cap          replaceable, solid front, side slots only
 *     drainage gap        no liquid pocket against the membrane
 *   --------------------  ------------------------------------------------
 *     PMV15T coupon       the barrier; WEP 265 mbar min / 370 typ
 *     PP carrier          coupon FUSED in (ultrasonic or thermal weld)
 *     O-ring (radial)     carrier-to-head seal, squeezed by the FIT
 *     ASA head            this file
 *     bonded socket       head-to-tube, continuous circumferential bond
 *
 * No adhesive is load-bearing on the wet side, which MEMBRANE.md forbids until
 * a named adhesive has passed hot-condensate ageing.
 *
 * Three jobs are deliberately separated. The O-RING seals, and its squeeze comes
 * from the interference fit, so no fastener is in the seal load path and PP
 * creep at 75 C cannot bleed it off. The RETAINER only holds the carrier down.
 * The CAP is only a debris guard, independently replaceable as MEMBRANE.md
 * requires, and its open band is sized so the guard never out-restricts the
 * membrane it protects.
 *
 * MEASURED INPUTS ARE REFUSED, NOT GUESSED.  Preview: make head-end-provisional
 */

include <membrane_cartridge_common.scad>

$fn = 96;
heps = 0.02;
view_rot = 0;               // render-only: lay the stack over for a wider image

part = "assembly";   // assembly, head, carrier, retainer, cap, cap-asm, cavity

// Retainer fastening. "vascrew" is the default and is DECIDED, not provisional:
// Fab, 2026-09-05, "VA metric screw M2" and then, choosing off the printed
// fastener coupon, "use that hole / the 3rd one". Station 3 of that coupon is a
// Ø1.60 pilot with a Ø2.10 x 1.00 counterbore, driven directly into the printed
// ASA boss by a plain A2 stainless M2 machine screw. No PT screw -- there are
// none in the building -- and no insert.
//
// Why it works here at all, when driving a 60-degree ISO flank into plastic is
// normally the thing you talk somebody out of: the radial O-ring took the seal
// load off these screws, so the worst case is ~6 N, order 0.1 MPa in the thread.
// This joint is a retainer clamp, not a pressure boundary.
//
// The insert route is KEPT, and it costs 6 mm of head diameter -- RE-MEASURED at
// M2 on 2026-09-05, because the M2 insert is a smaller part and the penalty
// looked like it should have shrunk with it. It did not: head OD 38 on vascrew
// against 44 on insert, bolt circle Ø30.2 against Ø33.93. The bore got 0.76 mm
// smaller and the wall did not, because insert_seal_wall (2.3, set by
// heat-setting next to the O-ring seat) and pt_seal_wall (1.2, the boss rule)
// are what actually separate the two routes -- not the hole.
//
// What DID change on that route is the sourcing objection: the M2.5 part was
// E-Z LOK's, a sole-source US import that every EU specialist made special-order.
// The M2 part is PEM IUTFC-M2, a catalogue item with ordinary distribution. If
// the insert is ever needed -- a boss that strips in service, a joint that starts
// carrying load -- it is no longer blocked on procurement.
fastening = "vascrew";      // "vascrew" or "insert"
assert(fastening != "ptscrew",
       str("fastening=\"ptscrew\" was renamed to \"vascrew\" on 2026-09-05. It is ",
           "not a rename for tidiness: the screw is an A2 machine screw cutting an ",
           "ISO metric thread, not a PT screw forming its own non-ISO one, and the ",
           "pilot is justified differently (see pt_pilot_d)."));
assert(fastening == "vascrew" || fastening == "insert",
       str("unknown fastening '", fastening, "'"));
exploded = false;
// Draw the prototype-1 body below the head as well: the printed ASA tube, its
// bayonet cable cap and the dam. OFF by default, because those parts belong to
// o2_probe_body_tube.scad and this file must not grow a dependency on them --
// they come in as the STLs that model already exports, positioned, never as
// geometry. Nothing here is exported; it is a drawing aid for `make
// prototype-exploded`, which is the only view that shows the whole probe.
show_body = false;

// HOW THIS HEAD MEETS THE BODY.
//   "bonded"      the production joint, and the default: a Ø(tube+0.4) socket
//                 14 mm deep, filled with adhesive. Two parts.
//   "monolithic"  prototype 1: there is no joint, because the printed body tube
//                 is the same piece of plastic. The socket goes away, the bore
//                 runs to z=0, and an outward cone carries Ø32 up to Ø40.
//
// Monolithic exists for a sourcing reason, not an aesthetic one. The bonded
// joint is structural AND sealing, on the wet side, at ~75 C in ammoniacal
// condensate -- and MEMBRANE.md forbids a load-bearing adhesive there until a
// named one has passed hot-condensate ageing. None is sourced. Printing through
// the joint deletes the requirement instead of guessing at it.
joint = "bonded";
assert(joint == "bonded" || joint == "monolithic",
       str("unknown joint '", joint, "'"));
monolithic = (joint == "monolithic");
tube_od_nominal = 32.0;     // what the printed tube is DRAWN at, not measured
body_dir = "exports";       // where those STLs live, relative to the build cwd
// Interfaces to the body model. These are the SAME two numbers that file names
// as tracking this one (head_socket_len, cap_engage); if either moves, the body
// slides in this picture and the picture is the thing that would show it.
// Both of these are DUPLICATED from o2_probe_body_tube.scad, and both had
// already drifted by 2026-09-05: cap_engage moved 12 -> 18 there when the radial
// seal pushed the lock boss past the reamer, and this file kept 12, so the
// prototype drawing placed the cap 6 mm into the tube. Nothing complained.
// tools/interface_check.py now compares them and the Makefile runs it.
//
// body_tube_len depends on the joint, because the monolithic tube stops where
// the head begins: 113 against the bonded 127. The old single value happened to
// place BOTH correctly -- socket_len - 127 = -113 = -113 -- which is exactly the
// kind of coincidence that survives until one of the two numbers moves.
// BACK TO 124.0 / 127.0. These track the head's own cav_board_len, which is now
// SOLVED (see its note) rather than chosen: the board length is fixed, so every
// millimetre of bore the head gains has to come out of the tube or the board tip
// overshoots the well floor. Both numbers moved to 121.3 / 124.3 on 2026-09-05
// while cav_board_len solved to 4.7 under an 8.0 mm screw, and moved back when
// the fastener went to M2 and it returned to its 2.0 floor. Overall probe length
// never changed. tools/interface_check.py compares these against the body model
// and caught the drift both times -- run it after ANY fastener change.
// NO LONGER A LITERAL. It was `monolithic ? 124.0 : 127.0`, and on 2026-09-09
// that pair of numbers was found to be the whole monobody failure under
// radial_ring="ors116787": there the head correctly SOLVES cav_board_len to 2.4
// (the O24 x 1.5 shortens spigot_len 5.3 -> 4.6, so the retainer screws need
// more material behind the end face), which makes the right tube 123.6 -- while
// this line went on saying 124.0 and the union opened a 0.4 mm gap at the joint.
// The Makefile's volume gate caught it as "3 volumes, expected 2".
//
// The board is a FIXED 107 mm and its tail a fixed 22, so every millimetre the
// head's cavity gains has to come out of the tube. That is one identity, written
// in the body model as tube_len, and both files now compute it instead of one
// deriving it and the other remembering the answer:
//
//     tube_len = board_len - cav_board_len + tail_len - (monolithic ? socket_len : 0)
//
// Only the two fixed lengths are duplicated here; cav_board_len and socket_len
// are this file's own. THE ASSIGNMENT ITSELF IS FURTHER DOWN, immediately after
// cav_board_len, and that placement is load-bearing rather than tidy: OpenSCAD
// does NOT resolve a forward reference at top level -- `a = b + 1; b = 41;`
// echoes `a=undef`, measured 2026-09-09, with no warning. Defined up here it
// would silently place the tube at undef.
body_board_len = 107.0;     // o2_probe_body_tube.scad, board_len
body_tail_len  = 22.0;      // o2_probe_body_tube.scad, tail_len
// The tube's BORE, and it is load-bearing here rather than decorative: with the
// cell standing on the board, this is the hole the can has to go down, and the
// assert that says so lives in this file because cell_seated_h does. Ø27.2 =
// tube_od 32 - 2*wall 2.4. Duplicated, so interface_check.py compares it.
body_tube_id = 27.2;        // o2_probe_body_tube.scad, tube_id
body_cap_engage = 18.0;     // o2_probe_body_tube.scad, cap_engage
// THE CABLE SEAL, mirrored here for drawing. It is NO LONGER the carrier's ring:
// the cable end went from a Ø27.3 counterbore to a Ø25.7 COLLAR, and a bore that
// size takes a 22 x 2 instead of the carrier's 24 x 1.5. Two ring sizes now.
// These three drifted silently when the body changed and interface_check.py is
// what caught it -- do not hand-edit one without running `make monobody`.
body_seal_id   = 22.0;      // o2_probe_body_tube.scad, seal_id
body_seal_cord = 2.0;       // o2_probe_body_tube.scad, seal_cord
body_groove_root = 22.6732; // o2_probe_body_tube.scad, groove_root

// ------------------------------------------------- MEASURE THESE

tube_od_meas = undef;      // MEASURE: actual OD of the tube stock, incl. ovality
board_env_front = undef;   // MEASURE: populated swept envelope above the board
board_env_back = undef;    // MEASURE: populated swept envelope below the board
cell_seated_h = undef;     // MEASURE: can top above the board plane, real cell in
                           //          a real socket. PLAN.md option A computes
                           //          8.3 (can) + 0.51 (Cambion flange) = 8.8, and
                           //          that is arithmetic on a datasheet, not a
                           //          seated part. It is also board_env_front in
                           //          the tip region, so a wrong value moves the
                           //          bore and the head OD, not just a drawing.
// cell_axial_len IS GONE, and it is not a rename. It measured "how far the cell
// and its socket project past the board END", which is a dimension that only
// exists in cell-orientation option C -- the cell lying on the probe axis beyond
// the board tip. Fab, 2026-09-05: the design is back to option A, the cell
// STANDING on the board like any other THT part, axis normal to the copper, gas
// face radial. Nothing projects past the board end any more, so the quantity is
// not zero-because-unmeasured, it is zero because the feature does not exist,
// and the 13 mm of necked bore it bought is dead volume with nothing in it.
// See cell_mount below. HANDOFF-2026-09-05.md and RING-PCB.md are the two
// documents written against option C.
// M2, not M2.5. Fab, 2026-09-05: "for the o2-probe head i want the screw holes to
// receive M2 metric screws." Only the insert route actually receives a metric
// screw -- a thread-forming screw cuts its own non-ISO thread -- so both routes
// were resized to nominal 2.0 and the sourcing redone at that size.
//
// SOURCED 2026-09-05, ../reviews/M2-FASTENING-2026-09-05.md: PennEngineering SI
// IUTFC-M2, 300-series stainless, flanged straight-wall thru-threaded. Stainless
// because brass suffers ammonia stress-corrosion cracking and these sit outside
// the seal in NH3 condensate. Replaces E-Z LOK FL-M25-HI-CR, which was the M2.5
// part and is a sole-source US import.
// All four numbers below are from one table, PEM SI-7 (sidata.pdf, 06/2022),
// metric block, read off the RENDERED page -- the PDF's text layer scrambles
// these columns and must not be trusted for them.
insert_bore_d = 3.23;      // "Hole Dia." +0.08/-0.00. Was 3.99 for the M2.5 part.
insert_bore_h = 4.76;      // PUBLISHED "Min. Hole Depth", no longer inferred: PEM
                           // states it, and it agrees with SPIROL's length + 2
                           // pitches rule (3.99 + 0.8 = 4.79) to 0.03 mm.
insert_head_d = 4.75;      // flange dia E; flanged only -- needs a counterbore or
insert_head_t = 0.46;      // it holds the retainer off the face. T, same table.
// Filler correction, SPIROL design guide p.5: open the hole +0.08 at >=15% filler
// and +0.15 at >=35%, interpolating between. Unfilled ASA needs neither, so this
// is 0 -- set it if the print material changes to a filled grade.
insert_filler_add = 0.0;

// A2 stainless MACHINE screw, M2 x 0.4, driven straight into the printed boss.
// The `pt_` prefix is kept because the geometry is unchanged and it is threaded
// through a dozen expressions below; read it as "plastic thread", not "PT screw".
//
// THE PILOT HAS TWO INDEPENDENT DERIVATIONS AND THEY LAND ON THE SAME NUMBER,
// which is the only reason it is trusted at this size:
//   1.60 = d - P = 2.0 - 0.4, the ISO metric tap-drill for M2 x 0.4 (~75%
//          thread engagement) -- the right number for a CUT ISO thread.
//   1.60 = 0.8 x d1, EJOT/ATF's core-hole rule for direct fastening into
//          thermoplastic (DELTA PT design recommendations, 2017) -- the right
//          number for a FORMED thread at nominal 2.
// A machine screw in printed ASA does some of each, so a pilot that both rules
// agree on is the defensible one. Do NOT "split the difference" upward if this
// ever moves: 75% engagement is already aggressive for a 60-degree flank in
// plastic, and the far more likely correction is a LARGER pilot (~1.70-1.75) if
// bosses split in service.
//
// CHOSEN ON A PRINTED COUPON, not on the arithmetic: part="fastener-coupon"
// carries this hole with and without the counterbore, in real ASA at the real
// depth and the real print orientation, and Fab picked the counterbored one.
pt_nominal = 2.0;
pt_pilot_d = 1.60;
// Boss OD >= 2 x screw nominal, EJOT/ATF, same page. It is hoop stress that sets
// this, not heat -- which is why this wall is smaller than the insert's.
pt_seal_wall = (2*pt_nominal - pt_pilot_d)/2;
// STRUCTURAL, not a chamfer, and the reason station 3 beat station 4: EJOT gives
// the counterbore as edge-stress relief that prevents the boss cracking as the
// thread forms, plus lead-in for the first turn. dC = 1.05 x d1, depth 0.5 x d1.
// It is also the WIDEST cut at the bolt circle (2.10 against a 1.60 pilot), so
// bolt_r is derived from it -- see bolt_cut_max. Cut in head().
pt_cbore_d = 1.05 * pt_nominal;   // 2.10
pt_cbore_h = 0.5 * pt_nominal;    // 1.00

assert(!is_undef(tube_od_meas),
       "UNMEASURED: tube_od_meas -- measure the tube OD and its ovality");
assert(!is_undef(board_env_front),
       "UNMEASURED: board_env_front -- tallest component above the board plane");
assert(!is_undef(board_env_back),
       "UNMEASURED: board_env_back -- tallest component below the board plane");
assert(!is_undef(cell_seated_h),
       "UNMEASURED: cell_seated_h -- seat a real cell in a real socket and measure how far the can top stands off the board");
echo(str("FASTENING: ", fastening, use_insert
         ? str(" -- PEM IUTFC-M2, 300-series stainless; hole ", insert_bore_d,
               " +0.08 x ", insert_bore_h, " deep (PEM-published minimum)")
         : str(" -- A2 stainless M2 machine screw direct into the printed boss;",
               " pilot ", pt_pilot_d, " (= M2 tap drill d-P, = 0.8 x d1),",
               " counterbore ", pt_cbore_d, " x ", pt_cbore_h,
               " deep, engagement ", 2*pt_nominal)));

// ------------------------------------------------- design parameters

board_w = 20.0;             // KiCad Edge.Cuts, controlled
// CONFIRMED 2026-09-05 (Fab): "board_t = 1.6 is correct for Rev A". This is no
// longer an assumption to be reconciled -- it is the built thickness, and the
// fab data is what disagrees with it: o2-probe.kicad_pcb's stackup is a 0.910 mm
// dielectric and PLACEMENT.md still specifies "1.0 mm, 4 layers". Those are the
// files that need correcting, not this one.
// It is NOT cosmetic here: board_t feeds board_swept -> board_diag -> bore_d, so
// it moves the cavity the 5.0 cm3 budget is measured on. See the volume gate.
board_t = 1.6;              // Rev A, confirmed
// MEASURED 2026-09-04 (Fab): 14.62 mm on a real can, against DS-0637 Iss. 2's
// 14.4 nominal -- +0.22 on diameter. A measured interface dimension supersedes a
// datasheet nominal, so this is the number the geometry is cut to. CAUTION: it is
// ONE sample, so it is a value, not a tolerance band; the clearances below have
// no statistical margin behind them yet.
// neck_d is DERIVED from this (neck_d = cell_d + 2*neck_margin), so the finger
// annulus of RING-PCB.md holds at 1.0 mm automatically instead of being eaten.
cell_d = 14.62;             // MEASURED; DS-0637 Iss. 2 says 14.4 nominal
cell_h = 8.3;               // DS-0637 Iss. 2 -- NOT re-measured
bore_margin = 1.5;

// Window sized to match the radial variant's TWO 10x10 coupons, so the
// comparison isolates architecture rather than area.
//
// REDUCED 16.0 -> 15.2 on 2026-09-05, and the 0.8 is not arbitrary: it is the
// growth of face_wall_min from one-and-a-third beads to two, taken out of the
// WINDOW rather than added to the groove. face_groove_id = window_d +
// 2*face_wall_min, so the two moves cancel exactly and the groove ID stays at
// 17.6 -- install stretch on the 17.0 ring is unchanged at 3.53%. Growing the
// groove instead would have put it at 18.4 and stretch at 8.24%, past the 5%
// install limit, on a ring that was ALREADY climbing out of its groove. Area is
// the thing being spent here: 181 mm2, under the 200 mm2 two-coupon benchmark
// this number was originally chosen to beat. Fab took that trade knowingly.
window_d = 15.2;            // -> 181 mm2 (was 16.0 -> 201 mm2)

bond_gap = 0.20;
// TWO DIFFERENT JOBS UNDER ONE NAME, and they parted company when the joint did.
//
// BONDED: this is the real socket depth over the tube end -- the bonded area, so
// 14 mm is a design figure and must not be cut.
//
// MONOLITHIC: there is no socket (head() does not cut it, see below), so this is
// only the z at which the cavity stack starts. It was still 14, which left the
// head's first 14 mm as a plain Ø25.18 bore inside a Ø40 body -- a 7.4 mm wall
// doing a job the tube does at 2.4, for a stretch that holds nothing but board.
// The board is Ø22.18 swept and the tube's own ID is 27.2, so that length has no
// reason to be in the head at all. 3.0 on Fab's instruction 2026-09-05: not 0,
// so the join cone still lands on parallel bore rather than on the cavity mouth.
//
// IT DOES NOT SHORTEN THE PROBE, which was my first claim and it was wrong. The
// board still needs the same length of bore, so the joint simply moves: 11 mm of
// Ø40 head becomes 11 mm of Ø32 tube and the assembly is still 146.6 mm. What it
// buys is ~5.9 cm3 of ASA (a Ø40/Ø25.18 annulus replaced by a Ø32/Ø27.2 one) and
// ~0.9 cm3 more connected gas, which is nothing against the 75 cm3 the unpotted
// tube already contributes.
//
// It also takes 5.6 cm3 off the monolithic cavity that cavity_raw() below now
// measures honestly: 11.9 -> 6.3 cm3. Still over the 5.0 budget, because that
// budget describes the POTTED production build; the Makefile gates the bonded
// variant, which measures 4.917.
//
// TWO OTHER FILES CARRY THIS NUMBER and both had to move with it:
// o2_probe_body_tube.scad's head_socket_len (subtracted from tube_len, so
// leaving it at 14 ends the tube 11 mm short) and body_tube_len above.
socket_len = monolithic ? 3.0 : 14.0;
wall_min = 2.4;

// Carrier: a PP top-hat. The spigot enters the well and squeezes the gasket
// against the well floor; the flange sits on the head's end face and is what
// the retainer presses on. The seal therefore lives INSIDE the bolt circle and
// no fastener ever penetrates it.
// The seal is a RADIAL O-ring on the spigot, not a face gasket. Two reasons,
// and the second is the important one:
//   - a face groove needs a land either side, which pushes this head to 48 mm,
//     worse than the radial variant it is competing with;
//   - a radial squeeze comes from the interference fit, NOT from the screws, so
//     the screws stop being part of the seal load path. Polypropylene creep at
//     75 C then bleeds off retention instead of bleeding off the seal.
// Spigot length is DERIVED from what the groove needs, not chosen: every extra
// millimetre of it is Ø17.5 of connected gas, and the 5 cm3 budget is now the
// binding constraint on this variant.
spigot_bore = 18.0;         // gas path through the spigot; >= window + margin

// Spigot wall, formerly `land` -- and that sharing was a conflation, not a
// saving. `land` sizes the MEMBRANE disc and the ledge its rim is clamped on
// (see membrane_cartridge_common.scad); this sizes the wall that carries the
// RADIAL O-ring groove, three parts away. Nothing ties them together, and while
// they were one number the membrane disc could not be widened without growing
// the head, nor the head shrunk without narrowing the membrane disc.
//
// It is also measured off the wrong feature. The groove root sits over the
// spigot BORE (Ø18), not over the flare mouth (Ø22) that `mouth_d + 2*land`
// referenced -- the mouth is a counterbore in the flange, above the spigot
// entirely. The assert beside the other seal checks now measures the real wall.
//
// Why 2.4 exactly: head_od takes ceil() of the bolt circle, so the diameter
// moves in 2 mm steps and 2.4 is the LOOSEST value that still lands on 40 mm
// (42 before). Anything from 2.125 to 2.4 gives the same head, so this keeps the
// most wall the size allows. Below 2.125 the sourced Ø24.0 ring stops gripping
// its groove -- see the echo for what a smaller head would cost.
spigot_land = 2.4;
flange_margin = 4.0;
carrier_fit = 0.3;
// flange_t is DEFINED BELOW, after mem_seal: which bed is fitted decides whether
// it is free at all. A forward reference to mem_clamped here would read undef
// with a warning, which is the trap join_cone already documents.

// WHICH MEMBRANE BED. Two are kept, and they are not variants of a preference:
//   "cone"     the legacy bed -- O-ring 17.0 x 1.0 (ORS116731) in a groove cut
//              into the CARRIER's wet face, bounded inward by the flare cone.
//              Correct on paper and SOURCED, but it does not print: see the
//              long note at the head of the CLAMPED FACE SEAL section in
//              membrane_cartridge_common.scad, and the photograph of a real
//              carrier with filament strung across the aperture.
//   "clamped"  the printable bed -- O-ring 17.0 x 2.5 in a groove cut into the
//              RETAINER's underside, over a flat carrier land. Same seal,
//              mirrored, so that every surface that sets squeeze is printed
//              onto solid material instead of over air.
// The default is "clamped" because the carriers being printed now are ASA and
// the legacy bed is the one that failed on the bench, not in the model.
mem_seal = "clamped";
assert(mem_seal == "cone" || mem_seal == "clamped",
       str("unknown mem_seal '", mem_seal, "'"));
mem_clamped = (mem_seal == "clamped");

// ---- carrier flange thickness = HALF THE CELL-TO-MEMBRANE PATH --------------
//
// It was `flange_t = cart_t`, and on the CONE bed it has to be: that bed's
// sealing core is cut by the shared cartridge geometry in
// membrane_cartridge_common.scad, which measures everything down from cart_t, so
// a flange thicker or thinner than cart_t either seals the membrane off or leaves
// the core hanging in air. The assert further down still says exactly that.
//
// The CLAMPED bed does not inherit that. Its core is ONE frustum cut by
// clamped_core_cuts(window_d, spigot_bore, flange_t, ...) -- parametric on
// flange_t, referred to nothing in the common file -- so on this bed the two
// numbers were only ever equal by history.
//
// Why it is worth separating. PROTOTYPE-RESPONSE.md's build candidate calls for
// a CELL-TO-MEMBRANE PATH of 5-10 mm, and that path is exactly
// spigot_len + flange_t: the cell's sensing face sits at the well floor
// -- PAST-END, where cell_z + cell_h == well_z by construction. STANDING it is
// not: the can lies on the board cell_setback back from the tip, its top face at
// cell_z + cell_h nowhere near well_z, and the gas turns a corner to reach it. The
// GAS PATH echo says which case it is reporting.
// At cart_t = 5.0 the path is 9.6 mm, at the top of the band, and it goes OVER
// 10 mm with any ring that widens the spigot groove. The flange is also the
// widest gas column in the head: the frustum is 217 mm3/mm, so 2 mm off it is
// 0.45 cm3 measured on the mesh -- ~10% of the 5.0 cm3 budget, for nothing but
// a thinner disc.
//
// 3.0 and not 2.0: the >= 2.0 anti-dishing floor below is the hard limit, and
// this keeps a millimetre over it because the flange is also what the retainer
// clamps the membrane against. The aperture opens downward as a
// atan(1.4/flange_t) = 25 degree cone at 3.0 (15.6 at 5.0), which the carrier
// still prints wet-face-down -- the printability echo reports the real angle.
flange_t = mem_clamped ? 3.0 : cart_t;

// SOURCED 2026-09-02, ../../tech/PROBE-CARRIER-SOURCING.md: o-ring-stocks.eu
// ORS116787, EPDM 70 Shore A peroxide-cured, 24.0 x 1.5 DIN 3771. NOT a derived
// size -- 24.5 x 1.5 does not exist in EPDM at all; it is FKM/FFKM only, and FKM
// is excluded because ammonia attacks fluoroelastomers.
// WHICH RADIAL RING. The sourced one, or a size that is physically in the
// drawer -- because a bench test that waits on a delivery is a bench test that
// does not happen.
//
//   "ors116787"    24.0 x 1.5, o-ring-stocks.eu, EPDM 70 peroxide, WITH the
//                  compound test report the ammonia argument rests on. The
//                  design of record.
//   "onhand-22x2"  22 x 2, on hand, UNCATALOGUED -- material, cure system and
//                  cord tolerance all assumed. TEMPORARY, for a squeeze and
//                  leak test on a part that can be printed today. This is the
//                  substitution to use: it is the only on-hand size that keeps
//                  a full-thickness wall under the groove.
//   "onhand-20x2"  20 x 2, likewise on hand, and it costs the wall: 0.99 mm
//                  under the groove root against 2.39 for the 22. Kept because
//                  it is what shrinks the spigot furthest, if that is ever the
//                  question being asked.
//
// The ring SIZES THE SPIGOT, which is why this is not a one-line substitution.
// Install stretch has to stay inside 1-5%, so the groove root is pinned near
// 1.035 x the ring ID, and the spigot diameter follows from the root plus two
// compressed cords. Ø24 -> Ø26.8 spigot, Ø22 -> Ø25.8, Ø20 -> Ø23.0. Since the
// clamped bed deleted the Ø22 heater counterbore, nothing else in the part needs
// that diameter any more, so this is now a free parameter of the ring.
//
// 14 x 2.5 and 17 x 2.5 are NOT offered and cannot be: their roots (14.5 / 17.6)
// are at or under the Ø18 spigot bore the cell has to pass through, so there is
// no wall at all. Only the 20 and the 22 are geometrically possible.
//
// A NOTE ON THE Ø22 AND THE 2.4 mm WALL, because it is 14 microns from being a
// lie. Both constraints move together and stay exactly well_bias (0.0105) apart:
//     wall >= 2.4   needs  spigot_d >= 26.8 - 4*squeeze
//     stretch <= 5% needs  spigot_d <= 26.7895 - 4*squeeze
// so no squeeze value satisfies both, for any Ø22 ring, ever. At the Ø25.8
// spigot the stretch is 4.93% and the wall is 2.387. Rather than pretend, the
// wall minimum for this variant is stated as 2.38 -- and that is the whole
// concession, not a rounded-down 2.4.
// ---- the ring is TWO NUMBERS, not a name --------------------------------
//
// Fab, 2026-09-05: "make this a parameter, so its easy to adjust, depending on
// which o-ring is available". The three-way enum this replaces could only offer
// the three sizes someone had written a branch for; the fourth ring out of the
// drawer needed a code change. Now the ring is its DIMENSIONS, the presets are
// DATA, and the spigot is SOLVED from whatever ring is named.
//
// To use a ring that is not in the table, set two numbers and nothing else:
//
//     openscad -D ring_id=19 -D ring_cord=2.5 ...
//
// The presets stay because PROVENANCE IS NOT A DIMENSION: which ring has a
// compound test report behind it is a fact about a part number, not about
// "24 x 1.5", and that report is what the whole ammonia argument rests on.
//
//   name            id    cord  d1tol  spigot_d  wall_min  provenance
//   "ors116787"     24.0  1.5   0.25   undef     undef     SOURCED: EPDM 70
//                                                          peroxide, material
//                                                          127019011, WITH the
//                                                          compound test report
//   "onhand-22x2"   22.0  2.0   0.22   25.8      2.38      on hand, UNCATALOGUED
//   "onhand-20x2"   20.0  2.0   0.22   23.0      0.95      on hand, UNCATALOGUED
//
// undef in a preset means "derive it", which is what a custom ring always does.
// The two spigot literals are NOT undef on purpose: they are already-verified
// solved values, kept verbatim so this refactor cannot move a checked part by a
// rounding step. The assert below proves the derivation reproduces them, which
// is what stops the tabulated and solved forms drifting apart in silence.
// The stretch column is the correction that made this table honest. My first
// version pinned a spigot DIAMETER per preset and cross-checked it against one
// shared 3.5% target -- and the check fired on the Ø20, which pins 23.0 where a
// 3.5% solve gives 23.4163. The preset was not wrong; MY ASSUMPTION WAS. Each of
// these rings was solved at its own stretch, deliberately, trading stretch
// against the wall left under the groove: 3.50% on the Ø24, 4.93% on the Ø22,
// 1.42% on the Ø20. One shared target cannot express that and should not try.
//
// So the table carries STRETCH, not diameter, and the spigot is always solved.
// There is now exactly one source of truth for the geometry, which is why the
// literal-vs-derivation assert that caught this could be deleted rather than
// tuned: it existed only to police a second one.
radial_ring_presets = [
//   name             id    cord  d1tol  stretch     wall_min
    ["ors116787",     24.0, 1.5,  0.25,  0.0350167,  undef],
    ["onhand-22x2",   22.0, 2.0,  0.22,  0.0492595,  2.38 ],
//  BROKEN AND KEPT AS A RECORD, not as an option: at 20.2837 the groove root
//  leaves 1.1419 mm over the Ø18 spigot bore, under the hard 1.2 floor, so
//  selecting it FAILS TO RENDER. Verified to fail identically on HEAD before
//  this refactor, so it is inherited, not introduced. It cannot be fixed by
//  moving the stretch either: more stretch lifts the root but breaks the 5%
//  rule before it clears 1.2. The Ø20 needs a narrower spigot bore, i.e. a cell
//  that no longer has to pass through it -- a different decision entirely.
    ["onhand-20x2",   20.0, 2.0,  0.22,  0.0141850,  0.95 ],
];
// DEFAULT = the ring Fab actually has. ors116787 (24 x 1.5) is sourced but not
// on the bench, so defaulting to it made every hand render and the viewer show
// a ring nobody can fit, while only the Makefile's override kept the printed
// plates honest. The default is what an unqualified render gets, so it has to
// be the buildable one.
radial_ring = "onhand-22x2";
// Direct overrides. ring_id + ring_cord are all a new ring needs; the rest fall
// back to the DIN band and to the derivation.
ring_id       = undef;
ring_cord     = undef;
ring_id_tol   = undef;
ring_spigot_d = undef;
ring_wall_min = undef;
// Override the preset's own solved stretch, or set one for a custom ring that
// needs to trade stretch against wall the way the presets do.
ring_stretch_override = undef;
// The install stretch the spigot is solved TO when it is not given. 3.5% is
// where the sourced ring already sits and is near the middle of the 1-5% window,
// so a custom ring lands with margin at both ends instead of on a limit.
ring_stretch_target = 0.035;

function ring_row(n) = let (m = [for (r = radial_ring_presets) if (r[0] == n) r])
                       len(m) > 0 ? m[0] : undef;
_ring = ring_row(radial_ring);
// A named ring must exist; a nameless one must be fully dimensioned. Either is
// fine; half of each is the state where a typo silently selects a preset.
custom_ring = !is_undef(ring_id) || !is_undef(ring_cord);
assert(custom_ring || !is_undef(_ring),
       str("unknown radial_ring '", radial_ring, "', and no ring_id/ring_cord ",
           "given. Name one of ", [for (r = radial_ring_presets) r[0]],
           ", or set ring_id and ring_cord to the ring you actually have"));
assert(!custom_ring || (!is_undef(ring_id) && !is_undef(ring_cord)),
       "a custom ring needs BOTH ring_id and ring_cord; one alone is half a ring");

oring_id_ordered = is_undef(ring_id)   ? _ring[1] : ring_id;
oring_cord       = is_undef(ring_cord) ? _ring[2] : ring_cord;
// DIN ISO 3601 d1 rows: +/-0.25 at 24, +/-0.22 at 20 and 22. Only moves stretch.
// A custom ring gets the WIDER band: guessing the narrower one is the direction
// that flatters the tolerance chain.
oring_id_tol = !is_undef(ring_id_tol) ? ring_id_tol
             : (custom_ring || is_undef(_ring[3])) ? 0.25 : _ring[3];
// Wall left under the groove root, over the spigot bore. wall_min (2.4) is what
// the sourced ring affords and what the head is designed to; see the note above
// for why the Ø22 lands at 2.38 and cannot be made to land at 2.4.
//
// A CUSTOM RING DOES NOT GET TO LOWER THIS BAR. The preset concessions are
// declared, argued, and attached to one specific ring. An automatic concession
// would let any ring redefine the minimum to whatever it happened to afford, and
// the assert reading it would then be measuring itself rather than the part. So
// a custom ring is held to wall_min and fails loudly with the shortfall named --
// set ring_wall_min explicitly to accept a thinner wall, and own the decision.
spigot_groove_wall_min = !is_undef(ring_wall_min) ? ring_wall_min
                       : (custom_ring || is_undef(_ring[5])) ? wall_min : _ring[5];
onhand_ring = (radial_ring != "ors116787") || custom_ring;
// Static radial squeeze, fraction of cord. 0.24 is not a handbook preference --
// it is the value that CENTRES the printed well's tolerance band. At the obvious
// 0.20 the band is -0.34/+0.10, and a printed bore errs oversize, which is the
// direction that loses the seal. See the well_tol asserts below.
// Re-centred against the FULL band (bore + groove + cord), which moved when the
// ring's own +/-0.08 entered the chain: 0.24 left 0.80 points of margin at the
// 15% end and 1.76 at the 30%, and the low end is the one that leaks. 0.2433
// puts the worst case at 16.14-28.54% and lands the groove root on a round
// 25.03. Not a handbook preference -- it is where the band sits squarest.
oring_squeeze = 0.2433;
// The radial seal is made between TWO surfaces, and both have tolerance: the
// head's well bore and the carrier's groove root. Counting only the well -- as
// this model did until now -- assumes the carrier is perfect and understates the
// band by whatever the carrier contributes.
//
//   carrier_material  "pp"  machined PP-H, weldable, the production route
//                     "asa" printed like the rest of the head; no weld possible,
//                           compression only, and a much looser groove
//   well_finish       "reamed"  the printed bore is finish-cut to size
//                     "printed" as it comes off the printer
//   carrier_fab       "machined" turned to size, EITHER material
//                     "printed"  as it comes off the printer
//
// Material and PROCESS are separate, and conflating them was a real error: the
// tolerance comes from machining, not from PP. ASA can be turned; PP can be
// printed. carrier_material still decides the weld and the chemistry.
carrier_material = "pp";
carrier_fab = "machined";
well_finish = "reamed";
// The ring is bought, not made, so its cord is a MEASURABLE outside dimension.
//   "catalogue" take the vendor's published tolerance for any ring in the bag
//   "sorted"    micrometer every ring on receipt and use the ones that fit
oring_sorting = "catalogue";
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
