fl4p/o2-probe/cad/o2_probe_response_candidate.scad

/*
 * O2 probe response candidate — communication model, NOT fabrication release.
 * Units: millimetres. Z runs from cable end toward sensing tip.
 *
 * Response-study constraints represented here:
 *   - measured effective local gas volume target <=5.0 cm3;
 *   - supported free PMV15T area target 180..190 mm2;
 *   - membrane dry-face-to-cavity access path <=0.25 mm;
 *   - two keyed, drainable lower-side membrane facets, one per PCB side;
 *   - both SGX gas faces and the provisional 3 mm rear PCB aperture open;
 *   - dry-side carrier heaters shown separately from the cell island.
 */

$fn = 96;
part = "assembly"; // assembly, enclosure, probe, shroud, seals, cartridges
exploded = false;

tube_od = 32;
tube_id = 28;
tube_length = 135;
pcb_width = 20;
pcb_length = 119;
pcb_thickness = 1;
pcb_z = 5;

cell_board_y = 107.5;
cell_z = pcb_z + cell_board_y;
cell_diameter = 14.4;
cell_height = 8.3;
rear_port_diameter = 3.0;

plenum_z0 = 101;
plenum_z1 = 124;
end_land = 3.55; // leaves 15.9 mm clear gas length around the 14.4 mm cell
shroud_od = 27.6;
shroud_id = 23.0; // compact spatial candidate; connected volume gate <=5.0 cm3

window_width = 10;
window_height = 10;
membrane_thickness = 0.18;
carrier_width = 15;
carrier_height = 15;
carrier_thickness = 2.0;
membrane_dry_gap = 0.25; // maximum gas path from membrane dry face to local cavity
carrier_inner_radius = shroud_id/2;
carrier_depth = tube_od/2 + carrier_thickness - carrier_inner_radius;
membrane_radius = shroud_id/2 + membrane_dry_gap;
window_angles = [45, 315]; // global atan2(Y,X): one PCB side each, both lower quadrants
facet_angles = [for (angle=window_angles) angle-90]; // cartridge local radial axis is +Y

eps = 0.03;

module rounded_board_2d(w, l, r) {
    hull()
        for (x=[-w/2+r, w/2-r], z=[r, l-r])
            translate([x,z]) circle(r=r, $fn=28);
}

module radial_cut(angle, width, height, zc) {
    rotate([0,0,angle])
        translate([-width/2, 0, zc-height/2])
            cube([width, tube_od, height]);
}
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
