fl4p/o2-probe/hw/literature/ce-protection/TI 2022 ESD Protection Layout Guide SLVA680A.md

# TI 2022 ESD Protection Layout Guide SLVA680A

Source: https://www.ti.com/lit/pdf/SLVA680

Accessed 2026-09-09. Evidence: inspected sections below. First curl fetch
returned the actual PDF; direct text extraction, with rendered-page validation
for the numerical and pinout evidence. No OCR or intermediary model.

p7 §2.4: route through clamp, short ground connection.

Original PDF SHA-256: `414236c18903e2489c6564c36718ed3743be9c595f4543098f167259b5ba8635`.

The public vendor PDF is retained locally beside this pointer and excluded
from version control. The committed record contains our locator and provenance.
