fl4p/o2-probe/model/examples/dry_step.csv

time_s | o2_reference_pct_wet | pressure_reference_kpa | temp_ambient_c | temp_inlet_c | rh_ambient_pct | heater_power_w
0 | 0 | 101.325 | 50 | 50 | 100 | 0
10 | 0 | 101.325 | 50 | 50 | 100 | 0
20 | 0 | 101.325 | 50 | 50 | 100 | 0
29.75 | 0 | 101.325 | 50 | 50 | 100 | 0
30 | 20.95 | 101.325 | 50 | 50 | 100 | 0
35 | 20.95 | 101.325 | 50 | 50 | 100 | 0
40 | 20.95 | 101.325 | 50 | 50 | 100 | 0
50 | 20.95 | 101.325 | 50 | 50 | 100 | 0
60 | 20.95 | 101.325 | 50 | 50 | 100 | 0
75 | 20.95 | 101.325 | 50 | 50 | 100 | 0
90 | 20.95 | 101.325 | 50 | 50 | 100 | 0
120 | 20.95 | 101.325 | 50 | 50 | 100 | 0
150 | 20.95 | 101.325 | 50 | 50 | 100 | 0
180 | 20.95 | 101.325 | 50 | 50 | 100 | 0
