fl4p/o2-probe/cad/exports/gas-shell-assembly.png

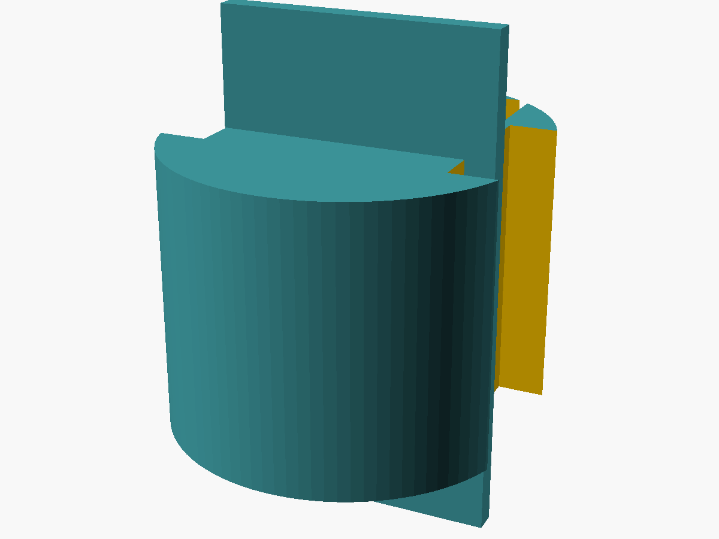
cad/exports/gas-shell-assembly.png
