fl4p/o2-probe/hw/bench-logs/heater-step.webp

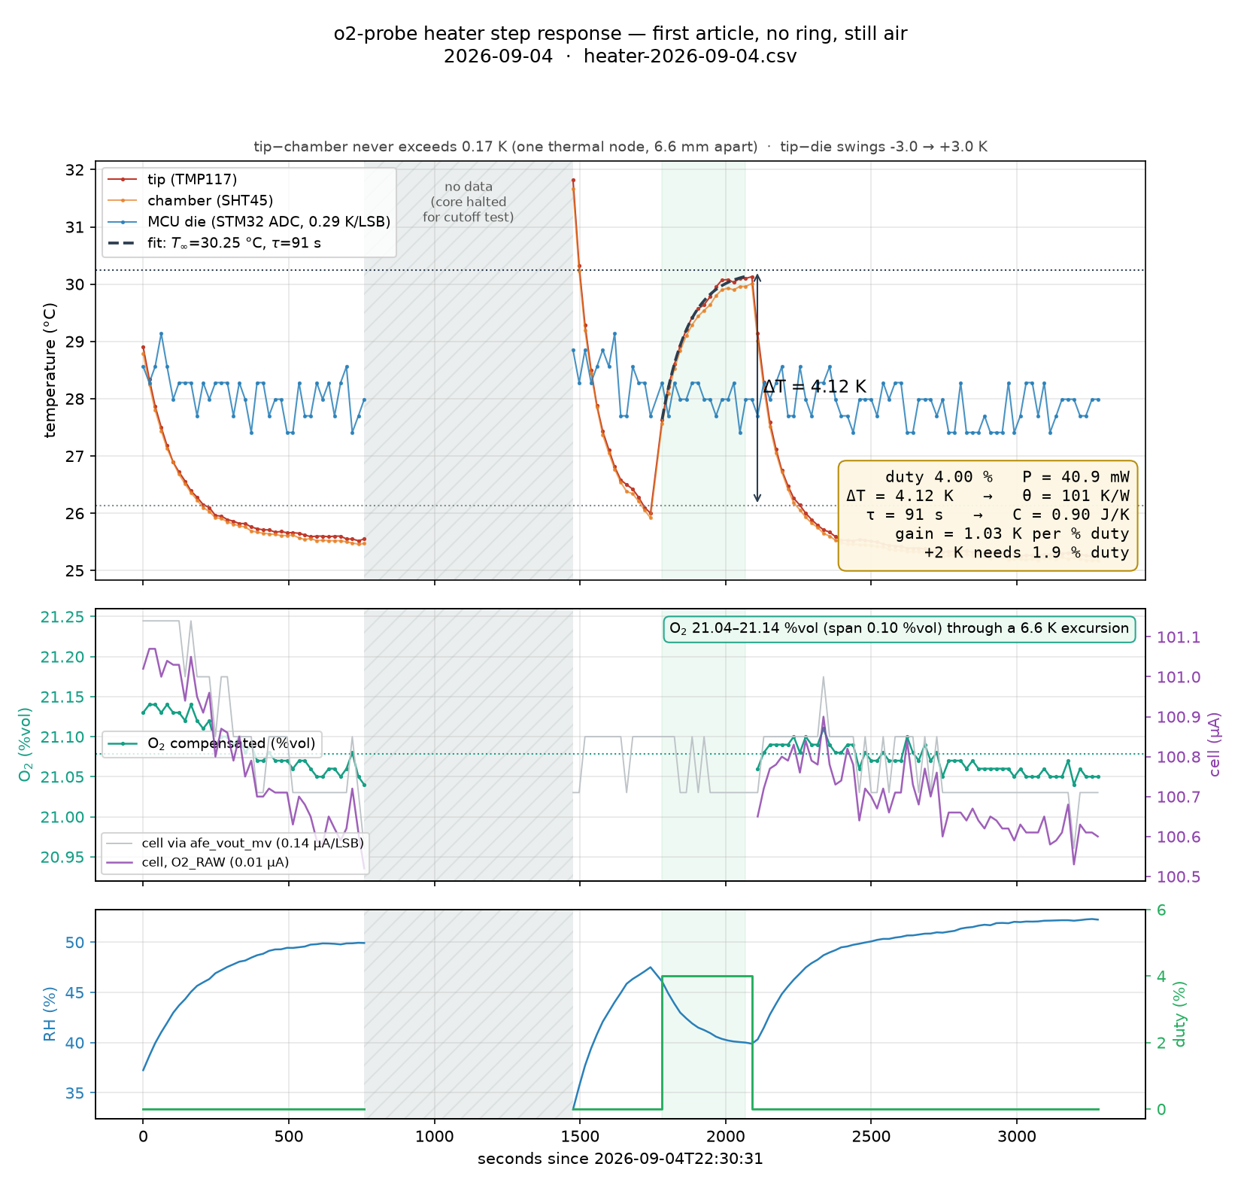
hw/bench-logs/heater-step.webp
