fl4p/o2-probe/hw/doc/img/o2-heater-step-recovery-2026-09-06.webp

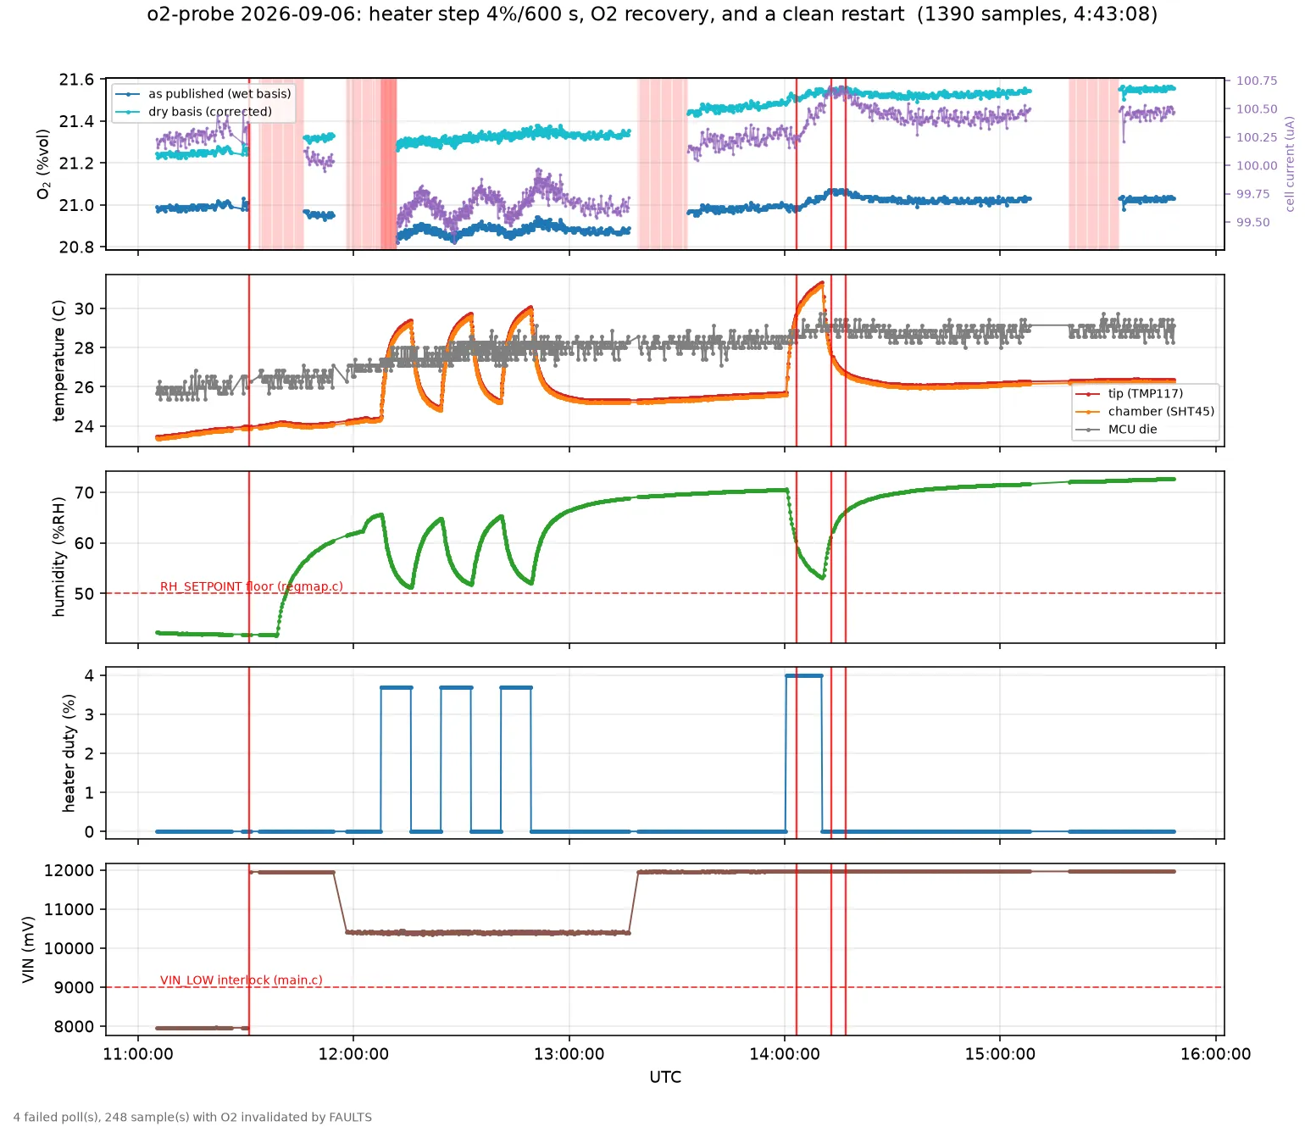
hw/doc/img/o2-heater-step-recovery-2026-09-06.webp
