fl4p/o2-probe/hw/routing/revb-86/evidence/pdf/assembly-back.png

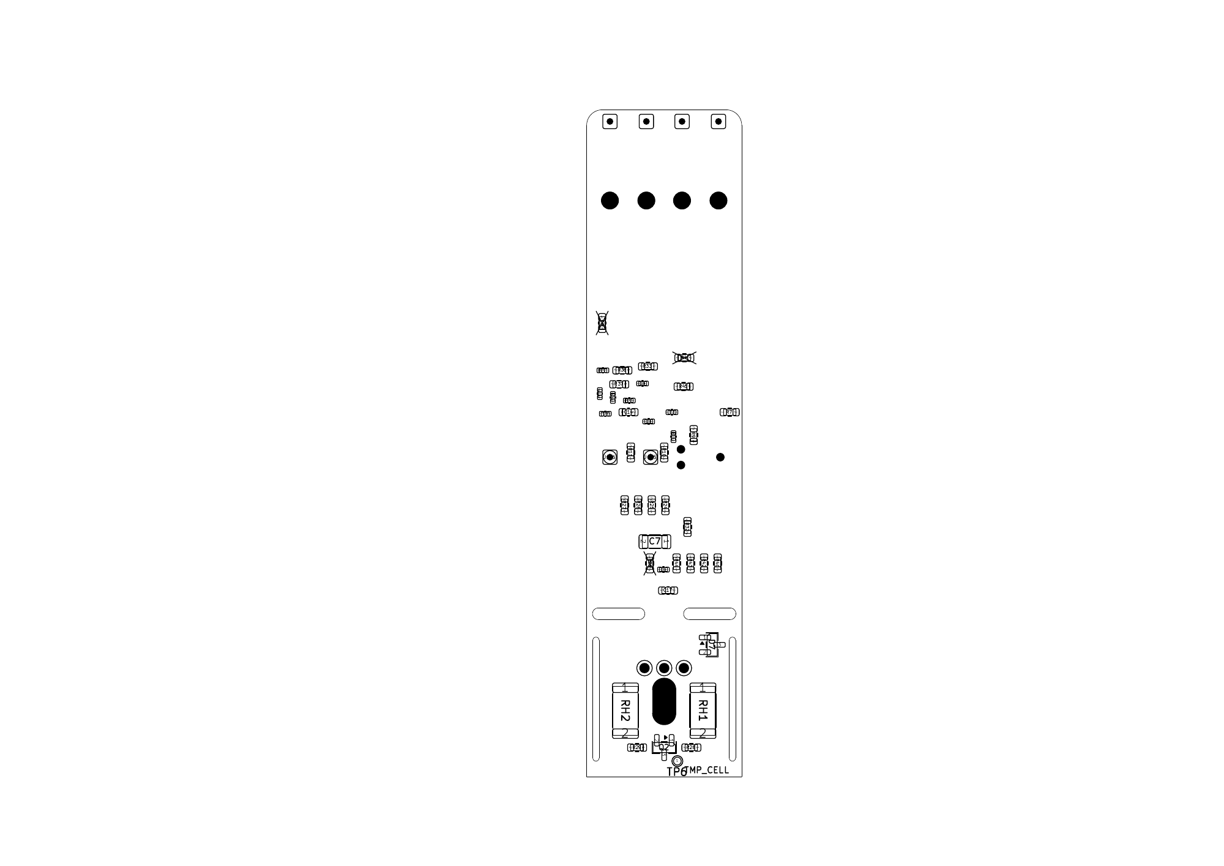
hw/routing/revb-86/evidence/pdf/assembly-back.png
