fl4p/o2-probe/hw/routing/revb-86/evidence/pdf/assembly-front.png

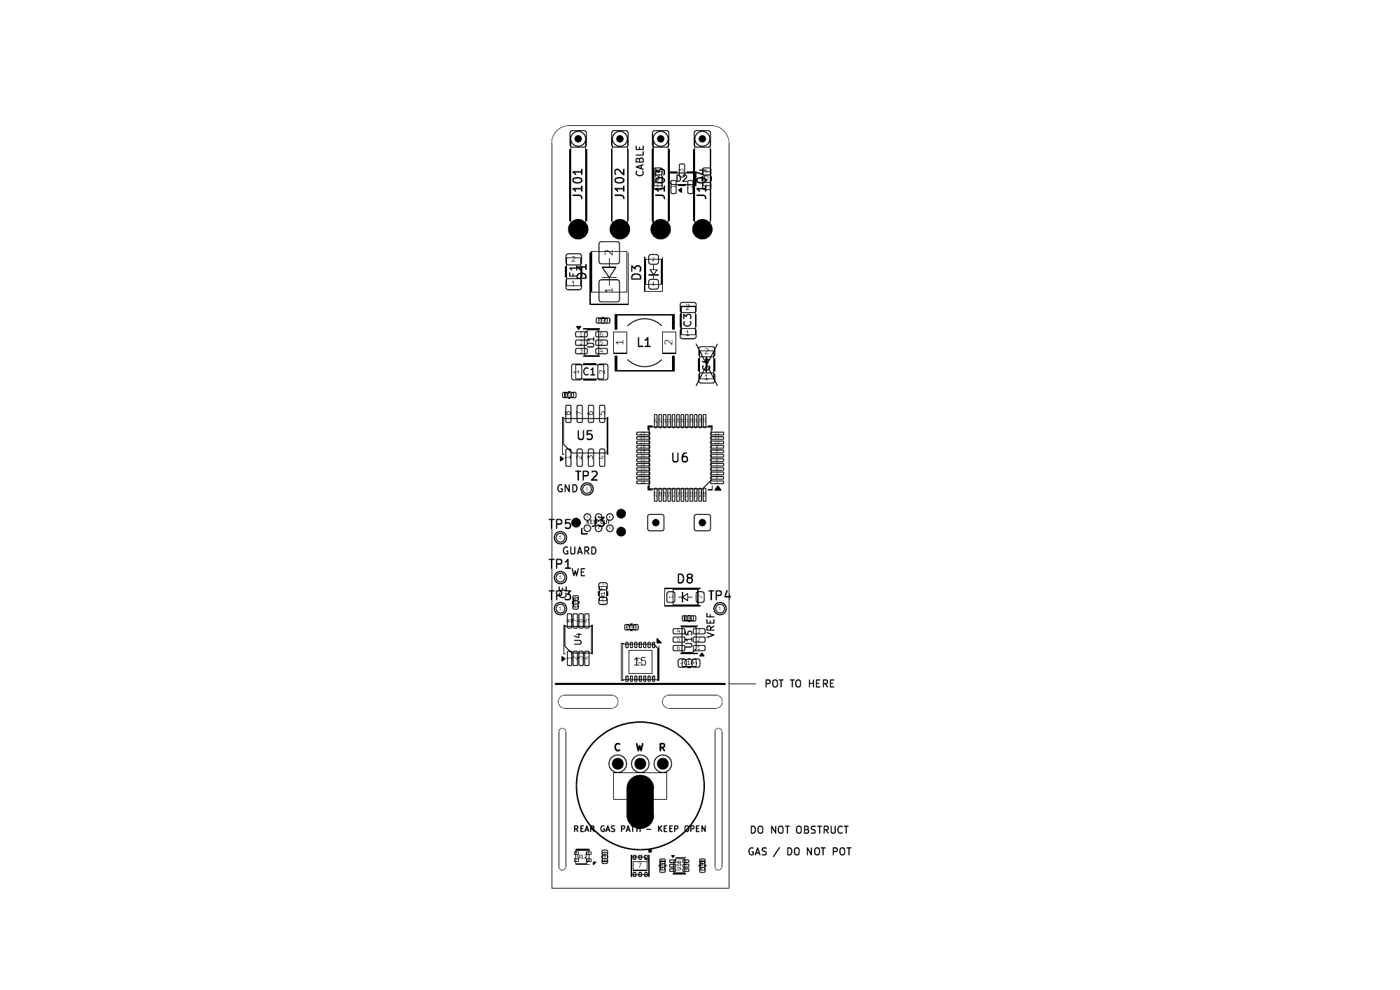
hw/routing/revb-86/evidence/pdf/assembly-front.png
