fl4p/o2-probe/hw/bench-logs/dew-test-2026-09-06.csv

utc | status | detail | sample_seq | settle_s | o2_comp_pct | o2_raw_ua | t_tip_c | t_chamber_c | rh_pct | heater_duty_pct | faults | faults_named | o2_trusted | vref_mv | va_mv | vin_mv | afe_mv | dew_margin_k | t_die_c | uptime_s | fw | hw | reset_cause | lmp_readback | mb_crc_errs | mb_frame_errs | i2c_errs | settle_restarts | faults_ever | faults_ever_named | ads_fail_count | exp_data
2026-09-06T15:59:44Z | ok |  | 2495 | 0 | 21.05 | 100.57 | 26.3 | 26.19 | 73.03 | 0.0 | 32768 | HEATER_DISABLED | True | 2494 | 3290 | 11960 | 966 | 5.36 | 29.14 | 2495 | 0x0001 | 0x000A | 0x0000 | 0x0CCD | 0 | 159 | 0 | 1 | 32769 | SETTLING|HEATER_DISABLED | 0
2026-09-06T15:59:49Z | ok |  | 2500 | 0 | 21.02 | 100.43 | 26.3 | 26.15 | 73.03 | 0.0 | 32768 | HEATER_DISABLED | True | 2494 | 3288 | 11960 | 967 | 5.36 | 28.85 | 2500 | 0x0001 | 0x000A | 0x0000 | 0x0CCD | 0 | 160 | 0 | 1 | 32769 | SETTLING|HEATER_DISABLED | 0
2026-09-06T15:59:54Z | ok |  | 2505 | 0 | 21.03 | 100.46 | 26.3 | 26.17 | 73.03 | 0.0 | 32768 | HEATER_DISABLED | True | 2494 | 3288 | 11960 | 967 | 5.34 | 29.43 | 2505 | 0x0001 | 0x000A | 0x0000 | 0x0CCD | 0 | 161 | 0 | 1 | 32769 | SETTLING|HEATER_DISABLED | 0
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
