fl4p/o2-probe/model/results/prototype-study/feasible_frontier.csv

free_area_mm2 | maximum_volume_cm3_at_limit | settling_time_at_frontier_s | installed_conductance_scale | cell_tau_s | empirical_access_tau_s
80.0 | 5.0 | 118.76419549329123 | 0.05 | 10.0 | 15.0
100.0 | 6.0 | 116.14158698872552 | 0.05 | 10.0 | 15.0
120.0 | 7.5 | 118.76419549329097 | 0.05 | 10.0 | 15.0
140.0 | 8.5 | 116.88657201375469 | 0.05 | 10.0 | 15.0
160.0 | 10.0 | 118.76419549329123 | 0.05 | 10.0 | 15.0
170.0 | 10.5 | 117.98830292766705 | 0.05 | 10.0 | 15.0
180.0 | 11.0 | 117.30187694062597 | 0.05 | 10.0 | 15.0
193.0 | 12.0 | 118.42226331180662 | 0.05 | 10.0 | 15.0
200.0 | 12.5 | 118.76419549329098 | 0.05 | 10.0 | 15.0
