fl4p/o2-probe/model/results/prototype-study/nonlinear_verification.csv

design | case | volume_cm3 | free_area_mm2 | installed_conductance_scale | cell_tau_s | empirical_access_tau_s | t90_s | settling_time_2pct_s | steady_bias_o2_pct_wet | passes_settling_limit | transport_regime_equations | rh_input_pct | humidity_effect_modeled | transport_model
existing_rev_a_axial | central | 23.3 | 193.05 | 1.0 | 4.343 | 0.0 | 12.181444316550767 | 19.25 | -5.910099701367244e-05 | True | dry | 100.0 | False | well_mixed_screening
existing_rev_a_axial | hard | 26.3 | 183.0 | 0.05 | 10.0 | 15.0 | 139.00856310514516 | 216.25 | -0.002859879101148266 | False | dry | 100.0 | False | well_mixed_screening
short_axial_microplenum | central | 12.0 | 175.0 | 1.0 | 4.343 | 0.0 | 10.813894127547442 | 18.0 | -6.519673496541145e-05 | True | dry | 100.0 | False | well_mixed_screening
short_axial_microplenum | hard | 14.0 | 160.0 | 0.05 | 10.0 | 15.0 | 98.89393828396706 | 147.0 | -0.0014310442295695225 | False | dry | 100.0 | False | well_mixed_screening
dual_side_microplenum_candidate | central | 4.9 | 184.0 | 1.0 | 4.343 | 0.0 | 9.909471797642652 | 17.0 | -6.200752955010103e-05 | True | dry | 100.0 | False | well_mixed_screening
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
