fl4p/o2-probe/model/results/prototype-study/prototype_cases.csv

design | volume_case | volume_cm3 | area_case | free_area_mm2 | installed_conductance_scale | gas_tau_s | cell_tau_s | empirical_access_tau_s | t90_s | settling_time_2pct_s | passes_settling_limit | transport_model | spatial_geometry_modeled
existing_rev_a_axial | min | 20.3 | min | 183.0 | 0.05 | 36.873869560935475 | 4.343 | 0.0 | 89.52610197123072 | 148.8724383433838 | False | well_mixed_screening | False
existing_rev_a_axial | min | 20.3 | min | 183.0 | 0.05 | 36.873869560935475 | 4.343 | 15.0 | 108.52635081830893 | 168.1041924346583 | False | well_mixed_screening | False
existing_rev_a_axial | min | 20.3 | min | 183.0 | 0.05 | 36.873869560935475 | 10.0 | 0.0 | 96.56159649516148 | 155.9165005380909 | False | well_mixed_screening | False
existing_rev_a_axial | min | 20.3 | min | 183.0 | 0.05 | 36.873869560935475 | 10.0 | 15.0 | 115.48658362950474 | 175.14038076706692 | False | well_mixed_screening | False
existing_rev_a_axial | min | 20.3 | min | 183.0 | 0.1 | 18.436934780467737 | 4.343 | 0.0 | 47.404350100471895 | 77.07844320496575 | True | well_mixed_screening | False
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
