fl4p/o2-probe/model/results/prototype-study/thermal_sensitivity.csv

membrane_coupling_eta | required_block_rise_k | required_power_at_low_rth_w | required_power_at_high_rth_w | passes_block_rise_limit | passes_power_ceiling
0.2 | 10.0 | 1.0 | 0.25 | False | True
0.3 | 6.666666666666667 | 0.6666666666666667 | 0.16666666666666669 | False | True
0.4 | 5.0 | 0.5 | 0.125 | False | True
0.5 | 4.0 | 0.4 | 0.1 | True | True
0.6 | 3.3333333333333335 | 0.33333333333333337 | 0.08333333333333334 | True | True
0.7 | 2.857142857142857 | 0.2857142857142857 | 0.07142857142857142 | True | True
0.8 | 2.5 | 0.25 | 0.0625 | True | True
0.9 | 2.2222222222222223 | 0.22222222222222224 | 0.05555555555555556 | True | True
