fl4p/o2-probe/hw/doc/img/dew-test-2026-09-06.webp

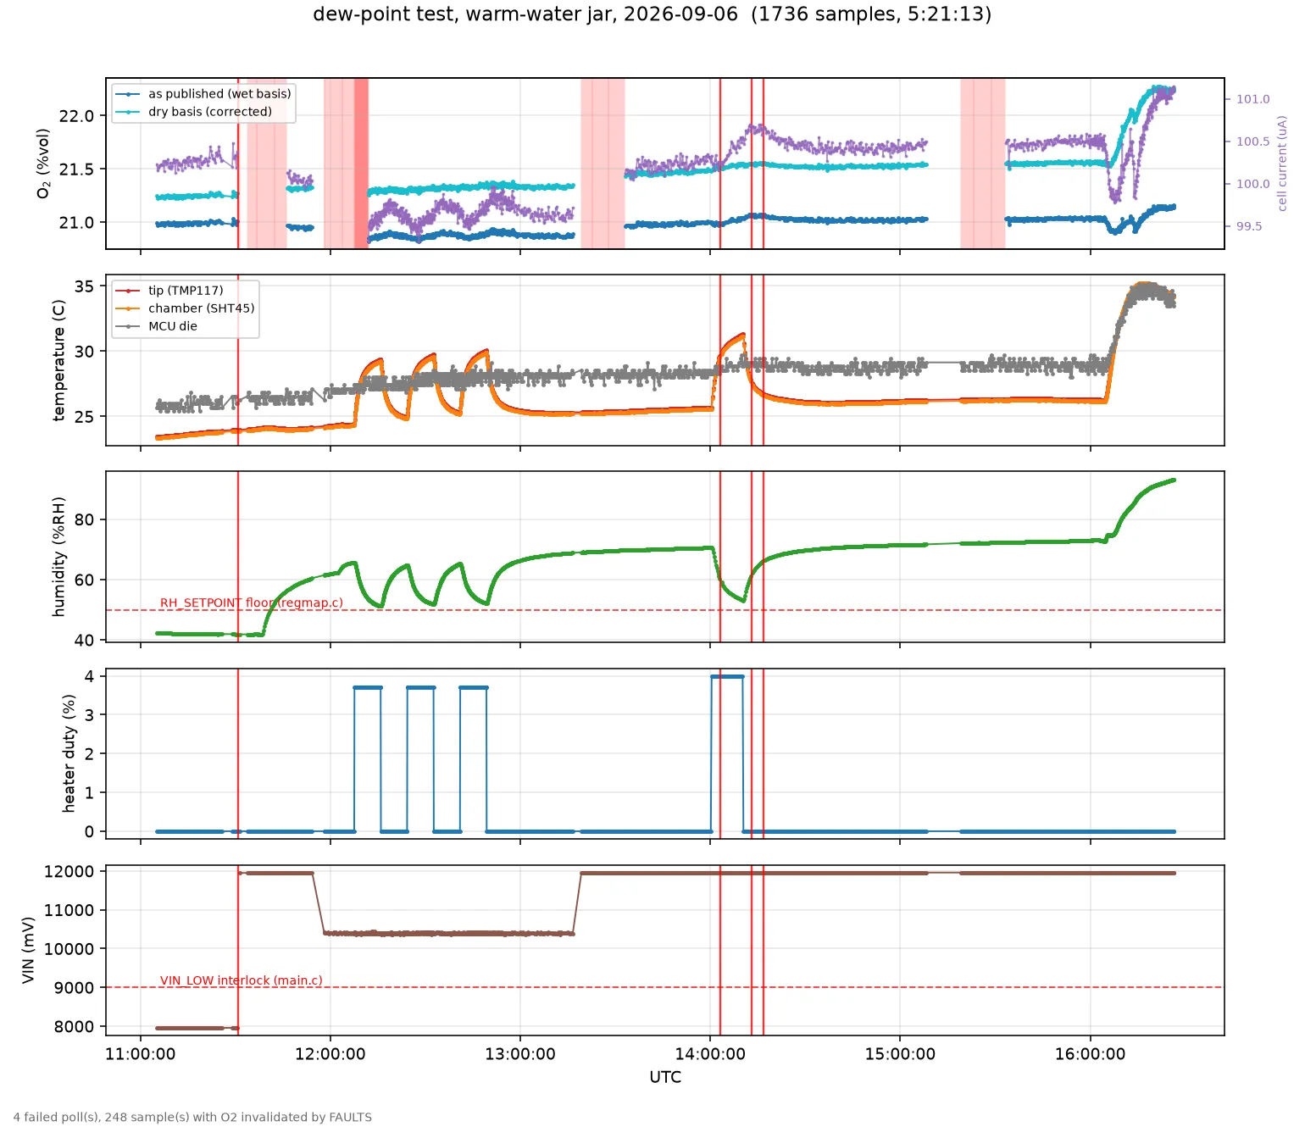
hw/doc/img/dew-test-2026-09-06.webp
