fl4p/o2-probe/model/results/prototype-study/geometry_frontier.png

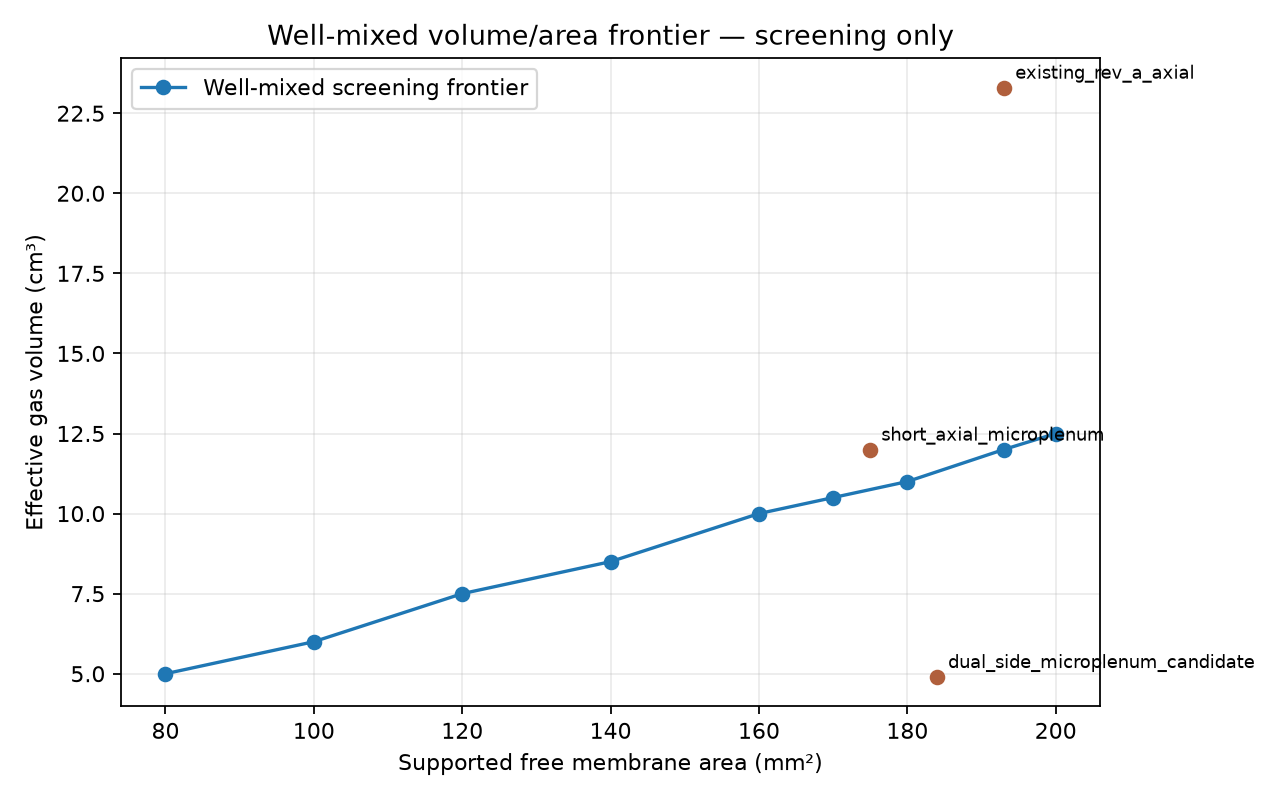
model/results/prototype-study/geometry_frontier.png
