fl4p/o2-probe/model/results/prototype-study/response_envelope.png

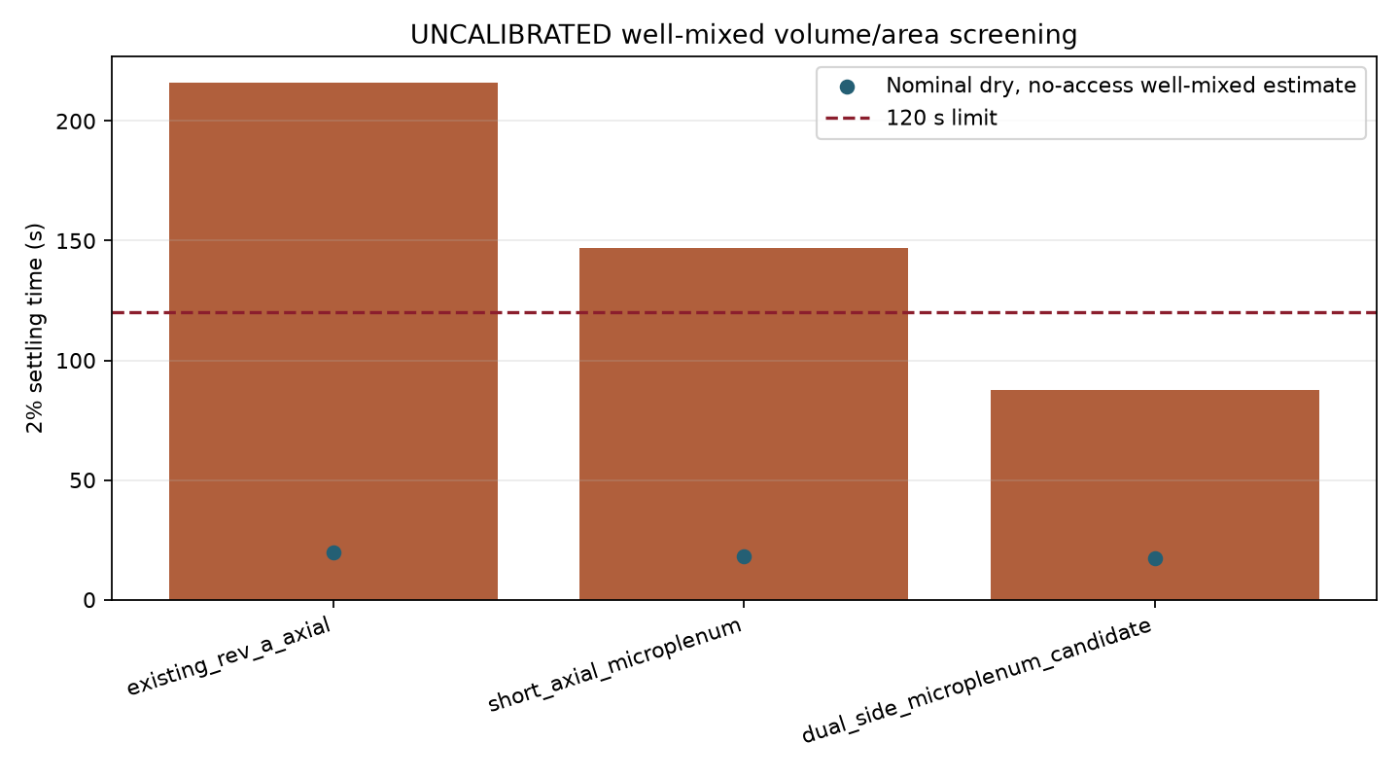
model/results/prototype-study/response_envelope.png
