fl4p/o2-probe/model/results/voxel-study/voxel_sensitivity.png

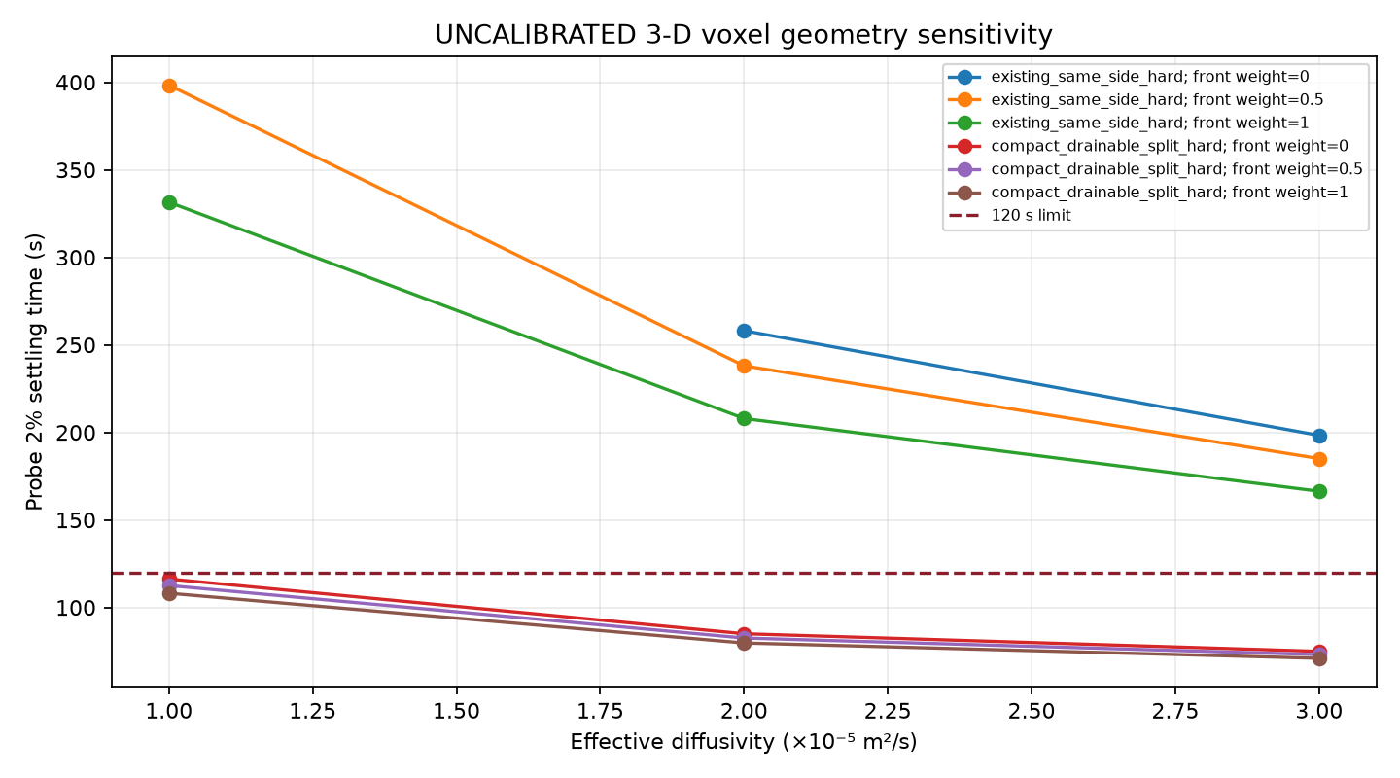
model/results/voxel-study/voxel_sensitivity.png
