fl4p/o2-probe/hw/bench-logs/2026-09-13-outdoor-fit/ds0637/issue2/DS-0637-SGX-OX-ROHS-Mini-Issue2-p2-output-vs-temperature.points.csv

series | column_px | row_px | temperature_c | output_pct | source
mean | 56 | 300.5 | -40.0527 | 82.3493 | measured
mean | 57 | 300.5 | -39.9692 | 82.3493 | measured
mean | 58 | 300.0 | -39.8856 | 82.4535 | measured
mean | 59 | 300.0 | -39.8021 | 82.4535 | measured
mean | 60 | 300.0 | -39.7186 | 82.4535 | measured
mean | 61 | 300.0 | -39.635 | 82.4535 | measured
mean | 62 | 300.0 | -39.5515 | 82.4535 | measured
mean | 63 | 300.0 | -39.468 | 82.4535 | measured
mean | 64 | 299.0 | -39.3845 | 82.6619 | measured
mean | 65 | 299.0 | -39.3009 | 82.6619 | measured
mean | 66 | 299.0 | -39.2174 | 82.6619 | measured
mean | 67 | 299.0 | -39.1339 | 82.6619 | measured
mean | 68 | 299.0 | -39.0503 | 82.6619 | measured
mean | 69 | 299.0 | -38.9668 | 82.6619 | measured
mean | 70 | 298.0 | -38.8833 | 82.8704 | measured
mean | 71 | 298.0 | -38.7998 | 82.8704 | measured
mean | 72 | 298.0 | -38.7162 | 82.8704 | measured
mean | 73 | 298.0 | -38.6327 | 82.8704 | measured
mean | 74 | 298.0 | -38.5492 | 82.8704 | measured
mean | 75 | 298.0 | -38.4656 | 82.8704 | measured
mean | 76 | 298.0 | -38.3821 | 82.8704 | measured
mean | 77 | 297.0 | -38.2986 | 83.0788 | measured
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
