fl4p/o2-probe/hw/bench-logs/2026-09-13-outdoor-fit/ds0637/issue2/DS-0637-SGX-OX-ROHS-Mini-Issue2-p2-output-vs-temperature.samples.csv

temperature_c | mean | mean_source | upper | upper_source | lower | lower_source
-40.0 | 82.349 | measured | 84.121 | measured | 80.578 | measured
-35.0 | 84.329 | measured | 86.434 | interpolated | 82.037 | measured
-30.0 | 86.205 | measured | 88.759 | interpolated | 83.44 | interpolated
-25.0 | 87.664 | measured | 90.374 | measured | 84.955 | measured
-20.0 | 89.123 | measured | 91.949 | interpolated | 86.519 | interpolated
-15.0 | 90.582 | measured | 93.292 | measured | 87.977 | measured
-10.0 | 92.041 | measured | 94.642 | interpolated | 89.515 | interpolated
-5.0 | 93.5 | measured | 95.897 | measured | 90.962 | measured
0.0 | 94.908 | measured | 97.304 | interpolated | 92.489 | interpolated
5.0 | 96.21 | measured | 97.975 | interpolated | 94.314 | interpolated
10.0 | 97.46 | measured | 98.713 | interpolated | 96.219 | interpolated
15.0 | 98.719 | measured | 99.41 | interpolated | 98.214 | interpolated
20.0 | 100.065 | merged | 100.065 | merged | 100.065 | merged
25.0 | 101.212 | measured | 101.142 | interpolated | 101.142 | interpolated
30.0 | 102.358 | measured | 102.983 | measured | 101.698 | measured
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
