fl4p/o2-probe/hw/bench-logs/2026-09-13-outdoor-fit/ds0637/chart600-issue1-2.png

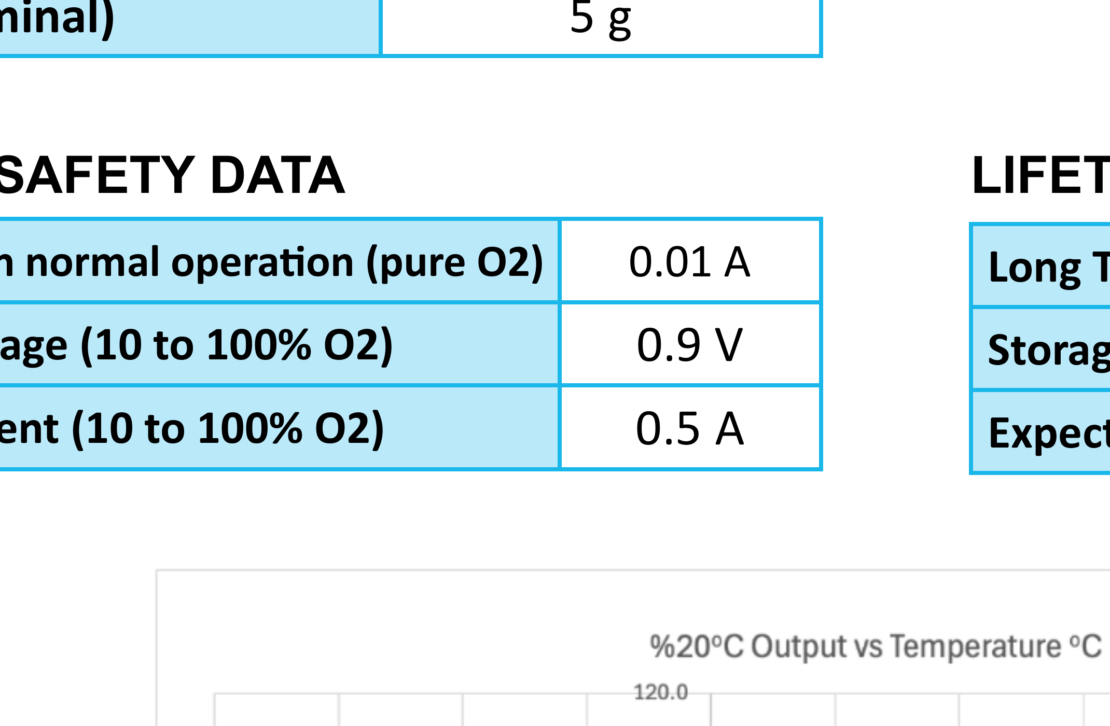
hw/bench-logs/2026-09-13-outdoor-fit/ds0637/chart600-issue1-2.png
