fl4p/o2-probe/hw/bench-logs/2026-09-13-outdoor-fit/ds0637/issue2/DS-0637-SGX-OX-ROHS-Mini-Issue2-p2-output-vs-temperature-overlay.png

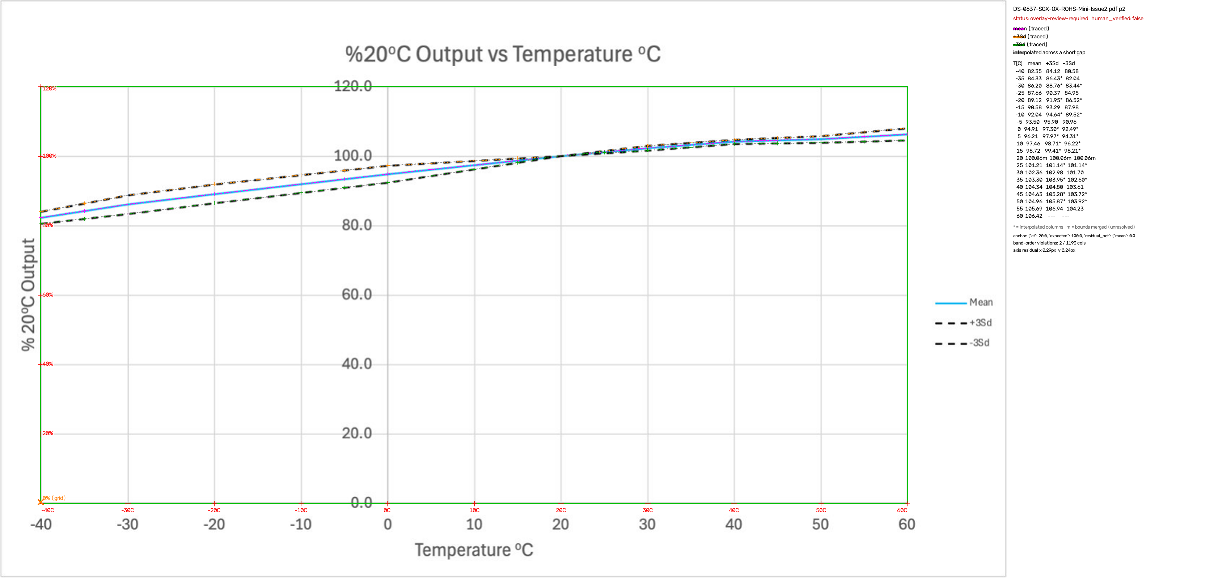
hw/bench-logs/2026-09-13-outdoor-fit/ds0637/issue2/DS-0637-SGX-OX-ROHS-Mini-Issue2-p2-output-vs-temperature-overlay.png
