fl4p/o2-probe/hw/datasheets/DS-0637-Issue2-page1-render.png

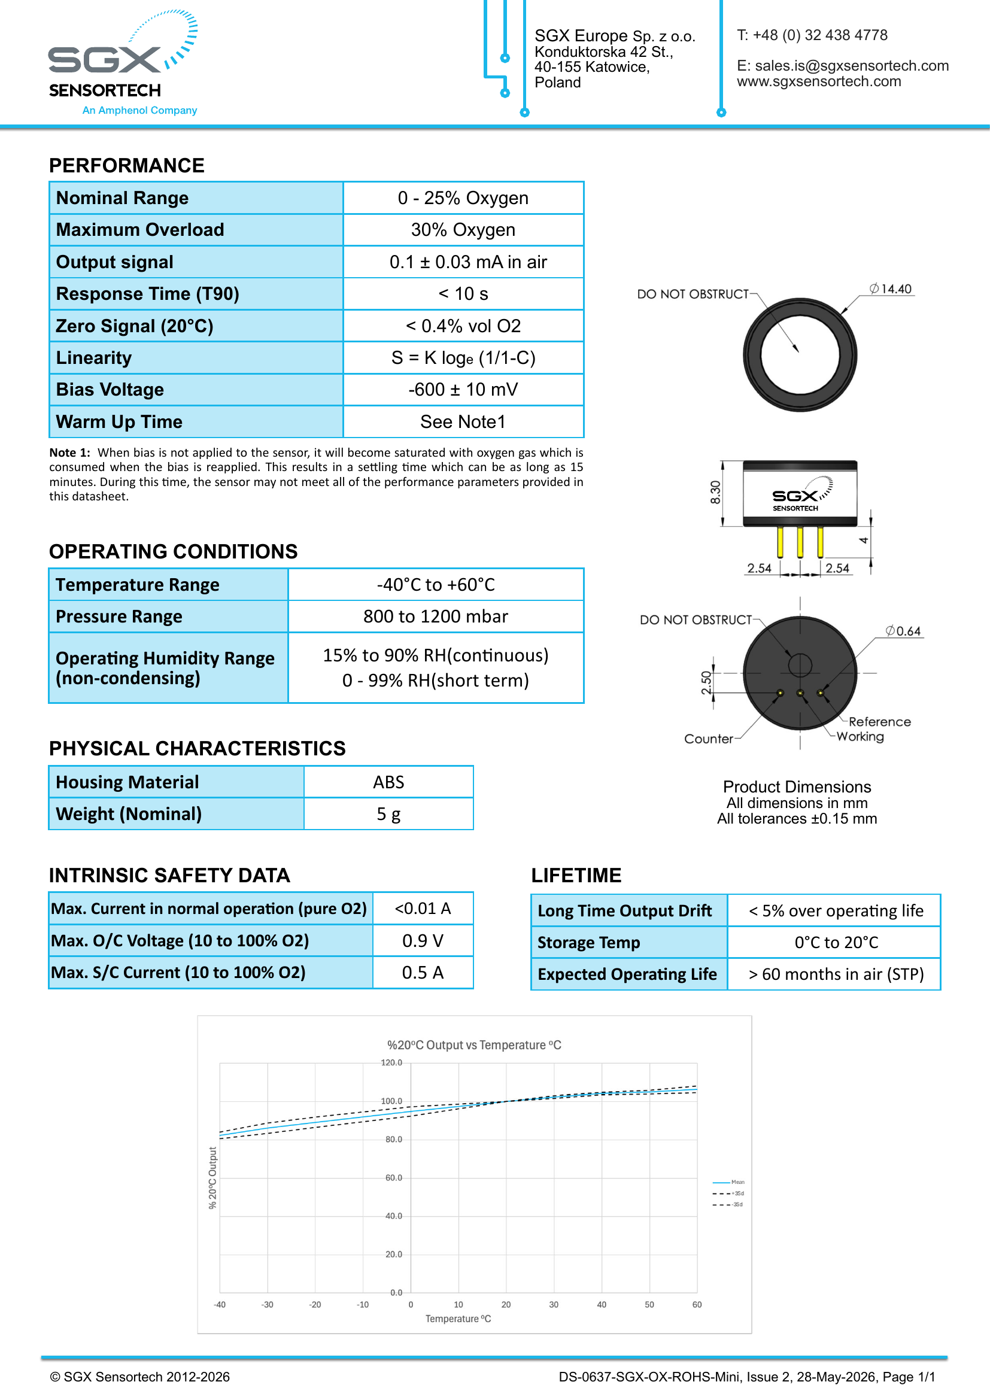
hw/datasheets/DS-0637-Issue2-page1-render.png
