fl4p/o2-probe/hw/o2-probe-schematic.pdf

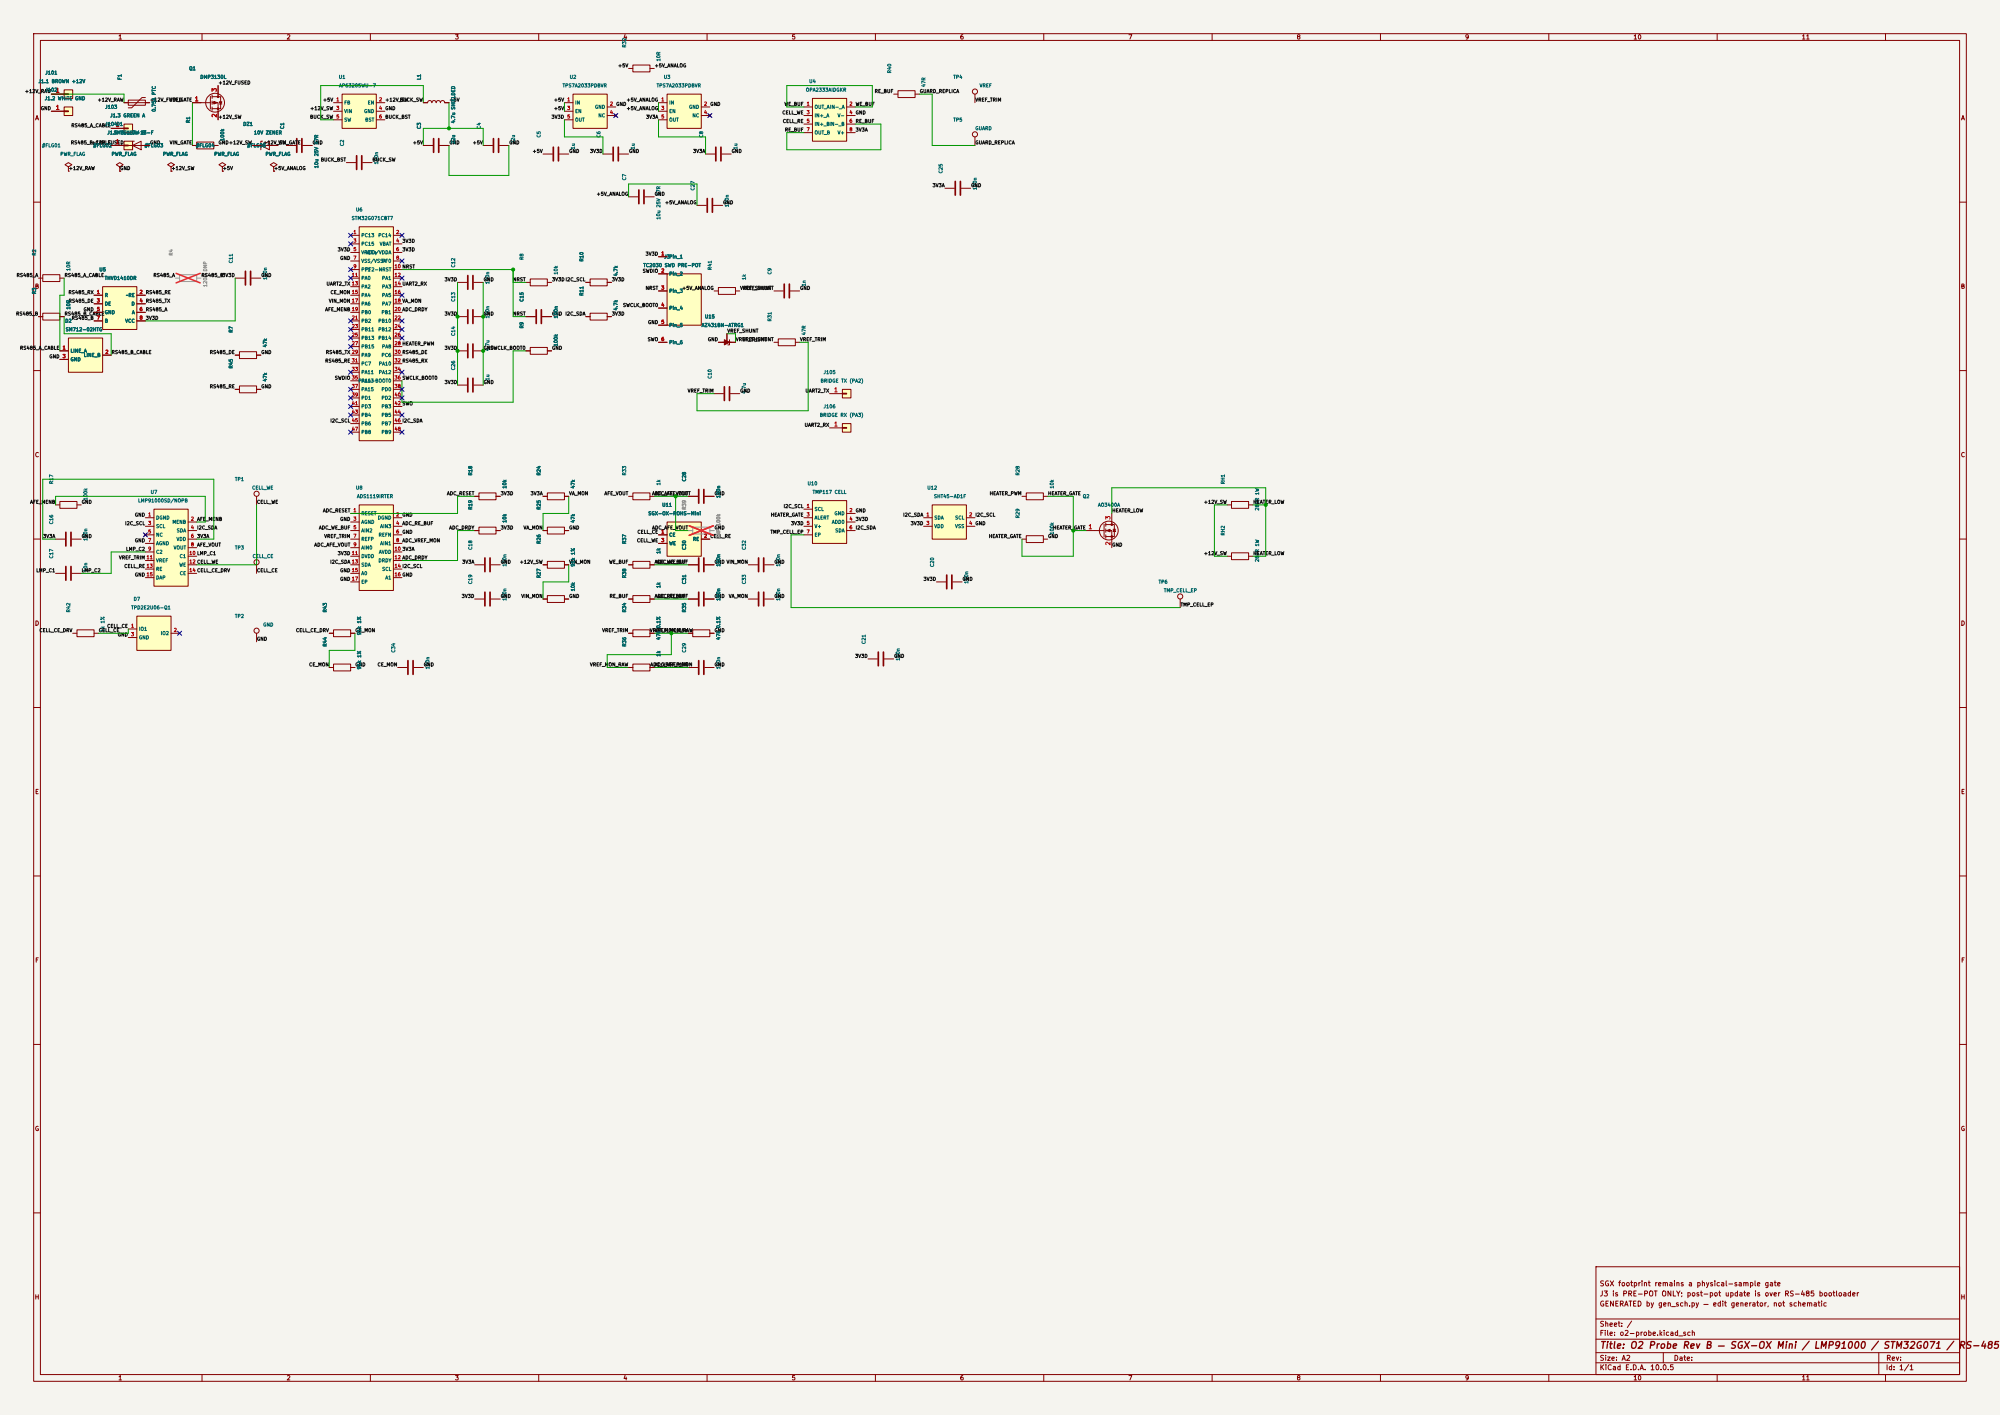
[picture p106: page 1]

J3 is PRE-POT ONLY; post-pot update is over RS-485 bootloader
GENERATED by gen_sch.py — edit generator, not schematic

Sheet: /
File: o2-probe.kicad_sch
Title: O2 Probe Rev B — SGX-OX Mini / LMP91000 / STM32G071 / RS-485

Size: A2 | Rev:
KiCad E.D.A. 10.0.5 | Id: 1/1
