fl4p/o2-probe/hw/fab/o2-probe-rev-a-fab/o2-probe-fab-drawing.pdf

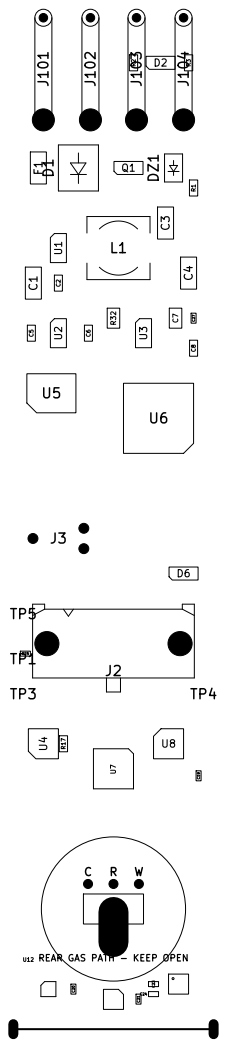
[picture p107: page 1]

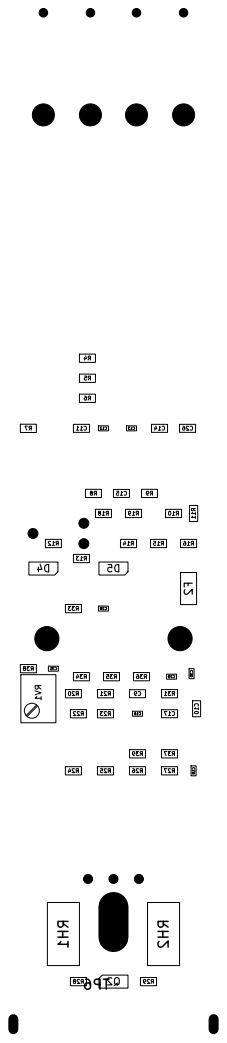
[picture p108: page 2]

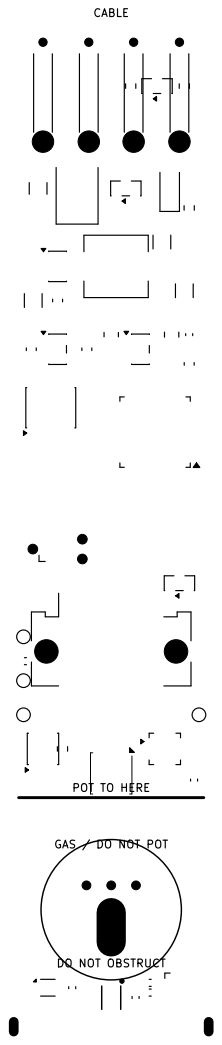
[picture p109: page 3]

CABLE POT TO HERE GAS / DO NOT POT DO NOT OBSTRUCT

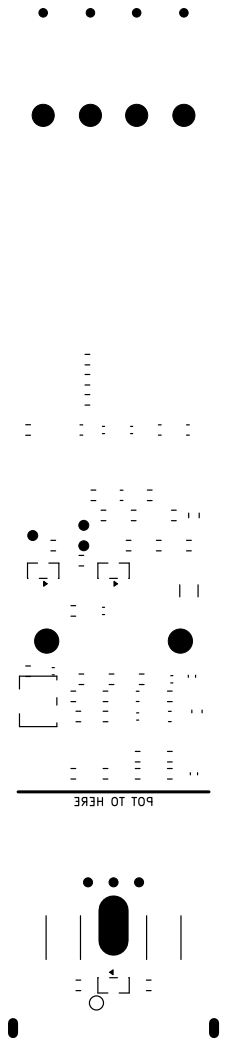
[picture p110: page 4]

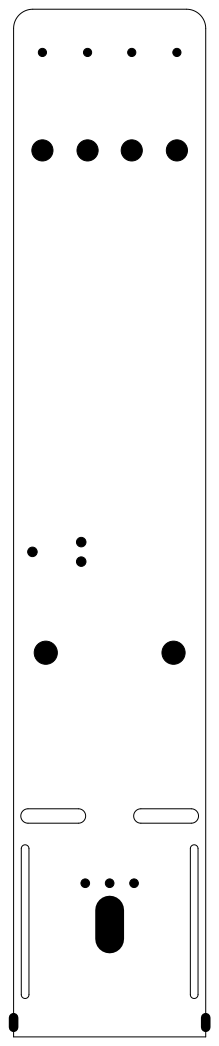
[picture p111: page 5]

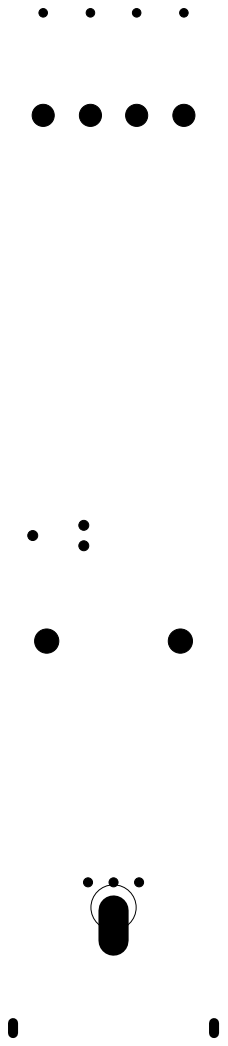
[picture p112: page 6]

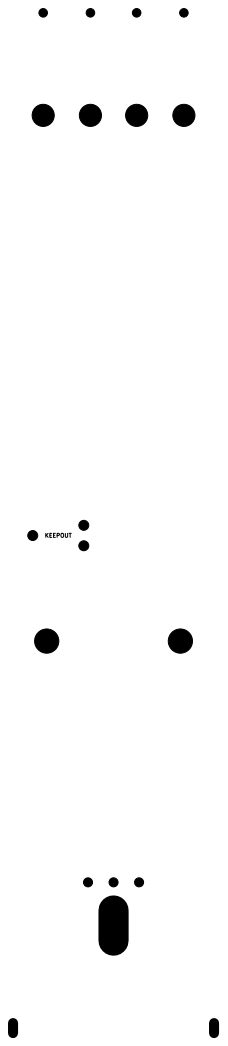
[picture p113: page 7]
