fl4p/o2-probe/hw/fab/o2-probe-rev-b-0c6dbe69dcaf3f52/o2-probe-assembly-back.pdf

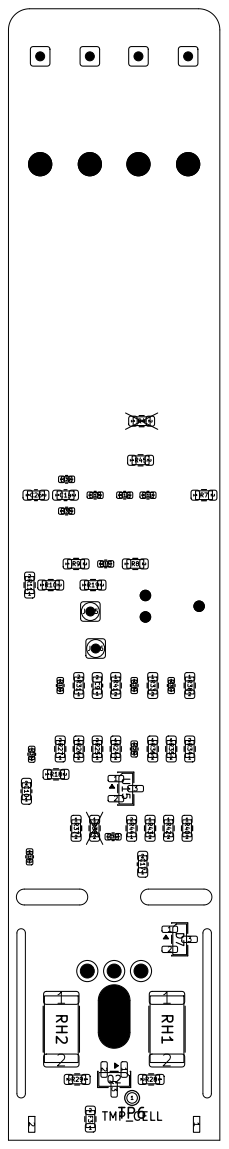
[picture p114: page 1]
