fl4p/o2-probe/hw/fab/o2-probe-rev-b-0c6dbe69dcaf3f52/o2-probe-assembly-front.pdf

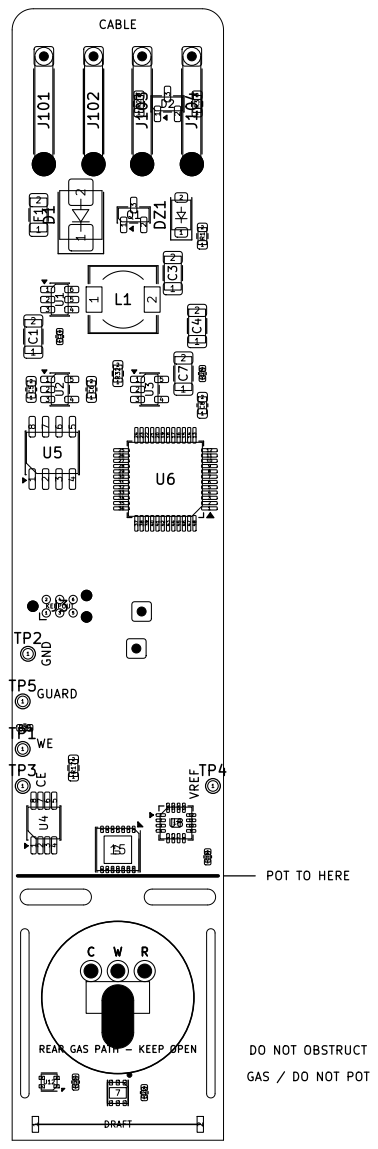
[picture p115: page 1]

POT TO HERE DO NOT OBSTRUCT GAS / DO NOT POT

REAR GAS PATH - KEEP OPEN R
