fl4p/o2-probe/hw/fab/o2-probe-rev-b-2959d79e8b31d893/o2-probe-assembly-back.pdf

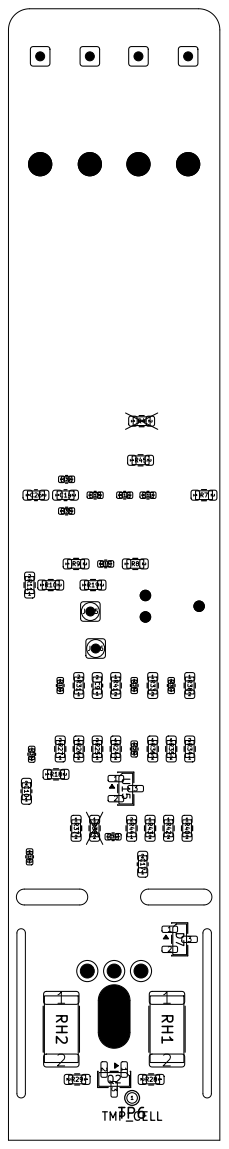
[picture p116: page 1]
