fl4p/o2-probe/hw/fab/o2-probe-rev-b-2959d79e8b31d893/o2-probe-assembly-front.pdf

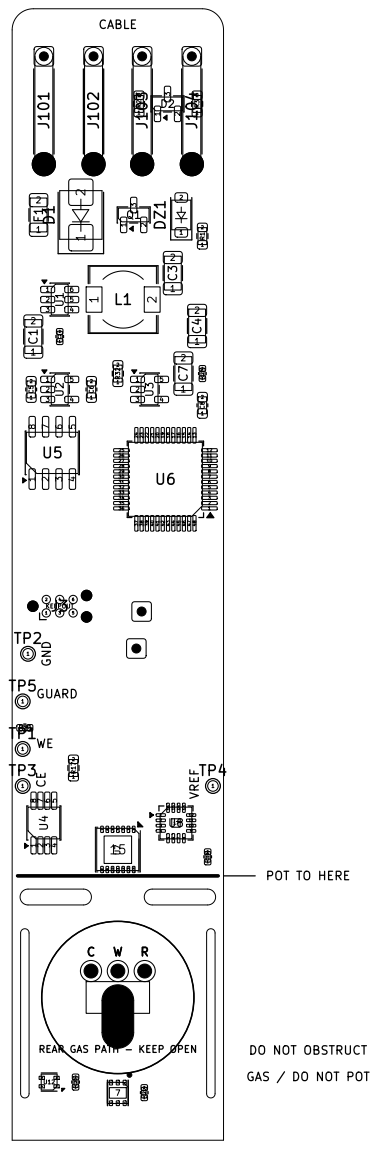
[picture p117: page 1]

POT TO HERE DO NOT OBSTRUCT GAS / DO NOT POT

REAR GAS PATH - KEEP OPEN R
