fl4p/o2-probe/hw/fab/o2-probe-rev-b-b05e2895d3025c4a/o2-probe-assembly-front.pdf

POT TO HERE DO NOT OBSTRUCT GAS / DO NOT POT

REAR GAS PATH - KEEP OPEN R
