fl4p/o2-probe/hw/fab/o2-probe-revb-86-4837fd61405f8b2b/o2-probe-assembly-back.pdf

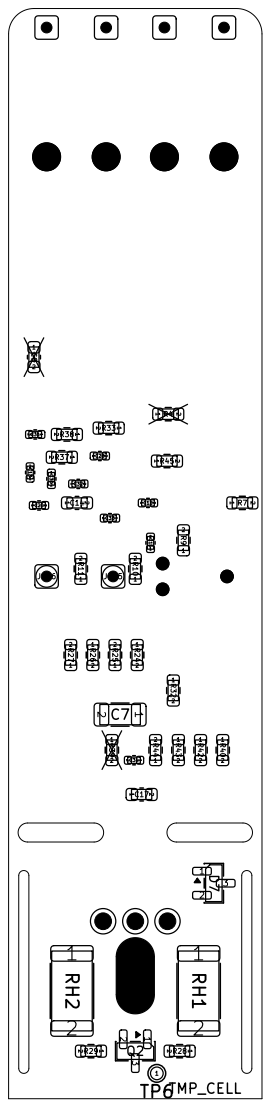
[picture p118: page 1]
