fl4p/o2-probe/hw/fab/o2-probe-revb-86-4837fd61405f8b2b/o2-probe-assembly-front.pdf

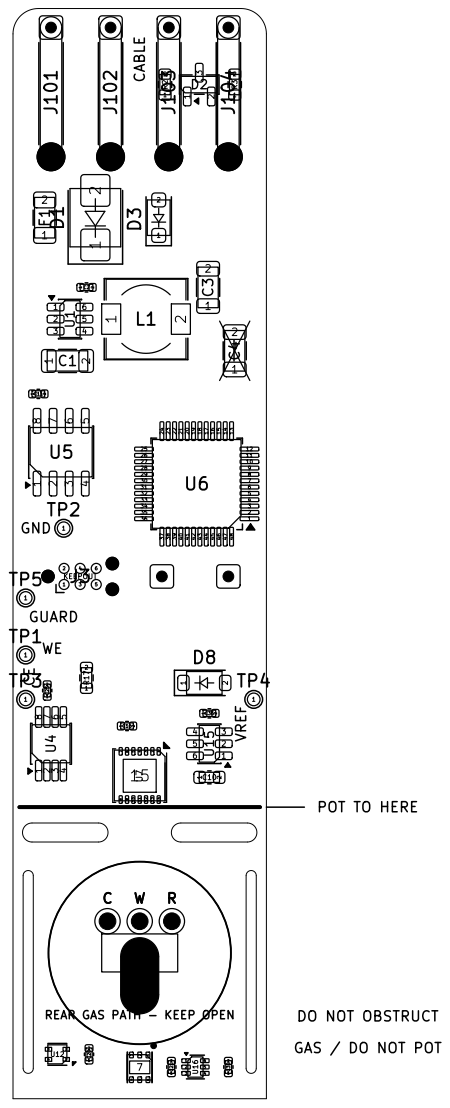
[picture p119: page 1]

REAR GAS PATH - KEEP OPEN R

GAS / DO NOT POT
