fl4p/o2-probe/hw/fab/o2-probe-revb-current-8eef4aa26e24a6cb/o2-probe-assembly-back.pdf

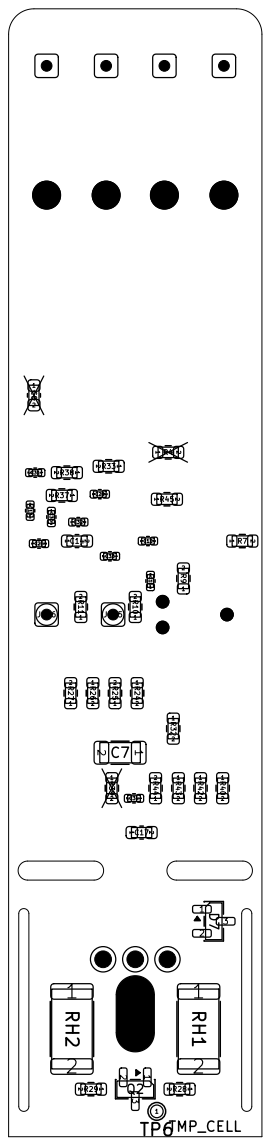
[picture p120: page 1]
