fl4p/o2-probe/hw/fab/o2-probe-revb-current-8eef4aa26e24a6cb/o2-probe-assembly-front.pdf

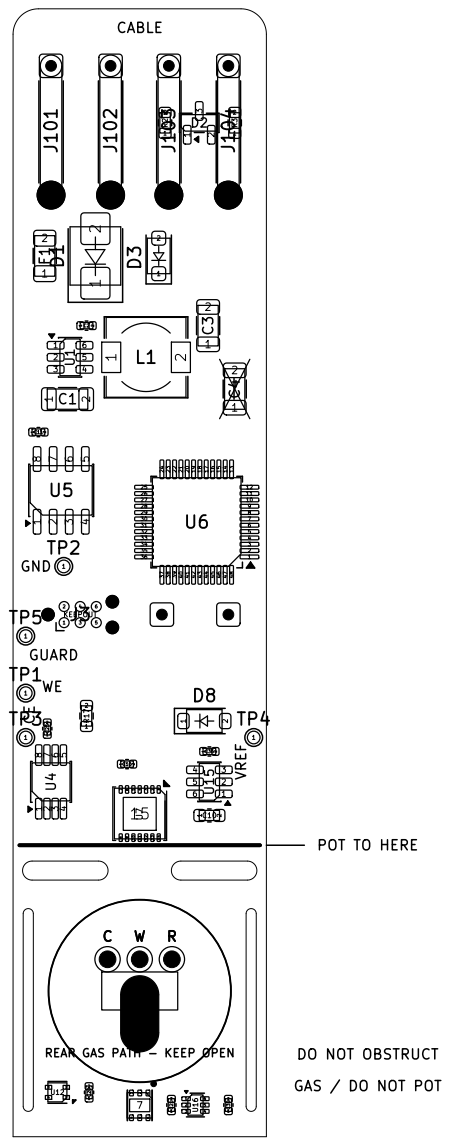
[picture p121: page 1]

REAR GAS PATH - KEEP OPEN R

GAS / DO NOT POT
