fl4p/o2-probe/hw/routing/revb-89-tmp302/review/o2-probe-assembly-back.pdf

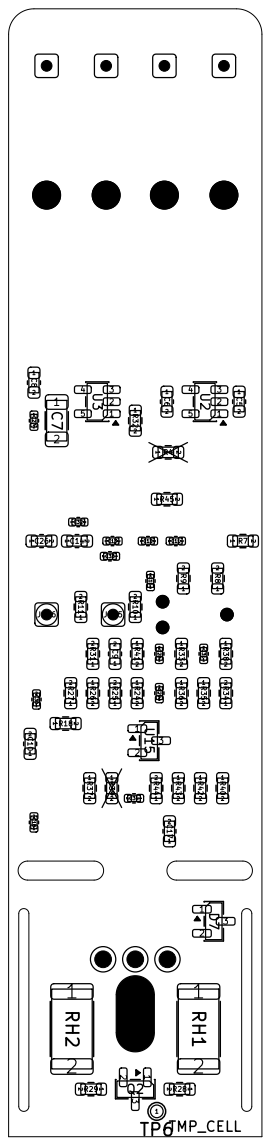
[picture p122: page 1]
