fl4p/o2-probe/hw/routing/revb-93/review/o2-probe-assembly-back.pdf

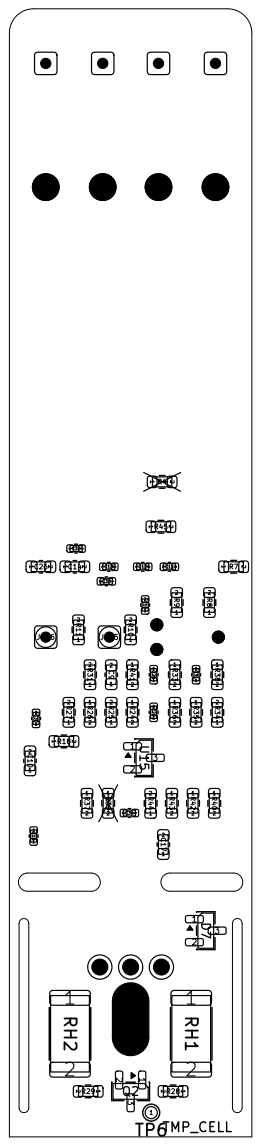
[picture p125: page 1]
