fl4p/o2-probe/hw/routing/revb-95/review/o2-probe-assembly-back.pdf

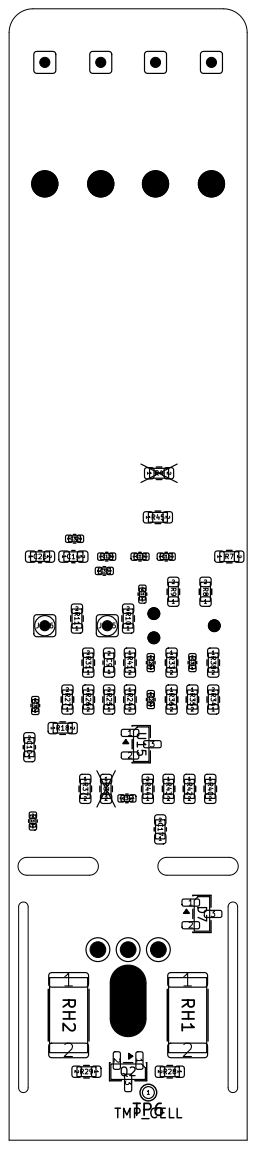
[picture p127: page 1]
