fl4p/o2-probe/hw/routing/revb-95/review/o2-probe-assembly-front.pdf

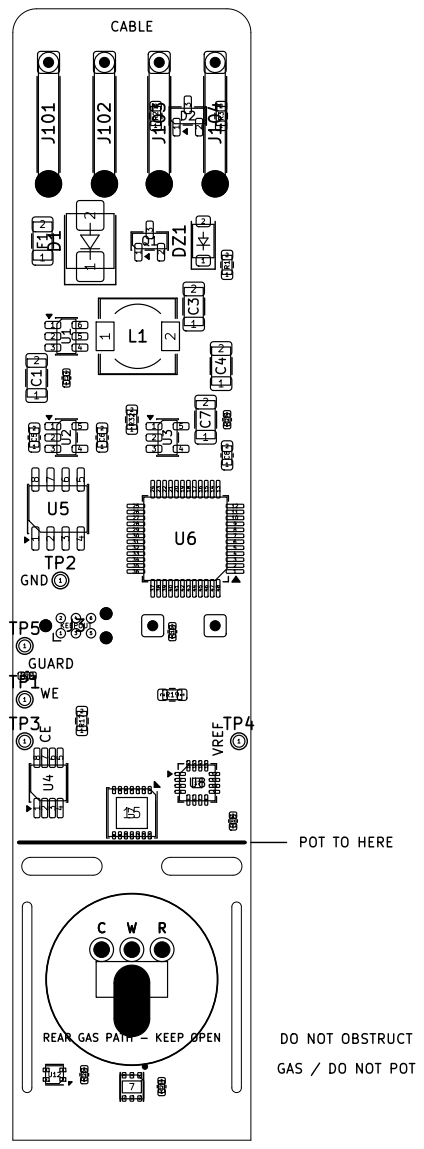
[picture p128: page 1]

REAR GAS PATH - KEEP OPEN R

GAS / DO NOT POT
