fl4p/o2-probe/hw/o2-probe-pcb-preview.pdf

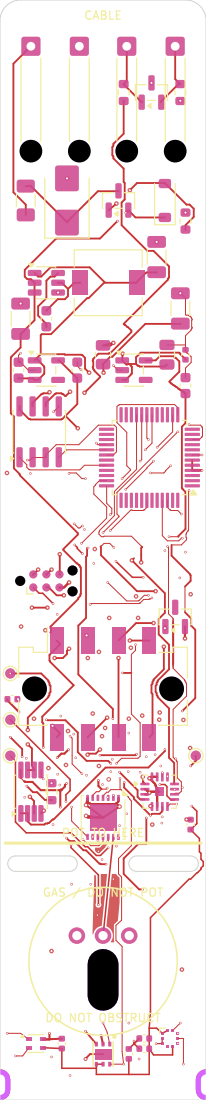
[picture p129: page 1]
