fl4p/o2-probe/(list of files, drawings)

Other design files:
hw/fab/o2-probe-rev-a-fab/pcb-drc-release.json
hw/fab/o2-probe-rev-a-fab/pcb-drc-warnings.json
hw/fab/o2-probe-rev-a/pcb-drc-release.json
hw/fab/o2-probe-rev-a/pcb-drc-warnings.json
hw/pcb-drc-release.json
hw/pcb-drc-warnings.json
