fl4p/o2-probe/hw/fab/o2-probe-rev-b-0c6dbe69dcaf3f52/source/o2-probe.kicad_pcb

## KiCad design hw/fab/o2-probe-rev-b-0c6dbe69dcaf3f52/source/o2-probe.kicad_pcb (2026-11-02)

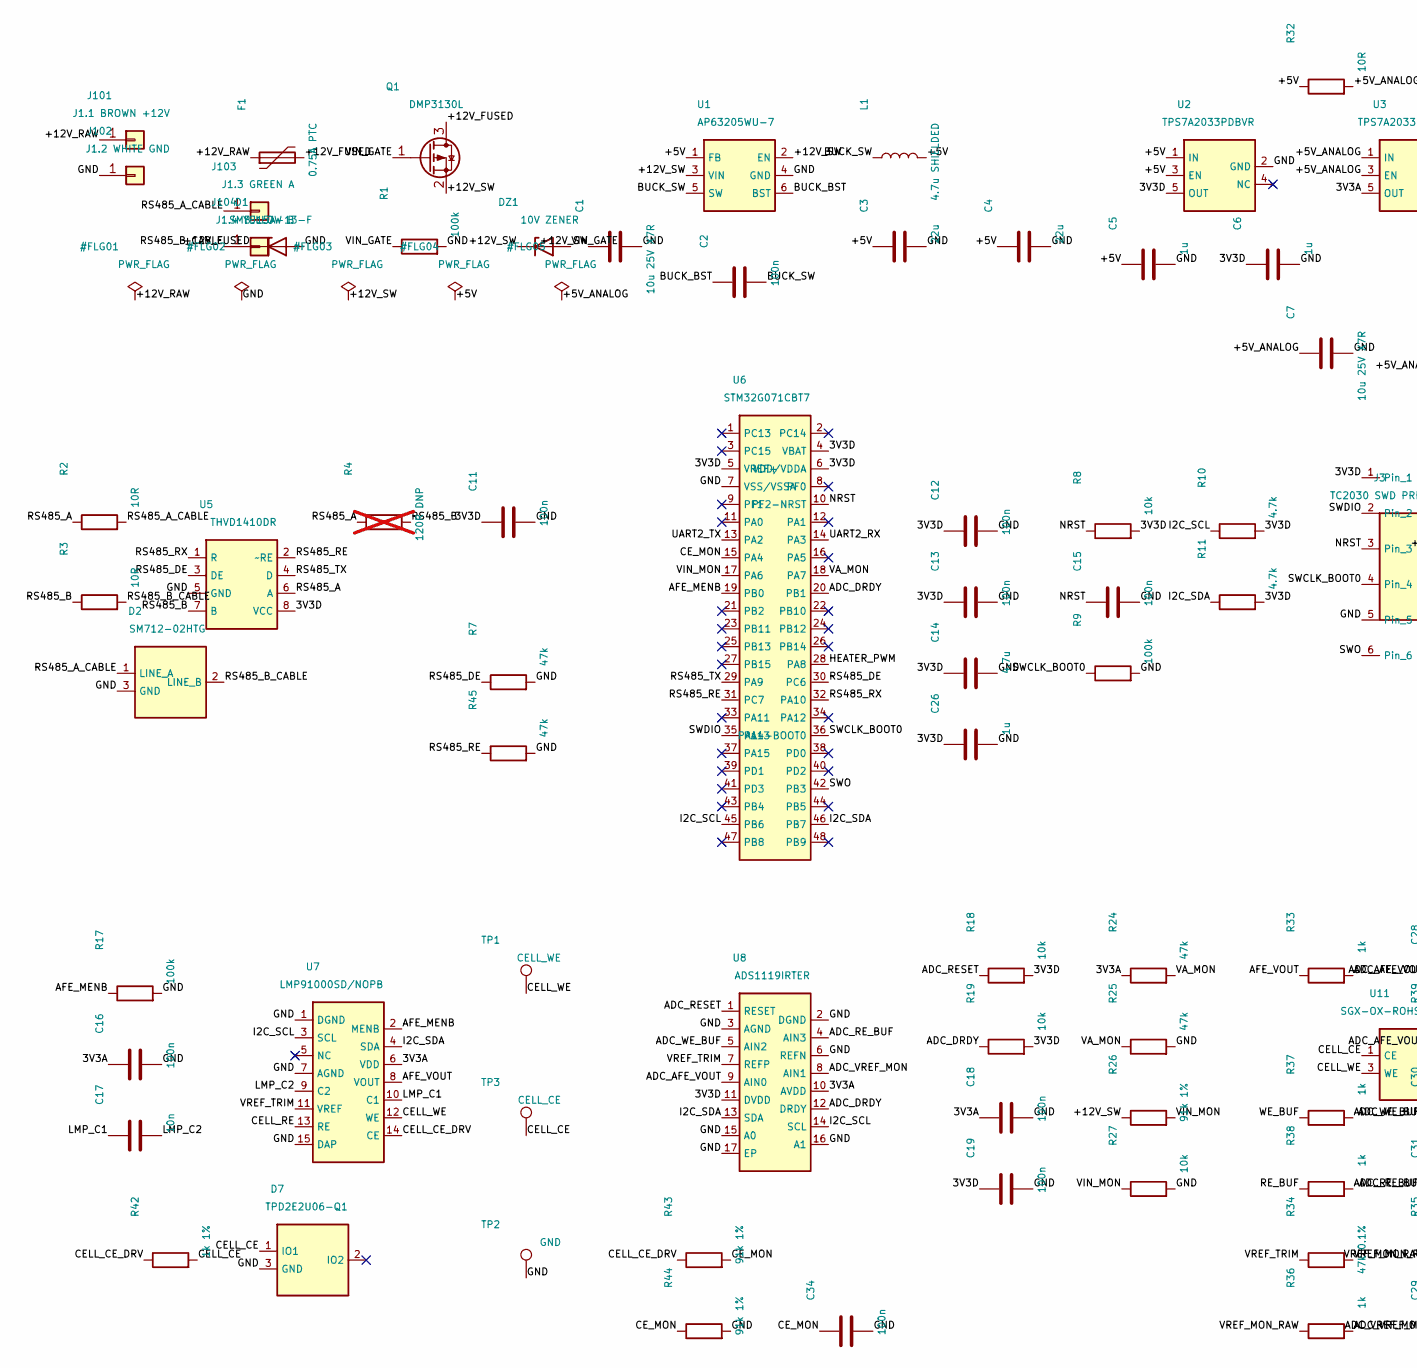
[picture p130: schematic o2-probe.kicad_sch, O2 Probe Rev B — SGX-OX Mini / LMP91000 / STM32G071 / RS-485, part in row 1, column 1]

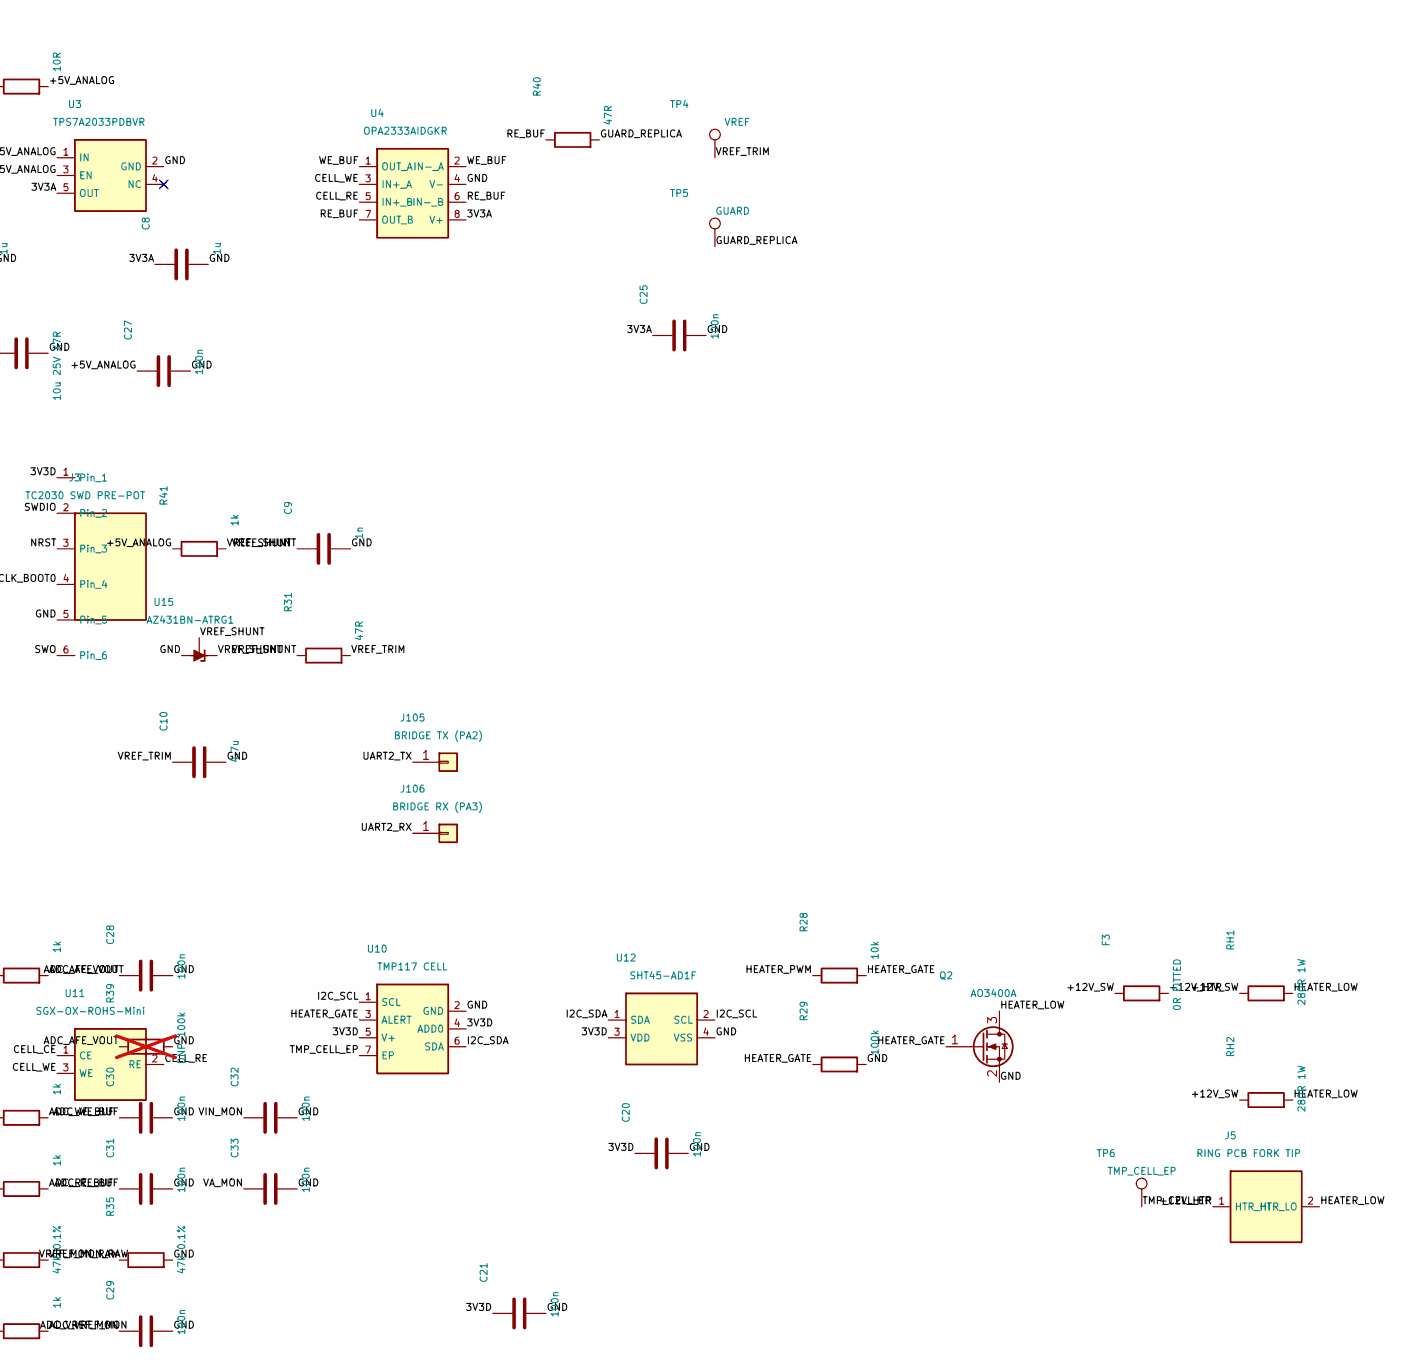
[picture p131: schematic o2-probe.kicad_sch, O2 Probe Rev B — SGX-OX Mini / LMP91000 / STM32G071 / RS-485, part in row 1, column 2]

Parts:
C1, C7: 10u 25V X7R; C_1206_3216Metric; MPN C1206C106K3RACTU
C2, C11, C12, C13, C15, C16, C18, C19, C20, C21, C25, C27, C28, C29, C30, C31, C32, C33, C34: 100n; C_0402_1005Metric
C3, C4: 22u; C_1206_3216Metric
C5, C6, C8, C26: 1u; C_0603_1608Metric
C9: 1n; C_0603_1608Metric; MPN C0603C102J5GACTU
C10, C14: 4.7u; C_0603_1608Metric
C17: 10n; C_0603_1608Metric
D1: SMBJ15A-13-F; D_SMB; MPN SMBJ15A-13-F
D2: SM712-02HTG; SOT-23; MPN SM712-02HTG
D7: TPD2E2U06-Q1; SOT-23; MPN TPD2E2U06QDBZRQ1
DZ1: 10V ZENER; D_SOD-123; MPN BZT52C10-E3-08
F1: 0.75A PTC; PTC_1206_3216Metric; MPN 0ZCJ0075AF2E
F3: 0R FITTED; R_0603_1608Metric
J3: TC2030 SWD PRE-POT; Tag-Connect_TC2030-IDC-NL_2x03_P1.27mm_Vertical
J5: RING PCB FORK TIP; Ring_Fork_Tip_DRAFT
J101: J1.1 BROWN +12V; SolderWire-0.25sqmm_1x01_D0.65mm_OD1.7mm_Relief
J102: J1.2 WHITE GND; SolderWire-0.25sqmm_1x01_D0.65mm_OD1.7mm_Relief
J103: J1.3 GREEN A; SolderWire_RaisedRelief_1x01
J104: J1.4 YELLOW B; SolderWire_RaisedRelief_1x01
J105: BRIDGE TX (PA2); SolderWireNoRelief_J105
J106: BRIDGE RX (PA3); SolderWireNoRelief_J106
L1: 4.7u SHIELDED; L_6.3x6.3_H3; MPN SRN6028C-4R7M
Q1: DMP3130L; SOT-23; MPN DMP3130L-7
Q2: AO3400A; SOT-23; MPN AO3400A
R1, R9, R17, R29: 100k; R_0603_1608Metric
R2, R3, R32: 10R; R_0603_1608Metric
R4: 120R DNP; R_0603_1608Metric; not fitted
R7, R24, R25, R45: 47k; R_0603_1608Metric
R8, R18, R19, R27, R28: 10k; R_0603_1608Metric
R10, R11: 4.7k; R_0603_1608Metric
R26, R43, R44: 91k 1%; R_0603_1608Metric; MPN RC0603FR-0791KL
R31, R40: 47R; R_0603_1608Metric
R33, R36, R37, R38, R41: 1k; R_0603_1608Metric
R34, R35: 47k 0.1%; R_0603_1608Metric; MPN RT0603BRD0747KL
R39: DNP 100k; R_0603_1608Metric; not fitted
R42: 1k 1%; R_0603_1608Metric; MPN RC0603FR-071KL
RH1, RH2: 280R 1W; R_2512_6332Metric; MPN CRCW2512280RFKEG
TP1: CELL_WE; TestPoint_Pad_D1.0mm
TP2: GND; TestPoint_Pad_D1.0mm
TP3: CELL_CE; TestPoint_Pad_D1.0mm
TP4: VREF; TestPoint_Pad_D1.0mm
TP5: GUARD; TestPoint_Pad_D1.0mm
TP6: TMP_CELL_EP; TestPoint_Pad_D1.0mm
U1: AP63205WU-7; TSOT-23-6; MPN AP63205WU-7
U2, U3: TPS7A2033PDBVR; SOT-23-5; MPN TPS7A2033PDBVR
U4: OPA2333AIDGKR; VSSOP-8_3x3mm_P0.65mm; MPN OPA2333AIDGKR
U5: THVD1410DR; SOIC-8_3.9x4.9mm_P1.27mm; MPN THVD1410DR
U6: STM32G071CBT7; LQFP-48_7x7mm_P0.5mm; MPN STM32G071CBT7
U7: LMP91000SD/NOPB; WSON-14-1EP_4.0x4.0mm_P0.5mm_EP2.6x2.6mm; MPN LMP91000SDX/NOPB
U8: ADS1119IRTER; Texas_RTE0016D_WQFN-16-1EP_3x3mm_P0.5mm_EP0.8x0.8mm; MPN ADS1119IRTER
U10: TMP117 CELL; TMP117_WSON-6-1EP_2x2mm_TI; MPN TMP117AIDRVR
U11: SGX-OX-ROHS-Mini; SGX-OX-ROHS-Mini_ISS2; MPN SGX-OX-ROHS-Mini
U12: SHT45-AD1F; Sensirion_DFN-4_1.5x1.5mm_P0.8mm_SHT4x_NoCentralPad; MPN SHT45-AD1F-R2
U15: AZ431BN-ATRG1; SOT-23; MPN AZ431BN-ATRG1

Connections:
/3V3A: C8.1, C16.1, C18.1, C25.1, R24.1, U3.5 (OUT), U4.8 (V+), U7.6 (VDD), U8.10 (AVDD)
/3V3D: C6.1, C11.1, C12.1, C13.1, C14.1, C19.1, C20.1, C21.1, C26.1, J3.1, R8.2, R10.2, R11.2, R18.2, R19.2, U2.5 (OUT), U5.8 (VCC), U6.4 (VBAT), U6.5 (VREF+), U6.6 (VDD/VDDA), U8.11 (DVDD), U10.4 (ADD0), U10.5 (V+), U12.3 (VDD)
/+5V: C3.1, C4.1, C5.1, L1.2, R32.1, U1.1 (FB), U2.1 (IN), U2.3 (EN)
/+5V_ANALOG: C7.1, C27.1, R32.2, R41.1, U3.1 (IN), U3.3 (EN)
/+12V_FUSED: D1.1 (K), F1.2, Q1.3 (D)
/+12V_HTR: F3.2, J5.1 (HTR_HI)
/+12V_RAW: F1.1, J101.1
/+12V_SW: C1.1, DZ1.1 (K), F3.1, Q1.2 (S), R26.1, RH1.1, RH2.1, U1.2 (EN), U1.3 (VIN)
/ADC_AFE_VOUT: C28.1, R33.2, R39.1, U8.9 (AIN0)
/ADC_DRDY: R19.1, U6.20 (PB1), U8.12 (DRDY)
/ADC_RESET: R18.1, U8.1 (RESET)
/ADC_RE_BUF: C31.1, R38.2, U8.4 (AIN3)
/ADC_VREF_MON: C29.1, R36.2, U8.8 (AIN1)
/ADC_WE_BUF: C30.1, R37.2, U8.5 (AIN2)
/AFE_MENB: R17.1, U6.19 (PB0), U7.2 (MENB)
/AFE_VOUT: R33.1, U7.8 (VOUT)
/BUCK_BST: C2.1, U1.6 (BST)
/BUCK_SW: C2.2, L1.1, U1.5 (SW)
/CELL_CE: D7.1 (IO1), R42.2, TP3.1, U11.1 (CE)
/CELL_CE_DRV: R42.1, R43.1, U7.14 (CE)
/CELL_RE: U4.5 (IN+_B), U7.13 (RE), U11.2 (RE)
/CELL_WE: TP1.1, U4.3 (IN+_A), U7.12 (WE), U11.3 (WE)
/CE_MON: C34.1, R43.2, R44.1, U6.15 (PA4)
/GND: C1.2, C3.2, C4.2, C5.2, C6.2, C7.2, C8.2, C9.2, C10.2, C11.2, C12.2, C13.2, C14.2, C15.2, C16.2, C18.2, C19.2, C20.2, C21.2, C25.2, C26.2, C27.2, C28.2, C29.2, C30.2, C31.2, C32.2, C33.2, C34.2, D1.2 (A), D2.3 (GND), D7.3 (GND), J3.5, J102.1, Q2.2 (S), R1.2, R7.2, R9.2, R17.2, R25.2, R27.2, R29.2, R35.2, R39.2, R44.2, R45.2, TP2.1, U1.4 (GND), U2.2 (GND), U3.2 (GND), U4.4 (V-), U5.5 (GND), U6.7 (VSS/VSSA), U7.1 (DGND), U7.7 (AGND), U7.15 (DAP), U8.2 (DGND), U8.3 (AGND), U8.6 (REFN), U8.15 (A0), U8.16 (A1), U8.17 (EP), U10.2 (GND), U12.4 (VSS), U15.3 (A)
/GUARD_REPLICA: R40.2, TP5.1
/HEATER_GATE: Q2.1 (G), R28.2, R29.1, U10.3 (ALERT)
/HEATER_LOW: J5.2 (HTR_LO), Q2.3 (D), RH1.2, RH2.2
/HEATER_PWM: R28.1, U6.28 (PA8)
/I2C_SCL: R10.1, U6.45 (PB6), U7.3 (SCL), U8.14 (SCL), U10.1 (SCL), U12.2 (SCL)
/I2C_SDA: R11.1, U6.46 (PB7), U7.4 (SDA), U8.13 (SDA), U10.6 (SDA), U12.1 (SDA)
/LMP_C1: C17.1, U7.10 (C1)
/LMP_C2: C17.2, U7.9 (C2)
/NRST: C15.1, J3.3, R8.1, U6.10 (PF2-NRST)
/RE_BUF: R38.1, R40.1, U4.6 (IN-_B), U4.7 (OUT_B)
/RS485_A: R2.1, R4.1, U5.6 (A)
/RS485_A_CABLE: D2.1 (LINE_A), J103.1, R2.2
/RS485_B: R3.1, R4.2, U5.7 (B)
/RS485_B_CABLE: D2.2 (LINE_B), J104.1, R3.2
/RS485_DE: R7.1, U5.3 (DE), U6.30 (PC6)
/RS485_RE: R45.1, U5.2 (~RE), U6.31 (PC7)
/RS485_RX: U5.1 (R), U6.32 (PA10)
/RS485_TX: U5.4 (D), U6.29 (PA9)
/SWCLK_BOOT0: J3.4, R9.1, U6.36 (PA14-BOOT0)
/SWDIO: J3.2, U6.35 (PA13)
/SWO: J3.6, U6.42 (PB3)
/TMP_CELL_EP: TP6.1, U10.7 (EP)
/UART2_RX: J106.1, U6.14 (PA3)
/UART2_TX: J105.1, U6.13 (PA2)
/VA_MON: C33.1, R24.2, R25.1, U6.18 (PA7)
/VIN_GATE: DZ1.2 (A), Q1.1 (G), R1.1
/VIN_MON: C32.1, R26.2, R27.1, U6.17 (PA6)
/VREF_MON_RAW: R34.2, R35.1, R36.1
/VREF_SHUNT: C9.1, R31.1, R41.2, U15.1 (REF), U15.2 (K)
/VREF_TRIM: C10.1, R31.2, R34.1, TP4.1, U7.11 (VREF), U8.7 (REFP)
/WE_BUF: R37.1, U4.1 (OUT_A), U4.2 (IN-_A)

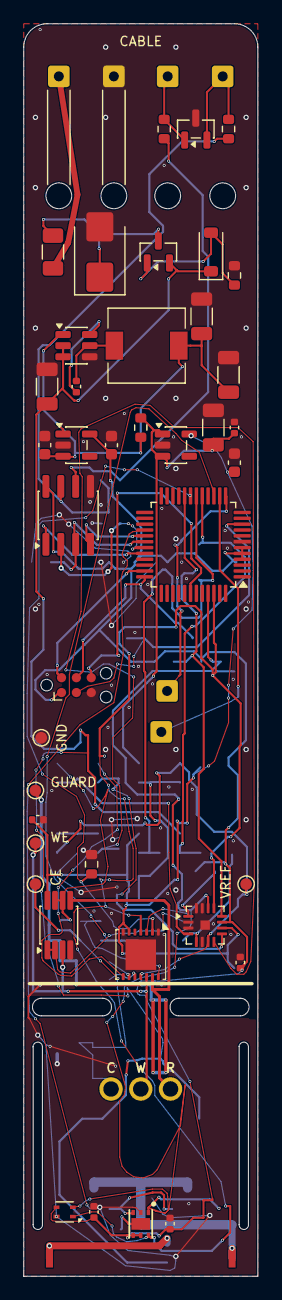
[picture p132: board o2-probe.kicad_pcb from above]

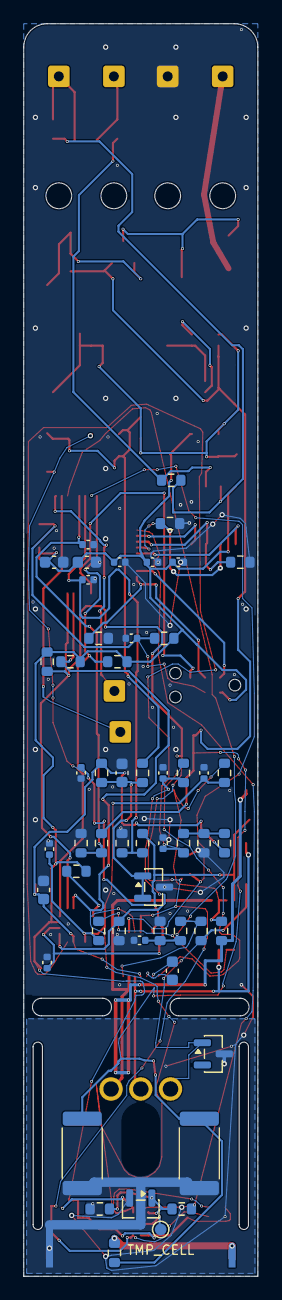
[picture p133: board o2-probe.kicad_pcb from below]

Board: 2 copper layers, 20.0 x 107.0 mm, 101 parts (55 on the bottom side), 55 nets.
