fl4p/o2-probe/hw/firmware/src/board_pins.h

/* o2-probe Rev A - GPIO bindings for the STM32G071CBT7 (LQFP-48).
 *
 * hw_contract.h is generated from ../gen_sch.py and says which NET is on which
 * package pin. This file says which PORT/PIN/ALTERNATE-FUNCTION that package
 * pin actually is, and then asserts the two agree. Move a net in the schematic
 * and the build stops here rather than reading the wrong pin at runtime.
 *
 * FAB-READINESS.md:82 - "Firmware must use this final pin map."
 */
#ifndef O2P_BOARD_PINS_H
#define O2P_BOARD_PINS_H

#include "hw_caps.h"      /* O2P_HW_HAS_ADS1119 - the ADS block is gated on it */
#include "hw_contract.h"

/* --- LQFP-48 package pin -> port, for every pin this firmware binds -------
 * From ST DS12232 Table "Pin definitions", LQFP48 column. Kept as macros so
 * the static assertions below can compare against the generated contract.
 */
#define O2P_LQFP48_VREFP  5   /* not a GPIO: the ADC's reference input */
#define O2P_LQFP48_PA0   11
#define O2P_LQFP48_PA1   12
#define O2P_LQFP48_PA2   13
#define O2P_LQFP48_PA3   14
#define O2P_LQFP48_PA5   16
#define O2P_LQFP48_PA6   17
#define O2P_LQFP48_PA7   18
#define O2P_LQFP48_PB0   19
#define O2P_LQFP48_PB1   20
#define O2P_LQFP48_PB2   21
#define O2P_LQFP48_PA8   28
#define O2P_LQFP48_PA9   29
#define O2P_LQFP48_PC6   30
#define O2P_LQFP48_PC7   31
#define O2P_LQFP48_PA10  32
#define O2P_LQFP48_PB6   45
#define O2P_LQFP48_PB7   46

/* --- Bindings ------------------------------------------------------------ */

/* RS-485, USART1. PA9/PA10 are USART1 TX/RX on AF1. */
#define O2P_RS485_TX_PORT     GPIOA
#define O2P_RS485_TX_PIN      9u
#define O2P_RS485_TX_AF       1u
#define O2P_RS485_RX_PORT     GPIOA
#define O2P_RS485_RX_PIN      10u
#define O2P_RS485_RX_AF       1u

/* Direction control. PC6 carries NO USART1_DE alternate function on this part
 * - it has only TIM2_CH3 (AF2) and TIM3_CH1 (AF1). USART1's hardware DE exists
 * only on PA12 and PB3, neither of which reaches the THVD1410. So DE is a
 * plain output driven in software; see modbus_rtu.c for the TC-interrupt
 * release. PLAN.md:261 says "USART+DE"; that is not achievable on this board.
 *
 * R7 (47k) pulls DE down, so the driver is DISABLED through MCU reset, and
 * main.c's bus-jam backstop leans on exactly that: it is the release path that
 * does not depend on this CPU running code. R7 is not to be removed or
 * repurposed. Since Rev B split /RE onto its own pin, R7 no longer decides
 * whether the part LISTENS - R45 does; see O2P_RS485_RE_* below. Both defaults
 * are still passive, which is the property that matters.
 */
#define O2P_RS485_DE_PORT     GPIOC
#define O2P_RS485_DE_PIN      6u

/* Receiver enable, REV B. /RE is the THVD1410's pin 2 and it is ACTIVE LOW:
 * drive it LOW to hear the bus, HIGH to deafen the receiver. On Rev A it was
 * shorted to DE, which made the part's 0.1 uA standby (/RE high, DE low)
 * uncommandable and left the receiver burning 700 uA forever - 24 % of the
 * whole board's idle draw (POWER-BUDGET.md). Rev B splits it onto PC7, the
 * package neighbour of PC6.
 *
 * PC7 carries no ADC channel - DS12232 Rev 1 Table 12 "Pin assignment and
 * description" leaves its "Additional functions" cell empty - so it cannot
 * collide with mcu_adc.c, and its only alternate functions are UCPD2_FRSTX,
 * TIM3_CH2 and TIM2_CH4, none of them used. Like DE it is a plain
 * software-driven output; there is no hardware /RE anywhere on this part.
 *
 * SAFETY, and the reason this is more than "a second GPIO": an undriven /RE
 * floats HIGH on the part's 2 MOhm internal pull-up, which is DEAF, and every
 * MCU GPIO is high-impedance out of reset. R45 (47k to GND) is what makes
 * receiver-enabled the passive default: 3.3 V * 47k/(47k + 2M) = 76 mV against
 * a 0.8 V VIL. So a probe sitting in the RS-485 bootloader - or with no
 * working application at all - still hears the bus, and the field-reflash path
 * of SCHEMATIC-REVIEW.md M2 survives. Firmware must never leave this pin
 * high-impedance as a way of "not caring", and anything that drives it high
 * needs a bounded path back to low.
 */
#define O2P_RS485_RE_PORT     GPIOC
#define O2P_RS485_RE_PIN      7u

/* The expansion/recovery UART, USART2. PA2/PA3 are USART2 TX/RX on AF1.
 *
 * NOTHING ON A SHIPPING PROBE USES THIS. Since 2026-09-05 these two pins land
 * on J105/J106, a pair of solder-wire lands, and stop there: the expansion
 * connector J2 and the R12-R16 series pack were deleted in the BOM pass
 * (docs/archive/2026-09-09-pcb-plans/BOM-REDUCTION.md 3), but R15/R16 were NOT deletable, because this comment
 * and bridge_main.c were already using their pads as the bench-bridge tap. The
 * lands replace them and are a better version of the same thing - a wire land
 * rather than half of an unfitted resistor. The LQFP's 0.5 mm pitch is still
 * not a tap point.
 *
 * There is no direction pin here and there must not be one: this side is a
 * point-to-point TTL link to one lead, not a bus.
 */
#define O2P_EXP_UART_TX_PORT  GPIOA
#define O2P_EXP_UART_TX_PIN   2u
#define O2P_EXP_UART_TX_AF    1u
#define O2P_EXP_UART_RX_PORT  GPIOA
#define O2P_EXP_UART_RX_PIN   3u
#define O2P_EXP_UART_RX_AF    1u

/* I2C1 on PB6/PB7, AF6. Bus is capped at 100 kHz because the LMP91000 is
 * standard-mode only (PLAN.md:234). 4.7k pull-ups are fitted (R10/R11). */
#define O2P_I2C_SCL_PORT      GPIOB
#define O2P_I2C_SCL_PIN       6u
#define O2P_I2C_SCL_AF        6u
#define O2P_I2C_SDA_PORT      GPIOB
#define O2P_I2C_SDA_PIN       7u
#define O2P_I2C_SDA_AF        6u

/* LMP91000 MENB, active low, gates the AFE's I2C interface only. R17 (100k)
 * pulls it LOW, so the AFE is addressable through MCU reset - deliberate, so
 * I2C availability is deterministic (PLAN.md:234-236). */
#define O2P_AFE_MENB_PORT     GPIOB
#define O2P_AFE_MENB_PIN      0u

/* ADS1119 DRDY, open-drain, R19 (10k) pull-up. Falls when a conversion is
 * ready. There is no GPIO on the ADS1119 RESET pin - R18 holds it released and
 * recovery must go through the I2C RESET command.
 *
 * REV B DELETED THE ADS1119, and PB1 is now the AFE_VOUT ANALOG INPUT. Driving
 * it as a GPIO would configure the oxygen channel's own pin, so this block is
 * gated rather than left standing: on a board with no ADS1119 the symbols do
 * not exist and ads1119.c refuses to compile, instead of quietly reading DRDY
 * off an analog pin that is never going to fall. */
#if O2P_HW_HAS_ADS1119
#define O2P_ADC_DRDY_PORT     GPIOB
#define O2P_ADC_DRDY_PIN      1u
#endif

/* Membrane-ring heater. PA8 is TIM1_CH1 on AF2.
 *
 * DANGER: PA7 is TIM1_CH1N, the complement of this very channel, and PA7 is
 * the analog rail monitor. TIM1 CH1N must never be enabled. See heater.c. */
#define O2P_HEATER_PWM_PORT   GPIOA
#define O2P_HEATER_PWM_PIN    8u
#define O2P_HEATER_PWM_AF     2u

/* 3V3A rail monitor, ADC1_IN7. The independent witness for a 3V3A brownout:
 * the ADS1119's own AVDD is 3V3A, so it cannot report its own supply failing.
 * Referenced to VREF+ = 3V3D, so absolute volts need the VREFINT calibration. */
#define O2P_VA_MON_PORT       GPIOA
#define O2P_VA_MON_PIN        7u
#define O2P_VA_MON_ADC_CH     7u

/* +12V_SW input-rail monitor, ADC1_IN6, through R26/R27.
 *
 * THIS PIN WAS NEVER READ until 2026-09-05. The rail monitors moved from the
 * ADS1119 to the MCU's own ADC in an earlier revision; VA_MON's half of that
 * migration landed and VIN_MON's did not. main.c went on sampling ADS1119 AIN3
 * and scaling it by the VIN divider, but AIN3 is ADC_RE_BUF - the buffered
 * reference electrode - so vin_mv was never the input rail, and because
 * O2P_F_VIN_LOW feeds supply_ok, the undervoltage half of the heater interlock
 * could not fire. Found by an adversarial review of the BOM pass. */
#define O2P_VIN_MON_PORT      GPIOA
#define O2P_VIN_MON_PIN       6u
#define O2P_VIN_MON_ADC_CH    6u

/* CELL_CE_DRV through R43/R44, hw_contract.h. The counter electrode is what
 * A1 drives to hold the cell at its bias, so this pin is the only witness to
 * whether the potentiostat's control loop is closing at all. Wired since Rev A
 * and read by nothing until 2026-09-08 - which is why, when A1 died on
 * 2026-09-04, no converter on the board could see it. */
#define O2P_CE_MON_PORT       GPIOA
#define O2P_CE_MON_PIN        4u
#define O2P_CE_MON_ADC_CH     4u

/* --- The contract ---------------------------------------------------------
 * Each assertion pairs "which net the schematic put on this package pin" with
 * "which package pin this port bit is". Both halves must move together.
 */
#define O2P_ASSERT_NET(net, lqfp) \
    _Static_assert(O2P_HW_NET_##net##_PIN == (lqfp), \
                   "gen_sch.py moved " #net " off LQFP48 pin " #lqfp \
                   " - update board_pins.h and re-check every user of it")

O2P_ASSERT_NET(RS485_TX,   O2P_LQFP48_PA9);
O2P_ASSERT_NET(RS485_RX,   O2P_LQFP48_PA10);
O2P_ASSERT_NET(RS485_DE,   O2P_LQFP48_PC6);
O2P_ASSERT_NET(RS485_RE,   O2P_LQFP48_PC7);
O2P_ASSERT_NET(I2C_SCL,    O2P_LQFP48_PB6);
O2P_ASSERT_NET(I2C_SDA,    O2P_LQFP48_PB7);
O2P_ASSERT_NET(AFE_MENB,   O2P_LQFP48_PB0);
/* The four analog channels the ADS1119 used to carry (2026-09-12). The net
 * names are asserted against the SCHEMATIC's pin map, so moving one of these
 * channels in gen_sch.py without moving mcu_adc.c breaks the build. Structure
 * matters here and is recorded where it is enforced: PA0/PA1 are the matched
 * FT_a pair carrying WE/RE, PA5 is the undivided /VREF_TRIM. */
O2P_ASSERT_NET(ADC_WE_BUF,   O2P_LQFP48_PA0);
O2P_ASSERT_NET(ADC_RE_BUF,   O2P_LQFP48_PA1);
/* ADOPTED 2026-09-12: /VREF_TRIM lands on VREF+ (pin 5), not on a channel. This
 * assertion is the firmware-side lock on the architecture -- if the schematic
 * ever puts pin 5 back on 3V3D, VDDA re-enters the oxygen derivation at
 * 0.718 mV/mV and the build stops instead of the readings quietly drifting. */
O2P_ASSERT_NET(VREF_TRIM,    O2P_LQFP48_VREFP);
O2P_ASSERT_NET(ADC_AFE_VOUT, O2P_LQFP48_PB1);
O2P_ASSERT_NET(HEATER_PWM, O2P_LQFP48_PA8);
O2P_ASSERT_NET(VA_MON,     O2P_LQFP48_PA7);
O2P_ASSERT_NET(VIN_MON,    O2P_LQFP48_PA6);
O2P_ASSERT_NET(UART2_TX,   O2P_LQFP48_PA2);
O2P_ASSERT_NET(UART2_RX,   O2P_LQFP48_PA3);

/* REV B split: DE and /RE must be DIFFERENT pins. If a future schematic ties
 * them back together the standby state disappears again and, worse,
 * o2p_modbus_rx_standby(true) would start DRIVING the shared cable while
 * trying to go deaf. */
_Static_assert(O2P_HW_NET_RS485_DE_PIN != O2P_HW_NET_RS485_RE_PIN,
               "RS485_DE and RS485_RE share an MCU pin again - the Rev B split is undone");

/* PA7 doubles as TIM1_CH1N for the PA8 heater channel. If a future schematic
 * moves the heater off TIM1, this pairing stops being a hazard and heater.c's
 * guard can be revisited - so pin it here too. */
_Static_assert(O2P_HW_NET_VA_MON_PIN == 18 && O2P_HW_NET_HEATER_PWM_PIN == 28,
               "VA_MON/HEATER_PWM moved: recheck the TIM1_CH1/CH1N conflict");

#endif /* O2P_BOARD_PINS_H */
