fl4p/o2-probe/hw/fab/o2-probe-revb-current-8eef4aa26e24a6cb/source/o2-probe/make_fab.py

#!/usr/bin/env python3
"""Build and inspect the Rev A first-article bare-board release."""

from __future__ import annotations

from datetime import datetime, timezone
import hashlib
import json
from collections import Counter
from pathlib import Path
import re
import shutil
import subprocess
import sys
import zipfile


HERE = Path(__file__).resolve().parent
BOARD = HERE / "o2-probe.kicad_pcb"
SCHEMATIC = HERE / "o2-probe.kicad_sch"
KICAD = Path("/Applications/KiCad/KiCad.app/Contents/MacOS/kicad-cli")
KIPY = Path("/Applications/KiCad/KiCad.app/Contents/Frameworks/Python.framework/Versions/Current/bin/python3")
FAB_ROOT = HERE / "fab"
RELEASE = FAB_ROOT / "o2-probe-rev-a"
TEMP = FAB_ROOT / ".o2-probe-rev-a.tmp"
ZIP = FAB_ROOT / "o2-probe-rev-a-fab.zip"

# The stencil layers are here because leaving them out is not a decision anyone
# made.  The KiCad footprints carry real paste engineering -- Texas_RTE0016D's
# exposed pad, for one, is deliberately NOT 1:1: pad 17 gets copper and mask
# only, and four separate 0.32 x 0.32 mm roundrect apertures (rratio 0.25, so
# r = 0.08) supply 0.3876 of its 0.64 mm2 -- a segmented 60.6%, verified by
# plotting the layer and measuring the emitted D16 aperture rather than by
# multiplying nominal pad sizes, which ignores the corner radius and overstates
# it as 64%. The pattern exists to stop the part floating on molten paste and
# starving its perimeter joints.  Omitting F.Paste threw that away silently: an
# assembler with no paste layer cuts a stencil from the copper, which on that pad
# is exactly the 1:1 aperture the footprint was drawn to avoid.  U8 pin 5 reached
# a bench with an open joint on 2026-09-04 -- hand-fitted, so not this mechanism,
# but it is the failure this omission would have produced at scale.
LAYERS = ["F.Cu", "In1.Cu", "In2.Cu", "B.Cu", "F.Mask", "B.Mask",
          "F.Paste", "B.Paste", "Edge.Cuts"]
# Set to None once the 33 legend violations are cleared and the silk layers are
# added to LAYERS above; main() refuses to build if the two disagree.
SILKSCREEN_WAIVER = "33 unresolved legend violations; see FAB-READINESS.md"
GERBERS = {f"o2-probe-{layer.replace('.', '_')}.gbr" for layer in LAYERS}
FILE_FUNCTIONS = {
    "o2-probe-F_Cu.gbr": "Copper,L1,Top",
    "o2-probe-In1_Cu.gbr": "Copper,L2,Inr",
    "o2-probe-In2_Cu.gbr": "Copper,L3,Inr",
    "o2-probe-B_Cu.gbr": "Copper,L4,Bot",
    "o2-probe-F_Mask.gbr": "Soldermask,Top",
    "o2-probe-B_Mask.gbr": "Soldermask,Bot",
    "o2-probe-F_Paste.gbr": "Paste,Top",
    "o2-probe-B_Paste.gbr": "Paste,Bot",
    "o2-probe-Edge_Cuts.gbr": "Profile,NP",
}


def run(*command: str | Path) -> str:
    result = subprocess.run([str(value) for value in command], cwd=HERE,
                            text=True, capture_output=True)
    if result.returncode:
        print(result.stdout, end="", file=sys.stderr)
        print(result.stderr, end="", file=sys.stderr)
        raise SystemExit(f"command failed ({result.returncode}): {' '.join(map(str, command))}")
    return result.stdout


def sha256(path: Path) -> str:
    digest = hashlib.sha256()
    with path.open("rb") as stream:
        for chunk in iter(lambda: stream.read(1024 * 1024), b""):
            digest.update(chunk)
    return digest.hexdigest()


def expected_outline_primitives() -> Counter:
    """Exact Gerber primitives for the square-tip 20 x 107 mm contour."""
    expected = Counter()

    def point(x: float, y: float):
        return round(100.0 + x, 3), round(-(50.0 + y), 3)

    def line(start, end):
        expected[("line", frozenset((point(*start), point(*end))))] += 1

    def arc(start, center, end):
        expected[("arc", frozenset((point(*start), point(*end))), point(*center))] += 1

    line((2.0, 0.0), (18.0, 0.0))
    arc((18.0, 0.0), (17.999, 2.001), (20.0, 2.0))
    line((20.0, 2.0), (20.0, 107.0))
    line((20.0, 107.0), (0.0, 107.0))
    line((0.0, 107.0), (0.0, 2.0))
    arc((0.0, 2.0), (2.001, 2.001), (2.0, 0.0))
    return expected


def expected_thermal_slot_primitives() -> Counter:
    """Exact Gerber primitives for all four heated-island thermal slots."""
    expected = Counter()

    def point(x: float, y: float):
        return round(x, 3), round(-y, 3)

    def line(start, end):
        expected[("line", frozenset((point(*start), point(*end))))] += 1

    def arc(start, center, end):
        expected[("arc", frozenset((point(*start), point(*end))), point(*center))] += 1

    for x in (104.125, 115.875):
        x0, x1 = x - 3.375, x + 3.375
        line((x0 + 0.75, 133.25), (x1 - 0.75, 133.25))
        arc((x1 - 0.75, 133.25), (x1 - 0.75, 134.0), (x1 - 0.75, 134.75))
        line((x1 - 0.75, 134.75), (x0 + 0.75, 134.75))
        arc((x0 + 0.75, 134.75), (x0 + 0.75, 134.0), (x0 + 0.75, 133.25))
    for x in (101.2, 118.8):
        x0, x1 = x - 0.4, x + 0.4
        y0, y1 = 137.0, 153.0
        line((x0, y0 + 0.4), (x0, y1 - 0.4))
        arc((x0, y1 - 0.4), (x, y1 - 0.4), (x1, y1 - 0.4))
        line((x1, y1 - 0.4), (x1, y0 + 0.4))
        arc((x1, y0 + 0.4), (x, y0 + 0.4), (x0, y0 + 0.4))
    return expected


def parse_gerber_primitives(text: str, x_fraction: int, y_fraction: int) -> Counter:
    """Parse the simple modal line/arc records emitted by KiCad Edge.Cuts."""
    primitives = Counter()
    mode = "line"
    current = None
    coordinate = re.compile(
        r"X(-?\d+)Y(-?\d+)(?:I(-?\d+)J(-?\d+))?D0([12])\*"
    )
    for raw_line in text.splitlines():
        line = raw_line.strip()
        if line == "G01*":
            mode = "line"
            continue
        if line in ("G02*", "G03*"):
            mode = "arc"
            continue
        match = coordinate.fullmatch(line)
        if not match:
            continue
        x, y, i, j, operation = match.groups()
        target = (int(x) / 10**x_fraction, int(y) / 10**y_fraction)
        if operation == "2":
            current = target
            continue
        if current is None:
            raise SystemExit("Edge.Cuts Gerber draws before setting a position")
        start = tuple(round(value, 3) for value in current)
        end = tuple(round(value, 3) for value in target)
        if mode == "line":
            primitives[("line", frozenset((start, end)))] += 1
        else:
            if i is None or j is None:
                raise SystemExit("Edge.Cuts Gerber arc lacks I/J centre offsets")
            center = (round(current[0] + int(i) / 10**x_fraction, 3),
                      round(current[1] + int(j) / 10**y_fraction, 3))
            primitives[("arc", frozenset((start, end)), center)] += 1
        current = target
    return primitives


def parse_gerber_regions(text: str, x_fraction: int,
                         y_fraction: int) -> list[list[tuple[float, float]]]:
    """Parse the linear G36/G37 regions emitted for the F.Cu guard fill."""
    regions: list[list[tuple[float, float]]] = []
    current: list[tuple[float, float]] | None = None
    coordinate = re.compile(r"X(-?\d+)Y(-?\d+)(?:D0[12])?\*")
    for raw_line in text.splitlines():
        line = raw_line.strip()
        if line == "G36*":
            if current is not None:
                raise SystemExit("nested Gerber regions are unsupported")
            current = []
            continue
        if line == "G37*":
            if not current:
                raise SystemExit("empty or unmatched Gerber region")
            regions.append(current)
            current = None
            continue
        if current is None:
            continue
        match = coordinate.fullmatch(line)
        if match:
            current.append((int(match.group(1)) / 10**x_fraction,
                            int(match.group(2)) / 10**y_fraction))
    if current is not None:
        raise SystemExit("unterminated Gerber region")
    return regions


def point_in_polygon(point: tuple[float, float],
                     polygon: list[tuple[float, float]]) -> bool:
    x, y = point
    inside = False
    j = len(polygon) - 1
    for i, (xi, yi) in enumerate(polygon):
        xj, yj = polygon[j]
        if ((yi > y) != (yj > y)) and x < (xj - xi) * (y - yi) / (yj - yi) + xi:
            inside = not inside
        j = i
    return inside


def check_silkscreen_policy(layers, waiver) -> bool:
    """Keep the waiver and the plotted layer set from drifting apart.

    While the waiver stands, neither silk layer may be plotted; when someone
    clears the legend violations and adds them, they must retire the waiver in
    the same edit.  Without this the manifest can say silkscreen was withheld
    while the Gerbers contain it, which is a provenance claim with nothing
    behind it -- the same class of defect as the missing paste layer.
    """
    exported = any(layer.endswith(".Silkscreen") for layer in layers)
    if exported and waiver:
        raise SystemExit(
            "silkscreen is in LAYERS but SILKSCREEN_WAIVER still stands: clear the "
            "legend violations and set SILKSCREEN_WAIVER = None, or drop the layers")
    if not exported and not waiver:
        raise SystemExit("silkscreen is withheld from LAYERS with no recorded waiver")
    return exported
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
