fl4p/o2-probe/hw/firmware/src/gpio_hal_host.c

/* A host stand-in for the GPIO and RCC registers OP_READ_GPIO loads.
 *
 * Every load is COUNTED, because the guards this exists to test are guards
 * against loads: an unclocked port must be answered without touching its
 * registers, and a pin that does not exist without touching anything at all. A
 * status code alone cannot prove either - a guard that read the registers and
 * then reported the refusal anyway would return the same status. The counters
 * can.
 *
 * The whole file is host-only. On the target gpio_hal.c is linked instead, and
 * this compiles to nothing.
 */
#ifdef O2P_HOST_TEST

#include "gpio_hal.h"
#include "regmap.h"

#include <stddef.h>
#include <string.h>

#if O2P_DEBUG_ENABLE

/* The same offsets gpio_hal.c pins CMSIS's GPIO_TypeDef to. */
_Static_assert(offsetof(o2p_host_gpio_regs_t, MODER)   == O2P_GPIO_OFS_MODER,   "fake MODER offset");
_Static_assert(offsetof(o2p_host_gpio_regs_t, OTYPER)  == O2P_GPIO_OFS_OTYPER,  "fake OTYPER offset");
_Static_assert(offsetof(o2p_host_gpio_regs_t, OSPEEDR) == O2P_GPIO_OFS_OSPEEDR, "fake OSPEEDR offset");
_Static_assert(offsetof(o2p_host_gpio_regs_t, PUPDR)   == O2P_GPIO_OFS_PUPDR,   "fake PUPDR offset");
_Static_assert(offsetof(o2p_host_gpio_regs_t, IDR)     == O2P_GPIO_OFS_IDR,     "fake IDR offset");
_Static_assert(offsetof(o2p_host_gpio_regs_t, ODR)     == O2P_GPIO_OFS_ODR,     "fake ODR offset");
_Static_assert(offsetof(o2p_host_gpio_regs_t, BSRR)    == O2P_GPIO_OFS_BSRR,    "fake BSRR offset");
_Static_assert(offsetof(o2p_host_gpio_regs_t, LCKR)    == O2P_GPIO_OFS_LCKR,    "fake LCKR offset");
_Static_assert(offsetof(o2p_host_gpio_regs_t, AFR)     == O2P_GPIO_OFS_AFRL,    "fake AFRL offset");
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
